Project-CoasterBot/coasterbot/README.md

# coasterbot

Diese Repository enthält Dateien des CoasterBot Projekts im Rahmen der Projektarbeit Master zum Start vom 15.07.2026.
