Project-CoasterBot/coasterbot/M5_Endbericht/se_algorithmik.tex

\subsubsection*{Ausgangslage und Leitlinien}

Zur Umsetzung der Algorithmik sind folgende Anforderungen aus dem Pflichtenheft als Leitlinien herangezogen:
\begin{itemize}[itemsep=2pt,topsep=3pt,parsep=0pt]
    \item \texttt{NAV-*} Anforderungen an eine zielgerichtete autonome Bewegung auf der Tischfläche.
    \item \texttt{SAF-*} Anforderungen an eine Sicherheitskomponente mit übergeordneter Priorität, u.\,a.\ Hindernis- und Tischkantenerkennung.
\end{itemize}

Als Hardware wurde bewusst ein einfacher Mikrocontroller (Raspberry Pi Pico~2) gewählt statt eines \gls{sbc} mit \gls{ros}: Der Mikrocontroller hat kein eigenes Betriebssystem und muss Navigation, Sensorverarbeitung und Kommunikation selbst in einer Firmware abbilden, ist günstiger und für das Projekt ausreichend. Die Navigation wurde zunächst in einer Physiksimulation (Webots) entworfen und gegen die Testfälle aus dem Testkonzept verifiziert, bevor sie auf die reale Hardware übertragen wurde. Entscheidend dafür ist die Hardwareabstraktionsschicht \texttt{RobotHAL} (siehe Abschnitt~\ref{lösungsweg-elektronik}): Navigations- und Sicherheitslogik kennen nur dieses Interface und laufen dadurch unverändert auf Simulation und Zielhardware.

\begin{figure}[H]
  \centering
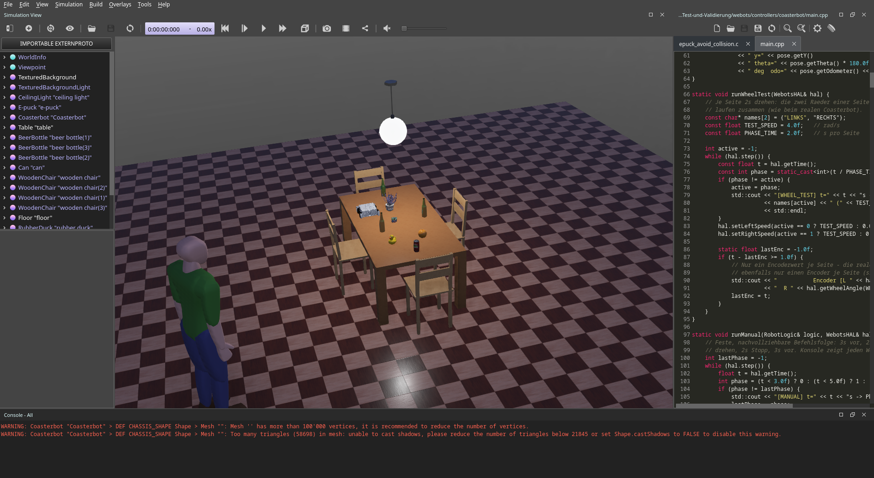
[picture p1: M5_Endbericht/webots.png]
  
  \caption{Webots-Simulationsumgebung des Coasterbot-Projekts.}
  \label{fig:endbericht-webots}
\end{figure}

\subsubsection*{Benchmarking und Auswahl der Verfahren}

Grundlage war eine systematische Literaturrecherche, deren Alternativen in einer Mindmap strukturiert und in der Alternativenbeschreibung anhand der Anforderungen bewertet wurden: begrenzte Tischfläche, Rechenleistung sowie die Anforderung, den Tisch nicht zu verlassen. Tabelle~\ref{tab:algorithmik-auswahl} fasst die Auswahl zusammen.

\begin{table}[H]
\centering
\footnotesize
\caption{Betrachtete Alternativen und gewählte Lösung der Navigationsalgorithmik.}
\label{tab:algorithmik-auswahl}
\begin{tabularx}{\textwidth}{@{}>{\raggedright\arraybackslash}p{2.6cm}>{\raggedright\arraybackslash}p{3.1cm}>{\raggedright\arraybackslash}p{2.3cm}X@{}}
\toprule
\textbf{Funktion} & \textbf{Alternativen} & \textbf{Gewählt} & \textbf{Begründung}\\
\midrule
Globale Pfadplanung & Dijkstra, Breitensuche & A* &
Heuristik lenkt die Suche zielgerichtet, bleibt auf dem Gitter dennoch optimal.\\
\midrule
Lokale Kollisionsvermeidung & Potentialfelder, adaptive/neuronale \acrshort{dwa} & Dynamic Window Approach &
Bezieht Bewegungsdynamik ein, vermeidet lokale Minima der Potentialfeldmethode.\\
\midrule
Dynamische Neuplanung & D*, LPA* & D* Lite &
Etabliertes, inkrementelles Verfahren für nachträglich entdeckte Hindernisse.\\
\midrule
Lokalisierung & \acrshort{imu}/\acrshort{ins} allein, voller \acrshort{ekf}/\acrshort{ukf}, \acrshort{slam} & Radodometrie + Gyro, Komplementärfilter &
Für die bekannte, flache Tischfläche ausreichend, \acrshort{slam} nicht erforderlich.\\
\midrule
Manipulations\-planung & Inverse Kinematik + \acrshort{rrt} & nicht umgesetzt &
Laut Abgrenzung nicht Teil der Simulationssoftware in M4.\\
\bottomrule
\end{tabularx}
\end{table}

\subsubsection*{Von der Recherche zur Simulation}

Die gewählten Verfahren wurden als eigenständige C++-Module umgesetzt, die ausschließlich über \texttt{RobotHAL} auf die Hardware zugreifen:
\begin{itemize}[itemsep=2pt,topsep=3pt,parsep=0pt]
    \item \texttt{OccupancyGrid} bildet die Tischfläche als Gitterkarte mit Distanzfeld ab. Bekannte Hindernisse werden direkt eingetragen, live erkannte erst nach mehreren konsistenten Messungen.
    \item \texttt{astarPlan} liefert darauf einen geglätteten Pfad, \texttt{DStarLite} plant ihn inkrementell um, sobald der Ultraschallsensor ein unkartiertes Hindernis entdeckt.
    \item \texttt{DwaPlanner} bestimmt daraus jeden Regelzyklus das Geschwindigkeitspaar beider Seiten.
    \item \texttt{PoseEstimator} liefert die Lokalisierung über einen Komplementärfilter aus Radodometrie und Gyroskop, der dem Schlupf des Skid-Steer-Antriebs entgegenwirken kann.
    \item \texttt{SafetyMonitor} und \texttt{FaultMonitor} bilden die Sicherheitsebene. Der \texttt{SafetyMonitor} reagiert mit übergeordneter Priorität auf Tischkanten, der \texttt{FaultMonitor} zusätzlich auf Sensor- und Aktorausfälle.
\end{itemize}
Dedizierte Betriebsarten erlaubten es, jede Stufe einzeln und reproduzierbar zu prüfen, bevor sie Teil des Gesamtsystems wurde.

\subsubsection*{Anpassungen während der Umsetzung}

Mehrere Entscheidungen wurden durch die Ergebnisse der Simulation angepasst:
\begin{itemize}[itemsep=2pt,topsep=3pt,parsep=0pt]
    \item \textbf{Lokalisierung:} Der Sensorfusions-Ansatz (\acrshort{ekf}/\acrshort{ukf}) wurde zugunsten eines einfacheren Komplementärfilters zurückgestellt. Dieser ist für die bekannte Tischfläche genau genug, liefert aber keine Unsicherheitsschätzung der Pose.
    \item \textbf{Pfadverfolgung:} Da die Bewegungssteuerung dem kürzesten A*-Pfad nahe der Ecken des Tisches nicht zuverlässig folgen konnte, wurden zwei unterschiedlich stark gewichtete Gitter sowie eine Pfadglättung eingesetzt, die Wegpunkte von Ecken weiter zur Mitte verschiebt.
    \item \textbf{FaultMonitor:} Kam nachträglich hinzu und wertete durch eine anfangs zu eng gewählte Schwelle normales Sensorrauschen fälschlich als Ausfall, was korrigiert wurde. Beim Übertragen auf die reale Hardware wurde er nicht mit übernommen: Wiederholte Kanten-, Stillstands- oder Ausrichtungsfehler stoppen die Navigation seither direkt über die Ablaufsteuerung.
    \item \textbf{Manipulationsplanung und Ablaufsteuerung:} Die Manipulationsplanung blieb offen, da die gebaute Mechanik mit ihrem Freiheitsgrad keine Pfadplanung benötigt. Die missionsweite Ablaufsteuerung wurde dagegen umgesetzt und deckt auch die Aufnahme und Ausgabe der Getränkeuntersetzer ab.
\end{itemize}

In der simulierten Verifikation bestanden alle bearbeiteten Testfälle: Zielfehler rund \SI{5,8}{\centi\meter}, Hindernisabstand mindestens \SI{0,22}{\meter}, zuverlässige Tischkantenerkennung, byte-identische Wiederholläufe sowie Sensor-/Aktorfehlererkennung innerhalb von \SI{0,02}{\second} bzw.\ \SI{0,34}{\second}. \texttt{PoseEstimator}, \texttt{SafetyMonitor}, \texttt{OccupancyGrid} und \texttt{DStarLite} wurden auf den realen Pico~2 übertragen und sind Teil der Firmware des Coasterbots. \texttt{DwaPlanner} und \texttt{astarPlan} kamen dort nicht zum Einsatz, stattdessen fährt die reale Firmware jeden Wegpunkt direkt an. Die Kernfunktionen arbeiten wie entworfen, die reale Navigationsgenauigkeit liegt aber unter der simulierten, da sich Sensortoleranzen über die Fahrzeit aufsummieren.
