Project-CoasterBot/coasterbot/M5_Endbericht/db_mechanik.tex

\subsubsection*{Ausgangslage und Leitlinien}
Zur Umsetzung der Mechanik sind folgende Anforderungen aus dem Pflichtenheft als Leitlinien herangezogen:
\begin{itemize}
    \item \texttt{HW-ACT-005..007}  Anforderungen an das Getränkeuntersetzerhandling.
    \item \texttt{HW-MEC-001..005}  Anforderungen an die mechanische Konstruktion.
\end{itemize}

\subsubsection*{Benchmarking und Auswahl der Verfahren}
Zur Auswahl der Lösungmethoden wurden unterschiedlichen Lösungsoptionen recherchiert und mit Hilfe einer \textit{Alternativenbewertung} Gegenüberstellungen. 
An dieser Stelle sind die gewählten Lösungswege mit ihren Begründungen verkürzt vorgestellt.

\begin{table}[H]
\centering
\footnotesize
\caption{Betrachtete Alternativen und gewählte Lösung der Mechanik.}
\label{tab:mechanik-auswahl}
\begin{tabularx}{\textwidth}{@{}>{\raggedright\arraybackslash}p{2.6cm}>{\raggedright\arraybackslash}p{3.1cm}>{\raggedright\arraybackslash}p{2.3cm}X@{}}
\toprule
\textbf{Funktion} & \textbf{Alternativen} & \textbf{Gewählt} & \textbf{Begründung}\\
\midrule
Chassis - Material & Holz, Metall & Kunststoff (Polylactid) &
Kunststoff ist günstig und Polyactid lässt sich besonders einfach auf einem 3D-Drucker verarbeiten.\\
\midrule
Chassis - Form & Abgerundet & Rechteckig &
Durch die rechteckige Form sind nachträgliche Anpassungen einfach anzubringen und die Konstruktion einfacher.\\
\midrule
Chassis - Modularität & Zwischenebenen & Austauschbare Seitenwände &
Druck kann in einzelnen Teilen erfolgen und die Wände sind austauschbar (Es muss kein gesamtes neues Gehäuse hergestellt werden).\\
\midrule
Untersetzer ablegen & Roboter mit Greifer/Sauger & Ausschieber &
Weniger komplex und benötigt weniger Antriebe.\\
\midrule
Untersetzer aufnehmen & Roboter mit Greifer/Sauger, Manuelle Einlage & Magnetische Aufnahme &
Weniger komplex und benötigt weniger Antriebe.\\
\bottomrule
\end{tabularx}
\end{table}

\subsubsection*{Anpassungen während der Umsetzung}
Während der Testphase haben sich einige Anpassungbedarfe an der Mechanik ergeben. So musste ein Encoder nachgerüstet werden.
Zur Befestigung der Lichtschranke des Encoders war ein neuer Motorhalter notwendig. Weiterhin hat sich herausgestellt,
dass die Mechanik zur Aufnahme und Ausgabe der Untersetzer nicht zuverlässig funktioniert. Durch die Entfernung der
Führungselemente und einer breiteren Auflagefläche des Ausschiebers konnte die Zuverlässigkeit verbessert werden.
