Project-CoasterBot/coasterbot/M5_Endbericht/db_projektziel.tex

Um in der Gastronomie Mitarbeiter zu entlasten und den Gästen ein besonderes Zahlerlebnis zu bieten, möchte die fiktive Firma
„Pay With Fun GmbH`` einen Coasterbot auf den Markt bringen. Neben einer Bezahlfunktion soll dieser Mobile Roboter, Tische reinigen,
Getränkeuntersetzer ausgeben und einsammeln können.
Zur Ausarbeitung eines Prototypens wird das fiktive Ingenieurbüro „B·E·Sondere Lösung UG`` engagiert, welches durch Gereon Such, Stefan Etringer und Dennis Borutta vertreten wird.
Die zu liefernden Grundfunktionen für den Prototypen umfassen folgendes:
\begin{itemize}
    \item Navigation auf einer Tischoberfläche
    \item Ausgabe, Lokalisierung und Aufnahme von Getränkeuntersetzer
\end{itemize}
Zur Umsetzung dieser Grundfunktionen können bestehende Konzepte zu mobilen Robotern verwendet werden.
Innerhalb des Projektes sind weitere Ausbaustufen auszuarbeiten und mit einem Testkonzept zu versehen.

Zu diesem Prototypen sind folgende Liefergegenstände bereitzustellen:
\begin{itemize}
    \item Eine Aufbauanleitung
    \item Eine Stückliste (\gls{bom})
    \item Die zur Fertigung notwendigen Modelle als stl-Dateien
    \item Ein Simulationsmodell zur Weiterentwicklung
    \item Der Sourcecode zum Prototypen
\end{itemize}
Mit dem Upload dieser Liefergegenstände über das \gls{dms} 
der \gls{wbh} gelten sie als ausgeliefert. 
Ein physischer Aufbau wird nicht separat geliefert werden. 

Nicht als Bestandteil des Projekts gelten:
\begin{itemize}
    \item Ein serienreifes Endprodukt
    \item Untersuchungen hinsichtlich \gls{emv}
    \item Intelligentes Schwarmverhalten
    \item Funktionen außerhalb der Grundfunktionen
    \item Konzeption einer Vermarktung des Produkts
\end{itemize}

Damit wird das Projekt als „PA2 - Machbarkeitsprojekt`` im Maßstab der \gls{wbh} geführt.
Der Projekstart erfolgte am 21.07.2026 und das Projektende ist am 07.11.2026 mit der Abgabe dieses Endbericht. 
Damit beträgt der angesetzte zeitliche Rahmen 3,5 Monate.
