Project-CoasterBot/coasterbot/M3_Produktentwicklung/Aufgabenliste/Aufgabenliste.md

# Einleitung

"Eine Aufgabenliste (auch: To-do-Liste, Liste offener Punkte, Action-Item-Liste) hält fest, welche Aufgaben im Projekt anstehen, bis wann sie erledigt sein müssen und wer sie verantwortet. Die Einträge ergeben sich in der Regel aus Besprechungsdokumenten, beispielsweise im Nachgang der Projekt-Jour-fixes; die Statusverfolgung geschieht meist ebenfalls im Rahmen der Besprechungen." (QUELLE) Damit verbindet die Aufgabenliste die Projektplanung mit der Ausführung. In diesem Dokument wird eine solche Aufgaben liste für die Teilaufgabe 'Konzeption ausarbeiten' ausgearbeitet.

# Aufgabenliste
Betrachtete Teilaufgabe: Konzeption ausarbeiten

Start: 15.08.2026

Ende: 04.09.2026

| Aufgabe | Verantwortliche Person | Termin | Status | Priorität | Abhängigkeiten | Arbeitspaket |
|---|---|---|---|---|---|---|
| Testfälle aus Lastenheft ableiten | Stefan Etringer | 20.08.2026 | Erledigt | Mittel | – | Testfälle definieren |
| Bewertungsmatrizen ausarbeiten | Stefan Etringer | 21.08.2026 | Erledigt | Hoch | Tesfälle abgeleitet | Testfälle definieren |
| Mögliche Sensorik aus Lastenheft ableiten und auswählen | Gereon Such | 18.08.2026 | Erledigt | Hoch | – | Sensorik/Aktorik auswählen |
| Mögliche Aktorik aus Lastenheft ableiten und auswählen | Gereon Such | 19.08.2026 | Erledigt | Hoch | – | Sensorik/Aktorik auswählen |
| Mögliche Energieversorgung und Steuerung ableiten und auswählen | Gereon Such | 20.08.2026 | Erledigt | Hoch | – | Sensorik/Aktorik auswählen |
| Elektronikbedarfe in Stückliste aufnehmen | Gereon Such | 21.08.2026 | Erledigt | Hoch | Elektronikbedarfe definiert | Sensorik/Aktorik auswählen |
| Mögliche Hardware aus Lastenheft ableiten und auswählen | Dennis Borutta | 18.08.2026 | Erledigt | Mittel | – | Sensorik/Aktorik auswählen |
| Modell des Prototypen ausarbeiten | Dennis Borutta | 20.08.2026 | Erledigt | Hoch | Hardwarelösung ausgewählt | Sensorik/Aktorik auswählen |
| Mechanikbedarfe in Stückliste aufnehmen | Dennis Borutta | 21.08.2026 | Erledigt | Hoch | Modell ausgearbeitet | Sensorik/Aktorik auswählen |
| Mögliche Softwarearchitektur aus Lastenheft ableiten | Stefan Etringer | 20.08.2026 | Erledigt | Mittel | Sensorik/Aktorik ist bekannt | Softwarearchitektur erarbeiten |
| Softwarearchitektur skizzieren | Stefan Etringer | 22.08.2026 | Erledigt | Hoch | Softwarearchitektur abgeleitet | Softwarearchitektur erarbeiten |
| Kosten zusammenstellen | Dennis Borutta | 22.08.2026 | Erledigt | Mittel | Stückliste abgeschlossen | Kostenkalkulation durchführen |
| Benefit schätzen | Gereon Such | 22.08.2026 | Erledigt | Mittel | Stückliste abgeschlossen | Kostenkalkulation durchführen |
| Wirtschaftlichkeit berechnen | Dennis Borutta | 23.08.2026 | Erledigt | Hoch | Stückliste abgeschlossen | Kostenkalkulation durchführen |
| Dokumente zusammenführen | Stefan Etringer | 26.08.2026 | Erledigt | Niedrig | – | Pflichtenheft erstellen |
| Pflichtenheft finalisieren | Stefan Etringer | 30.08.2026 | Erledigt | Hoch | Konzepte sind ausgearbeitet | Pflichtenheft erstellen |
| Dokumente ins DMS einpflegen | Stefan Etringer | 31.08.2026 | Erledigt | Hoch | Konzepte, BOM, Bewertungsmatrizen und Pflichtenheft sind ausgearbeitet | Pflichtenheft erstellen |
