Project-CoasterBot/coasterbot/M0/Unternehmensvorstellung/Unternehmensvorstellung.md

# Unternehmensvorstellung

Das Projektteam tritt als Ingenieurbüro unter dem Namen „B·E·Sondere Lösung UG“ auf. Unser Ingenieurbüro ist darauf spezialisiert, Prototypen und Kleinserien für Geräte und Maschinen im Konsumentenbereich zu entwickeln und umzusetzen.

Dabei begleiten wir unsere Kunden entlang des gesamten Entwicklungsprozesses – von der ersten Idee über Projektierung und Konzeption, Konstruktion und Prototypenbau bis hin zu Fertigung, Aufbau, Erprobung und Optimierung. So entsteht aus einer ersten Produktidee eine technisch ausgereifte und marktreife Lösung.

Sollte sich ein Produkt über die Kleinserie hinaus erfolgreich am Markt etablieren, unterstützen wir unsere Kunden auch bei der Überführung in größere Fertigungsstrukturen. Dabei beraten wir unter anderem beim Aufbau geeigneter Fertigungsstrecken und sorgen dafür, dass das bereits während der Entwicklung aufgebaute Know-how auch in der Serienproduktion genutzt werden kann.

B·E·Sondere Lösung steht somit für eine ganzheitliche Entwicklungsbegleitung – von der ersten Idee bis zur fertigungsgerechten Umsetzung. Wir sind an Ihrer Seite, um aus Ihrer Idee nicht nur eine gute, sondern eine B·E·Sondere Lösung zu machen.

# Auftrag Coasterbot

Der Auftrag zur Entwicklung eines Prototyps für einen Coasterbot kommt vom Kunden „Pay With Fun GmbH“. Bei dem Kunden handelt es sich um einen Zahlungsdienstleister, der mit kreativen Bezahlmethoden Marktanteile im Bereich der Zahlungsdienstleistungen gewinnen konnte. Um seinen Marktanteil weiter auszubauen, möchte er nun ein Gadget für Restaurants, Events und Bars auf den Markt bringen, welches neben einem besonderen Erlebnis bei der Bezahlung auch einen Mehrwert für Gastronomen bietet.

Hierdurch ist die Idee des Coasterbots entstanden. Der Coasterbot soll folgende Mehrwerte bieten:

- Getränkeuntersetzer ausgeben und aufnehmen
- Eine Tischoberfläche reinigen
- Einen Bezahlvorgang spielerisch gestalten
- Einen Bezahlvorgang beschleunigen

Die Aufgabe des Auftragnehmers „B·E·Sondere Lösung UG“ besteht bei diesem Auftrag darin, eine technische Lösung für diese Idee zu entwickeln. Definierte Ausbaustufen und Anforderungen sind in einem Lasten- und Pflichtenheft festgelegt. Vom Kunden wird im Rahmen dieses Projekts ein erster Prototyp mit minimalem Funktionsumfang gefordert.

## Finanzierung

Die „B·E·Sondere Lösung UG“ finanziert ihre Projekte über Kundenaufträge. Auf Grundlage der Kundenanforderungen wird zunächst eine Kosten- und Ressourcenplanung durchgeführt. Diese bildet die Grundlage für die Angebotserstellung und den anschließenden Vertragsabschluss.

Die Vergütung erfolgt projektbezogen und wird in mehreren Abschlagszahlungen entsprechend dem Projektfortschritt abgerechnet. Bei Projektstart wird eine erste Zahlung in Höhe von 25 % des vereinbarten Projektpreises fällig. Nach der erfolgreichen Erstellung und Abnahme des Umsetzungskonzepts wird eine weitere Zahlung in Höhe von 25 % fällig. Eine dritte Zahlung in Höhe von 25 % erfolgt nach Auslieferung des vereinbarten Projektergebnisses. Die verbleibenden 25 % werden nach der erfolgreichen Abnahme des Projektergebnisses durch den Kunden fällig.

Durch die Abrechnung nach definierten Projektmeilensteinen wird sichergestellt, dass die Finanzierung des Projekts mit dem erbrachten Leistungsstand fortschreitet und die „B·E·Sondere Lösung UG“ ihre bereits erbrachten Leistungen und entstandenen Aufwendungen laufend abrechnen kann.
