Project-CoasterBot/coasterbot/M6_Projekträsentation/Projektpräsentation_Coasterbot.odp

## Projektpräsentation

Coasterbot


KI generiertes Bild

## Slide 2

01 | Hinführung
02 | Projektziel
03 | Team & Rollen
04 | Zeit, Kosten und Ressourcen
05 | Arbeitsteilung
06 | Lösungsfindung: Mechanik
07 | Lösungsfindung: Algorithmik
08 | Lösungsfindung: Elektronik
09 | Projektergebnisse
10 | Ausblick

## Hinführung

## Kundenvision

Projektpräsentation - Hinführung

Fiktiver Zahlungsdienstleister

der Gastronomie

KI generiertes Bild

Quellen: [Deu26], [26b]

Autor: Dennis Borutta

## Kundenvision

Projektpräsentation - Hinführung

Belastung beim Personal

Fiktiver Zahlungsdienstleister

der Gastronomie

KI generiertes Bild

Sieht bei Kunden

Quellen: [Deu26], [26b]

Autor: Dennis Borutta

## Kundenvision

Projektpräsentation - Hinführung

Belastung beim Personal

Brauchen Attraktivitätsmerkmale

Fiktiver Zahlungsdienstleister

der Gastronomie

KI generiertes Bild

Sieht bei Kunden

Quellen: [Deu26], [26b]

Autor: Dennis Borutta

## Kundenvision

Projektpräsentation - Hinführung

Belastung beim Personal

Brauchen Attraktivitätsmerkmale

Online Präsenz beeinflusst Umsatz

Fiktiver Zahlungsdienstleister

der Gastronomie

KI generiertes Bild

Sieht bei Kunden

Quellen: [Deu26], [26b]

Autor: Dennis Borutta

## Kundenvision

Projektpräsentation - Hinführung

Belastung beim Personal

Brauchen Attraktivitätsmerkmale

Online Präsenz beeinflusst Umsatz

Fiktiver Zahlungsdienstleister

der Gastronomie

KI generiertes Bild

Sieht bei Kunden

Ein Produkt, dass

Einen Service bietet

Quellen: [Deu26], [26b]

Vision

Aufsehen erregt

Autor: Dennis Borutta

## Kundenvision

Projektpräsentation - Hinführung

Belastung beim Personal

Brauchen Attraktivitätsmerkmale

Online Präsenz beeinflusst Umsatz

Fiktiver Zahlungsdienstleister

der Gastronomie

KI generiertes Bild

Sieht bei Kunden

Ein Produkt, dass

Einen Service bietet

Quellen: [Deu26], [26b]

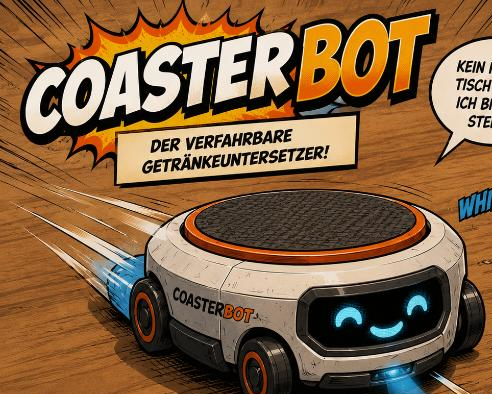
[picture p3: figure]

KI generiertes Bild

Autor: Dennis Borutta

Vision

- Navigiert auf einem Tisch
- Spendet Untersetzer
- Sammelt Untersetzer
- Reinigt den Tisch
- Bietet Zahloption/Enterntainment

Aufsehen erregt

## Projektziel

## Projektziel

Projektpräsentation - Projektziel

  Entwicklung eines Prototyps

als Maturity Level 1

- Automatisiertes Verteilen und Einsammeln von Getränkeuntersetzern
- Evaluierung: Systemarchitektur, Hardware- & Software-Komponenten, Tests
- Mechanik und Elektronik so ausgearbeitet, dass eine Fertigung möglich ist

Autor: Stefan Etringer

## Team & Rollen

## Teamvorstellung

Projektpräsentation - Team & Rollen

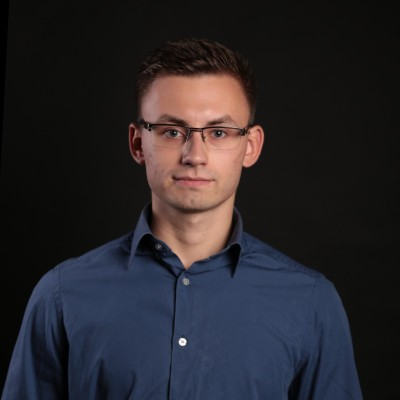
[picture p4: figure]

- Dennis Borutta
- -Projektleiter-
- Mechanik

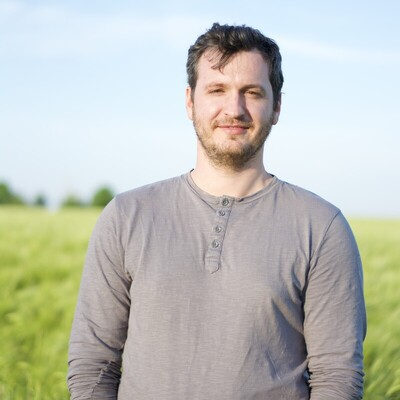
[picture p5: figure]

- Stefan Etringer
- -Projektadministrator-
- Algorithmik

Autor: Gereon Such

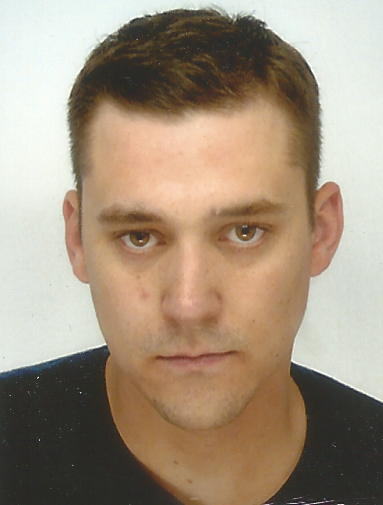
[picture p6: figure]

- Gereon Such
- Elektronik

## Zeit, Kosten und Ressourcen

## Zeitplan

Projektpräsentation - Zeit, Kosten und Ressourcen

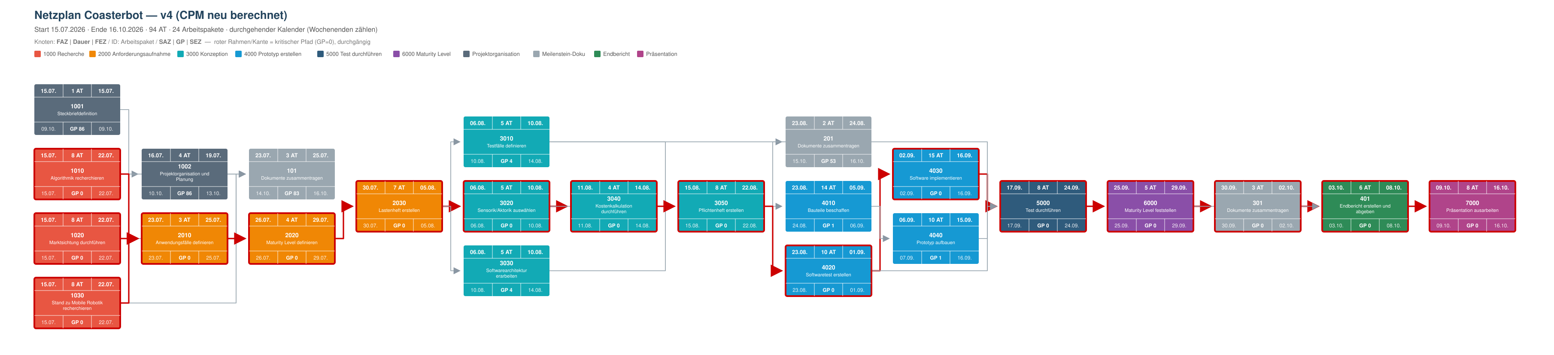
[picture p7: figure]

Quellen: M0 Dokument Coasterbot

Autor: Gereon Such

Notes: Gesamtprojektzeit 3 Monate Viele Schritte nicht parallelisierbar Projektzeit nach DIN 69900

## Zeitplan

- Anforderungsaufnahme
- Recherche
- Konzeption
- Prototyp
- Test
- Projektabschluss

Projektpräsentation - Zeit, Kosten und Ressourcen

- 8
- 14
- 17
- 25
- 8
- 22
- ∑ 94 Arbeitstage

Autor: Gereon Such

Quellen: M0 Dokument Coasterbot

Notes: Anforderungsaufnahme bis Pflichtenheft Konzeption bis Lastenheft In Summe 94 Arbeitstage auf dem kritischen Pfad

## Zeitplan

Projektpräsentation - Zeit, Kosten und Ressourcen

- ∑ 94 Arbeitstage

Autor: Gereon Such

Quellen: M5 Endbericht Coasterbot

Notes: Meisten Grenzen gehalten Prototyp Erstellung deutlich verzögert, aber kompensiert.

## Kostenplan

Projektpräsentation - Zeit, Kosten und Ressourcen

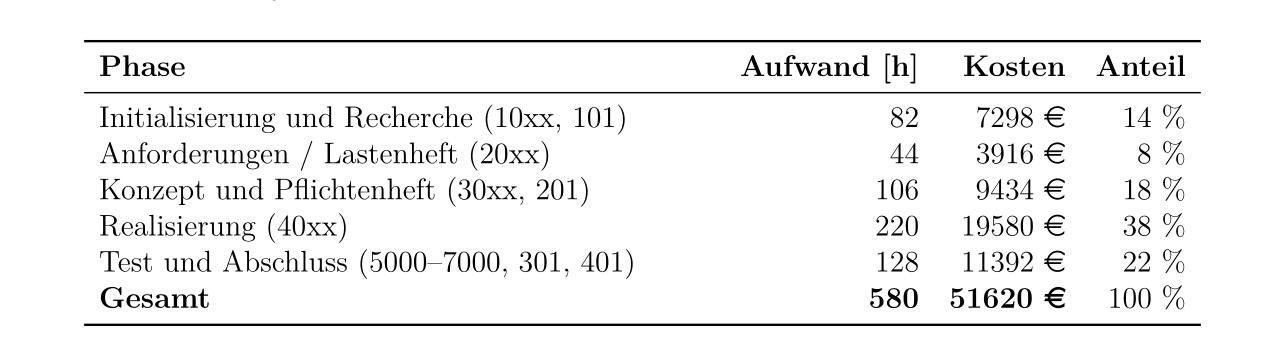
[picture p8: figure]
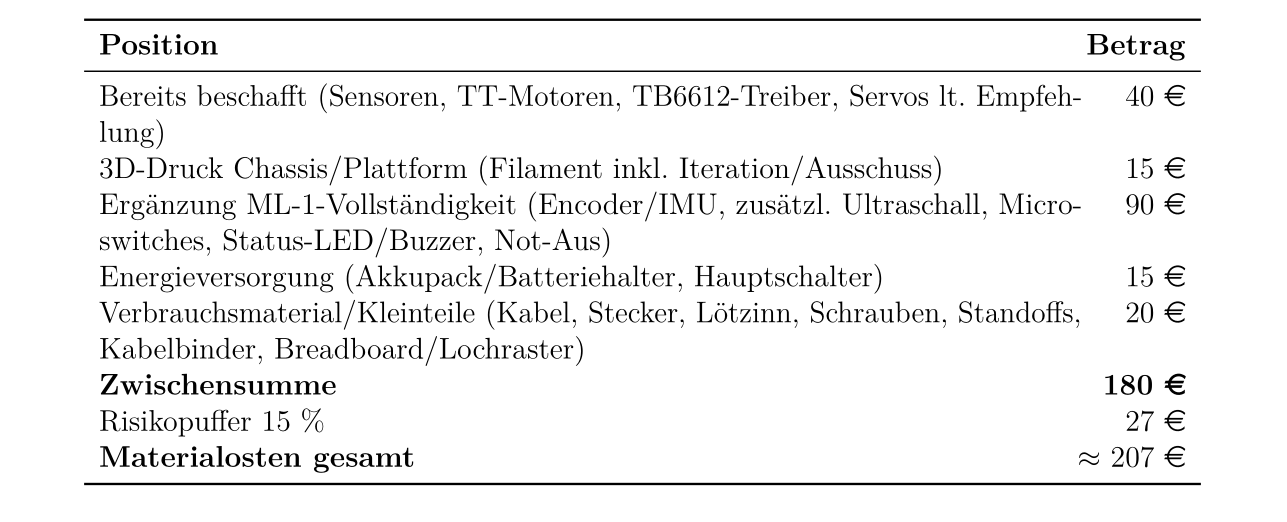
[picture p9: figure]

- ∑ 52827 €

Quellen: M0 Kostenplan Coasterbot

Autor: Gereon Such

Notes: In Phase M0 detailliert erstellt Mit Stundensatz von 89€ + 10.6% Wagnis = 100€ pro Stunde kalkuliert Es ergeben sich Gesamtkosten von 52827€ Software wird OpenSource verwendet, Werkzeuge werden als gegeben gesetzt und Verschleiss o.ä. nicht berechnet

## Kostenplan

Projektpräsentation - Zeit, Kosten und Ressourcen

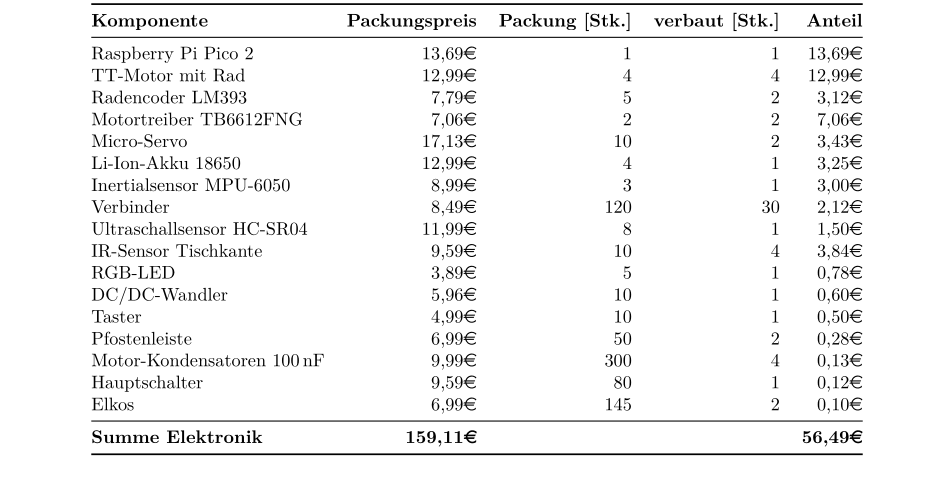
[picture p10: figure]

- Zuzüglich Filament ~15 € → 71.49 € pro Prototyp
- Statt angenommener 207 €

Quellen: M5 Endbericht Coasterbot

Autor: Gereon Such

Notes: Prototyp deutlich günstiger, vor allem durch größere Mengen und günstige Komponentenauswahl.

## Arbeitsteilung

## Gewerke

Projektpräsentation - Arbeitsteilung

Mechanik Chassis als 3D Druck Ausschiebe-mechanismus der Untersetzer Nachrüstung eines Encoder-Halters | Elektronik und Hardwareabstraktion Komponentenauswahl Aktorik und Sensorik Lochrasterplatine Hardwareabstraktions-schicht Implementierung Nachrüsten des Radencoders | Navigationsalgorith-mik und Simulation Prototyping des Nav-Stacks Lokalisierung über Komplementärfilter Verifikation in Simulation

Autor: Stefan Etringer

## Lösungsfindung: Mechanik

## Explorative Methode

Projektpräsentation - Lösungsfindung: Mechanik

Aufsetzen einer Mind-Map mit gestellten Anforderungen

Untersetzer

aufnehmen

Modularität

durch

Mechanik

Chassis

Form

Untersetzer

ablegen

Material

Autor: Dennis Borutta

## Explorative Methode

Projektpräsentation - Lösungsfindung: Mechanik

Listen von Lösungsoptionen

Roboter mit Sauger

Austauschbare

Seitenwände zur

Komponentenbefestigung

Roboter mit Greifer

Manuelle Einlage

Untersetzer

aufnehmen

Modularität

durch

Zwischenebenen zur

Komponentenbefestigung

Zusätzliche

Magnetischer

Heber mit

magnetischen

Untersetzer

Mechanik

Chassis

Form

Quaderförmig

Zylindrisch

Untersetzer

ausschieben

Harz

Roboter mit Sauger

Untersetzer

ablegen

Material

Metall

Roboter mit Greifer

Kunststoff

Holz

Quellen: [LP17]

Autor: Dennis Borutta

## Explorative Methode

Projektpräsentation - Lösungsfindung: Mechanik

Auswahl der am besten geeigneten

Roboter mit Sauger

Austauschbare

Seitenwände zur

Komponentenbefestigung

Roboter mit Greifer

Manuelle Einlage

Untersetzer

aufnehmen

Modularität

durch

Zwischenebenen zur

Komponentenbefestigung

Zusätzliche

Magnetischer

Heber mit

magnetischen

Untersetzer

Mechanik

Chassis

Form

Quaderförmig

Zylindrisch

Untersetzer

ausschieben

Harz

Roboter mit Sauger

Untersetzer

ablegen

Material

Metall

Roboter mit Greifer

Kunststoff

Holz

Quellen: [LP17]

Autor: Dennis Borutta

## Coaster Mechanismus

Projektpräsentation - Lösungsfindung: Mechanik

Autor: Dennis Borutta

Quellen: [LP17]

## Coaster Mechanismus

Projektpräsentation - Lösungsfindung: Mechanik

Autor: Dennis Borutta

Schubkurbeltrieb

Stempel mit eingelassenen

Magneten

Quellen: [LP17]

## Coaster Mechanismus

Projektpräsentation - Lösungsfindung: Mechanik

Autor: Dennis Borutta

Schubkurbeltrieb

Führungsstücke

Stempel mit eingelassenen

Magneten

Quellen: [LP17]

## Coaster Mechanismus

Projektpräsentation - Lösungsfindung: Mechanik

Autor: Dennis Borutta

Schubkurbeltrieb

Führungsstücke

Stempel mit eingelassenen

Magneten

Untersetzer mit eingelassenen Magneten

Quellen: [LP17]

## Coaster Mechanismus

Projektpräsentation - Lösungsfindung: Mechanik

Autor: Dennis Borutta

Schubkurbeltrieb

Führungsstücke

Stempel mit eingelassenen

Magneten

Untersetzer mit eingelassenen Magneten

Auflage mit Ausschieber

Quellen: [LP17]

## Prototyp

Projektpräsentation - Lösungsfindung: Mechanik

Autor: Dennis Borutta

Maße:

233mm x 213mm x 94mm

## Prototyp

Projektpräsentation - Lösungsfindung: Mechanik

Autor: Dennis Borutta

Deckel

Austauschbare Wände

Austauschbare Wände

Maße:

233mm x 213mm x 94mm

Grundplatte

## Prototyp

Projektpräsentation - Lösungsfindung: Mechanik

Autor: Dennis Borutta

Deckel

Austauschbare Wände

Coaster Mechanismus

Maße:

233mm x 213mm x 94mm

Grundplatte

## Prototyp

Projektpräsentation - Lösungsfindung: Mechanik

Autor: Dennis Borutta

Deckel

Austauschbare Wände

Motorhalter

Halter zur Kantenerkennung

Halter für Hinderniserkennung

Grundplatte

Coaster Mechanismus

Maße:

233mm x 213mm x 94mm

## Lösungsfindung: Algorithmik

## Gewerke -- Algorithmik

Projektpräsentation - Lösungsfindung: Algorithmik

Lokalisierung

Manipulationsplanung

Globale Pfadplanung

Lokale Kollisionsvermeidung

Dynamische Neuplanung

Autor: Stefan Etringer

## Gewerke -- Algorithmik

Projektpräsentation - Lösungsfindung: Algorithmik

Autor: Stefan Etringer

## Gewerke -- Algorithmik

Projektpräsentation - Lösungsfindung: Algorithmik

Globale Pfadplanung | A* (A-Star) | Heuristik lenkt die Suche zielgerichtet, optimales Gitter über Wegpunkte
Lokale Kollisionsvermeidung | Dynamic Window Approach | Bewegungsdynamik einbezogen, vermeidet lokale Minima der Potentialfeldmethode
Dynamische Neuplanung | D* Lite (D-Star Lite) | Inkrementelles Verfahren für nachträglich entdeckte Hindernisse
Lokalisierung | Radodometrie + Gyroskop als Komplementrärfilter | Ausreichend für die Tischfläche, Simultaneous Localization and Mapping (SLAM) nicht notwendig
Manipulationsplanung | Inverse Kinematik (IK), Rapidly-exploring Random Tree* (RRT-Star) | Bewegungsplanung: Gelenkstellung, Greifposition, präzise Ablage

Autor: Stefan Etringer

## Lösungsfindung: Elektronik

## Elektronik

Projektpräsentation - Lösungsfindung: Elektronik

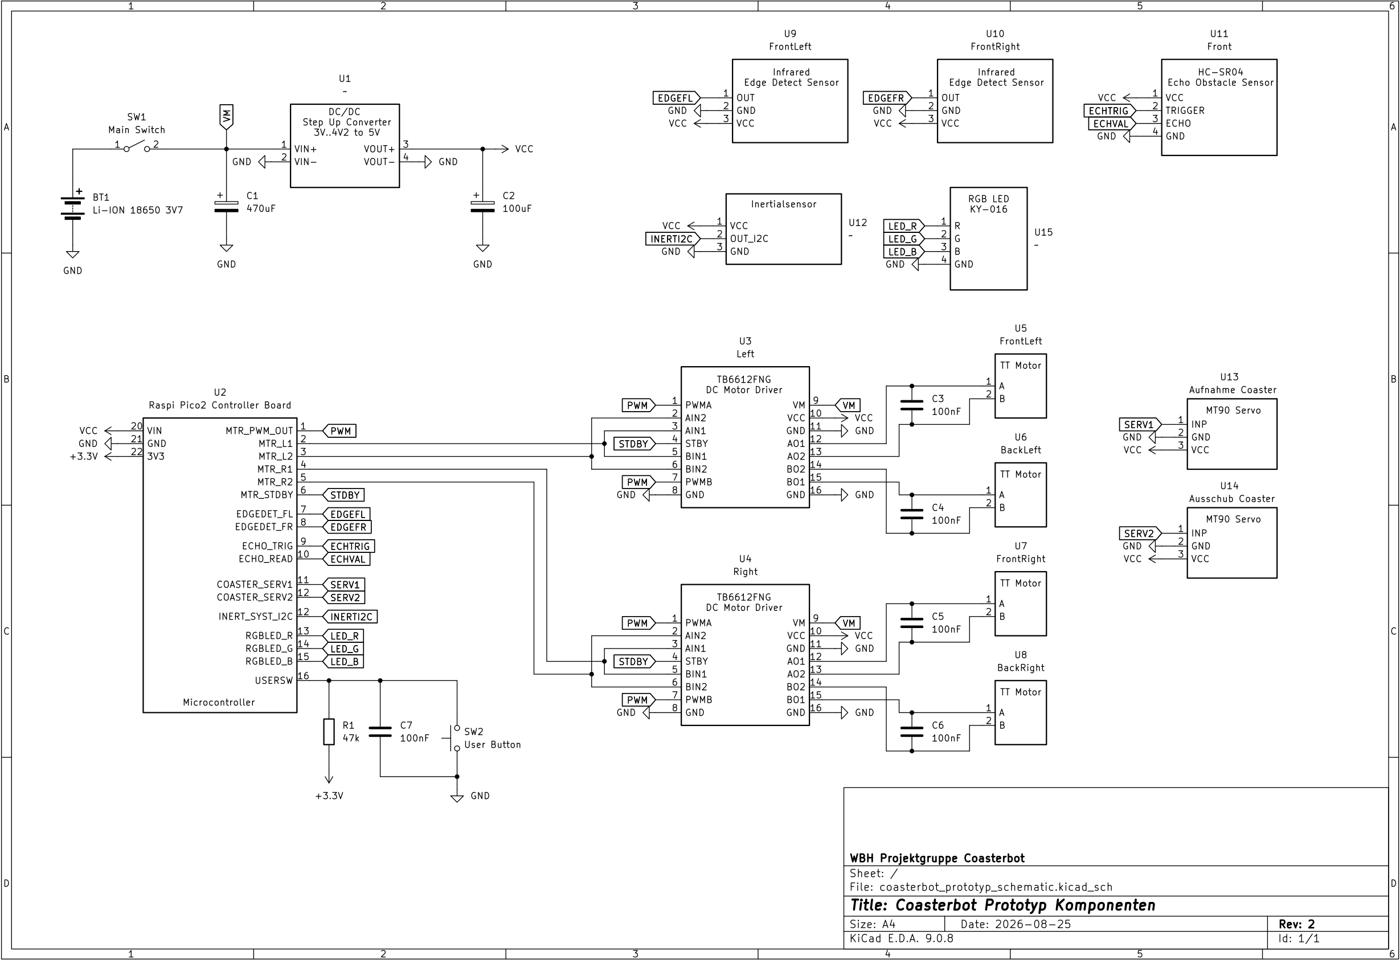
[picture p11: figure]

Autor: Gereon Such

Quellen: M4 Aufbauanleitung

Notes: Schematic für ausgewählte Komponenten mittels KiCAD erstellt.

## Elektronik

Projektpräsentation - Lösungsfindung: Elektronik

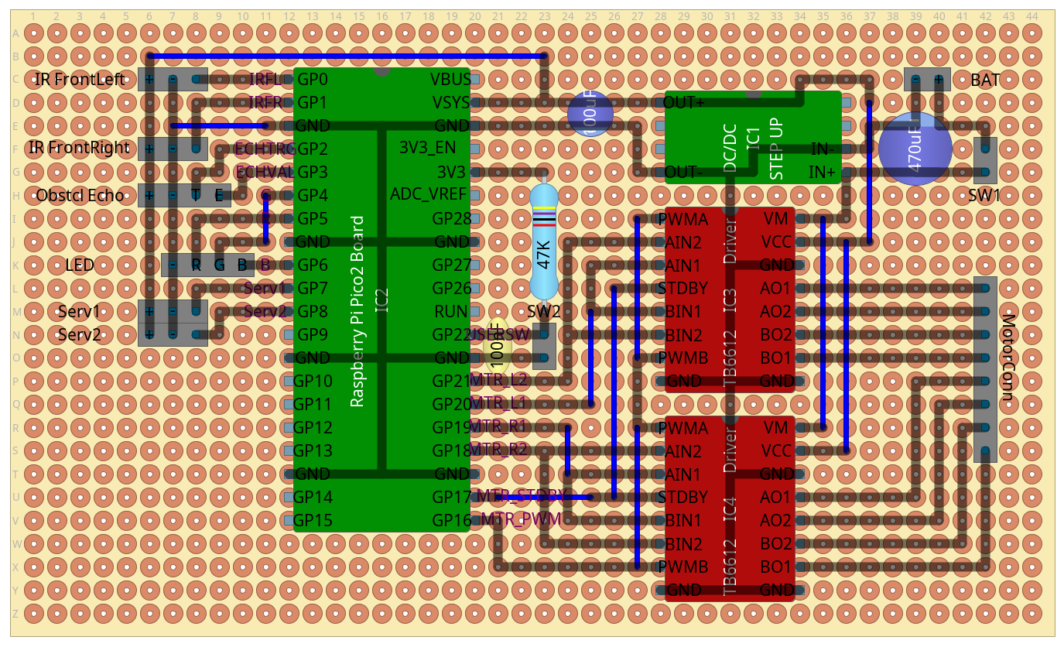
[picture p12: figure]

Quellen: M4 Aufbauanleitung

Autor: Gereon Such

Notes: Umgesetzt auf ein Breadboard

## Elektronik

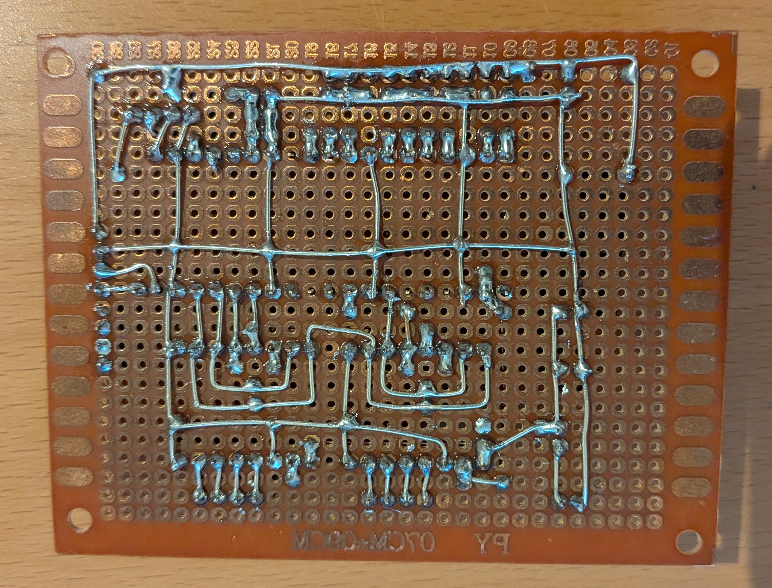
[picture p13: figure]

Projektpräsentation - Lösungsfindung: Elektronik

Quellen: M4 Aufbauanleitung

Autor: Gereon Such

Notes: Layout äquivalent auf Lochrasterplatine übernommen Unterseite hier Spiegelverkehrt dargestellt

## Elektronik

- Raspi Pico2 Microcontroller

Projektpräsentation - Lösungsfindung: Elektronik

Quellen: M4 Aufbauanleitung

Autor: Gereon Such

## Elektronik

- DC/DC Spannungswandler
- 3.7V → 5V

Projektpräsentation - Lösungsfindung: Elektronik

Quellen: M4 Aufbauanleitung

Autor: Gereon Such

## Elektronik

- RGB LED Modul

Projektpräsentation - Lösungsfindung: Elektronik

Quellen: M4 Aufbauanleitung

Autor: Gereon Such

## Elektronik

- MPU-6050
- Gyroskop

Projektpräsentation - Lösungsfindung: Elektronik

Quellen: M4 Aufbauanleitung

Autor: Gereon Such

## Elektronik

- Motorsteuerung
- 2x TB6612FNG

Projektpräsentation - Lösungsfindung: Elektronik

Quellen: M4 Aufbauanleitung

Autor: Gereon Such

## Elektronik

Projektpräsentation - Lösungsfindung: Elektronik

Autor: Gereon Such

Notes: umgesetzt auf der Platform

## Elektronik

Projektpräsentation - Lösungsfindung: Elektronik

Autor: Gereon Such

- 4x Antrieb
- TT-Motor(innen)

## Elektronik

Projektpräsentation - Lösungsfindung: Elektronik

Autor: Gereon Such

- 4x IR Sensor
- Tischkantenerkennung

## Elektronik

Projektpräsentation - Lösungsfindung: Elektronik

Autor: Gereon Such

- 1x Ultraschall
- Kollisionsvermeidung

## Elektronik

Projektpräsentation - Lösungsfindung: Elektronik

Autor: Gereon Such

- 1x Akku
- 3.7V Li-ION

Notes: Li-Ion kann die hohen Motorströme liefern

## Elektronik

Projektpräsentation - Lösungsfindung: Elektronik

Autor: Gereon Such

- 1x Ein/Aus
- Schalter

## Elektronik

Projektpräsentation - Lösungsfindung: Elektronik

Autor: Gereon Such

- 1x Funktionstaster

## Elektronik – Nachrüstung

Projektpräsentation - Lösungsfindung: Elektronik

Autor: Gereon Such

Notes: Tests zeigten, dass Aufintegrieren von Gyroskopwerten zu fehleranfällig ist. Also Odometrie nachrüsten → Modifikation des Motorhalters

## Elektronik – Nachrüstung

Projektpräsentation - Lösungsfindung: Elektronik

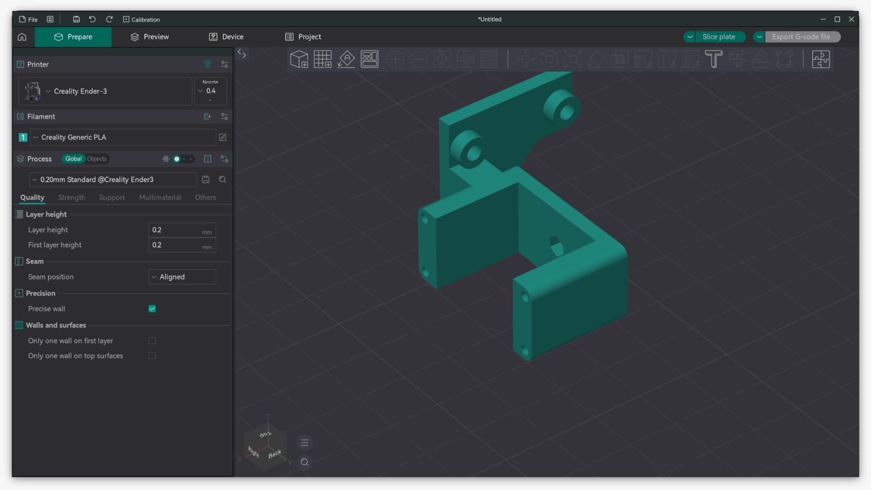
[picture p14: figure]

Autor: Gereon Such

Notes: CAD Design des Halters für Gabellichtschranke, hier Slicer

## Elektronik – Nachrüstung

Projektpräsentation - Lösungsfindung: Elektronik

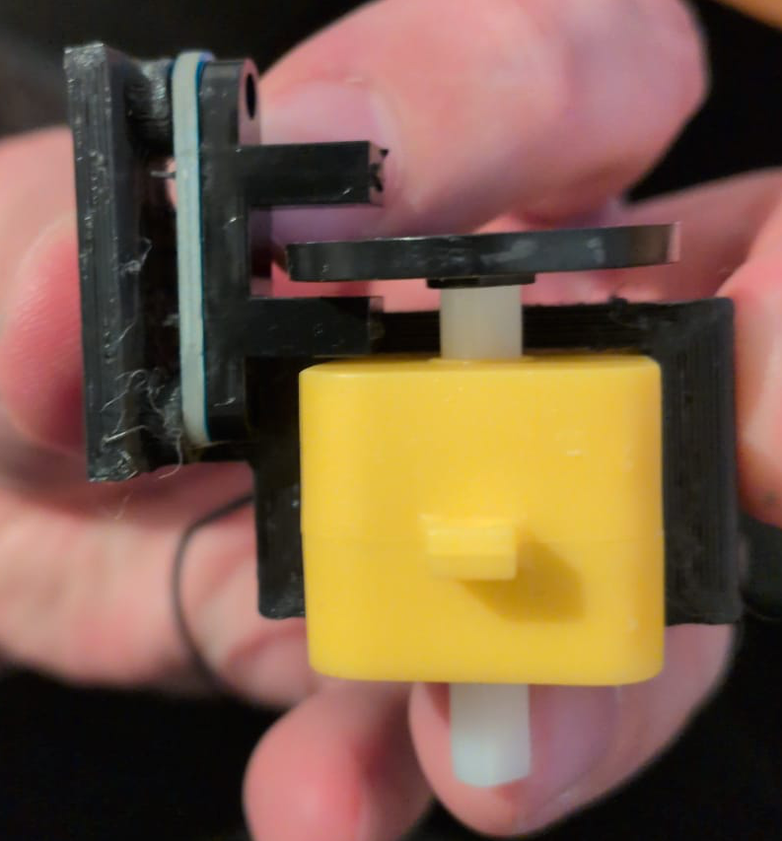
[picture p15: figure]

Autor: Gereon Such

Notes: 3D Druck

## Elektronik – Nachrüstung

Projektpräsentation - Lösungsfindung: Elektronik

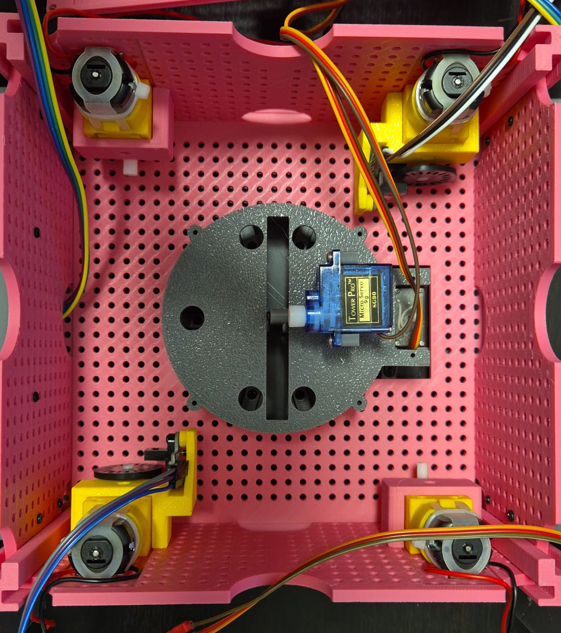
[picture p16: figure]

Autor: Gereon Such

Notes: Montage an zwei Motoren, je auf einer Seite

## Projektergebnisse

## Ergebnis – Simulation in Webots

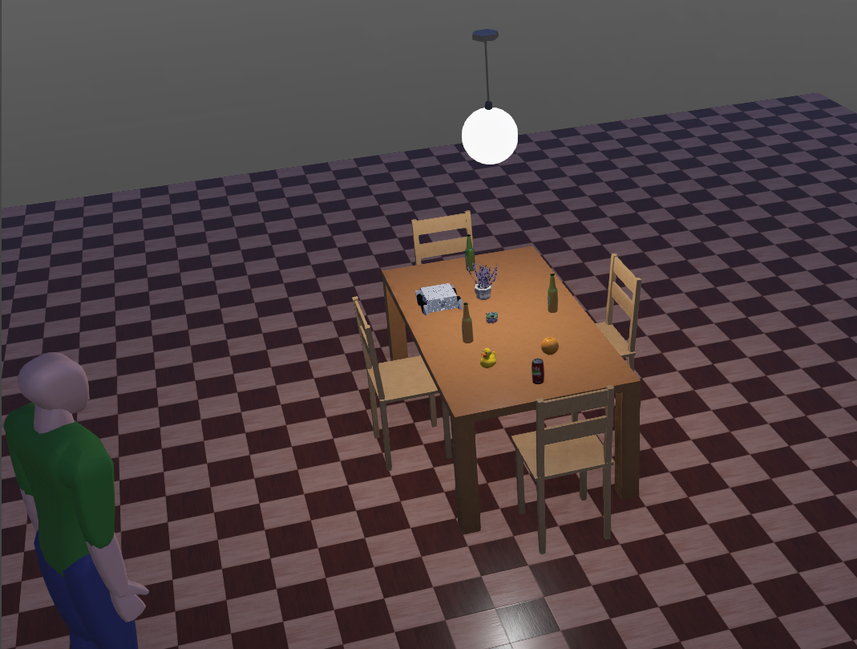
[picture p17: figure]

Autor: Stefan Etringer

## Ergebnis -- Simulation

Projektpräsentation - Projektergebnisse

  Webots: open-source robot simulator
  Entwicklungsumgebung zur Modellierung, Programmierung und Simulation von Robotern
- Vorgefertigte Modelle für Sensorik & Aktorik
- Physiksimulation
- Programmierbar (C/C++/Python)

Quellen: [Cyber01]

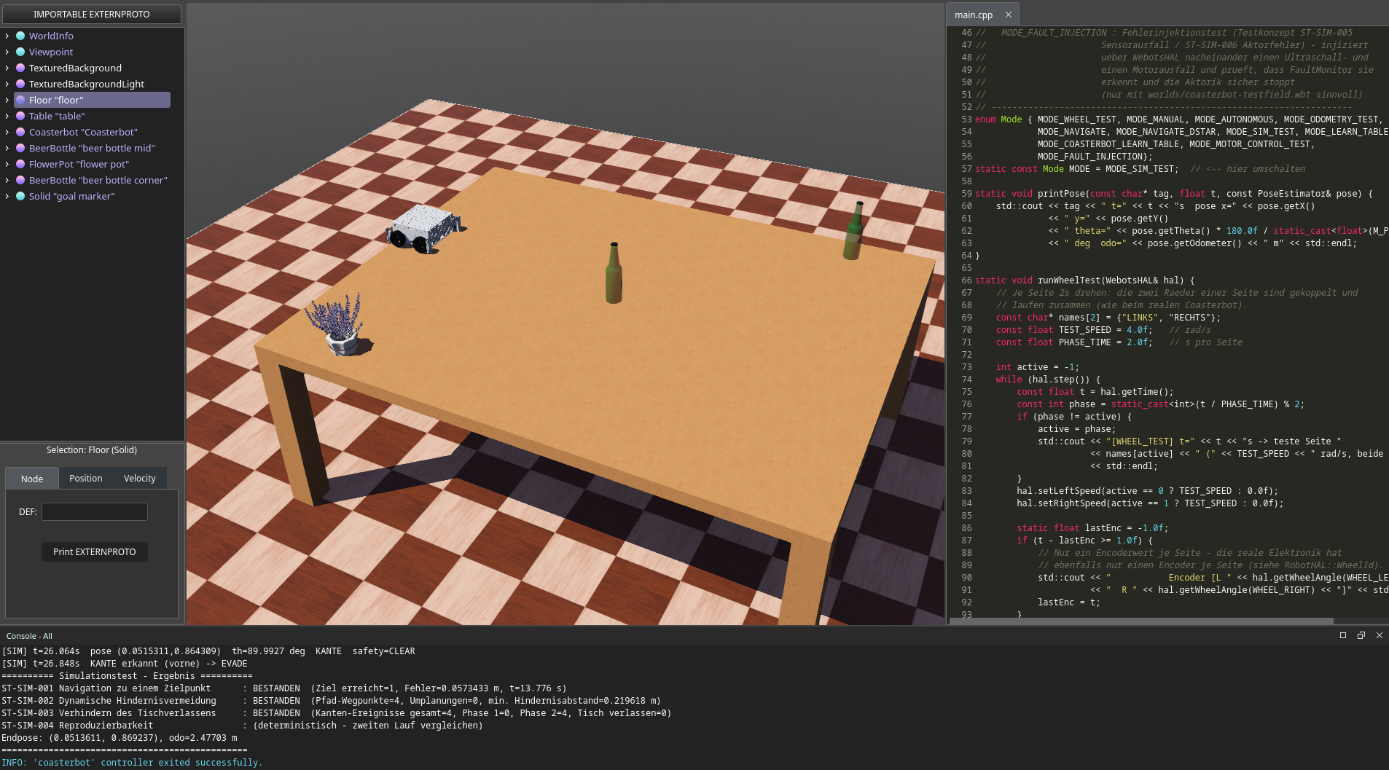
[picture p18: figure]
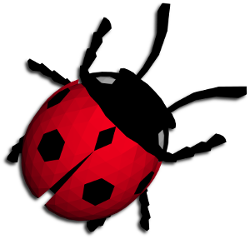
[picture p19: figure]

Autor: Stefan Etringer

## Ergebnis -- Simulation

Projektpräsentation - Projektergebnisse

  Testlauf der Algorithmen zur Navigation und des FAULTMONITORS erfolgreich abgeschlossen

✅ ST-SIM-001: Navigation zum Zielpunkt
✅ ST-SIM-002: Dynamische Hindernisvermeidung
✅ ST-SIM-003: Verhindern des Verlassens der Tischfläche
✅ ST-SIM-004: Wiederholbarkeit identischer Bewegungsabläufe
✅ ST-SIM-005: Reaktion auf fehlerhafte Sensordaten
✅ ST-SIM-006: Verhalten bei fehlerhafter Motorsteuerung

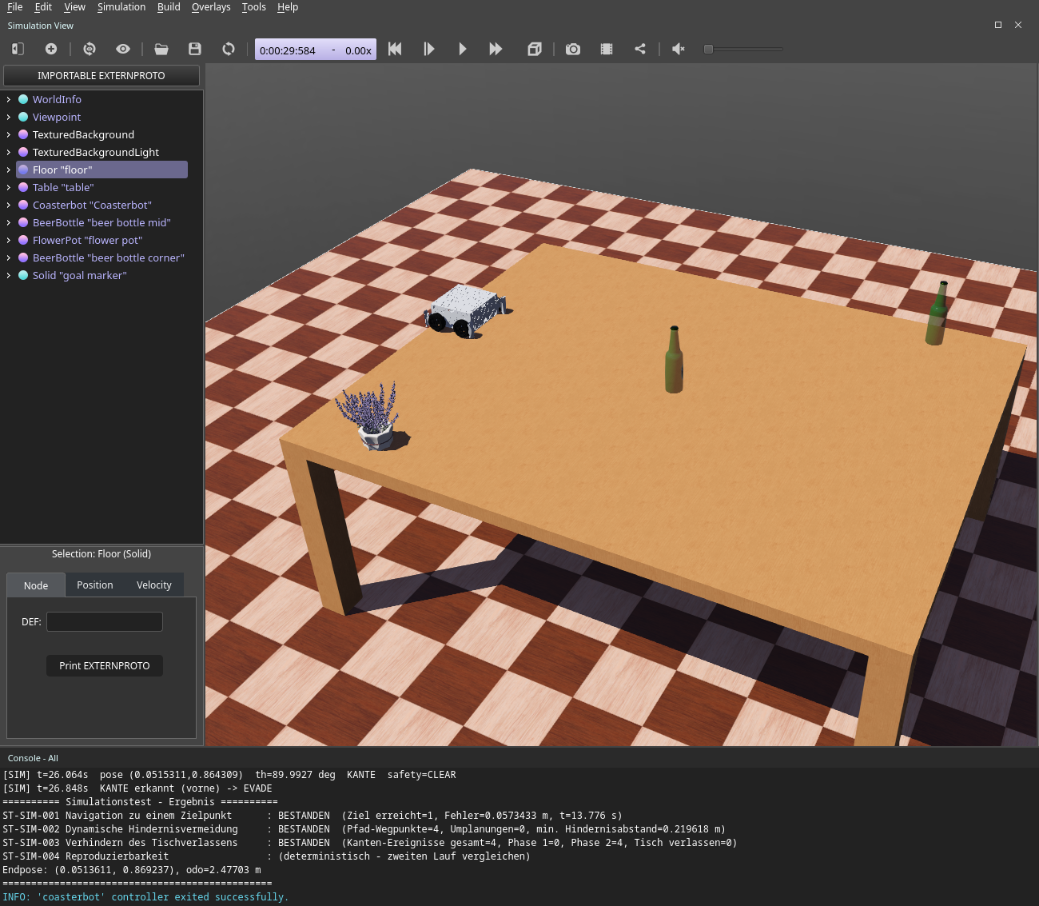
[picture p20: figure]

Autor: Stefan Etringer

## Ergebnis -- Simulation

Projektpräsentation - Projektergebnisse

  Untersetzerhandling nicht Teil der Simulationssoftware:
- ❌ ST-SIM-007 Aufnahme und Platzierung eines Untersetzers
- Nicht durchgeführt durch Zeitmangel: ❌ ST-SIM-008 Vergleich Simulation und Systemverhalten

Autor: Stefan Etringer

## Ergebnis -- Simulation

Projektpräsentation - Projektergebnisse

- Video ab, bitte!

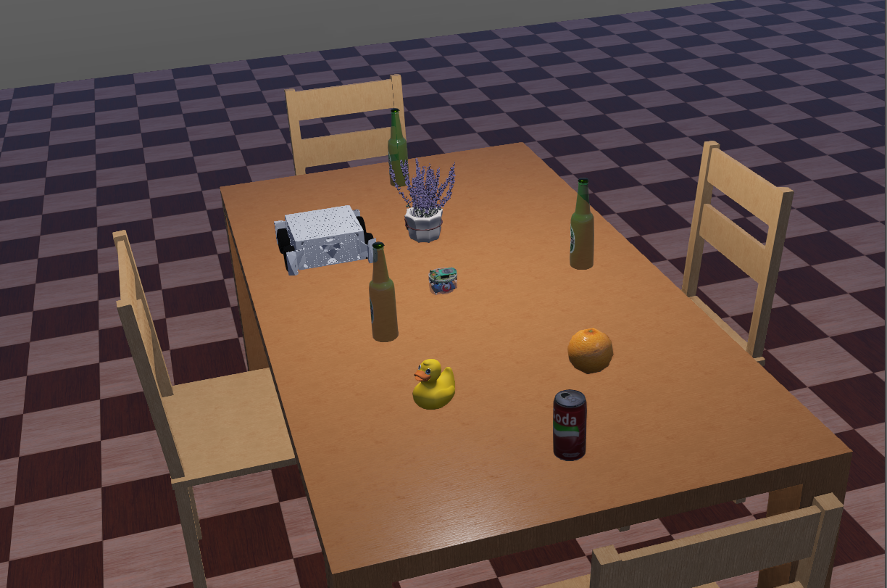
[picture p21: figure]

Autor: Stefan Etringer

## Bewertung des Ergebnisses

Projektpräsentation - Projektergebnisse

- Funktionsfähige Simulation mit Tests und vollständigem Missionsablauf
- Noch kein vollständiger Missionsablauf in der Realität, da:
  - Navigation zu ungenau, um Coaster wiederzufinden
  - Coaster nicht genau genug positioniert werden
- Nacharbeiten an Motorhalter und Coaster Mechanismus nach ersten Tests
- Funktionsfähiger Prototyp (Atomare Funktionen nachweisbar)

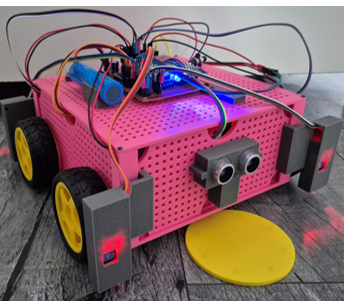
[picture p22: figure]

Autor: Dennis Borutta

## Retrospektive

Projektpräsentation - Projektergebnisse

- Fachlich breit aufgestelltes und motiviertes Projektteam
- Frühzeitigere Skizzierung der Architektur wäre hilfreich gewesen
- Trotz Remotearbeit hat jeder Projektteilnehmer nun einen Coasterbot

Autor: Dennis Borutta

## Ausblick

## V2

Projektpräsentation - Ausblick

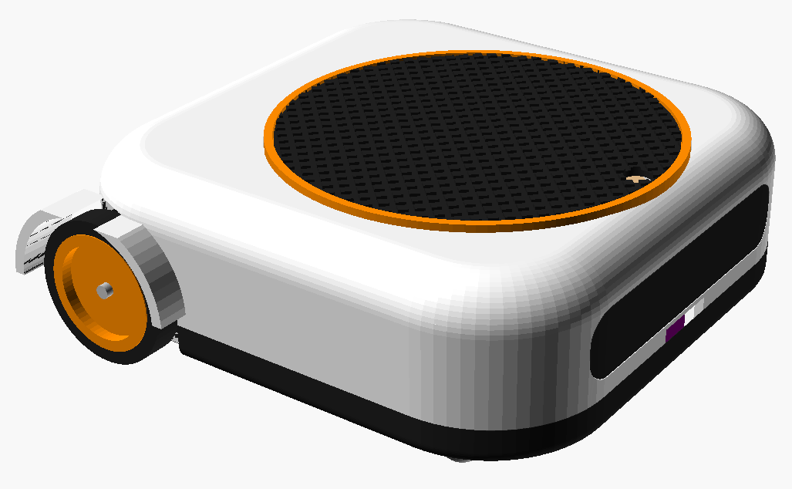
[picture p23: figure]
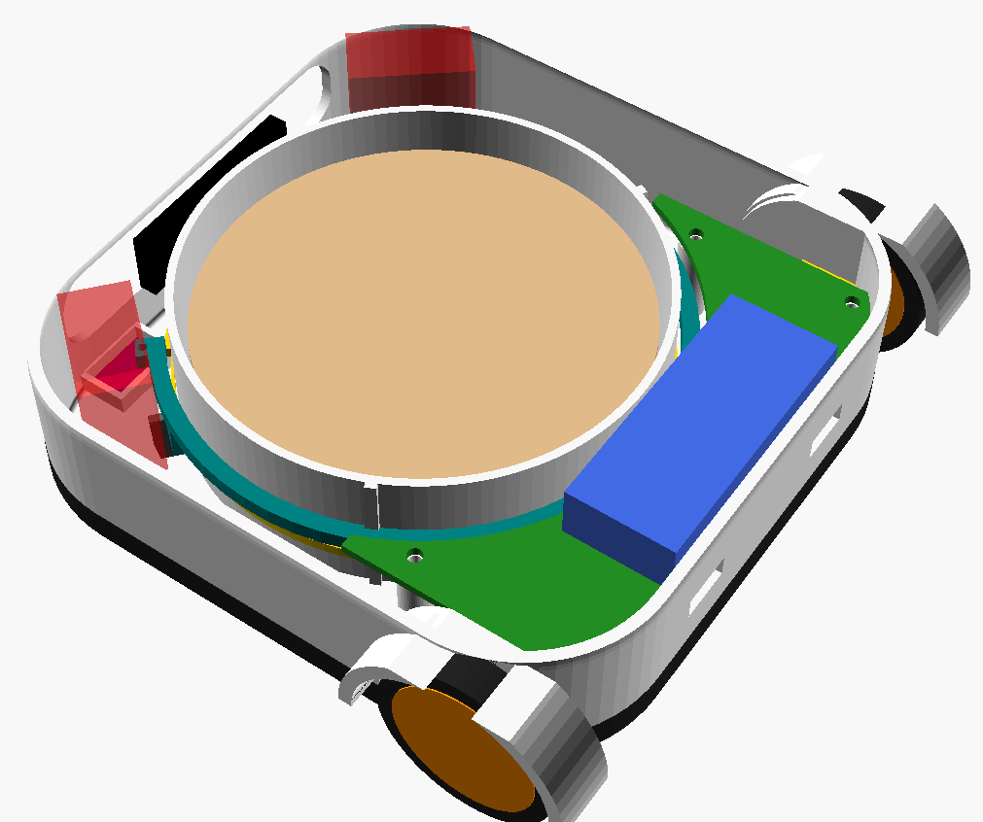
[picture p24: figure]

Autor: Gereon Such

Notes: Entwurf einer V2. Open SCAD ist ein Textformat → Kann Claude Code das? Ja, es kann!

## V2.3 Buildpipeline

Projektpräsentation - Ausblick

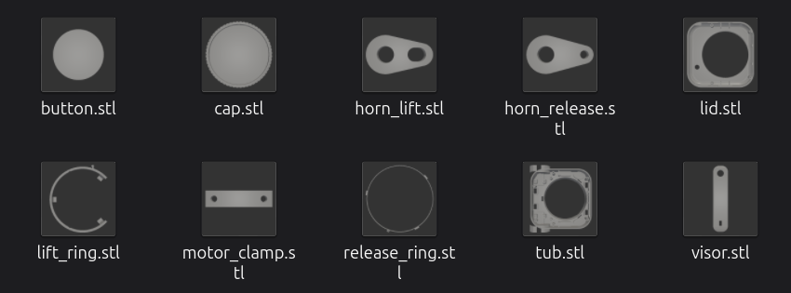
[picture p25: figure]

Autor: Gereon Such

Notes: Direkt eine Build Pipeline gebaut, die bei SCAD Änderungen diese rendert und STL aus den Komponenten baut → direkt 3D drucken?

## V2 - Frontblende

Projektpräsentation - Ausblick

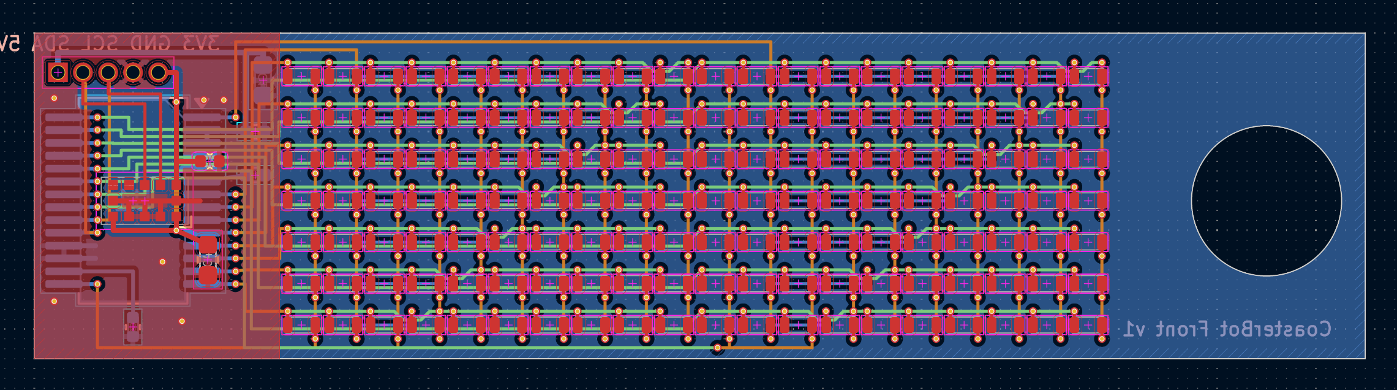
[picture p26: figure]

Autor: Gereon Such

Notes: KiCAD ist ein XML Format… Kann Claude das auch? Ja, es kann. Zwar keine Mounting Holes und Bauteile haben sicherlich zu wenig Clearance, aber eine 95% Lösung ist es allemal

## V2 - Hauptplatine

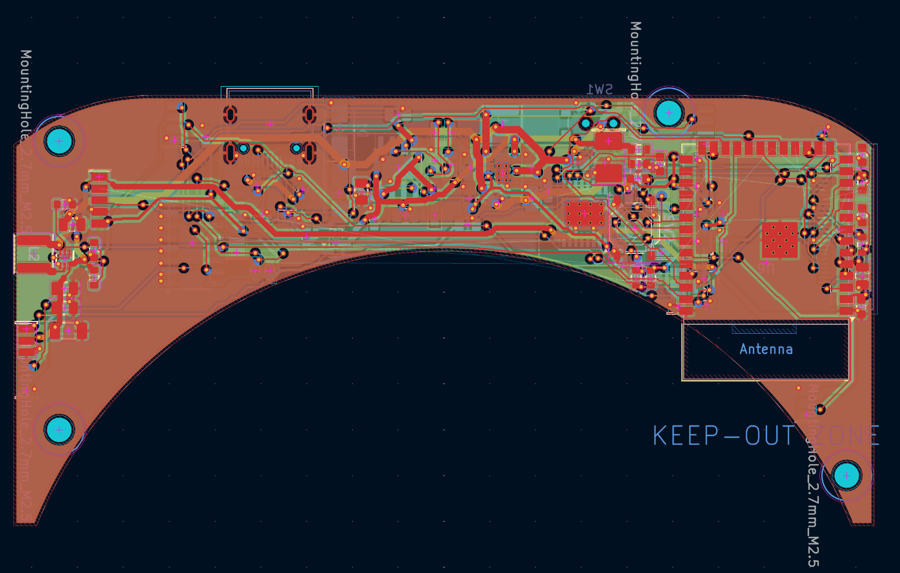
[picture p27: figure]

Projektpräsentation - Ausblick

Autor: Gereon Such

Notes: Der geplante STM32 mit WLAN sollte auf die Hauptplatine. Zu wenig Platz für die Antenne…

## Quellen

[26b] | Repräsentative Umfrage: Digitale Gastronomie. [Online; accessed 20. Jul. 2026]. Juli 2026. url: https://newsroom.metroag.de/de/news/repraesentative umfrage-digitale-gastronomie?dt=20250221.
[Deu26] | Deutscher Hotel- und Gaststättenverband e.V. (DEHOGA Bundesverband). DEHOGA-Zahlenspiegel IV/2025. Zahlenspiegel. Stand: 24. Februar 2026. Berlin: DEHOGA Bundesverband, 2026. url: https://www.dehoga bundesverband.de/fileadmin/Startseite/04_Zahlen___Fakten/ DEHOGA-Zahlenspiegel_4._Quartal_2025.pdf.
[LP17] | Kevin M. Lynch und Frank C. Park. Modern Robotics: Mechanics, Planning, and Control. Cambridge, England, UK: Cambridge University Press, Juli 2017. doi: 10.5555/3165183.
[Cyber01] | Cyberbotics: Robotics simulation with Webots, https://cyberbotics.com/
