Project-CoasterBot/coasterbot/M6_Projekträsentation/se_Projektpräsentation_Coasterbot.odp

## Projektpräsentation

Coasterbot


KI generiertes Bild

## Slide 2

Projektumsetzung

Projektorganisation

01 | Hinführung/Projektziel | 08 | Nutzen und Ausblick
02 | Mechanischer Aufbau | 09 | Teambildung und Rollen
03 | Algorithmik und Simulation | 10 | Zusammenarbeit im Projekt
04 | Elektronik und Abstraktion | 11 | Kommunikation im Projekt
05 | Projektergebnis | 12 | Bewertung des Projektergebnis
06 | Zeitplan
07 | Kosten- und Ressourcenplan

## Vorschlag Roter Faden

- Hinführung:
  - Fiktiver Kunde vorstellen und Problem (Literaturrech.) beschreiben DB (1)
  - Fiktiver Kunde beschreibt Vision DB (1)
  - Fiktiver Kunde beauftragt uns DB (1)
- Metaebene
  - Wir stellen Projektziel vor SE (1)
  - Wir stellen das Team und Rollen vor GS (1)
  - Wir stellen verfügbaren Rahmen (Zeit, Kosten, Ressourcen) vor GS (1)
- Technische Ebene
  - Wir stellen Teilung der Gewerke vor SE (1)
  - Wir stellen Vorgehen mit zentralen Ergebnissen vor
    - Mechanik DB (3), Algorithmik SE (3), Elektronik/Implementierung GS (4)
  - Wir stellen Projektergebnis vor (Mit Video, Idee: Sim und Real nebeneinander?)
    - Simulation SE (3)
    - Implementierung GS (3) + Video
  - Wir geben eine Retrospektive und Bewertung des Ergebnis DB (2)
- Weiterer Weg zur Vision
  - Ausblick zu V2 GS (1)

Backup-Folien

- WiRe

## Kundenvision

Projektpräsentation - Coasterbot

Brauchen Attraktivitätsmerkmale

Belastung beim Personal

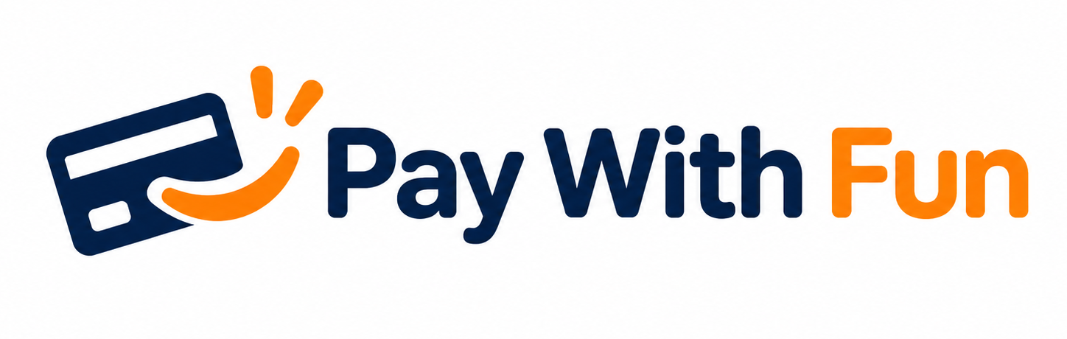
[picture p28: figure]

KI generiertes Bild

Fiktiver Zahlungsdienstleister in der Gastronomie

sieht im Markt

Online Präsenz beeinflusst Umsatz

Quellen: [Deu26, 26b]

Autor:Dennis Borutta

## Projektziel

## Projektziel

Projektpräsentation - Coasterbot

  Entwicklung eines Prototyps

als Maturity Level 1

- Automatisiertes Verteilen und Einsammeln von Getränkeuntersetzern
- Evaluierung: Systemarchitektur, Hardware- & Software-Komponenten, Tests
- Mechanik und Elektronik so ausgearbeitet, dass eine Fertigung möglich ist

Autor: Stefan Etringer

## Gewerke

Projektpräsentation - Coasterbot

Mechanik Chassis als 3D Druck Ausschiebemechanismus der Untersetzer Nachrüstung eines Encoder-Halters | Elektronik und Hardwareabstraktion Komponentenauswahl Aktorik und Sensorik Lochrasterplatine Hardwareabstraktionsschicht Implementierung Nachrüsten des Radencoders | Navigationsalgorithmik und Simulation Prototyping des Nav-Stacks Lokalisierung über Komplementärfilter Verifikation in Simulation

Autor: Stefan Etringer

## Gewerke -- Algorithmik

Autor:

## Gewerke -- Algorithmik

Projektpräsentation - Coasterbot

Lokalisierung

Manipulationsplanung

Globale Pfadplanung

Lokale Kollisionsvermeidung

Dynamische Neuplanung

Autor: Stefan Etringer

## Gewerke -- Algorithmik

Projektpräsentation - Coasterbot

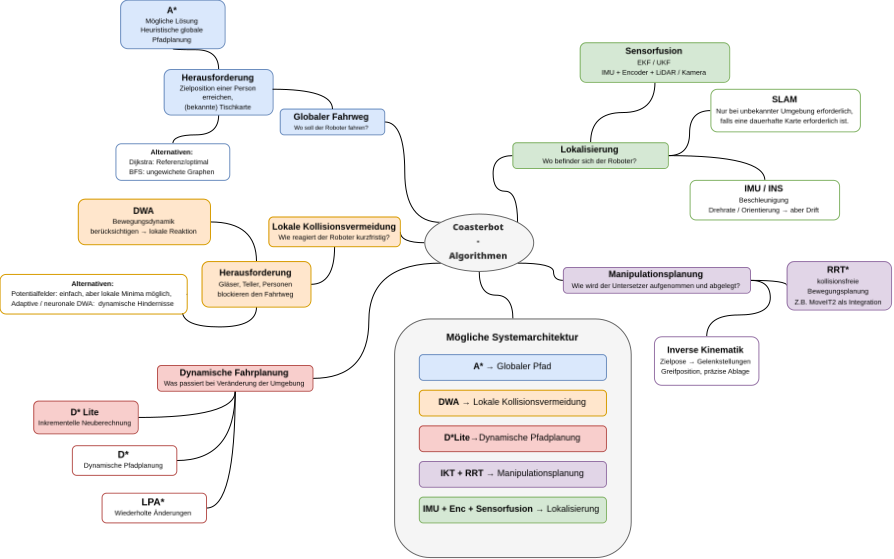
[picture p29: figure]

Autor: Stefan Etringer

## Gewerke -- Algorithmik

Projektpräsentation - Coasterbot

Globale Pfadplanung | A* (A-Star) | Heuristik lenkt die Suche zielgerichtet, optimales Gitter über Wegpunkte
Lokale Kollisionsvermeidung | Dynamic Window Approach | Bewegungsdynamik einbezogen, vermeidet lokale Minima der Potentialfeldmethode
Dynamische Neuplanung | D* Lite (D-Star Lite) | Inkrementelles Verfahren für nachträglich entdeckte Hindernisse
Lokalisierung | Radodometrie + Gyroskop als Komplementrärfilter | Ausreichend für die Tischfläche, Simultaneous Localization and Mapping (SLAM) nicht notwendig
Manipulationsplanung | Inverse Kinematik (IK), Rapidly-exploring Random Tree* (RRT-Star) | Bewegungsplanung: Gelenkstellung, Greifposition, präzise Ablage

Autor: Stefan Etringer

## Ergebnis – Simulation in Webots


Autor: Stefan Etringer

## Ergebnis -- Simulation

Projektpräsentation - Coasterbot

  Webots: open-source robot simulator
  Entwicklungsumgebung zur Modellierung, Programmierung und Simulation von Robotern
- Vorgefertigte Modelle für Sensorik & Aktorik
- Physiksimulation
- Programmierbar (C/C++/Python)

Quellen: [Cyber01]


Autor: Stefan Etringer

## Ergebnis -- Simulation

Projektpräsentation - Coasterbot

  Testlauf der Algorithmen zur Navigation und des FAULTMONITORS erfolgreich abgeschlossen

✅ ST-SIM-001: Navigation zum Zielpunkt
✅ ST-SIM-002: Dynamische Hindernisvermeidung
✅ ST-SIM-003: Verhindern des Verlassens der Tischfläche
✅ ST-SIM-004: Wiederholbarkeit identischer Bewegungsabläufe
✅ ST-SIM-005: Reaktion auf fehlerhafte Sensordaten
✅ ST-SIM-006: Verhalten bei fehlerhafter Motorsteuerung


Autor: Stefan Etringer

## Ergebnis -- Simulation

Projektpräsentation - Coasterbot

  Untersetzerhandling nicht Teil der Simulationssoftware:
- ❌ ST-SIM-007 Aufnahme und Platzierung eines Untersetzers
- Nicht durchgeführt durch Zeitmangel: ❌ ST-SIM-008 Vergleich Simulation und Systemverhalten

Autor: Stefan Etringer

## Ergebnis -- Simulation

Projektpräsentation - Coasterbot

  Statemachine als zusammenführende Implementation der Funktionen:
- Coasterbot setup
- Tisch einlernen
- Coasterbot wartend
- Untersetzer ausgeben
- Untersetzer einsammeln
- Not-Halt aktivieren

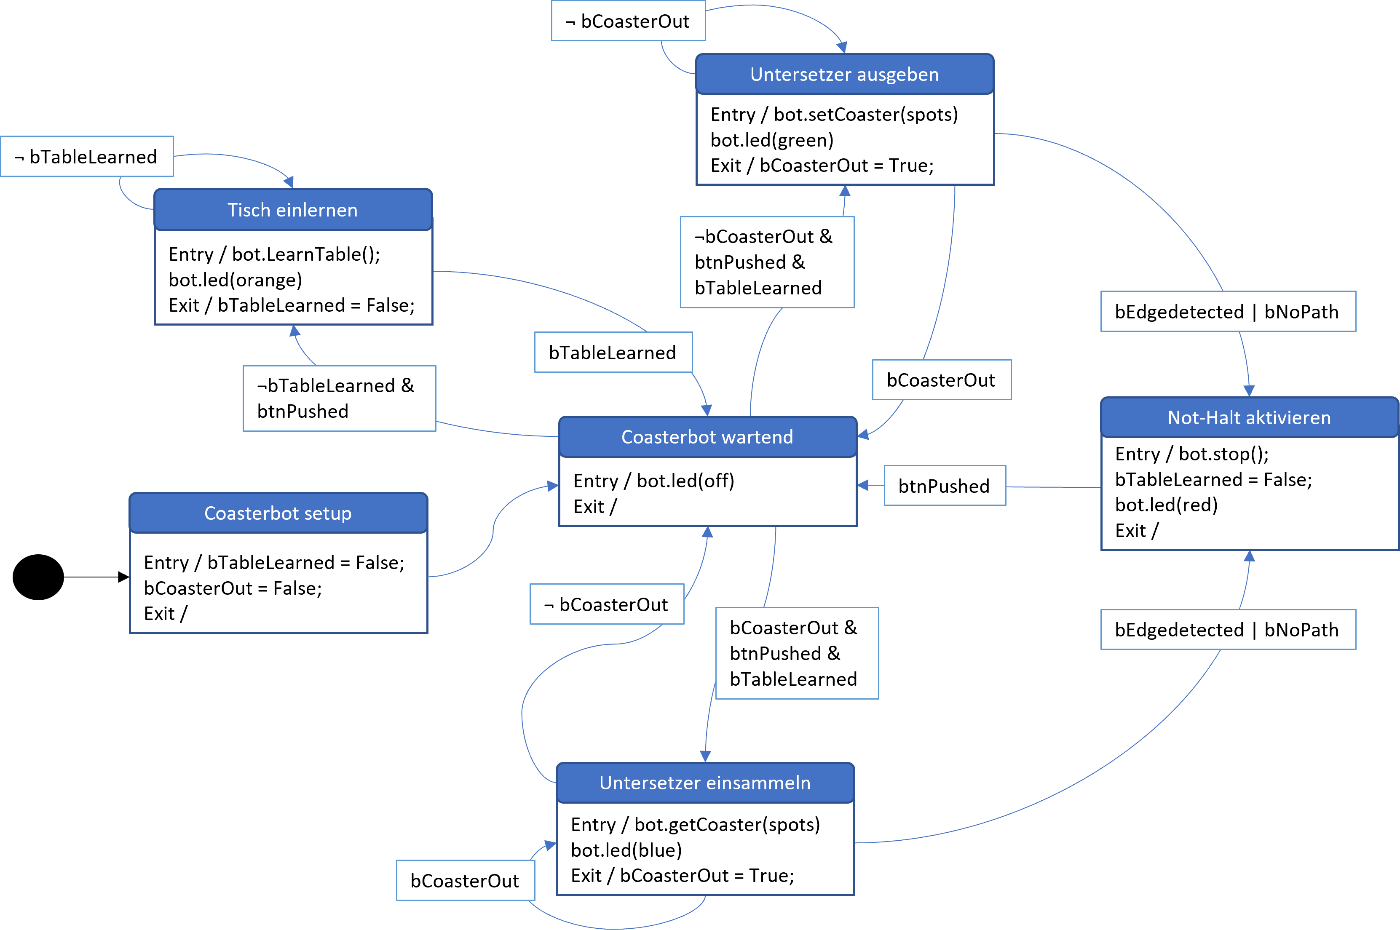
[picture p30: figure]

Autor: Stefan Etringer

## Ergebnis -- Simulation

Projektpräsentation - Coasterbot

- Video ab, bitte!


Autor: Stefan Etringer

## Quellen

[Cyber01] | Cyberbotics: Robotics simulation with Webots, https://cyberbotics.com/
