Project-CoasterBot/coasterbot/M6_Projekträsentation/gs_Projektpräsentation_Coasterbot.odp

## Projektpräsentation

Coasterbot


KI generiertes Bild

## Slide 2

Projektumsetzung

Projektorganisation

01 | Hinführung/Projektziel | 08 | Nutzen und Ausblick
02 | Mechanischer Aufbau | 09 | Teambildung und Rollen
03 | Algorithmik und Simulation | 10 | Zusammenarbeit im Projekt
04 | Elektronik und Abstraktion | 11 | Kommunikation im Projekt
05 | Projektergebnis | 12 | Bewertung des Projektergebnis
06 | Zeitplan
07 | Kosten- und Ressourcenplan

## Vorschlag Roter Faden

- Hinführung:
  - Fiktiver Kunde vorstellen und Problem (Literaturrech.) beschreiben DB (1)
  - Fiktiver Kunde beschreibt Vision DB (1)
  - Fiktiver Kunde beauftragt uns DB (1)
- Metaebene
  - Wir stellen Projektziel vor SE (1)
  - Wir stellen das Team und Rollen vor GS (1)
  - Wir stellen verfügbaren Rahmen (Zeit, Kosten, Ressourcen) vor GS (1)
- Technische Ebene
  - Wir stellen Teilung der Gewerke vor SE (1)
  - Wir stellen Vorgehen mit zentralen Ergebnissen vor
    - Mechanik DB (3), Algorithmik SE (3), Elektronik/Implementierung GS (4)
  - Wir stellen Projektergebnis vor (Mit Video, Idee: Sim und Real nebeneinander?)
    - Simulation SE (3)
    - Implementierung GS (3) + Video
  - Wir geben eine Retrospektive und Bewertung des Ergebnis DB (2)
- Weiterer Weg zur Vision
  - Ausblick zu V2 GS (1)

Backup-Folien

- WiRe

## Kundenvision

Projektpräsentation - Coasterbot

Brauchen Attraktivitätsmerkmale

Belastung beim Personal


KI generiertes Bild

Fiktiver Zahlungsdienstleister in der Gastronomie

sieht im Markt

Online Präsenz beeinflusst Umsatz

Quellen: [Deu26, 26b]

Autor:Dennis Borutta

Quellen:

Autor:

Projektpräsentation - Coasterbot

Quellen:

Autor:

## Slide 7

## Team & Rollen

Quellen:

Autor:

## Teamvorstellung

Projektpräsentation - Coasterbot


- Dennis Borutta
- -Teamlead-
- Mechanik

Quellen:


- Stefan Etringer
  Algorithmik

Autor: Gereon Such

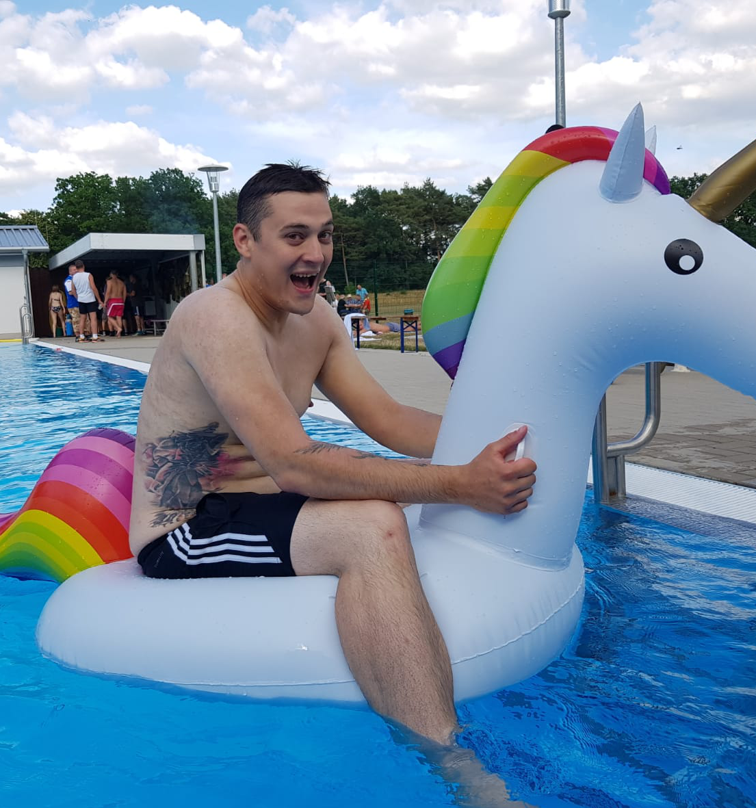
[picture p31: figure]

- Gereon Such
- Elektronik

## Teamvorstellung

Projektpräsentation - Coasterbot

- Dennis Borutta
- -Teamlead-
- Mechanik

Quellen:

- Stefan Etringer
  Algorithmik

Autor: Gereon Such


- Gereon Such
- Elektronik

## Zeit, Kosten, Ressourcen

Quellen:

Autor:

## Zeitplan

Projektpräsentation - Coasterbot

Quellen: M0 Dokument Coasterbot

Autor: Gereon Such

Notes: Gesamtprojektzeit 3 Monate Viele Schritte nicht parallelisierbar Projektzeit nach DIN 69900

## Zeitplan

Projektpräsentation - Coasterbot

- Recherche
- 8 Arbeitstage

Quellen: M0 Dokument Coasterbot

Autor: Gereon Such

Notes: Erste Stufe mit verschiedenen Recherchen

## Zeitplan

Projektpräsentation - Coasterbot

- Anforderungsaufnahme
- 14 Arbeitstage

Quellen: M0 Dokument Coasterbot

Autor: Gereon Such

Notes: Zweite Stufe mit der Anforderungsaufnahme, Maturity Level und Lastenheft

## Zeitplan

Projektpräsentation - Coasterbot

- Konzeption
- 17 Arbeitstage

Autor: Gereon Such

Quellen: M0 Dokument Coasterbot

Notes: Konzeption von Komponenten und Software bis zum Pflichtenheft

## Zeitplan

Projektpräsentation - Coasterbot

- Prototyp
- 25 Arbeitstage

Autor: Gereon Such

Quellen: M0 Dokument Coasterbot

Notes: Prototyp in Hardware und Software erstellen

## Zeitplan

Projektpräsentation - Coasterbot

- Test
- 8 Arbeitstage

Quellen: M0 Dokument Coasterbot

Autor: Gereon Such

Notes: Test des erstellten Prototyps

## Zeitplan

Projektpräsentation - Coasterbot

- Projektabschluss
- 22 Arbeitstage

Quellen: M0 Dokument Coasterbot

Autor: Gereon Such

Notes: Projektabschluss mit Maturity Level Feststellung und Dokumentation des Ergebnis

## Zeitplan

Projektpräsentation - Coasterbot

- ∑ 94 Arbeitstage

Autor: Gereon Such

Quellen: M0 Dokument Coasterbot

Notes: In Summe 94 Arbeitstage auf dem kritischen Pfad

## Zeitplan

Projektpräsentation - Coasterbot

- ∑ 94 Arbeitstage

Autor: Gereon Such

Quellen: M5 Endbericht Coasterbot

Notes: Meisten Grenzen gehalten Prototyp Erstellung deutlich verzögert, aber kompensiert.

## Kostenplan

Projektpräsentation - Coasterbot


- ∑ 52827 €

Quellen: M0 Kostenplan Coasterbot

Autor: Gereon Such

Notes: In Phase M0 detailliert erstellt Mit Stundensatz von 89€ + 10.6% Wagnis = 100€ pro Stunde kalkuliert Es ergeben sich Gesamtkosten von 52827€ Software wird OpenSource verwendet, Werkzeuge werden als gegeben gesetzt und Verschleiss o.ä. nicht berechnet

## Kostenplan

Projektpräsentation - Coasterbot


- Zuzüglich Filament ~15 € → 71.49 € pro Prototyp
- Statt angenommener 207 €

Quellen: M5 Endbericht Coasterbot

Autor: Gereon Such

Notes: Prototyp deutlich günstiger, vor allem durch größere Mengen und günstige Komponentenauswahl.

## Elektronik

Quellen:

Autor:

## Elektronik

Projektpräsentation - Coasterbot


Autor: Gereon Such

Quellen: M4 Aufbauanleitung

Notes: Schematic für ausgewählte Komponenten mittels KiCAD erstellt.

## Elektronik

Projektpräsentation - Coasterbot


Quellen: M4 Aufbauanleitung

Autor: Gereon Such

Notes: Umgesetzt auf ein Breadboard

## Elektronik


Projektpräsentation - Coasterbot

Quellen: M4 Aufbauanleitung

Autor: Gereon Such

Notes: Layout äquivalent auf Lochrasterplatine übernommen Unterseite hier Spiegelverkehrt dargestellt

## Elektronik

Projektpräsentation - Coasterbot

- GND

VCC 5V

GND

VM 3.7V

Quellen: M4 Aufbauanleitung

Autor: Gereon Such

## Elektronik

- Raspi Pico2 Microcontroller

Projektpräsentation - Coasterbot

Quellen: M4 Aufbauanleitung

Autor: Gereon Such

## Elektronik

- DC/DC Spannungswandler
- 3.7V → 5V

Projektpräsentation - Coasterbot

Quellen: M4 Aufbauanleitung

Autor: Gereon Such

## Elektronik

- RGB LED Modul

Projektpräsentation - Coasterbot

Quellen: M4 Aufbauanleitung

Autor: Gereon Such

## Elektronik

- MPU-6050
- Gyroskop

Projektpräsentation - Coasterbot

Quellen: M4 Aufbauanleitung

Autor: Gereon Such

## Elektronik

- Motorsteuerung
- 2x TB6612FNG

Projektpräsentation - Coasterbot

Quellen: M4 Aufbauanleitung

Autor: Gereon Such

## Elektronik

Projektpräsentation - Coasterbot

Autor: Gereon Such

Quellen:

Notes: umgesetzt auf der Platform

## Elektronik

Projektpräsentation - Coasterbot

Autor: Gereon Such

- 4x Antrieb
- TT-Motor(innen)

Quellen:

## Elektronik

Projektpräsentation - Coasterbot

Autor: Gereon Such

- 4x IR Sensor
- Tischkantenerkennung

Quellen:

## Elektronik

Projektpräsentation - Coasterbot

Autor: Gereon Such

- 1x Ultraschall
- Kollisionsvermeidung

Quellen:

## Elektronik

Projektpräsentation - Coasterbot

Autor: Gereon Such

- 1x Akku
- 3.7V Li-ION

Quellen:

Notes: Li-Ion kann die hohen Motorströme liefern

## Elektronik

Projektpräsentation - Coasterbot

Autor: Gereon Such

- 1x Ein/Aus
- Schalter

Quellen:

## Elektronik

Projektpräsentation - Coasterbot

Autor: Gereon Such

- 1x Funktionstaster

Quellen:

## Elektronik – Nachrüstung

Projektpräsentation - Coasterbot

Quellen:

Autor: Gereon Such

Notes: Tests zeigten, dass Aufintegrieren von Gyroskopwerten zu fehleranfällig ist. Also Odometrie nachrüsten → Modifikation des Motorhalters

## Elektronik – Nachrüstung

Projektpräsentation - Coasterbot


Quellen:

Autor: Gereon Such

Notes: CAD Design des Halters für Gabellichtschranke, hier Slicer

## Elektronik – Nachrüstung

Projektpräsentation - Coasterbot


Quellen:

Autor: Gereon Such

Notes: 3D Druck

## Elektronik – Nachrüstung

Projektpräsentation - Coasterbot


Quellen:

Autor: Gereon Such

Notes: Montage an zwei Motoren, je auf einer Seite

## Resultat

Quellen:

Autor:

## Ausblick v2

Quellen:

Autor:

## V2

Projektpräsentation - Coasterbot


Quellen:

Autor: Gereon Such

Notes: Entwurf einer V2. Open SCAD ist ein Textformat → Kann Claude Code das? Ja, es kann!

## V2.3 Buildpipeline

Projektpräsentation - Coasterbot


Autor: Gereon Such

Quellen:

Notes: Direkt eine Build Pipeline gebaut, die bei SCAD Änderungen diese rendert und STL aus den Komponenten baut → direkt 3D drucken?

## V2 - Frontblende

Projektpräsentation - Coasterbot


Quellen:

Autor: Gereon Such

Notes: KiCAD ist ein XML Format… Kann Claude das auch? Ja, es kann. Zwar keine Mounting Holes und Bauteile haben sicherlich zu wenig Clearance, aber eine 95% Lösung ist es allemal

## V2 - Hauptplatine


Quellen:

Projektpräsentation - Coasterbot

Autor: Gereon Such

Notes: Der geplante STM32 mit WLAN sollte auf die Hauptplatine. Zu wenig Platz für die Antenne…
