Project-CoasterBot/coasterbot/M0/Unternehmensvorstellung/Unternehmensvorstellung.pdf

### Wilhelm Büchner University of Applied Sciences

Projektseminar Master

## Coasterbot

### Unternehmensvorstellung


Dennis Borutta, B. Eng dennis.borutta@outlook.com Stefan Etringer, B. Eng mail@stefan.works
Gereon Such, M. Sc. gereonsuch@gmail.com

Versionshistorie

Version Datum | Bearbeiter | Änderungen
1 | 19.08.2026 Borutta | Erstfassung der Unternehmensvorstellung
2 | 26.08.2026 Borutta | Erweiterung um eine Wirtschaftlichkeitsbetrach-
tung
3 | 27.08.2026 Borutta | Kleinere Korrekturen und Ergänzungen

2

Inhaltsverzeichnis

1 Unternehmensvorstellung | 4
2 Auftrag Coasterbot | 4

3

### 1 Unternehmensvorstellung

Das Projektteam tritt als Ingenieurbüro unter dem Namen „B·E·Sondere Lösung UG“ auf. Unser Ingenieurbüro ist darauf spezialisiert, Prototypen und Kleinserien für Geräte und Maschinen im Konsumentenbereich zu entwickeln und umzusetzen.

Dabei begleiten wir unsere Kunden, die ein neues Produkt auf den Markt bringen wollen, entlang des gesamten Entwicklungsprozesses – von der ersten Idee über Projektierung und Konzeption, Konstruktion und Prototypenbau bis hin zu Fertigung, Aufbau, Erprobung und Optimierung. So entsteht aus einer ersten Produktidee eine technisch ausgereifte und marktreife Lösung.

Sollte sich ein Produkt über die Kleinserie hinaus erfolgreich am Markt etablieren, unterstützen wir unsere Kunden auch bei der Überführung in größere Fertigungsstrukturen. Dabei beraten wir unter anderem beim Aufbau geeigneter Fertigungsstrecken und sorgen dafür, dass das bereits während der Entwicklung aufgebaute Know-how auch in der Serienproduktion genutzt werden kann.

B·E·Sondere Lösung steht somit für eine ganzheitliche Entwicklungsbegleitung – von der ersten Idee bis zur fertigungsgerechten Umsetzung. Wir sind an Ihrer Seite, um aus Ihrer Idee nicht nur eine gute, sondern eine B·E·Sondere Lösung zu machen.

### 2 Auftrag Coasterbot

Der Auftrag zur Entwicklung eines Prototyps für einen Coasterbot kommt vom Kunden „Pay With Fun GmbH“. Bei dem Kunden handelt es sich um einen Zahlungsdienstleister, der mit kreativen Bezahlmethoden Marktanteile im Bereich der Zahlungsdienstleistungen gewinnen konnte. Um seinen Marktanteil weiter auszubauen, möchte er nun ein Gadget für Restaurants, Events und Bars auf den Markt bringen, welches neben einem besonderen Erlebnis bei der Bezahlung auch einen Mehrwert für Gastronomen bietet.

Hierdurch ist die Idee des Coasterbots entstanden. Der Coasterbot soll folgende Mehrwerte bieten:

- Getränkeuntersetzer ausgeben und aufnehmen
- Eine Tischoberfläche reinigen
- Einen Bezahlvorgang spielerisch gestalten
- Einen Bezahlvorgang beschleunigen

Die Aufgabe des Auftragnehmers „B·E·Sondere Lösung UG“ besteht bei diesem Auftrag darin, eine technische Lösung für diese Idee zu entwickeln. Definierte Ausbaustufen und Anforderungen sind in einem Lasten- und Pflichtenheft festgelegt. Vom Kunden wird im Rahmen dieses Projekts ein erster Prototyp mit minimalem Funktionsumfang gefordert.

4

### 2.1 Finanzierung

Die „B·E·Sondere Lösung UG“ finanziert ihre Projekte über Kundenaufträge. Auf Grundlage der Kundenanforderungen wird zunächst eine Kosten- und Ressourcenplanung durchgeführt. Diese bildet die Grundlage für die Angebotserstellung und den anschließenden Vertragsabschluss.

Die Vergütung erfolgt projektbezogen und wird in mehreren Abschlagszahlungen entsprechend dem Projektfortschritt abgerechnet. Bei Projektstart wird eine erste Zahlung in Höhe von 25 % des vereinbarten Projektpreises fällig. Nach der erfolgreichen Erstellung und Abnahme des Umsetzungskonzepts wird eine weitere Zahlung in Höhe von 25 % fällig. Eine dritte Zahlung in Höhe von 25 % erfolgt nach Auslieferung des vereinbarten Projektergebnisses. Die verbleibenden 25 % werden nach der erfolgreichen Abnahme des Projektergebnisses durch den Kunden fällig.

Durch die Abrechnung nach definierten Projektmeilensteinen wird sichergestellt, dass die Finanzierung des Projekts mit dem erbrachten Leistungsstand fortschreitet und die „B·E·Sondere Lösung UG“ ihre bereits erbrachten Leistungen und entstandenen Aufwendungen laufend abrechnen kann.

### 2.1.1 Wirtschaftlichkeitsbetrachtung

Zur Beurteilung, ob sich der Auftrag für die „B·E·Sondere Lösung UG“ lohnt, wird eine Wirtschaftlichkeitsbetrachtung durchgeführt. Hierbei werden die Methodiken der statischen Investitionsrechnung angewendet. Dazu werden zunächst die Kosten und Erlöse des Projekts betrachtet. Mit diesen wird anschließend eine Gewinnvergleichsrechnung durchgeführt, um die Rentabilität des Projekts zu beurteilen. Anschließend wird ein Liquiditätsplan erstellt, um zu Erkennen wie hoch die Vorleistungen innerhalb des Projekts sind.[Nie19][Stu26]

### 2.1.2 Kosten- und Erlösbetrachtung

Für die Kostenbetrachtung werden die bereits ermittelten Werte aus der Kostenplanung herangezogen. Hierbei wurde Materialkosten in Höhe von 207,00€ und ein Stundensatz von 89,00€/h für die Arbeitszeit der Projektmitglieder angenommen. Hieraus ergeben sich die Vollkosten des Projekts in Höhe von 51.827,00€ beim Projektumfang von 580h.

Dem Gegenüber stehen die Erlöse des Projekts. Dem Auftraggeber wird ein Stundensatz von 100,00€/h in Rechnung gestellt. Hieraus ergeben sich die Erlöse des Projekts in Höhe von 58.000,00€. Dazu werden die Materialkosten des Projekts in Höhe von 207,00€ mit einem Aufschlag von 10% in Rechnung gestellt. Damit dem Auftraggeber Materialkosten in Höhe von 227,70€ in Rechnung gestellt. Diese aufsummiert ergeben den Gesamterlös des Projekts in Höhe von 58.227,70€.

5

### 2.1.3 Gewinnvergleichsrechnung

Zur Gewinnvergleichsrechnung werden die Kosten und Erlöse des Projekts gegenübergestellt. Hierbei ergeben sich die Gewinne des Projekts in Höhe von 6.400,70€ wie sich aus Tabelle1 ergibt.

| Kosten | Erlöse | Gewinn
Materialkosten | 207,00€ | 227,70€ | 20,70€
Arbeitskosten | 51.620,00€ | 58.000,00€ | 6.380,00€
Summe | 51.827,00€ | 58.227,70€ | 6.400,70€

Tabelle 1: Gewinnvergleichsrechnung

### 2.1.4 Rentabilität

Zur Berechnung der Rentabilität wird die Formel aus [Nie19] verwendet. Hierbei wird der Gewinn des Projekts durch die Kosten des Projekts geteilt und mit 100 multipliziert. Hieraus ergibt sich eine Rentabilität von 12,35%. Damit ist das Projekt wirtschaftlich rentabel und lohnt sich für die „B·E·Sondere Lösung UG“.

### 2.1.5 Liquiditätsplanung

Damit die „B·E·Sondere Lösung UG“ ihre laufenden Kosten während des Projekts decken kann, wird eine Liquiditätsplanung durchgeführt. Hierbei werden die Kosten und Erlöse des Projekts auf die einzelnen Projektmeilensteine verteilt. Dabei wird die vierteilige Zahlungsvereinbarung wie in Kapitel 2.1 beschrieben berücksichtigt. Dabei soll erkennbar sein mit welchen Vorleistungen die „B·E·Sondere Lösung UG“ während des Projekts rechnen muss. Die Liquiditätsplanung ist in Tabelle 2 dargestellt. Die eingetragenen Werte stammen dabei aus der Kostenplanung zum Projektaufsatz. Hieraus ist zu erkennen, dass während der Umsetzungsphase an dessen Ende die Auslieferung des Prototyps steht, eine negative kumulierte Liquidität von -1.926,21€ entsteht. Diese muss durch die „B·E·Sondere Lösung UG“ vorfinanziert werden.
Meilenstein | Kosten | Erlöse | Liquidität | Kum. Liquidität
Projektstart | 7.298,00€ | 14.556,93€ | 7.258,93€ | 7.258,93€
Abnahme Konzept | 13.350,00€ | 14.556,93€ | 1.206,93€ | 8.465,86€
Auslieferung Prototyp | 24.949,00€ | 14.556,93€ | -10.392,07€ | -1.926,21€
Abnahme Prototyp | 6.230,00€ | 14.556,91€ | 8.326,91€ | 6.400,70€
Summe | 51.827,00€ | 58.227,70€ | 6.400,70€

Tabelle 2: Liquiditätsplanung

6

Literaturverzeichnis

[Nie19] Jörg Niemann. Investitionsrechnung. Vorlesungsskript, Version 4.0; [Online; accessed 26. Aug. 2026]. 2019. url: https://flix-science.de/wp-content/uploads/2019/11/Skript-IWR-V4.0.pdf. (https://flix-science.de/wp-content/uploads/2019/11/Skript-IWR-V4.0.pdf)
[Stu26] IHK Region Stuttgart. Liquiditätsplanung. [Online; accessed 26. Aug. 2026]. Aug. 2026. url: https : / / www . ihk . de / stuttgart / gruendung / finanzierung / finanzplanung/liquiditaetsplanung-678178. (https://www.ihk.de/stuttgart/gruendung/finanzierung/finanzplanung/liquiditaetsplanung-678178)

7
