Project-CoasterBot/coasterbot/M3_Produktentwicklung/Alternativenbeschreibung/Alternativenbeschreibung.pdf

### Wilhelm Büchner University of Applied Sciences

Projektseminar Master

## Coasterbot

### Alternativenbeschreibung


Dennis Borutta, B. Eng dennis.borutta@outlook.com Stefan Etringer, B. Eng mail@stefan.works
Gereon Such, M. Sc. gereonsuch@gmail.com

Versionshistorie

Version Datum | Bearbeiter | Änderungen
1 | 17.08.2026 Etringer | Erstfassung der Alternativenbeschreibung
2 | 17.08.2026 Borutta | Detaillierung Kapitel Mechanik
3 | 17.08.2026 Such | Sensorik Ergänzungen
4 | 19.08.2026 Such | Mindmap für Komponenten

2

Inhaltsverzeichnis

1 Alternativenbeschreibung | 5
2 Systemarchitektur | 5
3 Übersicht aller Möglichkeiten | 6
4 Algorithmen | 7
5 Mechanik | 11

3

6 Elektrik und Energieversorgung | 15
7 Zusammenfassende Bewertung | 18

4

### 1 Alternativenbeschreibung

### 1.1 Ziel und Vorgehensweise

Im Rahmen der Projektarbeit „Coasterbot – Entwicklung eines Prototyps“ wird ein handtellergroßer Roboter entwickelt, der sich selbstständig auf einem Tisch bewegen, Getränkeuntersetzer gezielt ausgeben und diese anschließend automatisiert wieder aufnehmen kann.

Für die Umsetzung des Prototyps bestehen für verschiedene Teilbereiche unterschiedliche technische Lösungsansätze. Im Rahmen der Alternativenbetrachtung werden diese Ansätze gegenübergestellt und hinsichtlich ihrer Eignung für das Projekt bewertet.

Die Betrachtung orientiert sich dabei an den funktionalen und technischen Anforderungen des Coasterbots. Berücksichtigt werden insbesondere die Bereiche Software bzw. Algorithmen, Recheneinheit, Sensorik, Aktorik, Energieversorgung und Mechanik.

Für jede betrachtete Funktion werden zunächst die zugrunde liegende Herausforderung und die mögliche Lösungsvariante beschrieben. Anschließend werden geeignete Alternativen aufgezeigt und hinsichtlich ihrer jeweiligen Vor- und Nachteile gegenübergestellt. Die letztendliche Auswahl einer Variante erfolgt unter Berücksichtigung der Anforderungen des Projekts, der Komplexität der Umsetzung sowie der Eignung für einen funktionsfähigen Prototyp.

### 2 Systemarchitektur

Die Systemarchitektur des Coasterbots lässt sich grundsätzlich in die Bereiche Elektrik und Energieversorgung, Algorithmen und Mechanik unterteilen.

Auf Softwareseite umfasst das System vor allem die Recheneinheit sowie Algorithmen zur Navigation und Manipulationsplanung. Die Hardware umfasst unter anderem Sensorik zur Hindernis- und Tischkantenerkennung, Komponenten zur Positionsbestimmung, Antriebsmotoren sowie die Mechanik zur Aufnahme und Ablage der Untersetzer.

Eine mögliche Systemarchitektur sieht die Kombination einer Recheneinheit mit geeigneter Sensorik und Motorsteuerung vor. Die Auswahl der konkreten Komponenten und Verfahren wird in den folgenden Abschnitten anhand der jeweiligen Teilfunktionen betrachtet.

5

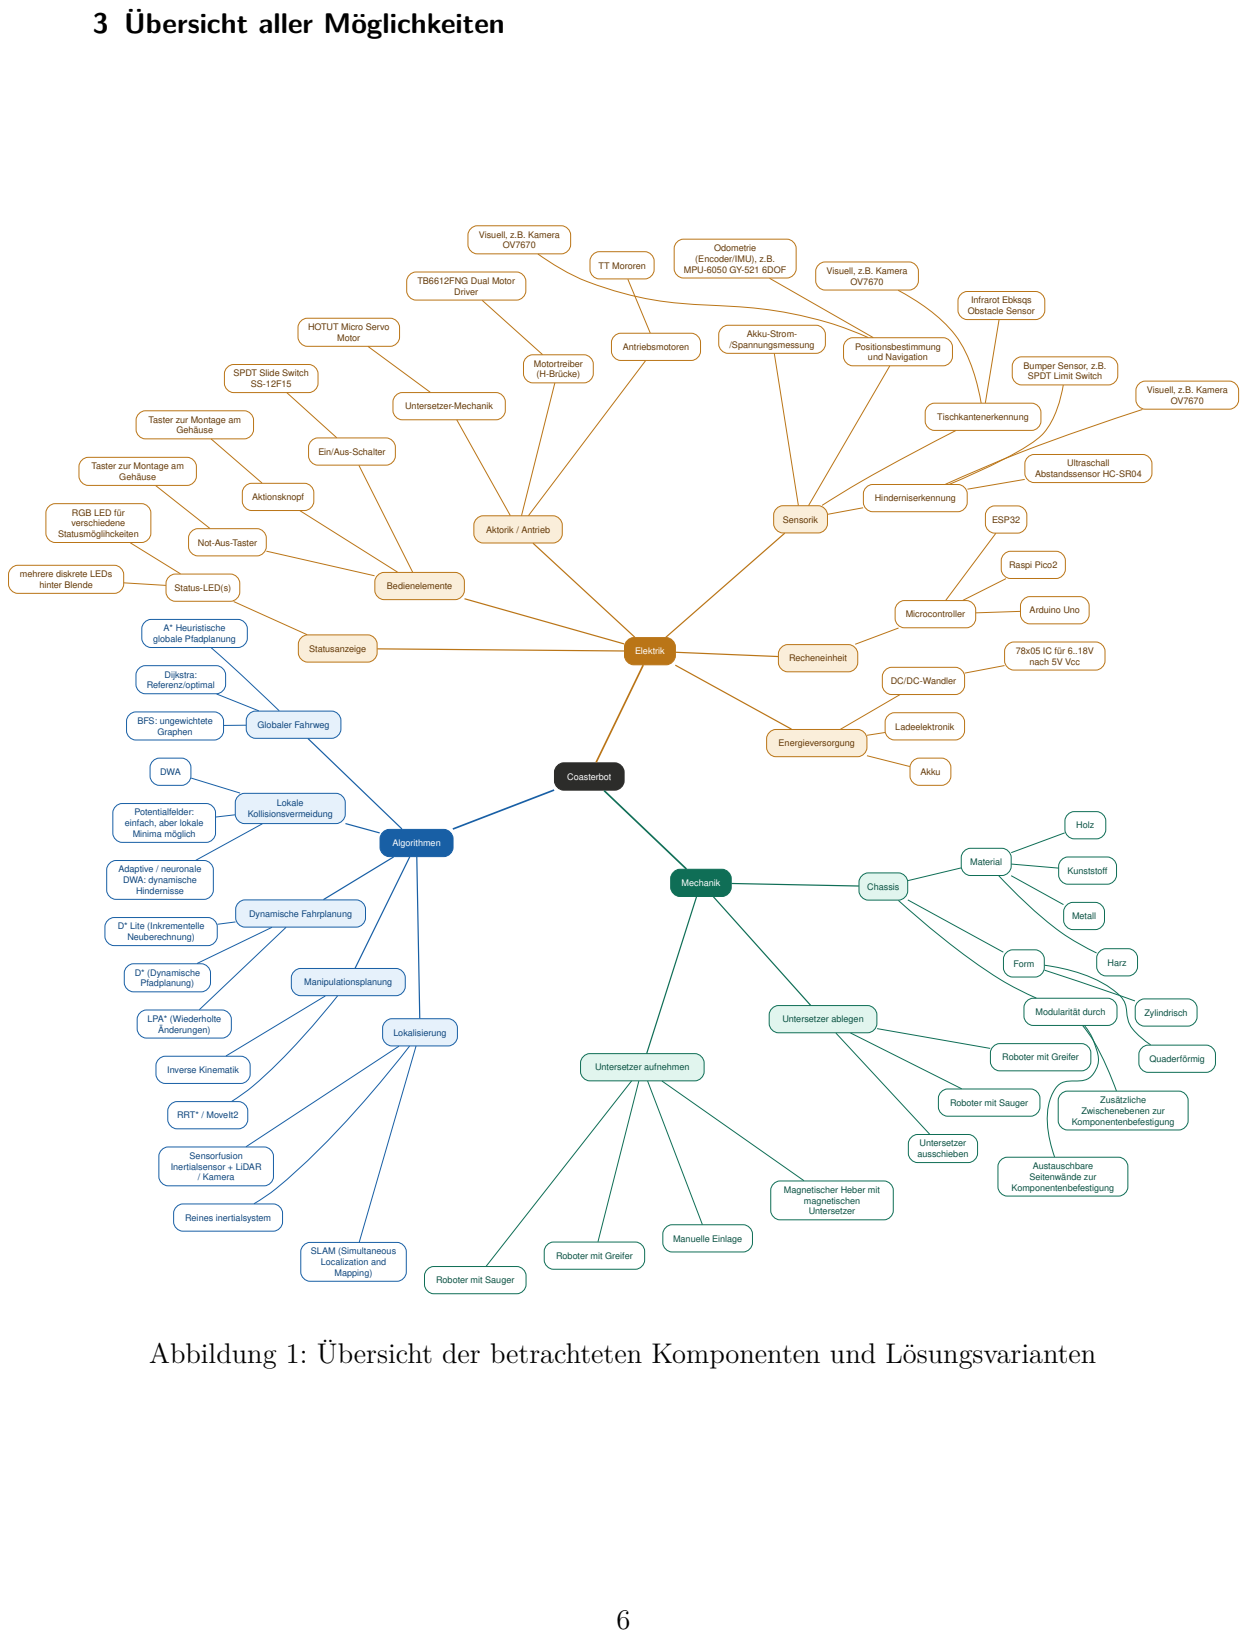
[picture p36: page 6]
Coasterbot; Elektrik; Algorithmen; Mechanik; Energieversorgung; Recheneinheit; Sensorik; Aktorik / Antrieb; Bedienelemente; Statusanzeige; Akku; Ladeelektronik; 78x05 IC für 6..18V nach 5V Vcc; Microcontroller; Arduino Uno; Raspi Pico2; ESP32; Hinderniserkennung; Tischkantenerkennung; Positionsbestimmung und Navigation; Akku-Strom- /Spannungsmessung; Ultraschall Abstandssensor HC-SR04; Visuell, z.B. Kamera OV7670; Infrarot Ebksqs Obstacle Sensor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

3 Übersicht aller Möglichkeiten

HOTUT Micro Servo

SPDT Slide Switch

Bumper Sensor, z.B.
SPDT Limit Switch

Taster zur Montage am
Gehäuse

Ein/Aus-Schalter

RGB LED für
verschiedene
Statusmöglihckeiten

Not-Aus-Taster

mehrere diskrete LEDs
hinter Blende

DC/DC-Wandler

Potentialfelder:
einfach, aber lokale
Minima möglich

Roboter mit Greifer

Roboter mit Sauger

Magnetischer Heber mit
magnetischen
Untersetzer

Abbildung 1: Übersicht der betrachteten Komponenten und Lösungsvarianten

### 4 Algorithmen

### 4.1 Globale Fahrwegplanung

### 4.1.1 Herausforderung

Der Coasterbot muss eine Zielposition auf dem Tisch erreichen. Dabei soll ausgehend von der aktuellen Position ein geeigneter globaler Fahrweg bestimmt werden. Als Grundlage kann dabei eine bekannte Tischkarte dienen.

### 4.1.2 Mögliche Lösung: A*

Für die heuristische globale Pfadplanung kann der A-Algorithmus eingesetzt werden. A verbindet die bisher angefallenen Kosten eines Pfades mit einer Heuristik zur Abschätzung der noch verbleibenden Kosten. Dadurch kann gegenüber einer rein ungerichteten Suche gezielt ein geeigneter Weg zum Ziel bestimmt werden.

### 4.1.3 Alternativen

Dijkstra-Algorithmus

Dijkstra stellt eine Alternative zur globalen Pfadplanung dar. Der Algorithmus bestimmt kürzeste Wege in einem gewichteten Graphen und kann als Referenz für eine optimale Pfadplanung dienen. Im Vergleich zu A* wird jedoch keine zielgerichtete Heuristik verwendet.

Breitensuche (BFS)

Die Breitensuche kann für ungewichtete Graphen eingesetzt werden. Sie ist konzeptionell einfach und eignet sich insbesondere dann, wenn alle Bewegungen dieselben Kosten besitzen.

### 4.1.4 Bewertung

Für den Coasterbot ist zu bewerten, wie effizient der Algorithmus einen Weg zur Zielposition bestimmen kann und welche Anforderungen an die zugrunde liegende Karte gestellt werden.

Die Auswahl zwischen A*, Dijkstra und BFS erfolgt daher anhand der Eigenschaften der Tischkarte, der Gewichtung der Bewegungen und der Anforderungen an die Effizienz der Pfadplanung.

7

### 4.2 Lokale Kollisionsvermeidung

### 4.2.1 Herausforderung

Während der Fahrt können Hindernisse wie Gläser, Teller oder Personen den ursprünglich geplanten Fahrweg blockieren. Der Roboter muss daher kurzfristig auf Veränderungen seiner direkten Umgebung reagieren können.

### 4.2.2 Mögliche Lösung: Dynamic Window Approach (DWA)

Der Dynamic Window Approach berücksichtigt die Bewegungsdynamik des Roboters und ermöglicht eine lokale Reaktion auf Hindernisse. Dadurch kann der Roboter auf kurzfristige Veränderungen der Umgebung reagieren, ohne den globalen Fahrweg vollständig neu berechnen zu müssen.

### 4.2.3 Alternativen

Potentialfelder

Bei der Methode der Potentialfelder wird das Ziel als anziehendes und Hindernisse als abstoßendes Potential modelliert. Die Methode ist vergleichsweise einfach, kann jedoch lokale Minima aufweisen.

Adaptive bzw. neuronale DWA

Eine Erweiterung des DWA-Ansatzes kann insbesondere bei dynamischen Hindernissen eingesetzt werden. Dabei kann die lokale Fahrplanung an veränderte Umgebungsbedingungen angepasst werden.

### 4.2.4 Bewertung

Bei der Auswahl sind die Reaktionsfähigkeit gegenüber Hindernissen, die Komplexität der Implementierung sowie das Verhalten bei dynamischen Hindernissen zu berücksichtigen.

### 4.3 Dynamische Fahrplanung

### 4.3.1 Herausforderung

Verändert sich die Umgebung während der Fahrt wiederholt, kann der ursprünglich berechnete globale Fahrweg ungültig werden. Der Roboter benötigt daher ein Verfahren, mit dem Änderungen der Umgebung bei der Pfadplanung berücksichtigt werden können.

8

### 4.3.2 Mögliche Lösung: D* Lite

D* Lite ermöglicht eine inkrementelle Neuberechnung eines Pfades. Anstatt bei jeder Veränderung die gesamte Planung von Grund auf neu durchzuführen, können Änderungen gezielt in die bestehende Planung einbezogen werden.

### 4.3.3 Alternativen

D*

D* stellt einen alternativen Ansatz für die dynamische Pfadplanung dar und wurde ebenfalls für Umgebungen entwickelt, in denen sich die verfügbaren Wege verändern können.

LPA*

LPA* (Lifelong Planning A*) stellt einen weiteren inkrementellen Ansatz zur Pfadplanung dar. Der Algorithmus ist insbesondere für Situationen geeignet, in denen wiederholt Änderungen am zugrunde liegenden Graphen auftreten.

### 4.3.4 Bewertung

Die Verfahren unterscheiden sich hinsichtlich ihrer Vorgehensweise bei der inkrementellen Neuberechnung und ihrer Eignung für wiederholte Änderungen der Umgebung.

Für den Coasterbot ist zu prüfen, welches Verfahren bei den erwarteten Veränderungen der Tischumgebung ein angemessenes Verhältnis zwischen Planungsaufwand und Reaktionsfähigkeit bietet.

### 4.4 Manipulationsplanung

### 4.4.1 Herausforderung

Der Coasterbot muss Getränkeuntersetzer aufnehmen und gezielt wieder ablegen können. Dabei muss sowohl die gewünschte Greif- bzw. Aufnahmeposition als auch die spätere Ablageposition berücksichtigt werden.

### 4.4.2 Mögliche Lösung: Inverse Kinematik und RRT*

Eine mögliche Lösung besteht in der Kombination aus inverser Kinematik und RRT. Die inverse Kinematik kann dazu verwendet werden, aus einer gewünschten Zielpose geeignete Gelenkstellungen abzuleiten. RRT kann anschließend für eine kollisionsfreie Bewegungsplanung eingesetzt werden.

9

### 4.4.3 Alternativen

Roboter mit Sauger

Die Aufnahme des Untersetzers kann alternativ über einen Sauger erfolgen. Dabei wird der Untersetzer durch eine entsprechende Saugvorrichtung aufgenommen und anschließend an der gewünschten Position abgelegt.

Roboter mit Greifer

Eine weitere Möglichkeit ist die Verwendung eines mechanischen Greifers. Dieser kann den Untersetzer greifen und kontrolliert bewegen.

Manuelle Einlage

Als einfachste Alternative kann der Untersetzer manuell in eine dafür vorgesehene Aufnahme des Roboters eingelegt werden.

Magnetischer Heber

Falls geeignete magnetische Untersetzer verwendet werden, kann alternativ ein magnetischer Heber eingesetzt werden.

### 4.4.4 Bewertung

Die Varianten unterscheiden sich hinsichtlich mechanischer Komplexität, Zuverlässigkeit bei der Aufnahme und Ablage sowie der Anforderungen an die Steuerung.

### 4.5 Lokalisierung

### 4.5.1 Herausforderung

Damit der Coasterbot seine Fahrbewegung planen und ausführen kann, muss seine aktuelle Position beziehungsweise Orientierung bestimmt werden.

### 4.5.2 Mögliche Lösung: IMU, Encoder und Sensorfusion

Eine mögliche Lösung besteht aus der Kombination von IMU und Encoder-Daten. Durch eine Fusion können die Informationen der verschiedenen Sensoren kombiniert werden. Als mögliche Verfahren kommen beispielsweise der Extended Kalman Filter (EKF) oder der Unscented Kalman Filter (UKF) infrage.

10

### 4.5.3 Alternativen

IMU / INS

Eine inertiale Messeinheit kann Beschleunigungen, Drehraten und Orientierung erfassen. Ein wesentlicher Nachteil besteht darin, dass sich Messfehler über die Zeit aufintegrieren und dadurch ein Drift entstehen kann.

SLAM

SLAM ermöglicht eine gleichzeitige Lokalisierung und Kartierung der Umgebung. Für den vorgesehenen Anwendungsfall ist dieser Ansatz dann relevant, wenn die Umgebung unbekannt ist und dauerhaft eine Karte erstellt bzw. aktualisiert werden soll.

IMU + Encoder + LiDAR/Kamera

Eine weitere Möglichkeit besteht in der Kombination von IMU und Encoder-Daten mit zusätzlicher visueller oder LiDAR-basierter Sensorik. Dadurch können zusätzliche Informationen zur Positionsbestimmung gewonnen werden.

### 4.5.4 Bewertung

Da der Coasterbot innerhalb einer begrenzten Tischumgebung eingesetzt wird, ist zu untersuchen, welcher Lokalisierungsansatz den Anforderungen des Prototyps mit angemessenem technischen Aufwand gerecht wird.

### 5 Mechanik

### 5.1 Chassis

### 5.1.1 Anforderungen

Das Chassis bildet die mechanische Grundlage des Coasterbots und muss die notwendigen Komponenten aufnehmen. Gleichzeitig soll der Roboter handtellergroß ausgeführt werden.

11

### 5.1.2 Mögliche Varianten

Quaderförmiges Chassis

Ein quaderförmiger Aufbau ermöglicht eine vergleichsweise einfache Anordnung und Befestigung der Komponenten. Vorallem dadurch, dass Komponenten wie Platinen, ebenfalls in einem Quaderförmigen Format vorhanden sind. Demgegnüber besitzt ein quaderförmiges Chassis Ecken und Kanten, die bei einer Kollision unter Umständen zu Schäden führen können.

Zylindrisches Chassis

Ein zylindrischer Aufbau kann eine alternative Geometrie darstellen. Jedoch wird die Befestigung und Konstruktion von Halterungen durch die Rundung als herausfordernder betrachtet. Auf der anderen Seite bieten die Rundungen des Chassis eine bessere Möglichkeit, Kollisionen abzufedern und Schäden zu vermeiden.

Verfolgte Lösung

Für den Prototypen wird ein quaderförmiges Chassis verfolgt, da diese Geometrie als simpler im Vergleich zu einem zylindrischen Chassis für den Prototypen bewertet wird. Das einhergehende Risiko durch die Ecken und Kanten wird durch die erwartete Geschwindigkeit und das Gewicht des Coasterbots als gering eingeschätzt.

### 5.1.3 Materialalternativen

Für das Chassis beziehungsweise einzelne Gehäusekomponenten kommen unter anderem folgende Materialien infrage:

- Kunststoff
- Holz
- Metall
- Harz

Die Materialauswahl beeinflusst unter anderem Gewicht, Stabilität, Fertigungsaufwand und Möglichkeiten zur Integration der Komponenten.

Kunststoff

Kunststoffe bieten eine gute Möglichkeit durch 3D-Druck eine schnelle Entwicklung eines Prototypen zu ermöglichen. Weiterhin ist dieses Material leicht und kann durch die Wahl des richtigen Kunststoffes eine gute Stabilität bieten.

Holz

Holz ist ein Naturmaterial, das eine gute Stabilität bietet. Jedoch ist die Bearbeitung von Holz für einen Prototypen aufwendiger als bei Kunststoff, da hier weitere Werkzeuge benötigt werden.

12

Metall

Metall bietet eine besonders hohe Stabilität und Langlebigkeit. Jedoch ist die Bearbeitung von Metall aufwendiger als bei Kunststoff und Holz. Weiterhin ist zu erwarten, dass Metall das Gewicht des Coasterbots erhöht. Dies könnte sich negativ auf die Fahrdynamik und die Energieversorgung auswirken.

Harz

Harz kann ähnlich wie Kunststoff durch 3D-Druck verarbeitet werden. Dadurch eignet sich das Material ebenfalls für die schnelle Entwicklung eines Prototypen. Allerdings werden bei Harz weitere Geräte benötigt, wie zum Beispiel ein UV-Licht zur Aushärtung des Materials.

Verfolgte Lösung

Für den Prototypen wird Kunststoff als Material für das Chassis verfolgt, da dieses Material besonders leicht ist und sich besonders einfach verarbeiten lässt.

### 5.1.4 Modularität

Zur flexiblen Befestigung der Komponenten kann das Chassis modular aufgebaut werden. Als Möglichkeiten sind beispielsweise austauschbare Seitenwände oder zusätzliche Zwischenebenen vorgesehen.

Austauschbare Seitenwände

Für austauschbare Seitenwände spricht, dass bei zusätzlichen Sensoren nicht das gesamte Chassis neu hergestellt werden muss, sondern nur eine Seitenwand angepasst werden muss. So könnten auch nachträglich weitere Sensoren oder Kameramodule in die Wände eingelassen werden, ohne den Coasterbot in die Höhe wachsen zu lassen. Dagegen spricht jedoch, dass unter Umständen bei einem Austausch der gesamte Coasterbot demontiert werden muss. Weiterhin könnten nicht feststehende Seitenwände ein Risiko für die Stabilität des Chassis darstellen.

Zusätzliche Zwischenebenen

Für zusätzliche Zwischenebenen zur Modularität spricht, dass sich das Modell so gestalten lassen könnte, dass neue Module aufgesteckt werden könnten und durch vorgesehene Steckverbindungen direkt in die digitale Schaltung integriert werden könnte. Jedoch würde damit der Coasterbot mit jedem Modul in die Höhe wachsen. Weiterhin müssten bei den Zwischenebenen die Geometrie des Mechanismus zur Aufnahme und Ablage der Getränkeuntersetzer berücksichtigt werden.

13

Verfolgte Lösung

Für den Prototypen wird ein modularer Aufbau durch austauschbare Seitenwände verfolgt. Da abgeschätzt wird, dass die Vorteile überwiegen gegenüber dem Risiko der Stabilität. Diesem lässt sich durch Fixierung mit Schrauben entgegenwirken.

### 5.2 Untersetzer aufnehmen und ablegen

Die Mechanik zur Aufnahme und Ablage der Untersetzer stellt eine zentrale Funktion des Coasterbots dar.

Als mögliche Varianten sind vorgesehen:

- Roboter mit Sauger
- Roboter mit Greifer
- manuelle Einlage
- magnetischer Heber bei geeigneten Untersetzern
- Ausschieben des Untersetzers

Die Varianten sind hinsichtlich ihrer mechanischen Komplexität, Zuverlässigkeit und Eignung für die automatisierte Ausgabe und Aufnahme zu bewerten.

Roboter mit Sauger/Greifer

Die Varianten Roboter mit Sauger/Greifer werden gemeinsam betrachtet, da sie sich nur durch den Manipulator unterscheiden. Für die Aufnahme und Ablage eines Untersetzers wird mindestens ein Roboter mit zwei Freiheitsgraden erfordert. Diese Freiheitsgrade müssen mindestens eine Bewegung nach vorne/zurück wie auch nach unten/oben ermöglichen. Hierzu würde mindestens je Freiheitsgrad ein Aktor benötigt. Zusätzlich dazu wird noch eine Aktorik für den Manipulator (Sauger/Greifer) erforderlich. Dadurch wird dieser Aufbau komplexer als die anderen Optionen bewertet. Bei besonders glatten Untersetzern, wird die Zuverlässigkeit von einem Sauger als hoch bewertet. Sobald der Untersetzer rauer in der Beschaffenheit wird, ist zu erwarten, dass das Ansaugen herausfordernder werden kann. Bei einem Greifer hingegen ist kein Risiko hinsichtlich der Zuverlässigkeit erkennbar. Ebenfalls eignen sich beide Lösungen gut hinsichtlich ihrer automatisierten Ausgabe und Aufnahme von Getränkeuntersetzern, da sich ein Roboter automatisiert bewegen lässt.

manuelle Einlage

Eine manuelle Einlage bildet die zuverlässigsten Option für die Aufnahme von Getränkeuntersetzern ab. Ebenso ist hier die mechanische Komplexität als am geringsten abzusehen. Jedoch widerspricht diese Lösungsoption der Eignung zur automatischen Ausgabe und Aufnahme von Untersetzern.

14 magnetischer Heber bei geeigneten Untersetzern

Ein automatisch angetriebener Heber mit eingelassenen Magneten in Verbindung mit speziellen Untersetzern, in denen ebenfalls Magnete eingelassen sind, verspricht eine geringe mechanische Komplexität, da sich ein Heber zum Beispiel durch einen Schubkurbeltrieb simpel umsetzen lässt. Hierzu wird lediglich ein Aktor als Antrieb gebraucht. Weiterhin wird eine hohe Zuverlässigkeit erwartet, da sich durch die Magnete der Heber und die Getränkeuntersetzer gut aufeinander abstimmen lassen. Für eine automatische Aufnahme von Getränkeuntersetzern eignet sich diese Lösungsoption. Durch eingelassene Magneten, haften die Untersetzer direkt am Heber und können so vom Untergrund aufgenommen werden.

Ausschieben des Untersetzers

Das Ausschieben eines Untersetzers verspricht eine Lösung mit geringer mechanischer Komplexität zu sein. Durch diese geringe Komplexität wird abgeschätzt, dass sich diese Lösung auch besonders Zuverlässig umsetzen lässt. Durch einen Stößel, der über einen Antrieb einen davorliegenden Getränkeuntersetzer aus einem Speicher befördert, kann dieser automatisch abgelegt werden. Damit eignet sich diese Lösung ebenfalls für eine automatische Ablage des Getränkeuntersetzers.

Verfolgte Lösung

Für den Prototypen wird zur Aufnahme der Getränkeuntersetzer ein magnetischer Heber mit abgestimmten Untersetzern , so wie ein Ausschieber der Untersetzer vorgesehen. Beide Lösungsoptionen ermöglichen kombiniert das automatische Ablegen wie Aufnehmen von Getränkeuntersetzern und werden in ihrer Komplexität als gering bewertet. Vor allem daher begründet, dass ein Aktor weniger im Vergleich zu einem Roboter mit Manipulator benötigt wird. Durch diese geringe Komplexität wird erwartet, dass sich damit ein zuverlässiger Prototyp erreichen lässt.

### 6 Elektrik und Energieversorgung

### 6.1 Recheneinheit

Für die Steuerung des Coasterbots kommen verschiedene Mikrocontroller bzw. Recheneinheiten infrage.

Als mögliche Varianten wurden identifiziert:

- Arduino Uno
- Raspberry Pi Pico 2
- ESP32

Die Auswahl ist anhand der benötigten Rechenleistung, Schnittstellen, verfügbaren Ressourcen und Eignung für die vorgesehenen Algorithmen zu treffen.

15

### 6.2 Energieversorgung

Für die Energieversorgung ist eine geeignete Spannungsversorgung der einzelnen Komponenten erforderlich.

Als mögliche Komponenten sind unter anderem vorgesehen:

- Akku
- Ladeelektronik
- DC/DC-Wandler
- Spannungsversorgung über einen 78x05-IC für eine Umsetzung von 6–18 V auf 5 V Vcc
- Messung von Akku-Strom und -Spannung

Der Betrieb mit einem aufladbaren Akkumulator ist gemäß Projektdefinition jedoch Out of Scope. Die konkrete Energieversorgungsvariante ist daher entsprechend der Projektabgrenzung festzulegen.

### 6.3 Sensorik

### 6.3.1 Hinderniserkennung

Für die Hinderniserkennung kommen verschiedene Sensorkonzepte infrage:

- Ultraschallsensor, beispielsweise HC-SR04
- visueller Sensor, beispielsweise Kamera OV7670
- Bumper-Sensor, beispielsweise SPDT Limit Switch
- Infrarot-Obstacle-Sensor

Die Varianten unterscheiden sich hinsichtlich Messprinzip, Reichweite, Komplexität und Eignung zur Erkennung von Hindernissen auf einem Tisch.

Bunper Sensoren werden zwar häufig in der Robotik eingesetzt, im geplanten Szenario auf einem Tisch sind die Hindernisse allerdings nicht bedeutend träger als der Coasterbot, weshalb diese Variante nicht praktikabel ist. Ein Infrarot Obstacle Sensor liefert nach eigenen Messungen nur bis ca. 3 cm Abstand ein zuverlässiges Ergebnis in einem sehr kleinen Sichtradius, die Front müsste also vollständig mit Sensoren bestückt werden, was wieerum nicht praktikabel ist.

Die Wahl fällt somit primär auf einen Ultraschallsensor, welcher auch die Distanz zu einem Objekt vermisst, nciht nur ein boolesches Signal. Optimal wäre hier eine Kombination mit einer visuellen Erkennung, um auch Dimensionen von Hindernissen erfassen zu können bzw. besser eine Wegplanung vornehmen zu können.

16

### 6.3.2 Tischkantenerkennung

Zur Erkennung von Tischkanten können ebenfalls unterschiedliche Sensorkonzepte eingesetzt werden. Der nach bisherigen Experimenten zuverlässigste Sensor sind Infrarot-Obstacle Sensoren, welche vor den jeweiligen Rädern mit Ausrichtung nach unten an der Chassisunterseite montiert werden sollen. Kurz bevor sich ein Rad von der Tischkante bewegen würde kann hier ein entsprechendes Signal abgegriffen werden.

Als mögliche Variante ist eine visuelle Erfassung möglich, allerdings ist dies um so schwieriger zu vermessen, je niedriger die Montagehöhe der Kamera am Chassis ist.

### 6.3.3 Positionsbestimmung

Für die Positionsbestimmung sind unter anderem folgende Ansätze vorgesehen:

- Odometrie über Encoder bzw. IMU
- IMU, beispielsweise MPU-6050 / GY-521
- visuelle Positionsbestimmung über eine Kamera

Die Auswahl ist im Zusammenhang mit dem vorgesehenen Lokalisierungsverfahren zu betrachten.

### 6.4 Aktorik und Antrieb

Für den Antrieb des Coasterbots können TT-Motoren eingesetzt werden. Zur Ansteuerung der Motoren ist beispielsweise ein TB6612FNG Dual Motor Driver mit H-Brücke vorgesehen.

Für die Untersetzermechanik kann zusätzlich ein Micro-Servo-Motor eingesetzt werden.

Die konkrete Auswahl der Motoren und Motortreiber ist anhand des benötigten Drehmoments, der Baugröße, der Ansteuerbarkeit und der Anforderungen der Mechanik zu bewerten.

### 6.5 Bedienelemente

Als Bedienelemente sind vorgesehen:

- Ein-/Aus-Schalter
- Aktionsknopf
- Not-Aus-Taster

Als mögliche Komponente für den Ein-/Aus-Schalter ist beispielsweise ein SPDT Slide Switch vorgesehen. Die übrigen Bedienelemente können über geeignete Taster realisiert und am Gehäuse montiert werden.

17

### 6.6 Statusanzeige

Der Betriebszustand des Coasterbots soll für den Benutzer erkennbar sein.

Als mögliche Varianten sind vorgesehen:

RGB-LED

Eine RGB-LED ermöglicht die Darstellung verschiedener Zustände über unterschiedliche Farben.

Mehrere diskrete LEDs

Alternativ können mehrere einzelne LEDs hinter einer Blende angeordnet werden, wobei jeweils eine LED einen bestimmten Betriebszustand repräsentiert.

Die Varianten sind insbesondere hinsichtlich Informationsgehalt, Komplexität und Bedienbarkeit zu vergleichen.

### 7 Zusammenfassende Bewertung

Die Alternativenbetrachtung zeigt, dass für die wesentlichen Funktionen des Coasterbots mehrere technische Lösungsansätze zur Verfügung stehen. Die Auswahl einer geeigneten Variante kann nicht isoliert für jede einzelne Komponente erfolgen, da zwischen den Bereichen Abhängigkeiten bestehen.

Die Auswahl der Recheneinheit, Sensorik und Aktorik beeinflusst die Umsetzung der Algorithmen zur Navigation und Lokalisierung. Ebenso muss die mechanische Umsetzung der Untersetzeraufnahme mit der vorgesehenen Steuerung und Aktorik abgestimmt werden.

Für die weitere Projektbearbeitung werden daher die identifizierten Alternativen anhand der für den Coasterbot relevanten Kriterien bewertet. Dazu zählen:

- Erfüllung der funktionalen Anforderungen
- technische Komplexität
- benötigte Rechenleistung
- mechanischer und elektrischer Aufwand
- Zuverlässigkeit
- Erweiterbarkeit
- Größe und Gewicht
- Fertigungsaufwand
- Eignung für die Umsetzung als Prototyp

Auf Grundlage dieser Bewertung wird für die einzelnen Teilbereiche jeweils eine geeignete Variante ausgewählt und anschließend in der weiteren Systementwicklung berücksichtigt.

18

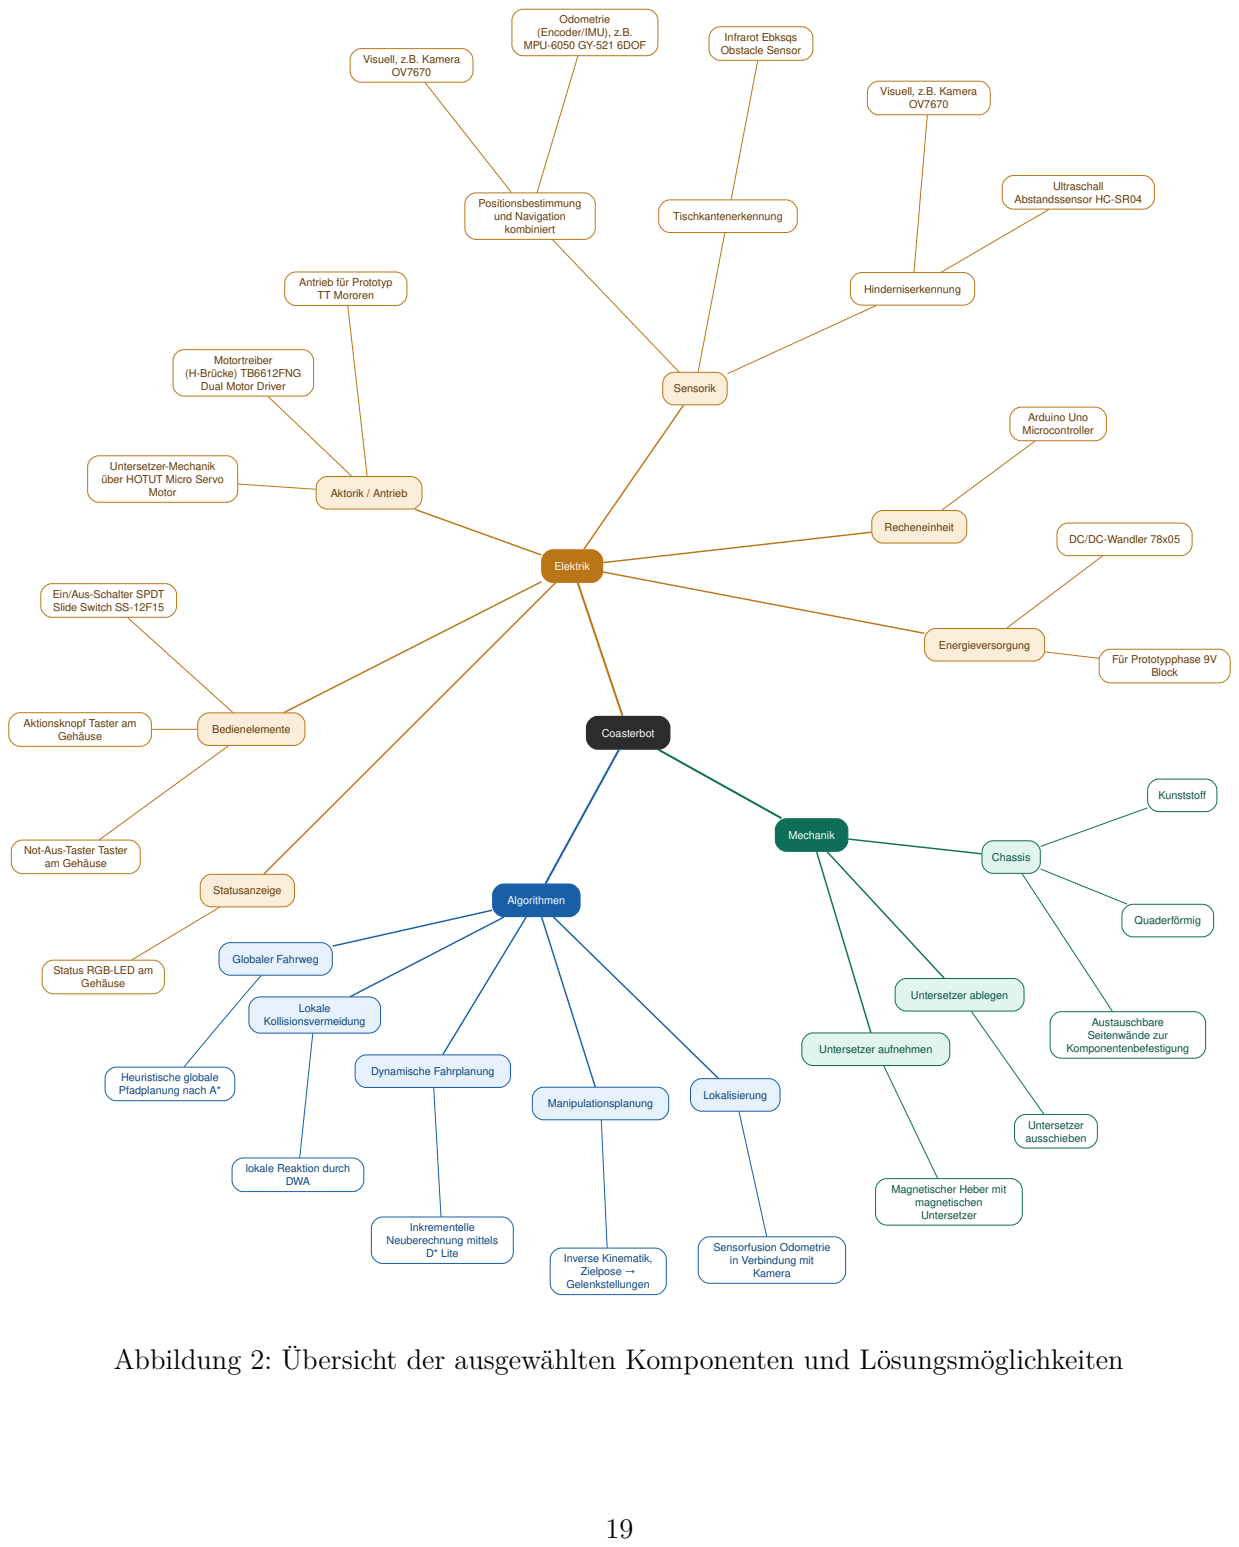
[picture p37: page 19]
Coasterbot; Elektrik; Algorithmen; Mechanik; Energieversorgung; Recheneinheit; Sensorik; Aktorik / Antrieb; Bedienelemente; Statusanzeige; Für Prototypphase 9V Block; Arduino Uno Microcontroller; Hinderniserkennung; Tischkantenerkennung; Positionsbestimmung und Navigation kombiniert; Ultraschall Abstandssensor HC-SR04; Visuell, z.B. Kamera OV7670; Infrarot Ebksqs Obstacle Sensor; Odometrie (Encoder/IMU), z.B. MPU-6050 GY-521 6DOF; Motor; Gehäuse; Globaler Fahrweg; Lokale Kollisionsvermeidung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

Antrieb für Prototyp
TT Mororen

Motortreiber
(H-Brücke) TB6612FNG
Dual Motor Driver

Untersetzer-Mechanik
über HOTUT Micro Servo

DC/DC-Wandler 78x05

Ein/Aus-Schalter SPDT
Slide Switch SS-12F15

Aktionsknopf Taster am

Not-Aus-Taster Taster
am Gehäuse

Status RGB-LED am
Gehäuse

lokale Reaktion durch

Magnetischer Heber mit
magnetischen
Untersetzer

Sensorfusion Odometrie
in Verbindung mit
Kamera

Abbildung 2: Übersicht der ausgewählten Komponenten und Lösungsmöglichkeiten
