Project-CoasterBot/coasterbot/M0/Kostenplan/2026_coasterbot_ressourcen_und_kostenplan.pdf

### Wilhelm Büchner University of Applied Sciences

Projektseminar Master

# Coasterbot

### Ressourcen- und Kostenplan


Dennis Borutta, B. Eng dennis.borutta@outlook.com Stefan Etringer, B. Eng mail@stefan.works
Gereon Such, M. Sc. gereonsuch@gmail.com

Versionshistorie

Version Datum | Bearbeiter | Änderungen
1 | 30.07.2026 Such | Erstfassung des Resourcen- und Kostenplan auf
Basis Netzplan
2 | 30.07.2026 Such | Aufwandschätzung tabelarisch direkt in Kosten
gerechnet, nicht nur Stunden.
3 | 31.07.2026 Such | Werkzeuge über Gemeinkosten berücksichtigt.

2

Inhaltsverzeichnis

1 Allgemeines | 4
2 Ressourcenplan | 4
3 Stundensatzermittlung per Zuschlagskalkulation | 5
4 Aufwandsschätzung je Arbeitspaket | 6
5 Materialkosten der Prototyp-Phase | 7
6 Kostenzusammenfassung (Vollkosten) | 7

3

### 1 Allgemeines

Der Coasterbot ist ein Studienprojekt und als solches sind Arbeitsstunden und Aufwand für gewöhnlich nicht mit Arbeitsstunden gegenzurechnen, da auch eine akademische Lernkurve zu berücksichtigen ist. Dennoch soll dieses Dokument im Sinne eines Startups auch die Arbeitszeit als primäre Kosten des Projekts erfassen.

Die aufgeführten Arbeitsstunden sind am Projektstrukturplan und der Vorgangsliste aus Meilenstein M0 ausgerichtet. Laut diesen war eine Kostenkalkulation eigentlich mit Arbeitspaket 3040 eingeplant, sollte aber für M0 vorgezogen werden.

Hinweis: Der Plan folgt der klassischen ingenieurmäßigen Projektkalkulation mit WBSbasierter Aufwandsschätzung und Stundensatzermittlung nach dem Zuschlagsverfahren.

### 1.1 Rahmen und Annahmen

Punkt | Annahme
Team | 3 Ingenieure
Charakter | Studien-/Nebenprojekt, kalkuliert wie ein Unternehmen
Projektlaufzeit 15.07.2026 – 16.10.2026 (≈ 13,5 Wochen)
Ziel | Prototyp Maturity Level 1
Werkzeuge | vorhanden (keine Anschaffung; im Gemeinkostensatz berücksichtigt)
Software | vollständig Open Source → 0 € Lizenzkosten
Material | muss beschafft werden; bisher ca. 40 e ausgegeben
3D-Druck | Plattform/Chassis steht noch aus

Zwei Sichten werden getrennt ausgewiesen:

- Unternehmenssicht (Vollkosten): Personal wird mit kalkulatorischem Stundensatz bewertet (was das Projekt „kosten würde").
- Reale Auslage: nur tatsächliche Ausgaben der Gruppe (Material) wird berücksichtigt. Als Ingenieursstudenten mit praktischen Fähigkeiten sind Werkzeuge für einen Prototypen hinreichend vorhanden, Softwareseitig wird Open Source verwendet.

### 2 Ressourcenplan

### 2.1 Personal

Rolle | Anzahl Einsatz
Ingenieur 3 | nebenberuflich über gesamte Projektlaufzeit

4

### 2.2 Sachmittel

Ressource | Status | Kosten
Werkzeuge (Werkstatt, Lötausrüstung, 3D-Drucker) | vorhanden | 0 e
Software (IDE, Simulation, FreeCAD, KiCAD) | Open Source | 0 e
Elektronik/Mechanik-Material Prototyp | zu beschaffen siehe Kap. 5
3D-Druck-Filament | zu beschaffen siehe Kap. 5
Rechner/Arbeitsplatz/IT | vorhanden | 0 e

### 3 Stundensatzermittlung per Zuschlagskalkulation

Kalkulatorischer Stundensatz eines Ingenieurs, hergeleitet über Personal(voll)kosten, produktive Stunden, Gemeinkosten sowie Wagnis und Gewinn.

### 3.1 Produktive Stunden pro Jahr

Position | Stunden
Bruttoarbeitszeit (52 Wo × 40 h) | 2.080
- Urlaub (30 AT) | -240
- Feiertage (≈ 11 Tage) | -88
- Krankheit (≈ 8 AT) | -64
= Anwesenheit | 1.688
x Produktivitätsgrad ≈ 83 % (verrechenbar) | ≈ 1.400

### 3.2 Stundensatz

Position | Stunden
Jahresbruttogehalt Ingenieur (Annahme) | 54.000 e
+ Arbeitgeber-Lohnnebenkosten (21 %) | 11.340 €
= Arbeitgeber-Personalkosten p. a. | 65.340 e
÷ produktive Stunden p. a. | 1.400 h
= Personalkostensatz | 46,70 e/h
+ Gemeinkostenzuschlag (90 % – Arbeitsplatz, IT, Werkzeu-
ge/Abschreibung, Verwaltung, Leitung) | 42,00 e/h
= Selbstkostensatz (Vollkosten) | ≈ 89 e/h
+ Wagnis und Gewinn (12 %) | 10,60 €/h
= Angebots-/Verrechnungssatz | ≈ 100 e/h
- Für die interne Projektbewertung wird der Selbstkostensatz 89 e/h verwendet.

5

- Der Verrechnungssatz 100 €/h zeigt den Marktwert (Opportunitätskosten).
- Alle Gehalts-/Zuschlagswerte sind Annahmen und in der Tabelle leicht anpassbar.
- Privat beschaffte Werkzeuge werden über die Gemeinkosten berücksichtigt. Da die Projektdauer begrenzt ist sind diese Kosten ohnehin nicht erheblich: Bei privatem Werkzeug im Wert von 2000 e, einer Nutzungsdauer von 6 Jahren und einem Nutzungsgrad von 25 % ergibt sich eine kalkulatorische Abschreibung über die Projektzeit von 3.5 Monaten von 2000 ·

3.5/6 · 12 · 4 = 24 e.

### 4 Aufwandsschätzung je Arbeitspaket

Personenstunden je Arbeitspaket entsprechend Netzplan. Die dortige Dauer ist Vorgangsdauer in Tagen, somit wird der Personalaufwand geschätzt.

AP | Beschreibung | Aufwand [h] Kosten
1001 Steckbriefdefinition | 4 | 356 e
1002 Projektorganisation und Planung | 12 | 1068 e
1010 Algorithmik recherchieren | 20 | 1780 e
1020 Marktsichtung durchführen | 20 | 1780 e
1030 Stand Mobile Robotik recherchieren | 20 | 1780 e
101 | Dokumente zusammentragen | 6 | 534 e
2010 Anwendungsfälle definieren | 10 | 890 e
2020 Maturity Level definieren | 10 | 890 e
2030 Lastenheft erstellen | 24 | 2136 e
3010 Testfälle definieren | 16 | 1424 e
3020 Sensorik/Aktorik auswählen | 20 | 1780 e
3030 Softwarearchitektur erarbeiten | 24 | 2136 e
3040 Kostenkalkulation durchführen | 12 | 1068 e
3050 Pflichtenheft erstellen | 30 | 2670 e
201 | Dokumente zusammentragen | 4 | 356 e
4010 Bauteile beschaffen | 10 | 890 e
4020 Softwaretest erstellen | 40 | 3560 e
4030 Software implementieren | 120 10680 e
4040 Prototyp aufbauen | 50 | 4450 e
5000 Test durchführen | 40 | 3560 e
6000 Maturity Level feststellen | 12 | 1068 e
301 | Dokumente zusammentragen | 6 | 534 e
401 | Endbericht erstellen und abgeben | 40 | 3560 e
7000 Präsentation ausarbeiten | 30 | 2670 e
Summe | 580 51620 e

6

### 4.1 Aufwand je Phase

Phase | Aufwand [h] | Kosten Anteil
Initialisierung und Recherche (10xx, 101) | 82 | 7298 e | 14 %
Anforderungen / Lastenheft (20xx) | 44 | 3916 e | 8 %
Konzept und Pflichtenheft (30xx, 201) | 106 | 9434 e | 18 %
Realisierung (40xx) | 220 | 19580 e | 38 %
Test und Abschluss (5000–7000, 301, 401) | 128 | 11392 e | 22 %
Gesamt | 580 51620 e | 100 %
- Kapazitätsabgleich: 580 h ÷ 3 Personen ≈ 193 h/Person über 13,5 Wochen ≈ 14–15 h/Woche/Person.

### 5 Materialkosten der Prototyp-Phase

- 3D-Druck als Eigenfertigung angesetzt
- 3d-Drucker sowie weitere Werkzeuge gelten als vorhanden im Team.
Position | Betrag

Bereits beschafft (Sensoren, TT-Motoren, TB6612-Treiber, Servos lt. Empfeh-

lung) | 40 e
3D-Druck Chassis/Plattform (Filament inkl. Iteration/Ausschuss) | 15 e
Ergänzung ML-1-Vollständigkeit (Encoder/IMU, zusätzl. Ultraschall, Micro-
switches, Status-LED/Buzzer, Not-Aus) | 90 e
Energieversorgung (Akkupack/Batteriehalter, Hauptschalter) | 15 e
Verbrauchsmaterial/Kleinteile (Kabel, Stecker, Lötzinn, Schrauben, Standoffs,
Kabelbinder, Breadboard/Lochraster) | 20 e
Zwischensumme | 180 e
Risikopuffer 15 % | 27 e
Materialosten gesamt | ≈ 207 e

### 6 Kostenzusammenfassung (Vollkosten)

Kostenart | Berechnung | Betrag
Personalkosten | 580 h × 89 €/h | 51.620 e
Materialkosten | siehe Kap. 5 | 207 e
Software (Open Source) | - | 0 €
Werkzeuge (vorhanden) | - | 0 €
Projektkosten gesamt (Vollkosten) | | ≈ 51.827 e

7
