Project-CoasterBot/coasterbot/M5_Endbericht/Endbericht.tex

%\documentclass[manuscript]{acmart}
%\documentclass[acmsmall]{acmart}
%\settopmatter{printacmref=false}

\documentclass[
  a4paper,
  12pt,
  DIV=12,        % höherer Wert = schmalere Ränder, weniger Whitespacmi
  parskip=half,  % Absätze mit halbem Abstand statt Einzug
  headings=small % kleinere Überschriften, weniger vertikaler Abstand
]{scrartcl}

%\documentclass[a4paper,11pt]{scrartcl}
%\documentclass[a4paper,11pt]{report}
%\documentclass[a4paper,12pt]{book}
\usepackage[utf8]{inputenc}
\usepackage[german]{babel}
\usepackage[T1]{fontenc}
\usepackage{lmodern}
\usepackage[inkscapelatex=false]{svg}
% Texte im SVG von Inkscape setzen lassen, nicht durch die Dokumentschrift ersetzen
\svgsetup{inkscapelatex=false}
\usepackage{amsmath}
\usepackage{caption}
\usepackage{gensymb}
\usepackage{microtype}
\usepackage{longtable}
\usepackage{tabularx}   % Spalten, die die restliche Zeilenbreite auffüllen (X-Spalte)
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
\newcommand{\CNR}{\textsc{CNR}}
\newcommand{\CINR}{\textsc{CINR}}
\newcommand{\HPAModel}{ Hughes 1177H TWTA }
\newcommand{\bigO}{\mathcal{O}}
\newcommand{\CopWinCompl}{2.375377}
\newcommand{\IBO}{\textsc{IBO}}
\newcommand{\OBO}{\textsc{OBO}}
\newcommand{\spacepage}{\newpage\null\thispagestyle{empty}\newpage}
\newcommand{\satcom}{ SatCom }
\newcommand{\db}{~\text{dB}}

\definecolor{mGreen}{rgb}{0,0.6,0}
\definecolor{mGray}{rgb}{0.5,0.5,0.5}
\definecolor{mPurple}{rgb}{0.58,0,0.82}
\definecolor{backgroundColour}{rgb}{0.95,0.95,0.92}

\lstdefinestyle{CStyle}{
    backgroundcolor=\color{backgroundColour},
    commentstyle=\color{mGreen},
    keywordstyle=\color{magenta},
    numberstyle=\tiny\color{mGray},
    stringstyle=\color{mPurple},
    basicstyle=\footnotesize,
    breakatwhitespace=false,
    breaklines=true,
    captionpos=b,
    keepspaces=true,
    numbers=left,
    numbersep=5pt,
    showspaces=false,
    showstringspaces=false,
    showtabs=false,
    tabsize=2,
    language=C
}

\lstdefinelanguage{VHDL}{
  morekeywords=[1]{library,use,all,entity,is,port,in,out,end,architecture,of,begin,process,if,then,else,elsif,when,others,signal,variable,wait,for,loop},
  morecomment=[l]--,
  morestring=[b]",
  sensitive=true
}

\lstset{
  language=VHDL,
  basicstyle=\ttfamily\small,
  keywordstyle=\color{blue},
  commentstyle=\color{gray},
  stringstyle=\color{red},
  numbers=left,
  numberstyle=\tiny,
  stepnumber=1,
  numbersep=8pt,
  frame=single,
  breaklines=true,
  captionpos=b
}

\lstset{numbers=none}

%\newcounter{example}
%\renewcommand{\theexample}{\thesection.\arabic{example}}

% Default fixed font does not support bold face
\DeclareFixedFont{\ttb}{T1}{txtt}{bx}{n}{12} % for bold
\DeclareFixedFont{\ttm}{T1}{txtt}{m}{n}{12}  % for normal

% Custom colors
\usepackage{color}
\definecolor{deepblue}{rgb}{0,0,0.5}
\definecolor{deepred}{rgb}{0.6,0,0}
\definecolor{deepgreen}{rgb}{0,0.5,0}

\usepackage{listings}

% Python style for highlighting
\newcommand\pythonstyle{\lstset{
language=Python,
basicstyle=\ttm,
morekeywords={self},              % Add keywords here
keywordstyle=\ttb\color{deepblue},
emph={MyClass,__init__},          % Custom highlighting
emphstyle=\ttb\color{deepred},    % Custom highlighting style
stringstyle=\color{deepgreen},
frame=tb,                         % Any extra options here
showstringspaces=false
}}

% Python environment
\lstnewenvironment{python}[1][]
{
\pythonstyle
\lstset{#1}
}
{}

% Python for external files
\newcommand\pythonexternal[2][]{{
\pythonstyle
\lstinputlisting[#1]{#2}}}

% Python for inline
\newcommand\pythoninline[1]{{\pythonstyle\lstinline!#1!}}

% ---------------------------------------------------------------------
% Stil fuer C++-Listings dieser Dokumentation
% ---------------------------------------------------------------------
\lstdefinestyle{cpp}{
  language=C++,
  basicstyle=\ttfamily\footnotesize,
  keywordstyle=\color{deepblue},
  commentstyle=\color{mGreen},
  stringstyle=\color{mPurple},
  numbers=none,
  breaklines=true,
  showstringspaces=false,
  frame=single,
  columns=fullflexible,
  captionpos=b
}

\newglossary[slg]{symbols}{sym}{sbl}{List of Symbols}
\makenoidxglossaries

\newacronym{wbh}{WBH}{Wilhelm-Büchner-Hochschule}
\newacronym{emv}{EMV}{Elektromagnetische Verträglichkeit}
\newacronym{bom}{BOM}{Bill of Material}
\newacronym{dms}{DMS}{Dokumenten-Management-System}
\newacronym{pcb}{PCB}{Printed Circuit Board}
\newacronym{pwm}{PWM}{Puls-Weiten-Modulation}
\newacronym{imu}{IMU}{Inertial Measurement Unit, Inertialsystem}
\newacronym{sbc}{SBC}{Single-Board Computer}
\newacronym{ros}{ROS}{Robot Operating System}
\newacronym{ekf}{EKF}{Extended Kalman Filter}
\newacronym{ukf}{UKF}{Unscented Kalman Filter}
\newacronym{slam}{SLAM}{Simultaneous Localization and Mapping}
\newacronym{ins}{INS}{Inertial Navigation System}
\newacronym{dwa}{DWA}{Dynamic Window Approach}
\newacronym{rrt}{RRT*}{Rapidly-exploring Random Tree, Sternvariante}

%\nocite{*}

\begin{document}
%\pagenumbering{roman}

\title{Konzeptionieren eines Coasterbots}
\subtitle{Endbericht}
\author{Dennis Borutta, Stefan Etringer, Gereon Such}
%\email{gereonsuch@suchdsp.com}
%\affiliation{
%  \institution{Wilhelm Büchner University of Applied Sciences}
%  \department{Computer Engineering}
%  \city{Hof}
%  \country{Germany}
%}

\begin{titlepage}
  \begin{center}
    {\large Wilhelm Büchner University of Applied Sciences} \\[0.3em]

    {\normalsize Projektarbeit Master}
\vspace{5em}

    {\LARGE\bfseries Thema: \\[0.5em] Konzeptionieren eines Coasterbots} \\[2em]

    {\large Endbericht} \\[2em]

    {} \\[1em]

\vspace{4em}

    {\normalsize
\begin{tabular}{c}
  \textbf{Team: Coasterbot}
\end{tabular}
    }

    {\normalsize
\begin{tabular}{ll}
\textbf{Studierender} & \textbf{Matrikelnummer}\\
Dennis Borutta, B. Eng & 857962\\
Stefan Etringer, B. Eng & 865769\\
Gereon Such, M. Sc. & 867070\\
\end{tabular}
    }

\vspace{4em}

\begin{tabular}{lllll}
  \textbf{Betreuer:} & Dr.-Ing. Winfried Tiedge & \hspace{1em}
  & \textbf{Abgabedatum:} & 05.11.2026
\end{tabular}

  \end{center}

\end{titlepage}

% einleitung preambel etc.

% Versionshistorie des Dokuments: eigene Seite direkt nach dem Titelblatt
\section*{Versionshistorie}
\begin{tabularx}{\textwidth}{@{}clp{2.6cm}X@{}}
\toprule
\textbf{Version} & \textbf{Datum} & \textbf{Bearbeiter} & \textbf{Änderungen}\\
\midrule
1 & 03.10.2026 & Borutta & Erster Entwurf.\\
2 & 08.10.2026 & Such & Erstfassung eigener Anteile.\\
3 & 10.10.2026 & Etringer & Beschreibung der Algorithmik und Simulation.\\
4 & 10.10.2026 & Etringer & Beschreibung des Ergebnis und des Nutzens.\\
5 & 15.10.2026 & Borutta & Beschreibung Projektziel und der Mechanik.\\
6 & 18.10.2026 & Borutta & Beschreibung Zeitplan Soll-Ist, Projektergebnis und Teambildung/Rollenverteilung.\\
7 & 20.10.2026 & Borutta & Entfernung der Planungsstichpunkte.\\
8 & 28.10.2026 & Borutta & Weichere Einleitung im Projektziel. Perspektive zur Zusammenarbeit und dem Projektergebnis eingebracht\\
9 & 29.10.2026 & Such & Abkürzungsverzeichnis \\
10 & 30.10.2026 & Such & Retrospektive eingefügt \\
11 & 30.10.2026 & Borutta & Soll-Ist Zeitplan angepasst \\
12 & 31.10.2026 & Etringer & Update und Anpassungen in Kapitel 1.3, Perspektive und Retrospektive eingetragen\\
13 & 03.11.2026 & Such & Eigene Abschnitte gekürzt\\
14 & 04.11.2026 & Such & Setzen der Abschnitte \\
\bottomrule
\end{tabularx}

\newpage

\tableofcontents

\newpage
\printnoidxglossary[type=\acronymtype,title={Abkürzungsverzeichnis},style={long}]

\newpage

\section{Projektumsetzung}\label{projektumsetzung}

\subsection{Projektziel (Dennis Borutta)}\label{projektziel}

\cbcolor{blue}
\cbstart
\input{db_projektziel.tex}
\cbend

\subsection{Lösungsweg: Mechanischer Aufbau (Dennis Borutta)}\label{lösungsweg-mechink}

\cbcolor{blue}
\cbstart
\input{db_mechanik.tex}
\cbend

\subsection{Lösungsweg: Algorithmik und Simulation (Stefan Etringer)}\label{lösungsweg-algorithmik}

\cbcolor{green}
\cbstart
\input{se_algorithmik}
\cbend

\subsection{Lösungsweg: Elektronik und Abstraktion (Gereon Such)}\label{lösungsweg-elektronik}

\cbcolor{red}
\cbstart
\input{gs_elektronik}
\cbend

\subsection{Projektergebnis (Dennis Borutta)}\label{projektergebnis}

\cbcolor{blue}
\cbstart
\input{db_Projektergebnis.tex}
\cbend

\subsection{Zeitplan Soll/Ist (Dennis Borutta)}\label{zeitplan-sollist}

\cbcolor{blue}
\cbstart
\input{db_zeitplan.tex}
\cbend

\subsection{Kosten- und Ressourcenplan Soll/Ist (Gereon Such)}\label{kosten-und-ressourcenplan-sollist}

\cbcolor{red}
\cbstart
\input{gs_kostenressourcenplan.tex}
\cbend

\subsection{Nutzen und Weiterentwicklung des Ergebnis (Stefan Etringer)}\label{nutzen-des-aktuellen-ergebnis}

\cbcolor{green}
\cbstart
\input{se_nutzen_und_ergebnis}
\cbend

\section{Projektablauf}\label{projektablauf}

\subsection{Teambildung und Rollenverteilung (Dennis Borutta)}\label{teambildung-und-rollenverteilung}

\cbcolor{blue}
\cbstart
\input{db_teambildung_rollenverteilung.tex}
\cbend

\subsection{Zusammenarbeit im Projekt (Stefan Etringer)}\label{zusammenarbeit-projekt}

\cbcolor{green}
\cbstart
\input{se_zusammenarbeit}
\cbend

\subsection{Kommunikation im Projekt (Gereon Such)}\label{kommunikation-projekt}

\textbf{Kommunikation Gereon Such:}

\cbcolor{red}
\cbstart
\input{gs_kommunikation}
\cbend

\subsection{Bewertung der Zusammenarbeit}\label{bewertung-der-zusammenarbeit}

\textbf{Restrospektive Gereon Such:}

\cbcolor{red}
\cbstart
\input{gs_zsmarbeit}
\cbend

\textbf{Restrospektive Stefan Etringer:}

\cbcolor{green}
\cbstart
\input{se_retrospektive}
\cbend

\textbf{Restrospektive Dennis Borutta:}

\cbcolor{blue}
\cbstart
\input{db_zusammenarbeit.tex}
\cbend

\subsection{Bewertung des Projektergebnis}\label{fazit}

\textbf{Perspektive Gereon Such:}

\cbcolor{red}
\cbstart
\input{gs_ergebnis}
\cbend

\textbf{Perspektive Stefan Etringer:}

\cbcolor{green}
\cbstart
\input{se_ergebnis}
\cbend

\textbf{Perspektive Dennis Borutta:}

\cbcolor{blue}
\cbstart
\input{db_ergebnis}
\cbend

\begin{landscape}
\section{Anhang}

\subsection{Schematic}
\label{apx:schematic}

\begin{figure}[H]
  \centering
  
  \caption{Gesamtschaltung der Elektronik (aus der Aufbauanleitung).}
  \label{fig:endbericht-schematic}
\end{figure}
\end{landscape}

\newpage
\subsection{Coasterbot Bildgenerierung}
Die Abbildung \ref{fig:chat} zeigt den gesamten Chatverlauf mit ChatGPT
zur Generierung eines Bildes von der Vision des Coasterbots.
\begin{figure}[H]
  \centering
  
  \caption{Chatverlauf mit ChatGPT vom 15.07.2026 zur Coasterbot Bildgenerierung.}
  \label{fig:chat}
\end{figure}

\end{document}
