Project-CoasterBot/coasterbot/M5_Endbericht/gs_kommunikation.tex

\begin{wrapfigure}{r}{0.175\textwidth}
  \centering
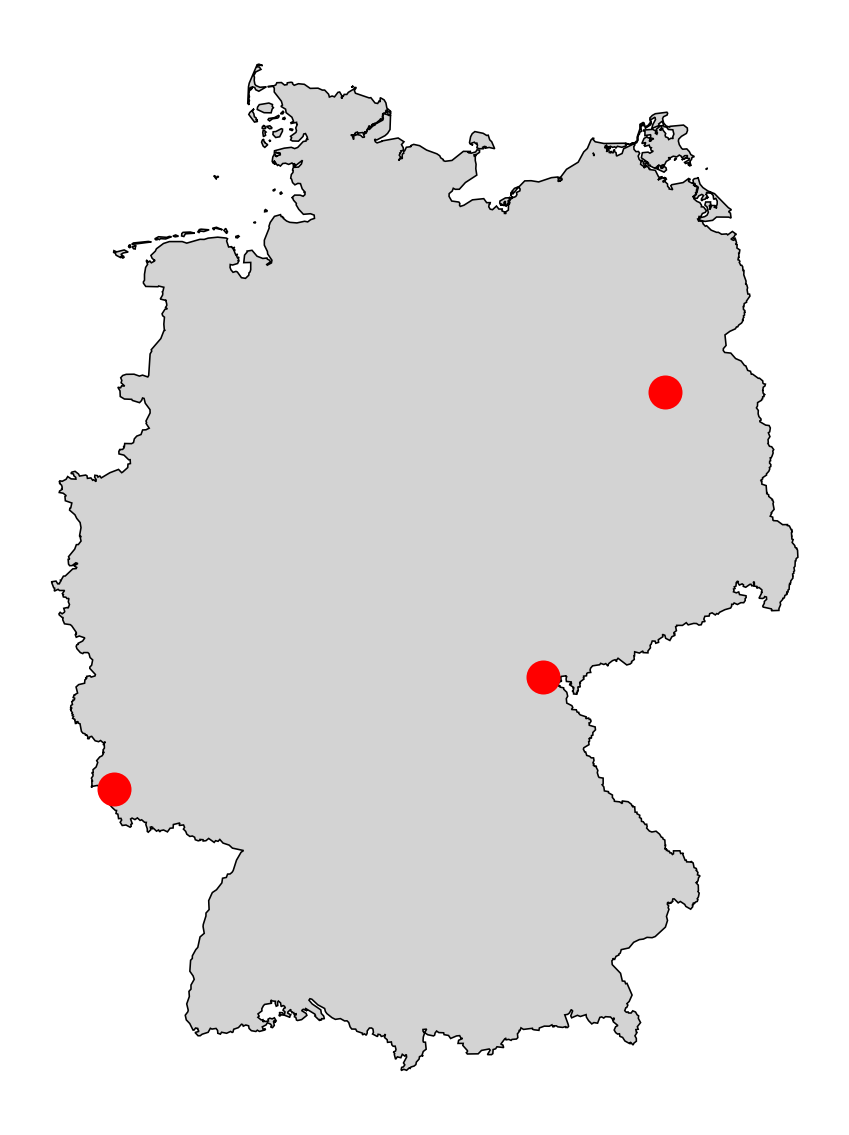
[picture p38: M5_Endbericht/deutschlandkarte.png]
  
\end{wrapfigure}

Das Coasterbot Team ist bei Stichprobengröße $N=3$ in guter Näherung über ganz Deutschland verteilt und die Kommunikation fand folglich digital statt. Die Teamleitung und Kommunikation in den Meilensteingesprächen wurde durch Dennis Borutta wahrgenommen. Die Aufgaben wurden in Arbeitspakete auf- und im Team verteilt. Ein wöchentliches Meeting wurde per Videokonferenz durchgeführt. Kurze Rückmeldungen dazwischen wurden in der Woche über eine WhatsApp-Gruppe geteilt. In der Kommunikation traten keine Probleme auf. 

\subsubsection*{Projektverwaltung: Notion}

\begin{wrapfigure}{r}{0.48\textwidth}
  \centering
  
\end{wrapfigure}

Das zentrale Projektsteuerungstool war \href{https://www.notion.com}{Notion}. Dieses wurde zur Bestimmung von Verantwortlichkeiten, Unteraufgaben, Deadlines und Terminen genutzt, hauptsächlich gepflegt durch Dennis Borutta. Es ermöglicht neben einer wie der rechts dargestellten Timelinedarstellung auch ein kollaboratives Dokumentenmanagement, welches durch das Team insbesondere in der Anfangsphase des Projekts für Recherche und Brainstorming genutzt wurde. 

\subsubsection*{Kollaborationsplattform: Github}

Das Projekt inklusive aller in \LaTeX\, erstellten Dokumente, Sourcecode und anderer Entwicklungsdateien sind in einem \href{https://github.com/Project-CoasterBot/coasterbot}{Github Projekt} verfügbar. \href{https://git-scm.com}{Git} ist ein Versionsverwaltungssystem für das dezentrale Verwalten verschiedener Versionsstände und ist für das Coasterbot Projekt gewählt worden, weil das Team bereits vertraut mit diesem Tool war, es kostenlos und cross-Platform verfügbar ist. Github ist die zentrale Plattform, auf der die Versionsstände gehostet werden. 

\subsubsection*{Videokonferenz: Alfaview}

Als Videokonferenzsystem für den wöchentlichen Austausch wurde auf eine Lösung der deutschen Firma \href{https://alfaview.com}{Alfaview} gesetzt. Es ermöglicht neben regulärer Videokonferenz sowohl das Teilen von Dateien als auch ein Screensharing, was für den Austausch der Arbeitsstände enorm vorteilhaft war. 

\subsubsection*{Kommunikation: WhatsApp}

Für schnelle informelle Abstimmung und Terminabsprachen wurde der Instant-Messenger \href{https://whatsapp.com}{WhatsApp} genutzt. Die Kommunikation erfolgte hier aufgrund der unterschiedlichen Berufsauslastung und familiärer Situation im Team asynchron.
