Project-CoasterBot/coasterbot/M4_Test-und-Validierung/Maturityreport/Maturityreport.tex

%\documentclass[manuscript]{acmart}
%\documentclass[acmsmall]{acmart}
%\settopmatter{printacmref=false}

\documentclass[
  a4paper,
  12pt,
  DIV=12,        % höherer Wert = schmalere Ränder, weniger Whitespacmi
  parskip=half,  % Absätze mit halbem Abstand statt Einzug
  headings=small % kleinere Überschriften, weniger vertikaler Abstand
]{scrartcl}

%\documentclass[a4paper,11pt]{scrartcl}
%\documentclass[a4paper,11pt]{report}
%\documentclass[a4paper,12pt]{book}
\usepackage[utf8]{inputenc}
\usepackage[german]{babel}
\usepackage[T1]{fontenc}
\usepackage{lmodern}
\usepackage[inkscapelatex=false]{svg}
% Texte im SVG von Inkscape setzen lassen, nicht durch die Dokumentschrift ersetzen
\svgsetup{inkscapelatex=false}
\usepackage{amsmath}
\usepackage{caption}
\usepackage{gensymb}
\usepackage{microtype}
\usepackage{longtable}
\usepackage{tabularx}   % Spalten, die die restliche Zeilenbreite auffüllen (X-Spalte)
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

%\usepackage{fancyhdr}
%\pagestyle{fancy}
%\lhead{\leftmark}
%\chead{}
%\rhead{}
%\lfoot{}
%\cfoot{\thepage}
%\rfoot{}
%\renewcommand{\headrulewidth}{0.2pt}
%\renewcommand{\footrulewidth}{0.2pt}

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

\definecolor{mGreen}{rgb}{0,0.6,0}
\definecolor{mGray}{rgb}{0.5,0.5,0.5}
\definecolor{mPurple}{rgb}{0.58,0,0.82}
\definecolor{backgroundColour}{rgb}{0.95,0.95,0.92}

\lstdefinestyle{CStyle}{
    backgroundcolor=\color{backgroundColour},
    commentstyle=\color{mGreen},
    keywordstyle=\color{magenta},
    numberstyle=\tiny\color{mGray},
    stringstyle=\color{mPurple},
    basicstyle=\footnotesize,
    breakatwhitespace=false,
    breaklines=true,
    captionpos=b,
    keepspaces=true,
    numbers=left,
    numbersep=5pt,
    showspaces=false,
    showstringspaces=false,
    showtabs=false,
    tabsize=2,
    language=C
}

\lstdefinelanguage{VHDL}{
  morekeywords=[1]{library,use,all,entity,is,port,in,out,end,architecture,of,begin,process,if,then,else,elsif,when,others,signal,variable,wait,for,loop},
  morecomment=[l]--,
  morestring=[b]",
  sensitive=true
}

\lstset{
  language=VHDL,
  basicstyle=\ttfamily\small,
  keywordstyle=\color{blue},
  commentstyle=\color{gray},
  stringstyle=\color{red},
  numbers=left,
  numberstyle=\tiny,
  stepnumber=1,
  numbersep=8pt,
  frame=single,
  breaklines=true,
  captionpos=b
}

\lstset{numbers=none}

%\newcounter{example}
%\renewcommand{\theexample}{\thesection.\arabic{example}}

% Default fixed font does not support bold face
\DeclareFixedFont{\ttb}{T1}{txtt}{bx}{n}{12} % for bold
\DeclareFixedFont{\ttm}{T1}{txtt}{m}{n}{12}  % for normal

% Custom colors
\usepackage{color}
\definecolor{deepblue}{rgb}{0,0,0.5}
\definecolor{deepred}{rgb}{0.6,0,0}
\definecolor{deepgreen}{rgb}{0,0.5,0}

\usepackage{listings}

% Python style for highlighting
\newcommand\pythonstyle{\lstset{
language=Python,
basicstyle=\ttm,
morekeywords={self},              % Add keywords here
keywordstyle=\ttb\color{deepblue},
emph={MyClass,__init__},          % Custom highlighting
emphstyle=\ttb\color{deepred},    % Custom highlighting style
stringstyle=\color{deepgreen},
frame=tb,                         % Any extra options here
showstringspaces=false
}}

% Python environment
\lstnewenvironment{python}[1][]
{
\pythonstyle
\lstset{#1}
}
{}

% Python for external files
\newcommand\pythonexternal[2][]{{
\pythonstyle
\lstinputlisting[#1]{#2}}}

% Python for inline
\newcommand\pythoninline[1]{{\pythonstyle\lstinline!#1!}}

% ---------------------------------------------------------------------
% Stil fuer C++-Listings dieser Dokumentation
% ---------------------------------------------------------------------
\lstdefinestyle{cpp}{
  language=C++,
  basicstyle=\ttfamily\footnotesize,
  keywordstyle=\color{deepblue},
  commentstyle=\color{mGreen},
  stringstyle=\color{mPurple},
  numbers=none,
  breaklines=true,
  showstringspaces=false,
  frame=single,
  columns=fullflexible,
  captionpos=b
}

%\nocite{*}

\begin{document}
%\pagenumbering{roman}

\title{Coasterbot}
\subtitle{Maturityreport}
\author{Dennis Borutta}
%\email{gereonsuch@suchdsp.com}
%\affiliation{
%  \institution{Wilhelm Büchner University of Applied Sciences}
%  \department{Computer Engineering}
%  \city{Hof}
%  \country{Germany}
%}

\begin{titlepage}
  \begin{center}
    {\large Wilhelm Büchner University of Applied Sciences} \\[0.3em]

    {\normalsize Projektseminar Master}
\vspace{5em}

    {\LARGE\bfseries Coasterbot} \\[0.5em]

    {\large Maturityreport} \\[1em]

    {} \\[1em]

\vspace{4em}

    {\normalsize
\begin{tabular}{ll}
Dennis Borutta, B. Eng & dennis.borutta@outlook.com\\
Stefan Etringer, B. Eng & mail@stefan.works\\
Gereon Such, M. Sc. & gereonsuch@gmail.com\\
\end{tabular}
    }
  \end{center}

\end{titlepage}

% einleitung preambel etc.

% Versionshistorie des Dokuments: eigene Seite direkt nach dem Titelblatt
\section*{Versionshistorie}
\begin{tabularx}{\textwidth}{@{}clp{2.6cm}X@{}}
\toprule
\textbf{Version} & \textbf{Datum} & \textbf{Bearbeiter} & \textbf{Änderungen}\\
\midrule
1 & 27.09.2026 & Borutta & Erstfassung: Maturityreport auf Basis des Lastenhefts (Kapitel 2.7).\\
2 & 17.10.2026 & Borutta & Anpassungen nach finalem Testlauf. \\
3 & 18.10.2026 & Etringer & Sicherheit und Systemmonitoring hinzugefügt. AFOs der Liste hinzugefügt \\
\bottomrule
\end{tabularx}

\newpage

\tableofcontents

\newpage

% Etwas mehr Toleranz beim Umbruch: viele \texttt{}-Bezeichner sind nicht
% trennbar und wuerden sonst knapp ueber den Satzspiegel ragen.
\setlength{\emergencystretch}{3em}

% =====================================================================
\section{Einleitung}\label{einleitung}
% =====================================================================

\subsection{Zweck des Dokuments}\label{zweck-des-dokuments}

Dieser Maturityreport dokumentiert das erreichte Maturity-Level der im
Lastenheft definierten Ausbaustufen. Während das Lastenheft festlegt,
welchen Funktionsumfang definierte Ausbaustufen haben, hält dieser Report fest, welchen Funktionsumfang der Prototyp abdeckt.
Dies wird erreicht durch den Aufbau einer Matrix, in der die erste Spalte die verschiedenen Funktionen definiert und
die darauffolgenden Spalten die verschieden Maturity-Level darstellen. In den Zellen werden die erreichten Funktionen abgehakt und bei Bedarf mit Anmerkungen versehen.
Alle Zellen die eine nicht notwendige Funktion für ein Maturity-Level darstellen, sind ausgegraut. Eine teilweise oder komplette Umsetzung der Funktion ist möglich, aber nicht
erforderlich zum Erreichen des Maturity-Levels.

Es ist dabei zu beachten, dass das Ziel dieses Projektes das Erreichen der ersten Ausbaustufe ist.
Daher ist zu erwarten, dass ein Großteil des Funktionsumfang noch nicht erreicht wurde. Deshalb hilft dieser Report dabei,
den Entwicklungsstand des Coasterbots zu verfolgen.

\subsection{Definition der Maturity-Level}\label{definition-der-maturity-level}
Im Lastenheft sind folgende Maturity-Level definiert:

\textbf{Maturity Level 1 -- Prototyp}

Nachweis der autonomen Navigation, Lokalisierung, sicheren Bewegung
sowie der Aufnahme und Ausgabe von Getränkeuntersetzern.

\textbf{Maturity Level 2 -- Erweiterter Funktionsumfang}

Erweiterung um Funktionen zur Energieverwaltung sowie zur
automatisierten Tischreinigung.

\textbf{Maturity Level 3 -- Servicefunktionen}

Integration von Funktionen zur digitalen Bestellaufnahme und
Unterstützung von Bezahlvorgängen.

\textbf{Maturity Level 4 -- Mensch-Roboter-Interaktion}

Erweiterung der Interaktion zwischen Gästen und Roboter, beispielsweise
durch personenbezogene Zuordnung von Anfragen oder individuelle
Statuskommunikation.

\textbf{Maturity Level 5 -- Getränketransport}

Erweiterung des Systems um den sicheren autonomen Transport kompletter
Getränke unter Berücksichtigung der fahrdynamischen Anforderungen.

\section{Maturityreport}\label{maturityreport}
% Farben definieren (optional)
\definecolor{greybg}{HTML}{EFEFEF}

% **************************************
\sloppy % Behebt Overfull HBox Warnungen durch Flexibilität bei Abständen
\begin{longtable}{@{}p{6cm}|p{1cm}p{1cm}p{1cm}p{1cm}p{1cm}@{}|ccccc@{}}
\caption{Maturity Level Übersicht} \\
\toprule
& \multicolumn{5}{c}{\centering Maturity Level} \\
\midrule[1pt] % Dicke Linie unter dem Header

Funktion & M1 & M2 & M3 & M4 & M5 \\
\toprule
\endfirsthead

% --- KEINE CONTINUED FROM PREVIOUS PAGE ZEILE mehr, um die Warnungen zu vermeiden ---
\endhead

% --- Der eigentliche Inhalt der Tabelle (Daten) ---

Autonome Navigation & \centering\textbf{(X)} & &  &  &  \\
\toprule

Lokalisierung der Untersetzer & \centering\textbf{(X)} &  &  &  &  \\
\toprule

Aufnahme von Untersetzer & \centering\textbf{X} &  &  &  &  \\
\toprule

Ausgabe von Untersetzer & \centering\textbf{X} &  &  &  &  \\
\toprule

Energieverwaltung & \cellcolor{greybg} \centering\textbf{(X)} &  &  &  &  \\
\toprule

Sicherheit & \centering\textbf{X} &  &  &  &  \\
\toprule

Systemüberwachung & \centering\textbf{X} &  &  &  &  \\
\toprule

Tischreinigung & \cellcolor{greybg} &  &  &  &  \\
\toprule

Digitale Bestellaufnahme & \cellcolor[HTML]{EFEFEF} & \cellcolor[HTML]{EFEFEF} &  &  &  \\
\toprule

Unterstützung bei Bezahlvorgängen & \cellcolor[HTML]{EFEFEF} & \cellcolor[HTML]{EFEFEF} &  &  &  \\
\toprule

Statusabfragen durch Benutzer & \cellcolor[HTML]{EFEFEF} & \cellcolor[HTML]{EFEFEF} & \cellcolor[HTML]{EFEFEF} &  &  \\
\toprule

% Benutzerzentrierte Entertainmentfunktionen & \cellcolor[HTML]{EFEFEF} & \cellcolor[HTML]{EFEFEF} & \cellcolor[HTML]{EFEFEF} &  &  \\
\toprule

Erweiterte Mensch-Roboter-Interaktion & \cellcolor[HTML]{EFEFEF} & \cellcolor[HTML]{EFEFEF} & \cellcolor[HTML]{EFEFEF} &  &  \\
\toprule

Transport von Getränken & \cellcolor[HTML]{EFEFEF} & \cellcolor[HTML]{EFEFEF} & \cellcolor[HTML]{EFEFEF} & \cellcolor[HTML]{EFEFEF} &  \\
\toprule

Verschüttungssicherung beim Transport von Getränken & \cellcolor[HTML]{EFEFEF} & \cellcolor[HTML]{EFEFEF} & \cellcolor[HTML]{EFEFEF} & \cellcolor[HTML]{EFEFEF} &  \\
\bottomrule % Abschlusslinie

\end{longtable}

\newpage

\subsection{Anmerkungen zu Maturity Level 1}\label{anmerkungen}
\begin{itemize}
\item \textbf{Autonome Navigation (NAV-001/002/006/007/008/009/010, CST-002):} Die autonome Navigation wurde erfolgreich implementiert und getestet. Der Coasterbot kann sich selbstständig in der Umgebung bewegen und Hindernissen ausweichen. Zur Positionsbestimmung und Orientierung des Roboters werden aus Radencoder und Gyroskop bestimmt. Dies ermöglicht die Wegpunktnavigation. Jedoch gibt es Verbesserungsbedarf hinsichtlich der Genauigkeit.
\item \textbf{Lokalisierung der Untersetzer (NAV-008):} Die Lokalisierung der Untersetzer erfolgt durch festgelegte Koordinaten. Hier besteht Verbesserungsbedarf.
\item \textbf{Aufnahme von Untersetzern (CST-001/006):} Die Mechanismen zur Aufnahme von Untersetzern funktionieren. Hier sollte jedoch in zukünftigen Versionen eine Erkennung auf Vorhandensein eines Coasters implementiert werden.
\item \textbf{Ausgabe von Untersetzern (CST-003/005):} Die Mechanismen zur Ausgabe von Untersetzern funktionieren. Untersetzer werden jedoch mehr ausgeworfen als positioniert.
\item \textbf{Energieverwaltung:} Die Energie wird über eine wiederaufladbare Batterie bereitgestellt. Eine automatische Energieverwaltung ist noch nicht implementiert. Jedoch kann über ein Entlademodell und der eingebauten LED, eine grobe Ladezustandsüberwachung implementiert werden.
\item \textbf{Sicherheit (SAF-001/003, NAV-003/004):} Der Coasterbot hält bei beim Erkennen einer Tischkante selbstständig an. Ein Not-Aus, bzw. Reset ist über den Bedientaster möglich.
\item \textbf{Systemüberwachung (MON-001/003):} Sensor- und Bewegungsmetriken werden gelogged, Fehler werden erkannt und über die Status-LED sowie eine Konsolenausgabe angezeigt. Die Ausgabe erfolgt über die serielle Schnittstelle.
\end{itemize}

\newpage
\section{Fazit}\label{fazit}
Der Coasterbot erfüllt die Mindestanforderungen für das verfolgte Maturity-Level 1 teilweise.
Die Kernfunktionen sind abgedeckt, jedoch sind Verbesserungsbedarf identifiziert. Hierunter fallen die Optimierung der Genauigkeit der Navigation, eine genauere Lokalisierung und eine Positionierung der Untersetzer.
Diese Verbesserungen sollten in zukünftigen Versionen berücksichtigt werden.

Zur Optimierung der Navigation sollten Alternative Sensoren getestet werden. Die Tolaranzen des verwendeten Sensors führen zu einem aufsummierten Fehler, der die Navigation ungenau macht.

Um die Lokalisierung der Untersetzer zu verbessern, sollte der Einsatz von Kameras oder anderen Sensoren in Betracht gezogen werden, um die Position der Untersetzer genauer zu bestimmen. Weiterhin sollten Sensoren vorgesehen werden, die die Anwesenheit von Untersetzern unterhalb der Aufnahme prüft.

Zur Verbesserung der Positionierung der Untersetzer sollte die Ausgabemechanik überdacht und Alternative Konzepte geprüft werden.
\end{document}
