Project-CoasterBot/coasterbot/M6_Projekträsentation/Vorlagen_WBH.md

# Vorlagen der WBH

[Hier sind Vorlagen zu finden](https://www.wb-online-campus.de/infoseiten/public/infobereich/wam.html?display=main&fromHistory=1)
