Project-CoasterBot/coasterbot/M0/2026_coasterbot_m0.tex

%\documentclass[manuscript]{acmart}
%\documentclass[acmsmall]{acmart}
%\settopmatter{printacmref=false}

\documentclass[
  a4paper,
  12pt,
  DIV=12,        % höherer Wert = schmalere Ränder, weniger Whitespacmi
  parskip=half,  % Absätze mit halbem Abstand statt Einzug
  headings=small % kleinere Überschriften, weniger vertikaler Abstand
]{scrartcl}

%\documentclass[a4paper,11pt]{scrartcl}
%\documentclass[a4paper,11pt]{report}
%\documentclass[a4paper,12pt]{book}
\usepackage[utf8]{inputenc}
\usepackage[german]{babel}
\usepackage[T1]{fontenc}
\usepackage{lmodern}
\usepackage[inkscapelatex=false]{svg}
% Texte im SVG von Inkscape setzen lassen, nicht durch die Dokumentschrift ersetzen
\svgsetup{inkscapelatex=false}
\usepackage{amsmath}
\usepackage{caption}
\usepackage{gensymb}
\usepackage{microtype}
\usepackage{longtable}
\usepackage{tabularx}   % Spalten, die die restliche Zeilenbreite auffüllen (X-Spalte)
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
%  output/.style   = {coordinate} % Output
%}
% Defining string as labels of certain blocks.
%\newcommand{\suma}{\Large$+$}
%\newcommand{\multa}{\Large$\times$}
%\newcommand{\inte}{$\displaystyle \int$}
%\newcommand{\derv}{\huge$\frac{d}{dt}$}

\usetikzlibrary{arrows,automata,positioning}
%\usepackage{automata}

%%% END TIKZ

\usepackage[section]{placeins}

\usepackage{textcomp}

\usepackage{listings}
\usepackage{verbatimbox}

\usepackage{bold-extra}

\usepackage{framed}

%\usepackage{fancyhdr}
%\pagestyle{fancy}
%\lhead{\leftmark}
%\chead{}
%\rhead{}
%\lfoot{}
%\cfoot{\thepage}
%\rfoot{}
%\renewcommand{\headrulewidth}{0.2pt}
%\renewcommand{\footrulewidth}{0.2pt}

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

\definecolor{mGreen}{rgb}{0,0.6,0}
\definecolor{mGray}{rgb}{0.5,0.5,0.5}
\definecolor{mPurple}{rgb}{0.58,0,0.82}
\definecolor{backgroundColour}{rgb}{0.95,0.95,0.92}

\lstdefinestyle{CStyle}{
    backgroundcolor=\color{backgroundColour},
    commentstyle=\color{mGreen},
    keywordstyle=\color{magenta},
    numberstyle=\tiny\color{mGray},
    stringstyle=\color{mPurple},
    basicstyle=\footnotesize,
    breakatwhitespace=false,
    breaklines=true,
    captionpos=b,
    keepspaces=true,
    numbers=left,
    numbersep=5pt,
    showspaces=false,
    showstringspaces=false,
    showtabs=false,
    tabsize=2,
    language=C
}

\lstdefinelanguage{VHDL}{
  morekeywords=[1]{library,use,all,entity,is,port,in,out,end,architecture,of,begin,process,if,then,else,elsif,when,others,signal,variable,wait,for,loop},
  morecomment=[l]--,
  morestring=[b]",
  sensitive=true
}

\lstset{
  language=VHDL,
  basicstyle=\ttfamily\small,
  keywordstyle=\color{blue},
  commentstyle=\color{gray},
  stringstyle=\color{red},
  numbers=left,
  numberstyle=\tiny,
  stepnumber=1,
  numbersep=8pt,
  frame=single,
  breaklines=true,
  captionpos=b
}

\lstset{numbers=none}

%\newcounter{example}
%\renewcommand{\theexample}{\thesection.\arabic{example}}

% Default fixed font does not support bold face
\DeclareFixedFont{\ttb}{T1}{txtt}{bx}{n}{12} % for bold
\DeclareFixedFont{\ttm}{T1}{txtt}{m}{n}{12}  % for normal

% Custom colors
\usepackage{color}
\definecolor{deepblue}{rgb}{0,0,0.5}
\definecolor{deepred}{rgb}{0.6,0,0}
\definecolor{deepgreen}{rgb}{0,0.5,0}

\usepackage{listings}

% Python style for highlighting
\newcommand\pythonstyle{\lstset{
language=Python,
basicstyle=\ttm,
morekeywords={self},              % Add keywords here
keywordstyle=\ttb\color{deepblue},
emph={MyClass,__init__},          % Custom highlighting
emphstyle=\ttb\color{deepred},    % Custom highlighting style
stringstyle=\color{deepgreen},
frame=tb,                         % Any extra options here
showstringspaces=false
}}

% Python environment
\lstnewenvironment{python}[1][]
{
\pythonstyle
\lstset{#1}
}
{}

% Python for external files
\newcommand\pythonexternal[2][]{{
\pythonstyle
\lstinputlisting[#1]{#2}}}

% Python for inline
\newcommand\pythoninline[1]{{\pythonstyle\lstinline!#1!}}

\nocite{*}

\begin{document}
%\pagenumbering{roman}

\title{Coasterbot}
\subtitle{Phasenpaper M0}
\author{Gereon Such}
%\email{gereonsuch@suchdsp.com}
%\affiliation{
%  \institution{Wilhelm Büchner University of Applied Sciences}
%  \department{Computer Engineering}
%  \city{Hof}
%  \country{Germany}
%}

\begin{titlepage}
  \begin{center}
    {\large Wilhelm Büchner University of Applied Sciences} \\[0.3em]

    {\normalsize Projektseminar Master}
\vspace{5em}

    {\LARGE\bfseries Coasterbot} \\[0.5em]

    {\large Phasenpaper M0} \\[1em]

    {} \\[1em]

\vspace{4em}

    {\normalsize
\begin{tabular}{ll}
Dennis Borutta, B. Eng & dennis.borutta@outlook.com\\
Stefan Etringer, B. Eng & mail@stefan.works\\
Gereon Such, M. Sc. & gereonsuch@gmail.com\\
\end{tabular}
    }
  \end{center}

\end{titlepage}

% einleitung preambel etc.

% Versionshistorie des Dokuments -- eigene Seite direkt nach dem Titelblatt
\section*{Versionshistorie}

\begin{tabularx}{\textwidth}{@{}clp{2.6cm}X@{}}
\toprule
\textbf{Version} & \textbf{Datum} & \textbf{Bearbeiter} & \textbf{Änderungen}\\
\midrule
1 & 20.07.2026 & Such & Erstfassung des Phasenpapiers M0\\
2 & 21.07.2026 & Etringer & Literaturrecherche zu Algorithmen ergänzt\\
3 & 21.07.2026 & Borutta, Such & Literaturrecherche und Einleitungstext ergänzt; Coasterbot-Abbildung eingefügt; Timeline und Projektzeitraum angepasst\\
4 & 22.07.2026 & Such & Versionshistorie ergänzt\\
5 & 23.07.2026 & Borutta & Projektsteckbrief in Tabelle umgewandelt. Dokumentenstruktur angepasst.\\
6 & 24.07.2026 & Etringer & Links und Referenzen klickbar,
  Rechtschreibfehler, Change: - to emdash bei einem Satz, hyperlink zu unserem
  Notion and git repo hinzugefügt, fehlende Kurzreferenz für Handbook of
  Robotics hinzugefügt, Leerzeichen aus in gctronic.com URL entfernt,
  Encodingfehler mit den tiefen Anführungszeichen vor Introduction to
  Algorithms Namen gelöst, Linting \\
7 & 25.07.2026 & Such & Graphen aktualisiert \\
8 & 25.07.2026 & Such, Borutta, Etringer & Überschrift Anhang, anpassen der Tabelle im Anhang\\
9 & 25.07.2026 & Such & Vorgangstabelle eingefügt\\
10 & 30.07.2026 & Etringer & Erweiterung der Out-of-Scope Tabelle nach Absprache in M0, Literaturrecherche als Kapitel und im Anhang hinzugefügt\\
\bottomrule
\end{tabularx}

\newpage

\tableofcontents

\newpage

\section{Projektübersicht}

\begin{longtable}{@{}p{0.3\textwidth}p{0.7\textwidth}@{}}
\toprule
\textbf{Kategorie} & \textbf{Inhalt} \\
\midrule
\endfirsthead
\toprule
\textbf{Kategorie} & \textbf{Inhalt} \\
\midrule
\endhead

Projektname & Coasterbot -- Entwicklung eines Prototyps \\
\midrule

Projektzeitraum & Beginn: \textbf{15.07.2026} \quad | \quad Abschluss: \textbf{07.11.2026}\\
\midrule

Projektziel & Entwicklung eines Prototyps eines Coasterbots: ein handtellergro{\ss}er Roboter, der selbstst\"andig auf einem Tisch navigiert, dort Getr\"ankeuntersetzer in Richtung von Personen ausgibt und diese automatisiert wieder aufnimmt. \\
\midrule

Weitere Ausbaustufen (Nicht im Fokus) & Automatisierte Tischreinigung, Aufnahme von Bestellungen, Initialisierung von Bezahlvorg\"angen \\
\midrule

Motivation / Nutzen &
\vspace{-\baselineskip}
\begin{itemize}[partopsep=0pt, topsep=6pt, itemsep=2pt]
  \item Entlastung des Bedienpersonals durch reduzierten Aufgabenbereich unterstützt damit den de seit Jahren bestehenden Fachkräftemangels in der Gastronomie~\cite{DEHOGA2025Q4}
  \item Alleinstellungsmerkmal und zusätzliches Attraktivitätsmerkmal f\"ur Bars/Restaurants
  \item Potenziell mehr positive Bewertungen und verbesserte Online-Pr\"asenz und damit Positiver Einfluss auf den Umsatz (Online-Pr\"asenz als zunehmend relevanter Faktor bei der Restaurantwahl)~\cite{BibEntry2026Jul}
\end{itemize} \\
\midrule

Definition of Done &
\vspace{-\baselineskip}
\begin{itemize}[partopsep=0pt, topsep=6pt, itemsep=2pt]
  \item STL-Dateien und Schaltpl\"ane zur Fertigung eines Prototypen sind fertiggestellt
  \item Softwarearchitektur und -komponenten sind ausgearbeitet
  \item Eine Simulation des Programmablaufes ist erstellt und validiert
  \item Tests, die sich aus den Anforderungen ergeben, sind identifiziert und definiert
\end{itemize} \\
\midrule

Out of Scope &
\vspace{-\baselineskip}
\begin{itemize}[partopsep=0pt, topsep=6pt, itemsep=2pt]
  \item EMV-Betrachtungen
  \item Kartierung oder dauerhafte Modellierung der Umgebung
  \item Einbindung in ein Netzwerk oder Cloud-Dienste
  \item Marketing- und Wirtschaftlichkeitskonzepte
  \item Schwarmverhalten mehrerer Coasterbots
  \item Automatisierte Tischreinigung
  \item Automatisierter Austausch der Coaster
  \item Getränketransport als Primärfunktion des Systems
  \item Betrieb mit aufladbarem Akkumulator
\end{itemize} \\
\bottomrule

\end{longtable}

\section{Projektorganisation}

Das Projektteam besteht aus den drei Mitgliedern

\begin{center}
\begin{tabular}{lll}
Dennis Burutta & Leiter/Mitglied & dennis.borutta@outlook.com\\
Stefan Etringer & Admin/Mitglied & mail@stefan.works \\
Gereon Such & Mitglied & gereonsuch@gmail.com\\
\end{tabular}
\end{center}

Für die Projektorganisation und dokumentenbasierte Kommunikation im Team wird
das Tool Notion \url{https://app.notion.com} genutzt. In diesem werden
\href{https://app.notion.com/p/Projektarbeit-39a745ea234f80d4b39ace9b616a41de}{Projektphasen,Arbeitspakete, Fortschritt, Ergebnisse sowie Meilensteine}
protokolliert.
Notion bietet hier vielfältige Planungsmöglichkeiten sowie Visualisierungen
dazu. Eine Besonderheit dabei ist, dass Notion die Möglichkeit bietet
kollaborativ an Dokumenten zu arbeiten und diese direkt an Arbeitspaketen zu
knüpfen. So können die Arbeitsergbnisse und Referenzen strukturiert abgelegt
werden.

Entwicklungsrelevante Dateien wie Source Code, CAD-Dateien für das Chassis oder Schaltungen werden in einem \href{https://github.com/Project-CoasterBot/coasterbot}{gemeinsamen Git Repository} abgelegt. % ich lasse hier einfach offen wo und wie, ob github oder gitlab oder whatever...

Zur Remote Kommunikation wird eine Kombination aus Instant Messaging für kurzfristige Information und Absprachen sowie regelmäßigen Videocalls mit dem Tool Alfaview \url{https://alfaview.com} genutzt.

\section{Projektplanung}

Mit Hilfe der Tools Draw.io und Notion wird im Team die Projektplanung durchgeführt. Hierzu wird zur Ermittlung notwendiger Teilaufgaben und Arbeitspakete die Kreativmethode der Mind-Map angewandt. Daraus ergibt sich der Projektstrukturplan mit Arbeitspaketen. Aus diesem wird anschließend eine Vorgangsliste in ProjectLibre erstellt, die in einem Netzplan überführt wird. Mit Hilfe des Netzplanes wird anschließend ein detaillierter Zeitplan in Notion erstellt.

\subsection{Projektstruktur}
Zur weiteren Bestimmung von erforderlichen Teilaufgaben und Arbeitspaketen wurde die Kreativmethode der Mind-Map angewandt. Die Ergebnisse hierzu sind in Abbildung~\ref{arbeitspaketemindmap} zu sehen. Daraus ergibt sich der Projektstrukturplan mit Arbeitspaketen wie in Abbildung~\ref{projektstrukturplan} gezeigt. Hierbei wird ersichtlich, dass der Strang ``Organisation''   aus der Mind-Map nicht in dem Projektstrukturplan zu sehen ist. Dies wird begründet, da es sich dabei um fortlaufende Aufgaben handelt, die über die gesamte Projektlaufzeit hinweggeführt werden.

\begin{figure}[htbp]
  \centering
  \includesvg[scale=0.4]{MindMap.svg}
  \caption{Mindmap zur Projektstruktur}\label{arbeitspaketemindmap}
\end{figure}

\begin{figure}[htbp]
  \centering
  \includesvg[scale=0.45]{Projektstrukturplan.svg}
  \caption{Projektstrukturplan}\label{projektstrukturplan}
\end{figure}

\newpage
\subsection{Netzplan}
Mit dem Zeithorizont von 4 Monaten ergibt sich mit Gewichtung der jeweiligen Arbeitspakete nach Aufwand und Priorität der in Abbildung~\ref{fig:netzplan} dargestellte Netzplan nach DIN 69900. Aufgrund seiner Breite ist dieser auf einer eigenen Seite im Querformat abgebildet. Folgende Tabelle aus ProjectLibre wurde als Grundlage für den Graphen genutzt, die Graphik selbst per LLM aus der Tabelle erstellt.

\begin{tabularx}{\textwidth}{cX@{}ccccccc}
\toprule
\footnotesize
\textbf{ID} & \footnotesize\textbf{Arbeitspaket} & \footnotesize\textbf{Dauer} & \footnotesize\textbf{FAZ} & \footnotesize\textbf{FEZ} & \footnotesize\textbf{SAZ} & \footnotesize\textbf{SEZ} & \footnotesize\textbf{Kritisch}\\
\midrule
\footnotesize 1001 & \footnotesize Steckbrief\-definition &	\footnotesize 1 &	\footnotesize 15.07.26 & \footnotesize 15.07.26	 & \footnotesize 09.10.26	 & \footnotesize 09.10.26 & 	 \footnotesize 	nein \\
\footnotesize 1002	 & \footnotesize Projekt\-organisation und Planung & 	\footnotesize 4	 & \footnotesize 16.07.26	 & \footnotesize 19.07.26	 & \footnotesize 10.10.26	 & \footnotesize 13.10.26	& \footnotesize nein \\
\footnotesize 1010	 & \footnotesize Algorithmik recherchieren & 	\footnotesize 8	 & \footnotesize 15.07.26	 & \footnotesize 22.07.26	 & \footnotesize 15.07.26	 & \footnotesize 22.07.26	 & 	\footnotesize ja \\
\footnotesize 1020 & \footnotesize Marktsichtung durchführen & \footnotesize 	8	 & \footnotesize 15.07.26	 & \footnotesize 22.07.26 & \footnotesize 	15.07.26 & \footnotesize 	22.07.26 &  \footnotesize ja \\
\footnotesize 1030	 & \footnotesize Stand zu Mobile Robotik recherchieren	 & \footnotesize 8	 & \footnotesize 15.07.26	 & \footnotesize 22.07.26	 & \footnotesize 15.07.26	 & \footnotesize 22.07.26	 & \footnotesize ja\\
\footnotesize 101	 & \footnotesize Dokumente zusammentragen	 & \footnotesize 3	 & \footnotesize 23.07.26 & \footnotesize 	25.07.26	 & \footnotesize 14.10.26 & \footnotesize 	16.10.26	 & \footnotesize nein \\
\footnotesize 2010	 & \footnotesize Anwendungsfälle definieren	 & \footnotesize 3	 & \footnotesize 23.07.26	 & \footnotesize 25.07.26 & \footnotesize 	23.07.26	 & \footnotesize 25.07.26	 & \footnotesize 	ja \\
\footnotesize 2020 & \footnotesize 	Maturity Level definieren	 & \footnotesize 4 & \footnotesize 	26.07.26 & \footnotesize 	29.07.26	 & \footnotesize 26.07.26	 & \footnotesize 29.07.26	  & \footnotesize ja \\
\footnotesize 2030 & \footnotesize 	Lastenheft erstellen	 & \footnotesize 7 & \footnotesize 	30.07.26 & \footnotesize 	05.08.26	 & \footnotesize 30.07.26	 & \footnotesize 05.08.26	  & \footnotesize ja\\
\footnotesize 3010 & \footnotesize 	Testfälle definieren	 & \footnotesize 5	 & \footnotesize 06.08.26	 & \footnotesize 10.08.26 & \footnotesize 10.08.26 & \footnotesize 14.08.26 & \footnotesize nein \\
\footnotesize 3020 & \footnotesize Sensorik/Aktorik auswählen & \footnotesize 5 & \footnotesize 06.08.26 & \footnotesize 10.08.26 & \footnotesize 06.08.26 & \footnotesize 10.08.26 & \footnotesize ja \\
\footnotesize 3030 & \footnotesize Softwarearchitektur erarbeiten & \footnotesize 5 & \footnotesize 06.08.26 & \footnotesize 10.08.26 & \footnotesize 10.08.26 & \footnotesize 14.08.26 & \footnotesize nein \\
\footnotesize 3040 & \footnotesize Kostenkalkulation durchführen & \footnotesize 4 & \footnotesize 11.08.26 & \footnotesize 14.08.26 & \footnotesize 11.08.26 & \footnotesize 14.08.26 & \footnotesize ja \\
\footnotesize 3050 & \footnotesize Pflichtenheft erstellen & \footnotesize 8 & \footnotesize 15.08.26 & \footnotesize 22.08.26 & \footnotesize 15.08.26 & \footnotesize 22.08.26 & \footnotesize ja \\
\footnotesize 201 & \footnotesize Dokumente zusammentragen & \footnotesize 2 & \footnotesize 23.08.26 & \footnotesize 24.08.26 & \footnotesize 15.10.26 & \footnotesize 16.10.26 &  \footnotesize nein \\
\footnotesize 4010 & \footnotesize Bauteile beschaffen & \footnotesize 14 & \footnotesize 23.08.26 & \footnotesize 05.09.26 & \footnotesize 24.08.26 & \footnotesize 06.09.26 & \footnotesize nein \\
\footnotesize 4020 & \footnotesize Softwaretest erstellen & \footnotesize 10 & \footnotesize 23.08.26 & \footnotesize 01.09.26 & \footnotesize 23.08.26 & \footnotesize 01.09.26 & \footnotesize ja \\
\footnotesize 4030 & \footnotesize Software implementieren & \footnotesize 15 & \footnotesize 02.09.26 & \footnotesize 16.09.26 & \footnotesize 02.09.26 & \footnotesize 16.09.26 & \footnotesize ja \\
\footnotesize 4040 & \footnotesize Prototyp aufbauen & \footnotesize 10 & \footnotesize 06.09.26 & \footnotesize 15.09.26 & \footnotesize 07.09.26 & \footnotesize 16.09.26 & \footnotesize nein \\
\footnotesize 5000 & \footnotesize Test durchführen & \footnotesize 8 & \footnotesize 17.09.26 & \footnotesize 24.09.26 & \footnotesize 17.09.26 & \footnotesize 24.09.26 & \footnotesize ja \\
\footnotesize 6000 & \footnotesize Maturity Level feststellen & \footnotesize 5 & \footnotesize 25.09.26 & \footnotesize 29.09.26 & \footnotesize 25.09.26 & \footnotesize 29.09.26 & \footnotesize ja \\
\footnotesize 301 & \footnotesize Dokumente zusammentragen & \footnotesize 3 & \footnotesize 30.09.26 & \footnotesize 02.10.26 & \footnotesize 30.09.26 & \footnotesize 02.10.26 & \footnotesize ja \\
\footnotesize 401 & \footnotesize Endbericht erstellen und abgeben & \footnotesize 6 & \footnotesize 03.10.26 & \footnotesize 08.10.26 & \footnotesize 03.10.26 & \footnotesize 08.10.26 & \footnotesize ja \\
\footnotesize 7000 & \footnotesize Präsentation ausarbeiten & \footnotesize 8 & \footnotesize 09.10.26 & \footnotesize 16.10.26 & \footnotesize 09.10.26 & \footnotesize 16.10.26 & \footnotesize ja \\

\bottomrule
\end{tabularx}

\begin{landscape}
\thispagestyle{empty}   % keine Seitenzahl, Plan darf bis an den Papierrand
\null\vfill
% Auf dem Papier zentrieren, nicht im Satzspiegel: in der gedrehten Achse liegt
% der Satzspiegel nicht mittig (vorn 1in+topmargin+headheight+headsep, hinten Rest).
% Ausgleich = halbe Differenz der beiden Raender; die 3.8pt gleichen den
% asymmetrischen Weissraum im SVG selbst aus (viewBox: links 70, rechts 40).
% (in der landscape-Umgebung ist \linewidth die Ausdehnung entlang dieser Achse)
\noindent\hspace*{\dimexpr1in + \topmargin + \headheight + \headsep
                  - (\paperheight-\linewidth)/2 - 3.8pt\relax}%
\makebox[\linewidth]{%
  \begin{minipage}{\dimexpr\paperheight-2.4cm\relax}
    \centering
    \includesvg[width=\linewidth]{Coasterbot_Netzplan_v4.svg}
    \captionof{figure}{Netzplan}
\label{fig:netzplan}
  \end{minipage}}
\vfill
\end{landscape}

\begin{landscape}
\subsection{Zeitplan}
Mit Hilfe des Netzplanes wird der Zeitplan detailliert. Dieser ist in Abbildung \ref{fig:notiontimeline_full} reduziert abgebildet.

%\thispagestyle{empty}   % keine Seitenzahl, Plan darf bis an den Papierrand
%\null\vfill

% Auf dem Papier zentrieren, nicht im Satzspiegel: in der gedrehten Achse liegt
% der Satzspiegel nicht mittig (vorn 1in+topmargin+headheight+headsep, hinten Rest).
% Ausgleich = halbe Differenz der beiden Raender; die 3.8pt gleichen den
% asymmetrischen Weissraum im SVG selbst aus (viewBox: links 70, rechts 40).
% (in der landscape-Umgebung ist \linewidth die Ausdehnung entlang dieser Achse)
\noindent\hspace*{\dimexpr1in + \topmargin + \headheight + \headsep
                  - (\paperheight-\linewidth)/2 - 3.8pt\relax}%
\makebox[\linewidth]{%
  \begin{minipage}{\dimexpr\paperheight-2.4cm\relax}
    \centering
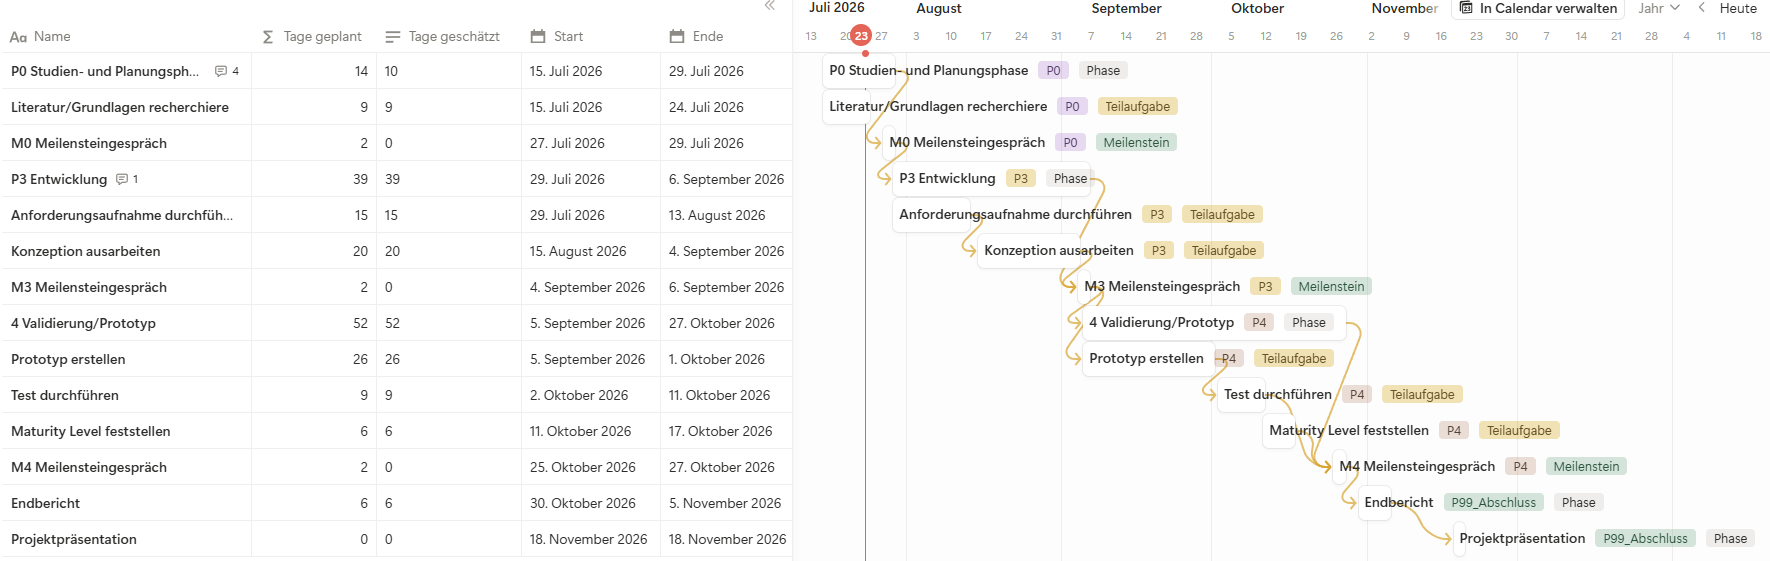
[picture p40: M0/notion_proj_final.png]
    
    \captionof{figure}{Zeitplan}
    \label{fig:notiontimeline_full}
  \end{minipage}}
\vfill
\end{landscape}

\section{Stand der Forschung}

\subsection{Systematische Literatur Recherche}

Eine Systematische Literatur Recherche (SLR) wurde als methodologische Grundlage für die wissenschaftliche Betrachtung der für den Coasterbot nötigen Bestandteile durchgeführt.

Diese Fragen wurden für die SLR formuliert:

\begin{itemize}
  \item Welche Algorithmen zur Pfadfindung werden in mobilen IoT‑Geräten mit
    Abstandssensoren eingesetzt, um Kollisionen zu vermeiden?
  \item „Welche Algorithmen und Architekturen werden eingesetzt, um
    Inertialnavigation auf IoT‑Geräten mit begrenzten Ressourcen zu
    realisieren?“
  \item „Wie werden Inertialsensoren (IMU: Beschleunigungssensor, Gyroskop,
    ggf. Magnetometer) mit anderen Sensoren (z.B. GPS, Kamera, UWB) für robuste
    Navigation in IoT‑Systemen kombiniert?“
\end{itemize}

Diese Bestandteile der SLR wurden in die Kategorien „Mobile Roboter“ und
„Algorithmen“ eingeteilt.

Die Suche erfolgte neben IEEE Explore in frei zugänglichen Quellen (Google
Scholar, arXiv) aufgrund fehlender Zugänge zu lizenzierten Datenbanken wie
Scopus oder ACM Digital Library. Preprints aus arXiv wurden nur berücksichtigt,
wenn sie eine klar beschriebene Methodik und Evaluierung aufwiesen oder bereits
als Journal‑/Konferenzversion erschienen waren. Suchanfragen inklusive Link
befinden sich im Anhang.

\subsection{Recherche: Mobile Roboter}
Das Feld der mobilen Roboter ist bereits weit erforscht und es lassen sich eine Vielzahl an Arbeiten finden, die unterschiedliche Ansätze und Lösungen für die Navigation, Manipulation und Interaktion von Robotern in verschiedenen Umgebungen präsentieren. Eine übersichtliche Zusammenfassung relevanter Arbeiten ist in der Tabelle~\ref{tab:literaturrecherche-coasterbot} im Anhang dargestellt. Diese Tabelle enthält Informationen zu den jeweiligen Roboter-Projekten. Diese werden als Grundlage zur Bauteilauswahl und Softwarearchitektur des Coasterbots dienen. Insbesondere die Arbeit von~\cite{Balbuena2026Mar} kann als Grundlage dienen, da hier mehrere mobile Roboter Varianten vorgestellt und mit fertigen Stücklisten und CAD-Dateien veröffentlicht wurden. Damit bieten diese Arbeiten eine gute Grundlage für die Entwicklung des Coasterbots, so dass sich das Team auf die Softwarearchitektur, die Navigation des Roboters und die Hauptfunktion \textemdash~das Ablegen und Aufnehmen von Getränkeuntersetzer \textemdash~konzentrieren kann.

\subsection{Recherche: Algorithmen}

\subsubsection{Klassische Graphalgorithmen}

Die Grundlage vieler Verfahren zur autonomen Navigation bilden klassische
Graphalgorithmen. Dabei wird die Umgebung als Graph modelliert, dessen Knoten
diskrete Positionen oder Zustände repräsentieren, während Kanten mögliche
Bewegungen zwischen diesen beschreiben. Ziel ist die Bestimmung eines optimalen
Pfades hinsichtlich einer Kostenfunktion, beispielsweise der zurückgelegten
Distanz, Fahrzeit oder des Energieverbrauchs.

Ein Vertreter ist der Dijkstra-Algorithmus, der den kürzesten Pfad in Graphen
mit Kantengewichten berechnet. Der Algorithmus garantiert optimale Lösungen
insofern die Kantengewichte nicht-negativ sind und
stellt ein Referenzverfahren für die globale Pfadplanung in statischen
Umgebungen dar~\cite{Dijkstra}. Seine mathematische Grundlage sowie Laufzeitanalyse werden
ausführlich in „Introduction to Algorithms“ von Cornet et al.\ beschrieben~\cite{IntroToAlgs}.

Neben Dijkstra existieren weitere grundlegende Suchverfahren, wie die
Breitensuche (Breadth-First Search) und Tiefensuche (Depth-First Search,
DFS)~\cite{IntroToAlgs}.
Während BFS optimale Lösungen in ungewichteten Graphen liefert, dient DFS vor
allem der Strukturanalyse von Graphen und spielt in der Roboternavigation eine
untergeordnete Rolle.

Für Anwendungen mit einer vollständig bekannten und statischen Umgebung stellen
diese Algorithmen eine zuverlässige Grundlage der globalen Pfadplanung dar.

\subsubsection{Heuristische Verfahren}

Da klassische Graphalgorithmen bei großen Suchräumen einen hohen Rechenaufwand
verursachen, werden in der mobilen Robotik häufig heuristische Suchverfahren
eingesetzt. Ein bedeutendes Verfahren ist der heusristische A* Algorithmus, um
die Suche gezielt in Richtung des Zielknotens zu lenken~\cite{IntroToAlgs,AStar}.

Die Bewertung eines Knotens erfolgt über

\begin{equation}
f\left(n\right) = g\left(n\right) + h\left(n\right)
\end{equation}
%$$
%f(n) = g(n)+h(n)
%$$

Hierbei stellen $g(n)$ die wirklichen Kosten eines optimalen Pfades $s$ nach
$n$ und $h(n)$ die wirklichen Kosten eines optimalen Pfades von $n$ zu einem
präferierten Zielknoten von $n$ darstellt. Allgemein ist $h(n)$ eine Schätzung
der verbleibenden Distanz zum Ziel~\cite{AStar}. Ist die Heuristik zulässig (admissible),
garantiert A* ebenfalls optimale Lösungen, untersucht jedoch weniger Knoten als
Dijkstra.

Für mobile Roboter kommen häufig euklidische oder Manhattan-Distanzen~\cite{IntroToAlgs} als
Heuristik zum Einsatz. Dadurch eignet sich A* insbesondere für Gitternetze
(Occupancy Grids), wie sie in der Robotik genutzt werden\cite{RoboticMapping}.

Aktuellere Varianten wie Weighted A* oder Anytime A* priorisieren kürzere
Rechenzeiten gegenüber der optimalen Lösung, weshalb deren Anwendung geeignet in
Echtzeitsystemen ist\cite{WeightedA,AnytimeA}.

\subsubsection{Dynamische Pfadplanung}

In realen Einsatzgebieten verändert sich die Umgebung häufig während der Fahrt.
Statische Algorithmen müssten den gesamten Pfad erneut berechnen. Dies führt zu
hohen Rechenzeiten.

Hier setzen Verfahren der dynamischen Pfadplanung an. Zu nennen sind unter
anderem D* (Dynamic A*)~\cite{DAlg} sowie dessen Weiterentwicklung D* Lite~\cite{DLite}. Beide
Verfahren aktualisieren ausschließlich die von einer Umweltveränderung
betroffenen Bereiche des Suchgraphen und vermeiden dadurch vollständige
Neuberechnungen.

Ein weiteres relevantes Verfahren ist Lifelong Planning A* (LPA*), welches
inkrementelle Änderungen effizient verarbeitet~\cite{LifelongPlanningA}. Solche
Algorithmen werden insbesondere in autonomen Fahrzeugen und mobilen
Servicerobotern eingesetzt, deren Umgebungen durch Menschen oder bewegliche
Objekte beeinflusst werden.

Für einen Coaster Bot wären dynamische Planungsverfahren dann relevant, wenn
sich während der Navigation Gläser, Teller oder Personen im Arbeitsbereich
befinden.

\subsubsection{Kollisionsvermeidung}

Während globale Pfadplanung den optimalen Weg bestimmen, übernimmt die
Kollisionsvermeidung die kurzfristige Reaktion auf Hindernisse.

Ein Ansatz sind Potentialfeldmethoden, bei denen das Ziel eine anziehende Kraft
und Hindernisse abstoßende Kräfte erzeugen. Diese Methoden sind einfach
implementierbar, können jedoch in lokalen Minima stecken bleiben
~\cite{Potentialfeldmethoden}.

In mobilen Robotersystemen wird u.a.\ der Dynamic Window Approach (DWA)
verwendet, der die Bewegungsdynamik des Roboters selbst einbezieht
~\cite{DynamicWindowApproach}. Diese Strategie ist grundsätzlich ein statischer
Ansatz, der die Eigenschaften von Veränderungen in der Umgebung nicht
berücksichtigt. Durch den Einsatz von Neuronalen Netzen kann DWA, durch kurze
Observationen der sich verändernden Umgebung, die Bewegungen der Hindernisse
modellieren und somit auf Veränderungen der Umwelt reagieren
~\cite{DynamicAdaptiveDynamicWindowApproach}.

Für komplexe Konfigurationsräume kommen außerdem samplingbasierte Verfahren wie
Rapidly-exploring Random Trees (RRT)~\cite{RRT} sowie RRT*~\cite{RRTStar} zum Einsatz.
Während RRT schnell zulässige Pfade findet, verbessert RRT* diese schrittweise
bis zum asympotischen Optimum~\cite{RRTStar}.

Somit bildet die Kombination aus globalem Pfadplaner und lokaler
Kollisionsvermeidung einen möglichen Ansatz zur Bewegung des Coaster Bots dar.

\subsubsection{SLAM und Lokalisierung}

Zur verbesserten Navigation kann ein Roboter seine eigene Position bestimmen und
gleichzeitig eine Karte seiner Umgebung aufbauen. Dieses Problem wird als
Simultaneous Localization and Mapping (SLAM) bezeichnet~\cite{SLAM}.

Zu den klassischen Verfahren gehören Extended Kalman Filter (EKF-SLAM),
FastSLAM auf Basis von Paketfiltern sowie graphbasierte SLAM Verfahren~\cite{EKF,EKF-SLAM,FastSLAM}.

Besonders graphbasierte Optimierungsverfahren habe sich aufgrund ihrer hohen
Genauigkeit etabliert und bilden die Grundlage von Robotik-Frameworks wie ROS2
~\cite{ROS2}.

Für den Coaster Bot hängt die Bedeutung von SLAM vom Einsatzszenario und den
verwendeten Sensoren ab. Wird ausschließlich auf einem bekannten Tisch
gearbeitet, genügt meist eine vorher definierte Karte. Soll das System autonom
unbekannte Arbeitsbereiche erfassen oder sich frei im Raum bewegen können, ist
ein SLAM Verfahren vorteilhaft.

\subsubsection{Manipulationsplanung}

Neben der Navigation stellt die Manipulationsplanung einen wesentlichen
Bestandteil autonomer Serviceroboter dar. Sie umfasst die Planung und Steuerung
von Greifbewegungen sowie das sichere Aufnehmen und Ablegen von Objekten.
Hierbei müssen sowohl die Kinematik des Roboters als auch mögliche Kollisionen
zwischen Greifer, Objekt und Umgebung berücksichtigt werden
~\cite{ManipulationCBiRRT,MotionPlanning}.

Zur Bewegungsplanung von Roboterarmen werden häufig samplingbasierte Verfahren
wie RRT~\cite{RRT}, RRT*~\cite{RRTStar} oder Probabilistic Roadmaps (PRM)~\cite{PRM}
eingesetzt. Moderne Robotik-Frameworks wie MoveIt 2~\cite{MoveIt2} kombinieren diese
Planungsverfahren mit Kollisionsprüfungen und inverser Kinematik.

Für den Coaster Bot besteht die Manipulationsaufgabe darin, Getränkedeckel
präzise aufzunehmen und an einer definierten Zielposition abzulegen. Neben
einer genauen Positionierung des Roboters müssen dabei Greifstrategie,
Objektorientierung sowie eine zuverlässige Ablage berücksichtigt werden.

\subsubsection{Inertialnavigation}

Die Inertialnavigation (Inertial Navigation System, INS) beschreibt Verfahren
zur Bestimmung der Position, Orientierung und Bewegung eines mobilen Systems
ausschließlich auf Grundlage von Trägheitssensoren. Im Gegensatz zu
kamerabasierten oder laserbasierten Lokalisierungsmethoden ist die
Inertialnavigation nicht auf externe Referenzpunkte oder eine Sichtverbindung
zur Umgebung angewiesen. Dadurch eignet sie sich insbesondere für Anwendungen,
in denen optische Sensoren nur eingeschränkt eingesetzt werden können oder
zeitweise keine zuverlässigen Umgebungsinformationen zur Verfügung stehen
~\cite{IntegratedNavigationSystems,ModernRobotics}.

Ein Inertialnavigationssystem besteht zumeist aus einer Inertial
Measurement Unit (IMU), die Beschleunigungssensoren (Accelerometer) und
Drehratensensoren (Gyroskope) kombiniert. Moderne Systeme integrieren
zusätzlich Magnetometer zur Bestimmung der absoluten Orientierung. Aus den
gemessenen Beschleunigungen und Winkelgeschwindigkeiten werden durch numerische
Integration Geschwindigkeit, Orientierung und Position des Roboters berechnet.
Die mathematischen Grundlagen dieser Verfahren basieren auf den
Bewegungsgleichungen der klassischen Mechanik sowie auf Verfahren zur Schätzung
von Zustandsgrößen~\cite{IntegratedNavigationSystems,ModernRobotics}.

Ein Problem der Inertialnavigation stellt der Drift dar. Geringe Messfehler der
Sensoren werden durch die fortlaufende Integration akkumuliert und führen mit
zunehmender Betriebsdauer zu wachsenden Positions- und Orientierungsfehlern.
Aus diesem Grund wird eine reine Inertialnavigation in der mobilen Robotik nur
selten dauerhaft eingesetzt. Stattdessen erfolgt eine Kombination mit externen
Sensorsystemen wie LiDAR, Kameras oder Radencodern, um die Positionsschätzung
regelmäßig zu korrigieren~\cite{IntegratedNavigationSystems,ProbabilisticRobotics}.

Zur Fusion verschiedener Sensordaten kommen häufig probabilistische
Schätzverfahren wie der Kalman-Filter, der Extended Kalman Filter (EKF)~\cite{EKF}
oder der Unscented Kalman Filter (UKF)~\cite{UKF} zum Einsatz. Diese Verfahren
kombinieren die Messdaten der IMU mit absoluten Positionsinformationen anderer
Sensoren und ermöglichen dadurch eine robustere Lokalisierung. In aktuellen
Robotersystemen wird zudem vermehrt auf graphbasierte Optimierungsverfahren und
faktorgraphbasierte Ansätze zurückgegriffen, welche mehrere Sensordatenquellen
gleichzeitig berücksichtigen und die Genauigkeit der Positionsbestimmung
verbessern~\cite{ProbabilisticRobotics,HoB}.

Die Inertialnavigation findet in zahlreichen Bereichen der Robotik Anwendung.
Autonome Serviceroboter, fahrerlose Transportsysteme (AGV), Drohnen sowie
mobile Manipulatoren nutzen IMUs zur Stabilisierung der Bewegung, zur Schätzung
der Fahrzeuglage und zur kurzfristigen Positionsbestimmung. Besonders in
Innenräumen, in denen satellitengestützte Navigationssysteme wie GPS nicht
verfügbar sind, stellt die IMU eine wichtige Informationsquelle für die
Bewegungsregelung dar~\cite{GPS}. Auch in IoT- und Embedded-Systemen werden aufgrund der
geringen Baugröße, des niedrigen Energieverbrauchs und der geringen Kosten
häufig kompakte Micro-Electro-Mechanical Systems Inertial Measurement Units
(MEMS-IMUs) eingesetzt~\cite{ModernRobotics,HoB}.

Für den geplanten Coaster Bot kann die Inertialnavigation die globale
Pfadplanung und sensorbasierte Navigation ergänzen. Während Verfahren wie A*
oder Dijkstra den optimalen Fahrweg berechnen und LiDAR- oder
Kamerasysteme Hindernisse erkennen, liefert die IMU kontinuierlich
Informationen über Beschleunigung und Drehrichtung des
Roboters~\cite{AStar,IntroToAlgs}. Dadurch können
Fahrbewegungen zwischen Sensormessungen präziser geschätzt sowie kurzfristige
Positionsänderungen erfasst werden. Beim Anfahren definierter Ablage- oder
Aufnahmepositionen verbessert die Orientierungsschätzung die
Wiederholgenauigkeit des Systems. Die Kombination einer IMU mit Verfahren der
globalen Pfadplanung entspricht dem in der mobilen Robotik etablierten Ansatz
einer mehrstufigen Navigation~\cite{ModernRobotics,HoB}.

Da sich der Coaster Bot auf einer vergleichsweise kleinen Arbeitsfläche bewegt
und Bewegungen präzise erfolgen sollten,
ist eine alleinige Inertialnavigation aufgrund der Drift möglicherweise nicht
ausreichend. Eine mögliche Kombination aus mehreren Sensoren wie IMU,
Radencodern, einem LiDAR- oder kamerabasierten Lokalisierungssystem würden eine
effizientere Positionsbestimmung erreichen.

\newpage
\section{Anhänge}

\appendix

%acm bullshit
%\bibliographystyle{ACM-Reference-Format}
%\bibliography{quellen}

% normal scr article
\printbibliography[title={Literaturverzeichnis}]

\listoffigures

%\newpage
%\chapter*{References}
%\addcontentsline{toc}{chapter}{References}
%\printbibliography[heading=none]
\input{Literaturrecherche-Dennis/mobrob_table.tex}
\section*{Literaturrecherche der benötigte Algorithmen}
\subsection*{Pfadfindung und Kollisionsvermeidung}

IEEE Explore (Filter: 2014 bis 2026):
\begin{itemize}

\item \href{https://ieeexplore.ieee.org/search/searchresult.jsp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\%20AND\%20(\%22All\%20Metadata\%22:collision\%20avoidance)\%20AND\%20(\%22All\%20Metadata\%22:mobile\%20robot)\&ranges=2014_2027_Year}
{("All Metadata":path planning) AND ("All Metadata":collision avoidance) AND ("All Metadata":mobile robot)}

\item \href{https://ieeexplore.ieee.org/search/searchresult.jsp?action=search&newsearch=true&matchBoolean=true&queryText=(\%22All\%20Metadata\%22:\%22path\%20planning\%22\%20AND\%20\%22All\%20Metadata\%22:\%22collision\%20avoidance\%22\%20AND\%20\%22All\%20Metadata\%22:\%22IoT\%22)\&ranges=2014_2027_Year}
{("All Metadata":"path planning" AND "All Metadata":"collision avoidance" AND "All Metadata":"IoT")}

\item \href{https://ieeexplore.ieee.org/search/searchresult.jsp?action=search&matchBoolean=true&newsearch=true&queryText=(TI:\%22path\%20planning\%22\%20AND\%20TI:\%22collision\%20avoidance\%22\%20AND\%20(TI:\%22mobile\%20robot\%22\%20OR\%20TI:\%22autonomous\%20robot\%22))}
{(TI:"path planning" AND TI:"collision avoidance" AND (TI:"mobile robot" OR TI:"autonomous robot"))}

\item \href{https://ieeexplore.ieee.org/search/searchresult.jsp?action=search&matchBoolean=true&queryText=((\%22ultrasonic\%20sensor\%22\%20OR\%20\%22ultrasonic\%20distance\%22)\%20AND\%20\%22mobile\%20robot\%22\%20AND\%20\%22navigation\%22)\&highlight=true\&returnFacets=ALL\&returnType=SEARCH\&matchPubs=true\&rowsPerPage=25\&ranges=2014_2026_Year}
{("ultrasonic sensor" OR "ultrasonic distance") AND "mobile robot" AND "navigation"}

\item \href{https://ieeexplore.ieee.org/search/searchresult.jsp?action=search&matchBoolean=true&queryText=((\%22optical\%20sensor\%22\%20OR\%20\%22light-dependent\%20resistor\%22)\%20AND\%20(\%22obstacle\%20detection\%22\%20OR\%20\%22edge\%20detection\%22)\%20AND\%20\%22navigation\%22)\&highlight=true\&returnFacets=ALL\&returnType=SEARCH\&matchPubs=true\&rowsPerPage=25\&ranges=2014_2025_Year}
{(("optical sensor" OR "light-dependent resistor") AND ("obstacle detection" OR "edge detection") AND "navigation")}

\item \href{https://ieeexplore.ieee.org/search/searchresult.jsp?action=search&matchBoolean=true&queryText=((\%22visual\%20SLAM\%22\%20OR\%20\%22monocular\%20SLAM\%22\%20OR\%20\%22stereo\%20vision\%22)\%20AND\%20(\%22collision\%20avoidance\%22\%20OR\%20\%22obstacle\%20detection\%22))\&highlight=true\&returnFacets=ALL\&returnType=SEARCH\&matchPubs=true\&rowsPerPage=25\&ranges=2014_2026_Year}
{("visual SLAM" OR "monocular SLAM" OR "stereo vision") AND ("collision avoidance" OR "obstacle detection")}

\item \href{https://ieeexplore.ieee.org/search/searchresult.jsp?action=search&matchBoolean=true&queryText=((\%22computer\%20vision\%22\%20AND\%20\%22path\%20planning\%22\%20AND\%20\%22mobile\%20robot\%22))\&highlight=true\&returnFacets=ALL\&returnType=SEARCH\&matchPubs=true\&rowsPerPage=25\&ranges=2014_2026_Year}
{("computer vision" AND "path planning" AND "mobile robot")}

\end{itemize}

\href{http://arXiv.org}{arXiv.org} (Filter: 2014--2026):
\begin{itemize}

    \item „Für arXiv wurden Boolesche Suchanfragen wie „inertial measurement unit” „sensor fusion” navigation „path planning” AND „obstacle avoidance” AND (“mobile robot” OR “autonomous robot”) sowie variationsreiche Kombinationen von Schlüsselwörtern zu Pfadfindung, Kollisionsvermeidung, Sensorik (Ultraschall, IR, Kamera, Lichtsensor) und IoT verwendet.“

    \item \href{https://arxiv.org/search/advanced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}
    {order: announced\_date\_first; size: 50; date\_range: 2014-01-01 to 2026-12-31; classification: Computer Science (cs), Electrical Engineering and Systems Science (eess); include\_cross\_list: True; terms: AND all="path planning"; AND title="obstacle avoidance"; AND title="mobile robot"; OR title="autonomous robot"; AND title="obstacle avoidance".}

    \item \href{https://arxiv.org/search/advanced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}
    {order: announced\_date\_first; size: 50; date\_range: 2014-01-01 to 2026-12-31; include\_cross\_list: True; terms: AND all="obstacle avoidance"; AND all="ultrasonic sensor"; OR title="infrared sensor"; AND title="distance sensor".}

    \item \href{https://arxiv.org/search/advanced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}
    {order: announced\_date\_first; size: 50; date\_range: 2014-01-01 to 2026-12-31; include\_cross\_list: True; terms: AND all="photoresistor" AND robot; OR title="light sensor"; OR title="light-dependent resistor"; OR title="line following"; AND title="line follower"; OR title="path tracking".}

\end{itemize}

Google Scholar (Filter: 2014--2026):
\begin{itemize}

    \item In Google Scholar wurden entsprechende Phrasensuchen wie
    path planning, collision avoidance, mobile robot bzw.
    vision-based, navigation, obstacle avoidance robot
    eingesetzt, der Veröffentlichungszeitraum wurde in der Regel auf 2014--2026 beschränkt.

    \item \href{https://scholar.google.com/scholar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}
    {\texttt{"path planning" "collision avoidance" "mobile robot"}}

    \item \href{https://scholar.google.com/scholar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}
    {\texttt{"obstacle avoidance" "distance sensor" (IoT OR "embedded system")}}

    \item \href{https://scholar.google.com/scholar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}
    {\texttt{"sensor-based navigation" "mobile robot" obstacle}}

    \item \href{https://scholar.google.com/scholar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}
    {\texttt{"vision-based navigation" "obstacle avoidance" robot}}

    \item \href{https://scholar.google.com/scholar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}
    {\texttt{("photoresistor" OR "light sensor") "line following" robot}}

    \item \href{https://scholar.google.com/scholar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}
    {\texttt{"IoT robot" "path planning" "obstacle avoidance"}}

    \item \href{https://scholar.google.com/scholar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}
    {\texttt{"path planning" "obstacle avoidance" "mobile robot" (IoT OR "wireless sensor network")}}

\end{itemize}

\subsection*{Inertialnavigation}

IEEE Explore (Filter: 2014--2026)
\begin{itemize}

   \item \href{https://ieeexplore.ieee.org/search/searchresult.jsp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(%22All\%20Metadata\%22:IoT%20OR%20%22All\%20Metadata%22:%20%22Internet\%20of\%20Things%22%20%20OR%20%22embedded\%20system\%22%20OR%20%22microcontroller\%22)&ranges=2014_2026_Year}{("All Metadata":"inertial navigation") AND ("All Metadata":IoT OR "All Metadata":"Internet of Things" OR "embedded system" OR "microcontroller")}

    \item \href{https://ieeexplore.ieee.org/search/searchresult.jsp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(\%22resource-constrained\%22\%20OR\%20\%22low-power\%22\%20OR\%20\%22low\%20power\%22\%20OR\%20\%22edge\%20device\%22)&ranges=2014_2026_Year}
    {("inertial navigation" OR "INS") AND ("resource-constrained" OR "low-power" OR "low power" OR "edge device")}

    \item \href{https://ieeexplore.ieee.org/search/searchresult.jsp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}
    {("inertial measurement unit" OR IMU) AND navigation AND IoT}

    \item \href{https://ieeexplore.ieee.org/search/searchresult.jsp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(\%22sensor\%20fusion\%22\%20OR\%20\%22Kalman\%20filter\%22\%20OR\%20\%22extended\%20Kalman\%22\%20OR\%20\%22particle\%20filter\%22)%20AND%20(IoT%20OR%20\%22embedded\%20system\%22)&ranges=2014_2026_Year}
    {("inertial navigation" OR "inertial odometry") AND ("sensor fusion" OR "Kalman filter" OR "extended Kalman" OR "particle filter") AND (IoT OR "embedded system")}

    \item \href{https://ieeexplore.ieee.org/search/searchresult.jsp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}
    {("visual inertial" OR "visual-inertial") AND navigation AND ("mobile robot" OR drone OR UAV)}

\end{itemize}

Google Scholar (Filter: 2014--2026)
\begin{itemize}

    \item \href{https://scholar.google.com/scholar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}
    {\texttt{"inertial navigation" "IoT" "resource-constrained" "robot"}}

    \item \href{https://scholar.google.com/scholar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}
    {\texttt{"inertial navigation" "embedded system" "microcontroller"}}

    \item \href{https://scholar.google.com/scholar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}
    {\texttt{"AI-enhanced inertial navigation" IoT}}

    \item \href{https://scholar.google.com/scholar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}
    {\texttt{"visual inertial navigation" "mobile robot"}}

    \item \href{https://scholar.google.com/scholar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}
    {\texttt{"inertial measurement unit" "sensor fusion" navigation}}

\end{itemize}

\end{document}
