Project-CoasterBot/coasterbot/M3_Produktentwicklung/Pflichtenheft/raw.tex

\section{Einleitung}\label{einleitung}

\subsection{Zweck des Pflichtenhefts}\label{zweck-des-pflichtenhefts}

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

\subsection{Projektbeschreibung}\label{projektbeschreibung}

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

\subsection{Zielsetzung}\label{zielsetzung}

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

Hierzu werden folgende Ergebnisse angestrebt:

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

\subsection{Technische
Zielarchitektur}\label{technische-zielarchitektur}

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

\subsubsection{Hardwareebene}\label{hardwareebene}

Die Hardwareebene umfasst alle physischen Komponenten des Roboters:

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

\subsubsection{Abstraktionsebene}\label{abstraktionsebene}

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

\subsubsection{Steuerungs- und
Anwendungsebene}\label{steuerungs--und-anwendungsebene}

Die Anwendungsebene beinhaltet die eigentliche Systemlogik:

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

\subsubsection{Simulationsebene}\label{simulationsebene}

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

\subsection{Abgrenzung}\label{abgrenzung}

Die folgenden Funktionen werden im Rahmen dieser Projektarbeit nicht
umgesetzt:

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

\subsection{Dokumentstruktur}\label{dokumentstruktur}

Das Pflichtenheft ist wie folgt aufgebaut:

\textbf{Kapitel 1 -- Einleitung} Beschreibung der Zielsetzung,
Aufgabenstellung und Abgrenzung des Projekts.

\textbf{Kapitel 2 -- Systemarchitektur} Beschreibung der Gesamtstruktur
des Coasterbots sowie der Aufteilung in Hardware- und
Softwarekomponenten.

\textbf{Kapitel 3 -- Hardwarekonzept} Beschreibung der mechanischen
Komponenten, Sensorik, Aktorik und Energieversorgung.

\textbf{Kapitel 4 -- Softwarekonzept} Beschreibung der
Softwarearchitektur, Komponenten und Schnittstellen.

\textbf{Kapitel 5 -- Implementierungskonzept} Beschreibung der geplanten
Umsetzung der Kernfunktionen.

\textbf{Kapitel 6 -- Simulationskonzept} Beschreibung der
Simulationsumgebung und der modellierten Systembestandteile.

\textbf{Kapitel 7 -- Test- und Verifikationskonzept} Beschreibung der
Teststrategie und Zuordnung von Tests zu Anforderungen.

\textbf{Kapitel 8 -- Zusammenfassung und Ausblick} Bewertung der
Umsetzung sowie mögliche zukünftige Erweiterungen.

\section{Systemarchitektur}\label{systemarchitektur}

\subsection{Ziel der
Systemarchitektur}\label{ziel-der-systemarchitektur}

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

\subsection{Systemaufbau}\label{systemaufbau}

Der Coasterbot wird als eingebettetes autonomes Robotersystem
entwickelt. Das Gesamtsystem wird in mehrere Ebenen unterteilt:

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

Die Ebenen sind hierarchisch aufgebaut und kommunizieren ausschließlich
über definierte Schnittstellen.

\subsection{Architekturmodell}\label{architekturmodell}

\subsubsection{Hardwareebene}\label{hardwareebene-1}

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

Die Hardwareebene besteht aus folgenden Hauptkomponenten:

\begin{itemize}
\tightlist
\item
  Recheneinheit
\item
  Sensorik
\item
  Aktorik
\item
  Energieversorgung
\item
  Mechanische Konstruktion
\end{itemize}

Die Recheneinheit übernimmt die Verarbeitung der Sensordaten sowie die
Berechnung der Steuerbefehle für die Aktoren.

Die Sensorik stellt Informationen über den Zustand des Roboters und
seiner Umgebung bereit. Dazu gehören insbesondere:

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

Die Aktorik setzt die berechneten Steuerbefehle in physische Aktionen
um. Dazu gehören:

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

\subsection{Hardwareabstraktionsebene}\label{hardwareabstraktionsebene}

Die Hardwareabstraktionsebene stellt eine Trennung zwischen der
physischen Hardware und der darüberliegenden Softwarelogik her.

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

Die Hardwareabstraktion umfasst:

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

Durch diese Struktur können reale Hardwarekomponenten durch
Simulationsmodelle ersetzt werden.

\subsection{Systemlogikebene}\label{systemlogikebene}

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

Die wesentlichen Komponenten dieser Ebene sind:

\subsubsection{Navigationskomponente}\label{navigationskomponente}

Die Navigationskomponente ist verantwortlich für die autonome Bewegung
des Roboters innerhalb des Arbeitsbereichs.

Aufgaben:

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

\subsubsection{Lokalisierungskomponente}\label{lokalisierungskomponente}

Die Lokalisierungskomponente bestimmt die aktuelle Position und
Orientierung des Roboters.

Aufgaben:

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

\subsubsection{Bewegungssteuerung}\label{bewegungssteuerung}

Die Bewegungssteuerung übersetzt Navigationsentscheidungen in konkrete
Bewegungsbefehle.

Aufgaben:

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

\subsubsection{Untersetzerhandling}\label{untersetzerhandling}

Diese Komponente steuert die Aufnahme und Ausgabe von
Getränkeuntersetzern.

Aufgaben:

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

\subsubsection{Sicherheitskomponente}\label{sicherheitskomponente}

Die Sicherheitskomponente überwacht sicherheitskritische Zustände.

Aufgaben:

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

\subsubsection{Systemüberwachung}\label{systemuxfcberwachung}

Die Systemüberwachung stellt Informationen über den Betriebszustand
bereit.

Aufgaben:

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

\subsection{Anwendungsebene}\label{anwendungsebene}

Die Anwendungsebene beschreibt die übergeordnete Ablaufsteuerung des
Coasterbots.

Sie definiert die Reihenfolge der Systemaktionen und koordiniert die
einzelnen Funktionskomponenten.

Beispielhafter Ablauf:

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

Die Anwendungsebene enthält keine hardwareabhängigen Funktionen und
kommuniziert ausschließlich über definierte Schnittstellen mit den
darunterliegenden Komponenten.

\subsection{Simulationsarchitektur}\label{simulationsarchitektur}

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

Die Simulationsarchitektur umfasst:

\subsubsection{Umgebungsmodell}\label{umgebungsmodell}

Das Umgebungsmodell beschreibt die virtuelle Tischoberfläche sowie
darauf befindliche Objekte.

Modelliert werden:

\begin{itemize}
\tightlist
\item
  Tischgrenzen
\item
  Hindernisse
\item
  Getränke
\item
  Getränkeuntersetzer
\end{itemize}

\subsubsection{Sensormodelle}\label{sensormodelle}

Sensormodelle erzeugen virtuelle Sensordaten entsprechend der
simulierten Umgebung.

Beispiele:

\begin{itemize}
\tightlist
\item
  Abstandswerte
\item
  Positionserkennung
\item
  Hinderniserkennung
\item
  Tischkantenerkennung
\end{itemize}

\subsubsection{Aktormodelle}\label{aktormodelle}

Aktormodelle bilden das Verhalten realer Aktoren nach.

Beispiele:

\begin{itemize}
\tightlist
\item
  Motorbewegungen
\item
  Geschwindigkeit
\item
  Aufnahme- und Ablegebewegungen
\end{itemize}

\subsubsection{Teststeuerung}\label{teststeuerung}

Die Teststeuerung ermöglicht die Durchführung reproduzierbarer
Testszenarien.

Sie ermöglicht:

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

\subsection{Kommunikationsprinzipien}\label{kommunikationsprinzipien}

Die Kommunikation zwischen Komponenten erfolgt über klar definierte
Schnittstellen.

Folgende Prinzipien werden berücksichtigt:

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

\subsection{Erweiterbarkeit der
Architektur}\label{erweiterbarkeit-der-architektur}

Die Architektur wird so ausgelegt, dass zukünftige Entwicklungsstufen
integriert werden können.

Mögliche Erweiterungen:

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

\subsection{Zusammenfassung}\label{zusammenfassung}

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

\section{Hardwarekonzept}\label{hardwarekonzept}

\subsection{Ziel des Hardwarekonzepts}\label{ziel-des-hardwarekonzepts}

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

\subsection{Hardwarearchitektur}\label{hardwarearchitektur}

Die Hardware des Coasterbots wird in folgende Hauptbereiche unterteilt:

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

Die einzelnen Komponenten werden modular aufgebaut und über definierte
Schnittstellen miteinander verbunden.

\subsection{Recheneinheit}\label{recheneinheit}

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

Die Anforderungen an die Recheneinheit sind:

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

\subsection{Sensorik}\label{sensorik}

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

\subsubsection{Hinderniserkennung}\label{hinderniserkennung}

Zur sicheren Navigation muss der Coasterbot Hindernisse innerhalb seines
Arbeitsbereichs erkennen können.

Die Sensorik muss folgende Anforderungen erfüllen:

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

Mögliche technische Lösungen sind Abstandssensoren, Kameras oder
Kombinationen verschiedener Sensorprinzipien.

\subsubsection{Tischkantenerkennung}\label{tischkantenerkennung}

Da der Roboter ausschließlich auf einer Tischoberfläche betrieben wird,
ist eine zuverlässige Erkennung der Tischbegrenzung erforderlich.

Anforderungen:

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

\subsubsection{Positions- und
Orientierungserfassung}\label{positions--und-orientierungserfassung}

Für die autonome Navigation benötigt der Roboter Informationen über
seine Position und Orientierung.

Anforderungen:

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

Die Positionsbestimmung kann durch eine Kombination verschiedener
Sensorquellen erfolgen.

\subsection{Aktorik}\label{aktorik}

Die Aktorik setzt die berechneten Steuerbefehle in physische Aktionen
um.

Die Aktorik wird in zwei Bereiche unterteilt:

\begin{itemize}
\tightlist
\item
  Bewegungsaktorik
\item
  Manipulationsaktorik
\end{itemize}

\subsection{Bewegungsaktorik}\label{bewegungsaktorik}

Die Bewegungsaktorik ermöglicht die autonome Fortbewegung des
Coasterbots auf der Tischoberfläche.

Anforderungen:

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

Für den Prototyp wird ein Antriebssystem vorgesehen, das eine präzise
Steuerung der Fahrbewegung ermöglicht.

\subsection{Manipulationsaktorik}\label{manipulationsaktorik}

Die Manipulationsaktorik ermöglicht die Aufnahme und Ausgabe von
Getränkeuntersetzern.

Anforderungen:

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

\subsection{Energieversorgung}\label{energieversorgung}

Die Energieversorgung stellt die elektrische Versorgung aller
Systemkomponenten sicher.

Sie umfasst:

\begin{itemize}
\tightlist
\item
  Energiespeicher
\item
  Spannungsregelung
\item
  Ladeelektronik
\item
  Überwachung des Energiezustands
\end{itemize}

Anforderungen:

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

Die Energieversorgung wird so ausgelegt, dass ein ausreichender
Betriebszeitraum für Tests und Demonstrationen ermöglicht wird.

\subsection{Mechanische Konstruktion}\label{mechanische-konstruktion}

Die mechanische Konstruktion bildet die physische Struktur des
Coasterbots.

Anforderungen:

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

Bei der Konstruktion werden insbesondere folgende Eigenschaften
berücksichtigt:

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

\subsection{Bedienelemente}\label{bedienelemente}

Für die direkte Bedienung durch das Servicepersonal oder Gäste besitzt
der Coasterbot einige wenige physische Bedienelemente.

Vorgesehen sind drei Bedienelemente:

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

Die Anforderungen an die Bedienelemente sind:

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

\subsection{Hardwareabstraktion}\label{hardwareabstraktion}

Alle Hardwarekomponenten werden so integriert, dass sie über definierte
Schnittstellen angesprochen werden können.

Die Hardwareabstraktion ermöglicht:

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

Dadurch wird sichergestellt, dass Änderungen an der Hardware keine
grundlegenden Anpassungen der Systemlogik erfordern.

\subsection{Zusammenfassung}\label{zusammenfassung-1}

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

Die Hardwarearchitektur unterstützt damit die zentralen
Entwicklungsziele des Projekts:

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

\section{Softwarekonzept}\label{softwarekonzept}

\subsection{Ziel des Softwarekonzepts}\label{ziel-des-softwarekonzepts}

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

\subsection{Softwarearchitektur}\label{softwarearchitektur}

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

Die Software wird in folgende Ebenen unterteilt:

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

\subsection{Hardwaretreiberebene}\label{hardwaretreiberebene}

Die Hardwaretreiberebene stellt die direkte Verbindung zwischen Software
und physischer Hardware her.

Sie beinhaltet hardwarespezifische Implementierungen für:

\begin{itemize}
\tightlist
\item
  Sensoransteuerung,
\item
  Motorsteuerung,
\item
  Manipulationsmechanismen,
\item
  Energieüberwachung,
\item
  Kommunikationsschnittstellen.
\end{itemize}

Die Aufgaben dieser Ebene sind:

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

\subsection{Hardwareabstraktionsebene}\label{hardwareabstraktionsebene-1}

Die Hardwareabstraktionsebene bildet die Schnittstelle zwischen Hardware
und Systemlogik.

Ziel dieser Ebene ist die Bereitstellung einheitlicher Schnittstellen
unabhängig von der konkreten Hardwareimplementierung.

Beispiele:

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

Die Hardwareabstraktion ermöglicht:

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

\subsection{Systemdienste}\label{systemdienste}

Die Systemdienste stellen grundlegende Funktionen bereit, die von
mehreren Komponenten verwendet werden.

\subsubsection{Kommunikationsdienst}\label{kommunikationsdienst}

Der Kommunikationsdienst übernimmt den Austausch von Daten zwischen
Softwarekomponenten.

Aufgaben:

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

\subsubsection{Konfigurationsdienst}\label{konfigurationsdienst}

Der Konfigurationsdienst verwaltet systemrelevante Parameter.

Beispiele:

\begin{itemize}
\tightlist
\item
  Sensorkonfiguration.
\item
  Fahrparameter.
\item
  Sicherheitsgrenzen.
\item
  Simulationsparameter.
\end{itemize}

Durch die zentrale Verwaltung können Parameter angepasst werden, ohne
die Softwarestruktur verändern zu müssen.

\subsubsection{Diagnosedienst}\label{diagnosedienst}

Der Diagnosedienst überwacht den Systemzustand und stellt Informationen
für Fehleranalyse und Wartung bereit.

Aufgaben:

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

\subsection{Funktionskomponenten}\label{funktionskomponenten}

Die Funktionskomponenten enthalten die eigentliche Systemlogik des
Coasterbots.

\subsection{Navigationskomponente}\label{navigationskomponente-1}

Die Navigationskomponente ist für die autonome Bewegung des Roboters
verantwortlich.

Aufgaben:

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

Die Navigationskomponente erhält Informationen über:

\begin{itemize}
\tightlist
\item
  aktuelle Position,
\item
  Orientierung,
\item
  Hindernisse,
\item
  Zielposition.
\end{itemize}

Als Ergebnis erzeugt sie Bewegungsbefehle für die Bewegungssteuerung.

\subsection{Lokalisierungskomponente}\label{lokalisierungskomponente-1}

Die Lokalisierungskomponente bestimmt die aktuelle Position und
Orientierung des Roboters.

Aufgaben:

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

Die Lokalisierung ist notwendig, damit der Roboter definierte Zielpunkte
zuverlässig erreichen kann.

\subsection{Bewegungssteuerung}\label{bewegungssteuerung-1}

Die Bewegungssteuerung übersetzt Navigationsbefehle in konkrete
Aktorbefehle.

Aufgaben:

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

Die Bewegungssteuerung stellt sicher, dass Bewegungen kontrolliert und
reproduzierbar erfolgen.

\subsection{Untersetzerhandling}\label{untersetzerhandling-1}

Die Komponente für das Untersetzerhandling steuert alle Funktionen zur
Aufnahme und Ausgabe von Getränkeuntersetzern.

Aufgaben:

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

Die Komponente arbeitet mit der Navigation und Sensorik zusammen, um
eine präzise Positionierung zu ermöglichen.

\subsection{Sicherheitskomponente}\label{sicherheitskomponente-1}

Die Sicherheitskomponente überwacht alle sicherheitsrelevanten Zustände.

Aufgaben:

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

Die Sicherheitslogik besitzt eine hohe Priorität gegenüber anderen
Systemfunktionen.

Beispiele:

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

\subsection{Systemüberwachung}\label{systemuxfcberwachung-1}

Die Systemüberwachung stellt Informationen über den Betriebszustand
bereit.

Aufgaben:

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
