Project-CoasterBot/coasterbot/M0/Coasterbot_Netzplan_v3.png

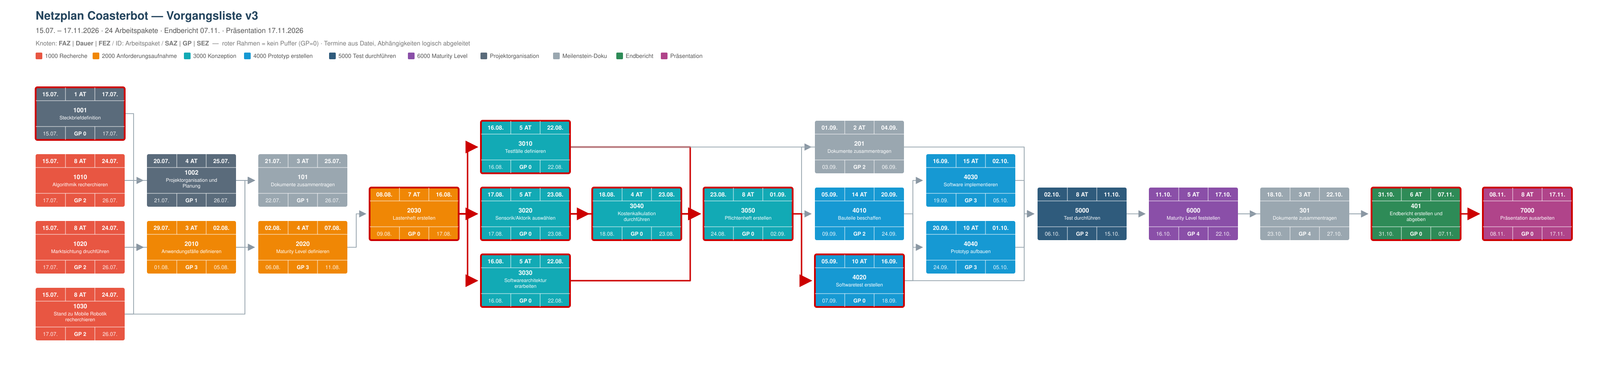
M0/Coasterbot_Netzplan_v3.png
