Project-CoasterBot/coasterbot/M3_Produktentwicklung/MindMap/Coasterbot_Komponenten.png

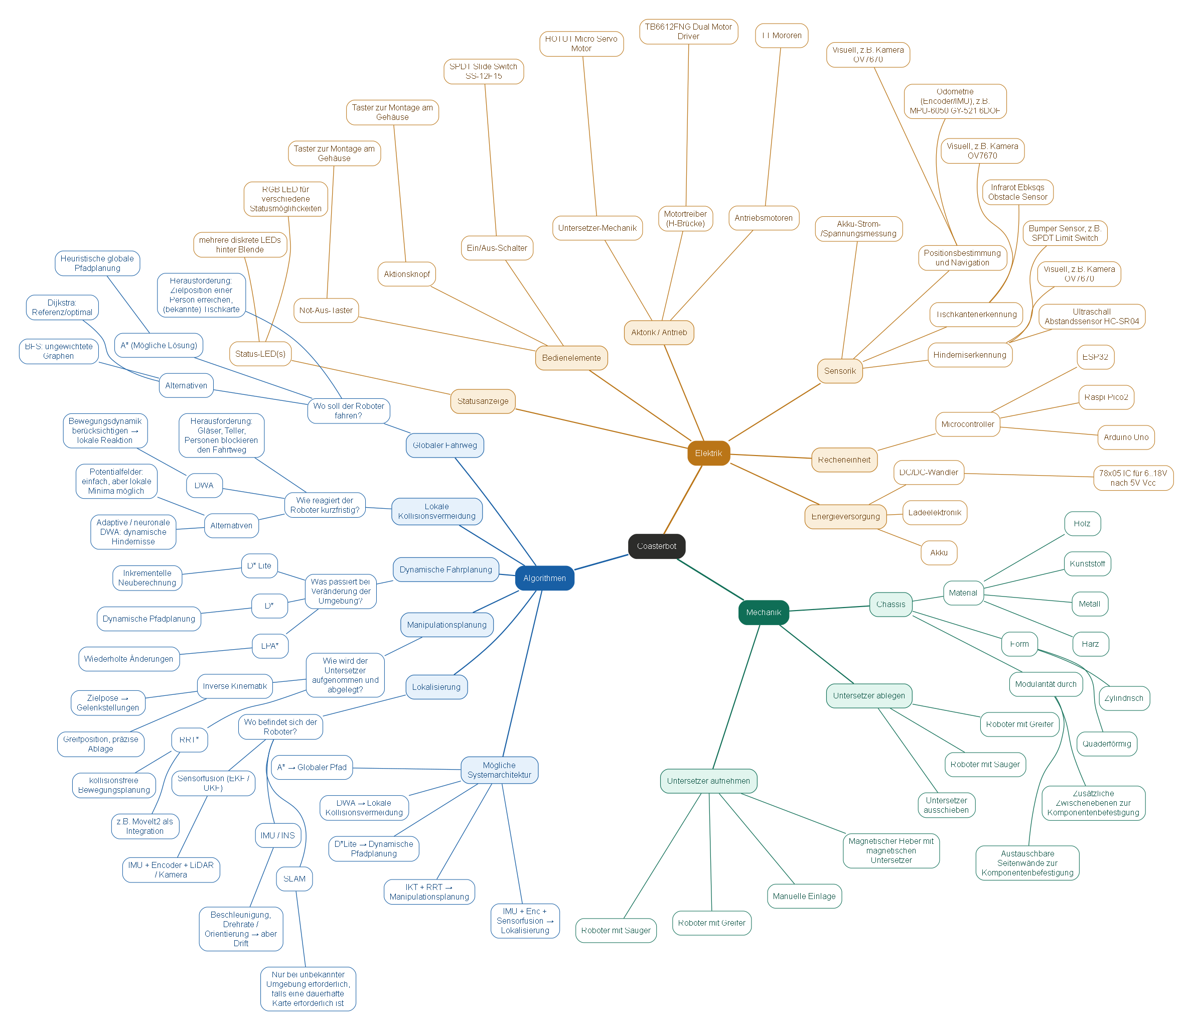
M3_Produktentwicklung/MindMap/Coasterbot_Komponenten.png
