Project-CoasterBot/coasterbot/M4_Test-und-Validierung/hardware_abstraction/messung_vorwaerts_rueckwaerts.png

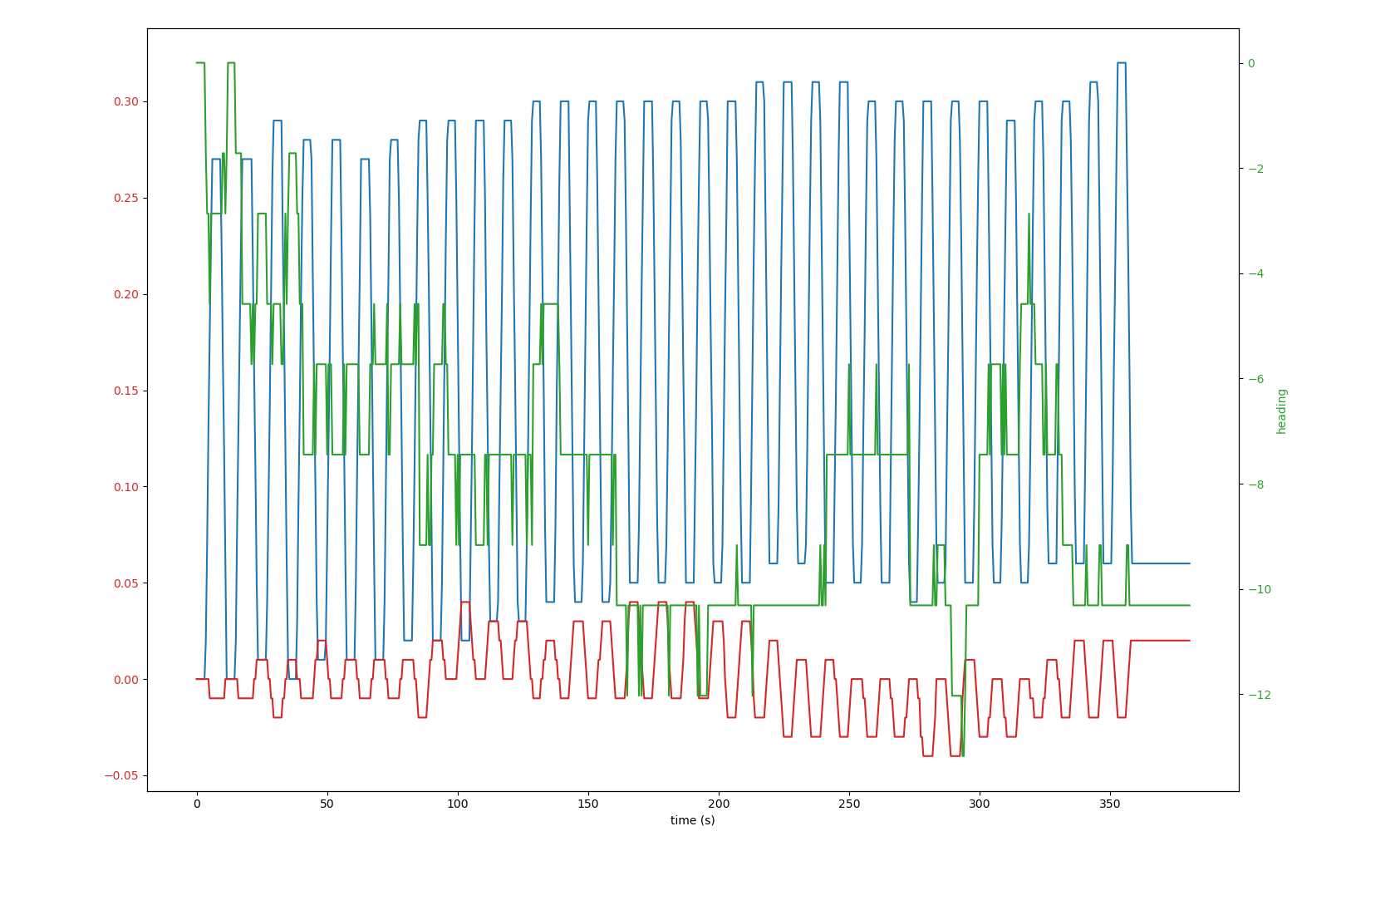
M4_Test-und-Validierung/hardware_abstraction/messung_vorwaerts_rueckwaerts.png
