Project-CoasterBot/coasterbot/M6_Projekträsentation/gs_resource/gs_einhorn.jpg

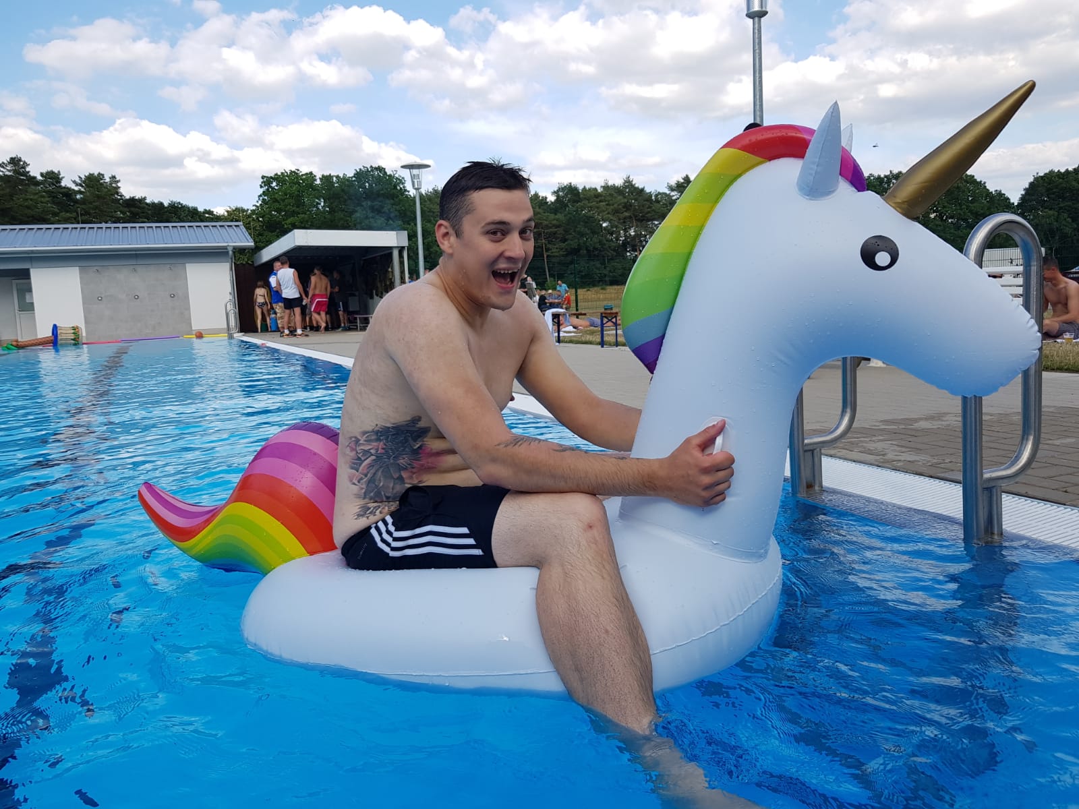
M6_Projekträsentation/gs_resource/gs_einhorn.jpg
