Project-CoasterBot/coasterbot/M6_Projekträsentation/gs_resource/IMG-20261004-WA0005.jpg

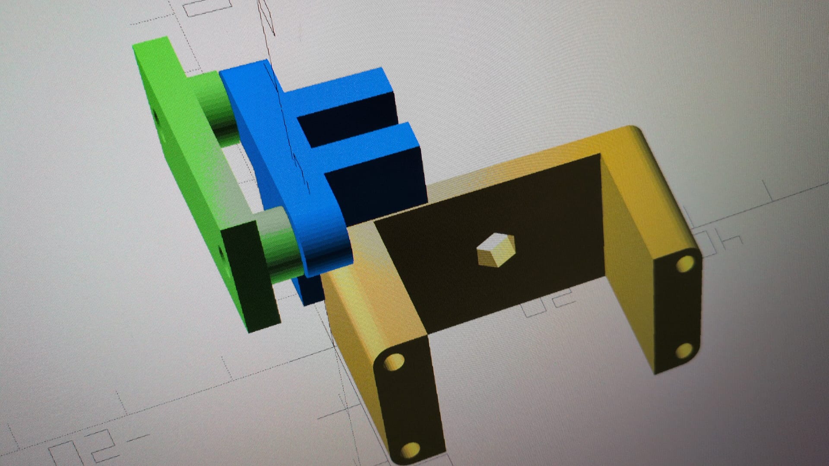
M6_Projekträsentation/gs_resource/IMG-20261004-WA0005.jpg
