Project-CoasterBot/coasterbot/M6_Projekträsentation/gs_resource/IMG-20261004-WA0008.jpg

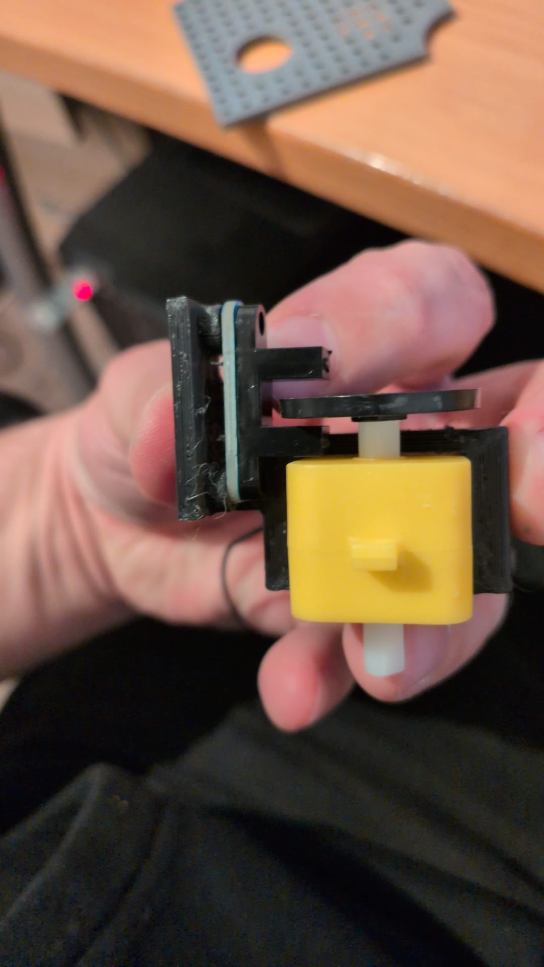
M6_Projekträsentation/gs_resource/IMG-20261004-WA0008.jpg
