Project-CoasterBot/coasterbot/M6_Projekträsentation/gs_resource/IMG-20261007-WA0001.jpg

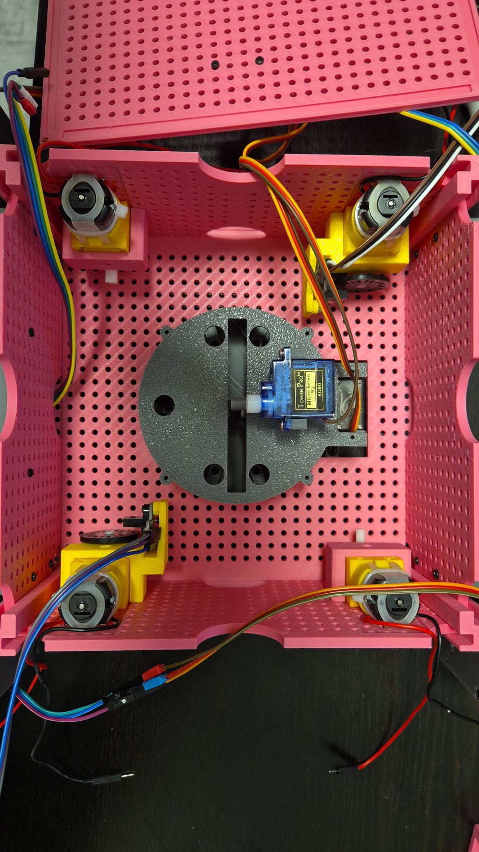
M6_Projekträsentation/gs_resource/IMG-20261007-WA0001.jpg
