Project-CoasterBot/coasterbot/M6_Projekträsentation/gs_resource/protoboard.png

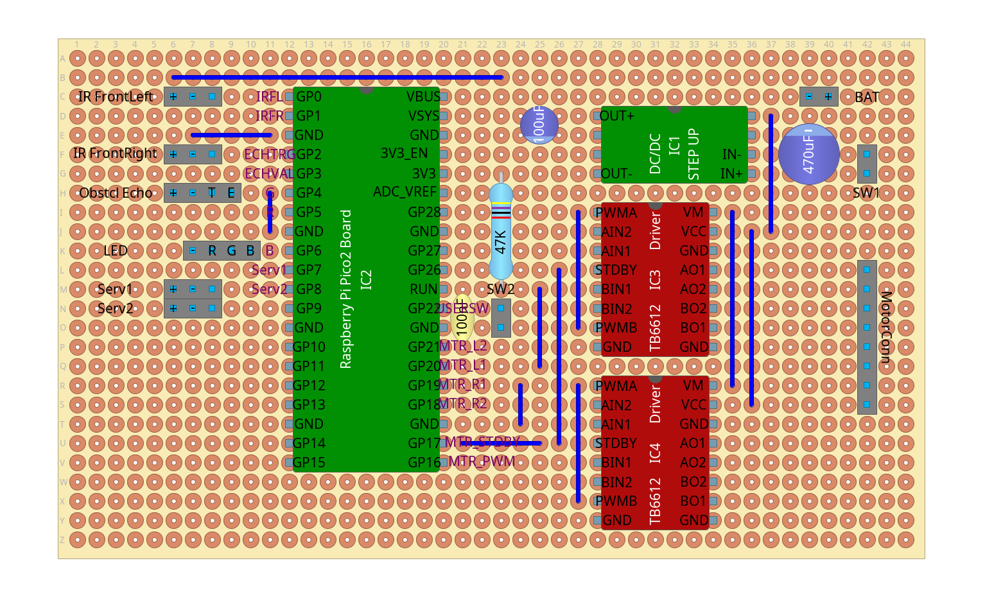
M6_Projekträsentation/gs_resource/protoboard.png
