Project-CoasterBot/coasterbot/M6_Projekträsentation/gs_resource/protoboard_mask.png

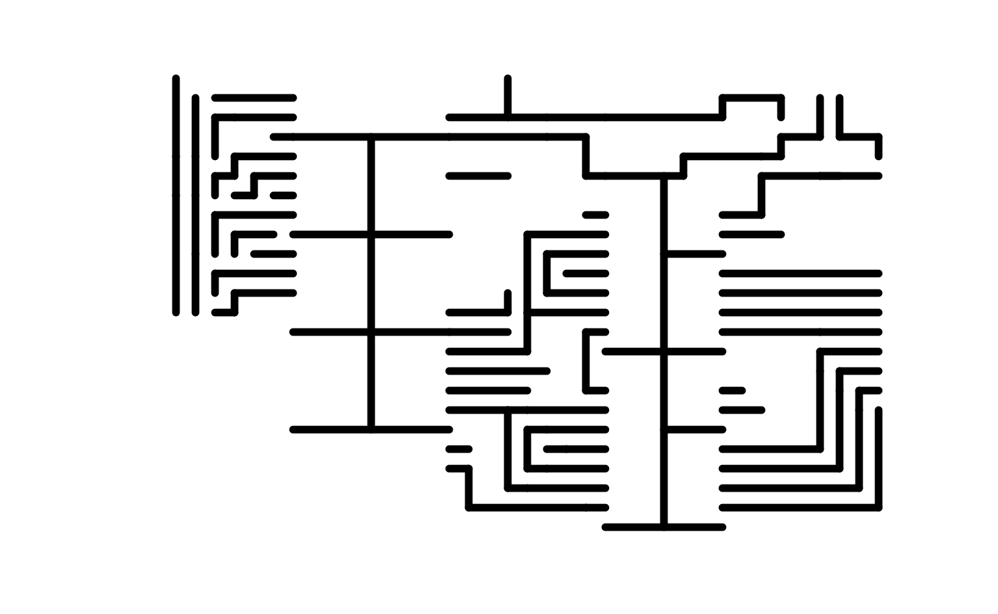
M6_Projekträsentation/gs_resource/protoboard_mask.png
