Project-CoasterBot/coasterbot/M6_Projekträsentation/gs_resource/PXL_20261104_212753418.jpg

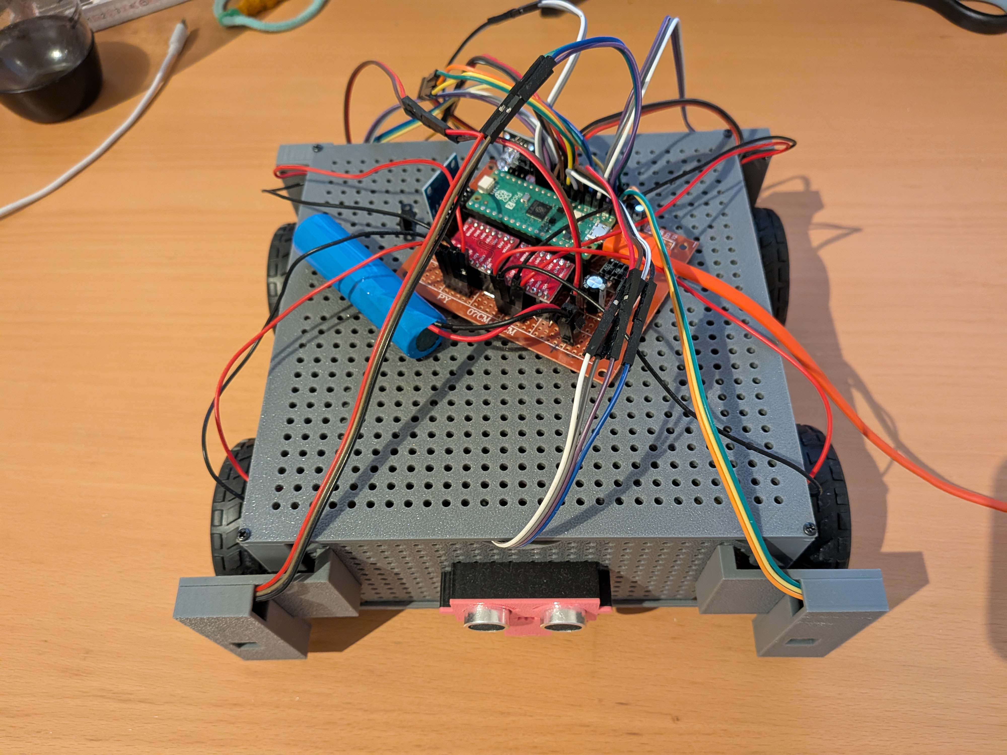
M6_Projekträsentation/gs_resource/PXL_20261104_212753418.jpg
