Project-CoasterBot/coasterbot/M6_Projekträsentation/gs_resource/PXL_20261104_212823331.jpg

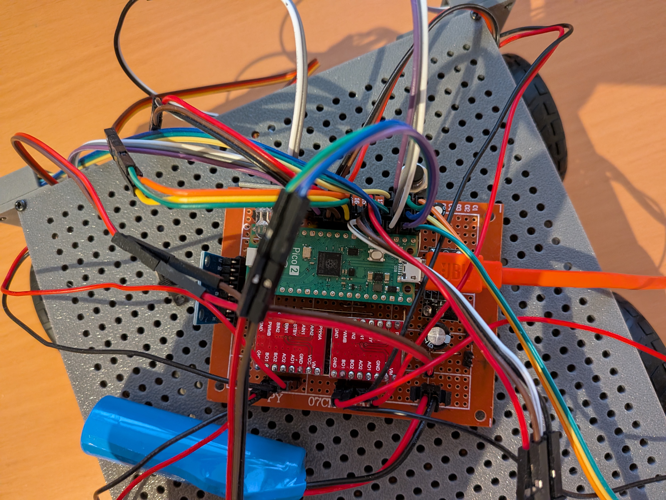
M6_Projekträsentation/gs_resource/PXL_20261104_212823331.jpg
