Project-CoasterBot/coasterbot/M6_Projekträsentation/gs_resource/PXL_20261104_212840806.jpg

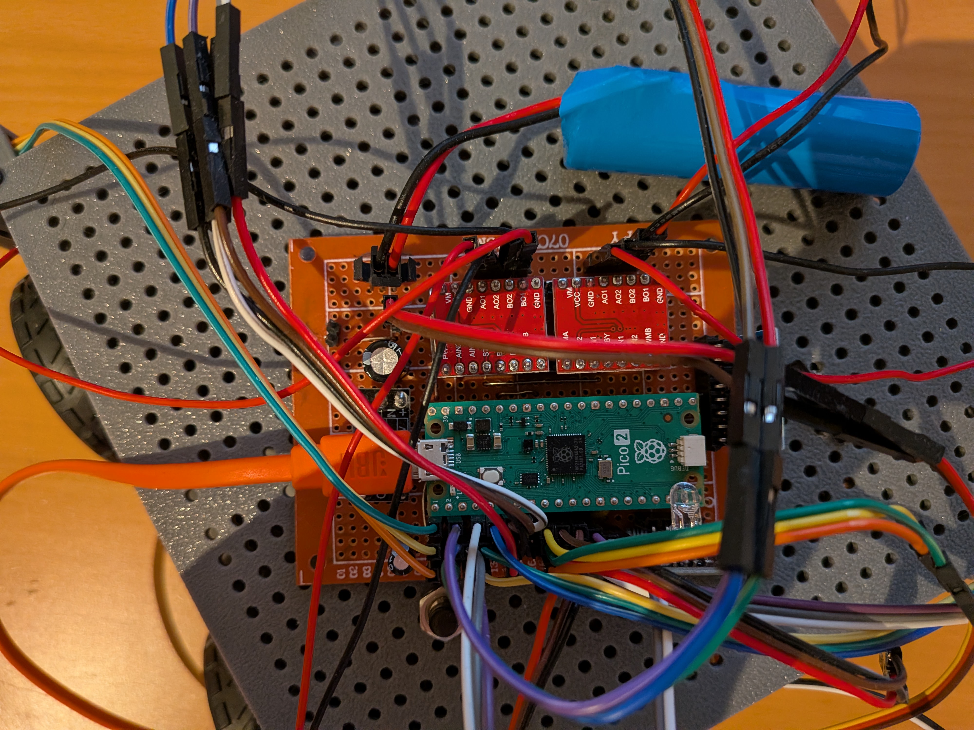
M6_Projekträsentation/gs_resource/PXL_20261104_212840806.jpg
