Project-CoasterBot/coasterbot/M6_Projekträsentation/gs_resource/v2_preview/front_cad.png

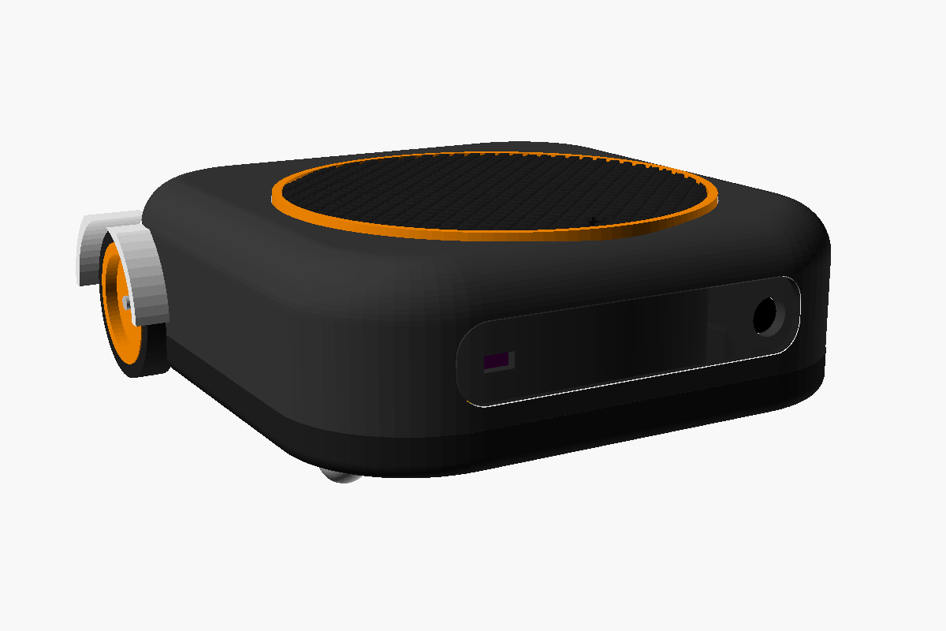
M6_Projekträsentation/gs_resource/v2_preview/front_cad.png
