Project-CoasterBot/coasterbot/M6_Projekträsentation/gs_resource/v2_preview/Screenshot From 2026-11-04 23-34-51.png

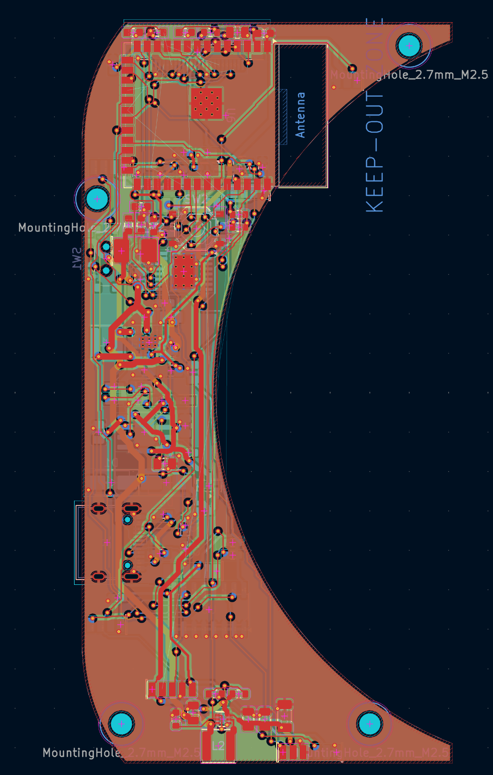
M6_Projekträsentation/gs_resource/v2_preview/Screenshot From 2026-11-04 23-34-51.png
