Project-CoasterBot/coasterbot/M6_Projekträsentation/gs_resource/v2_preview/section.png

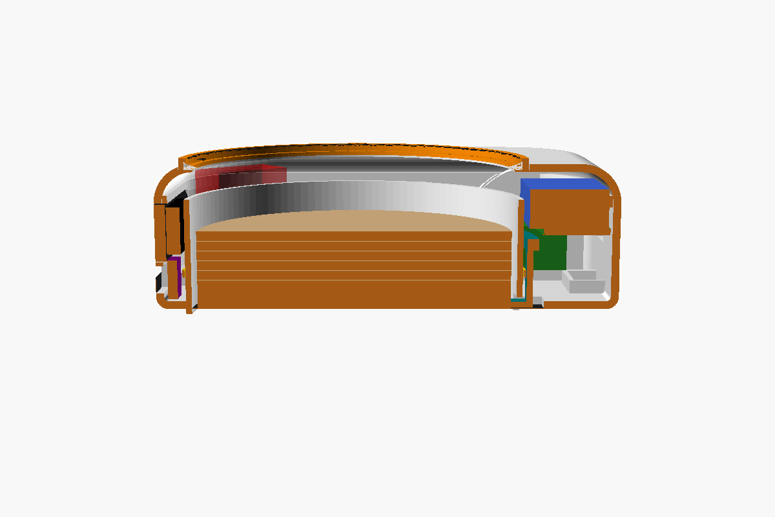
M6_Projekträsentation/gs_resource/v2_preview/section.png
