Project-CoasterBot/coasterbot/M3_Produktentwicklung/PoC_CoasterMechanism/Konstruktion/stl/CoasterMechanism_assembled.stl

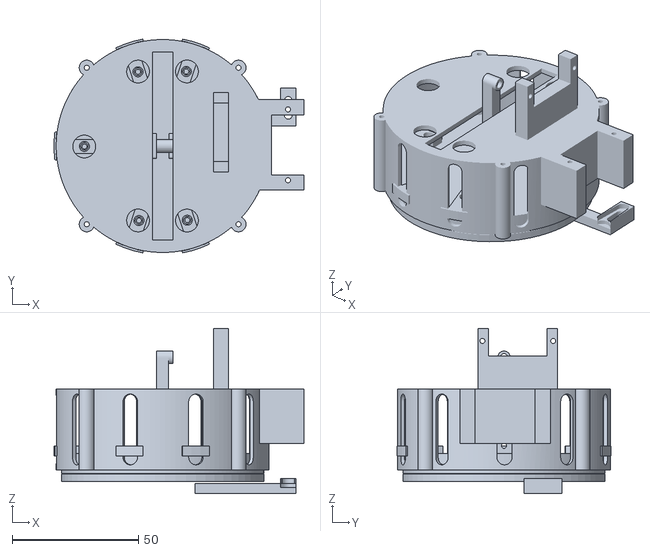
[picture p61: CAD file, 2026-08-16]
M3_Produktentwicklung/PoC_CoasterMechanism/Konstruktion/stl/CoasterMechanism_assembled.stl
98.9 x 84.6 x 65.4
