Project-CoasterBot/coasterbot/M3_Produktentwicklung/PoC_CoasterMechanism/Konstruktion/stl/CoasterMechanism_assembled_with_servos.stl

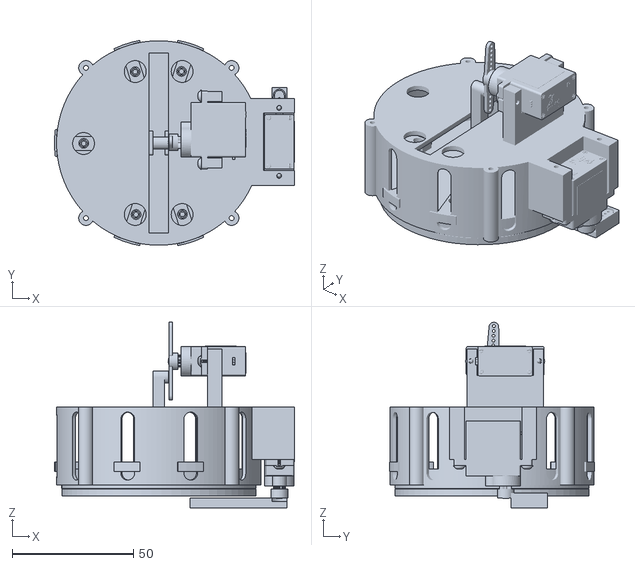
[picture p62: CAD file, 2026-08-16]
M3_Produktentwicklung/PoC_CoasterMechanism/Konstruktion/stl/CoasterMechanism_assembled_with_servos.stl
98.9 x 84.6 x 76.4
