Project-CoasterBot/coasterbot/M3_Produktentwicklung/PoC_CoasterMechanism/Konstruktion/CoasterMechanism_V5.step

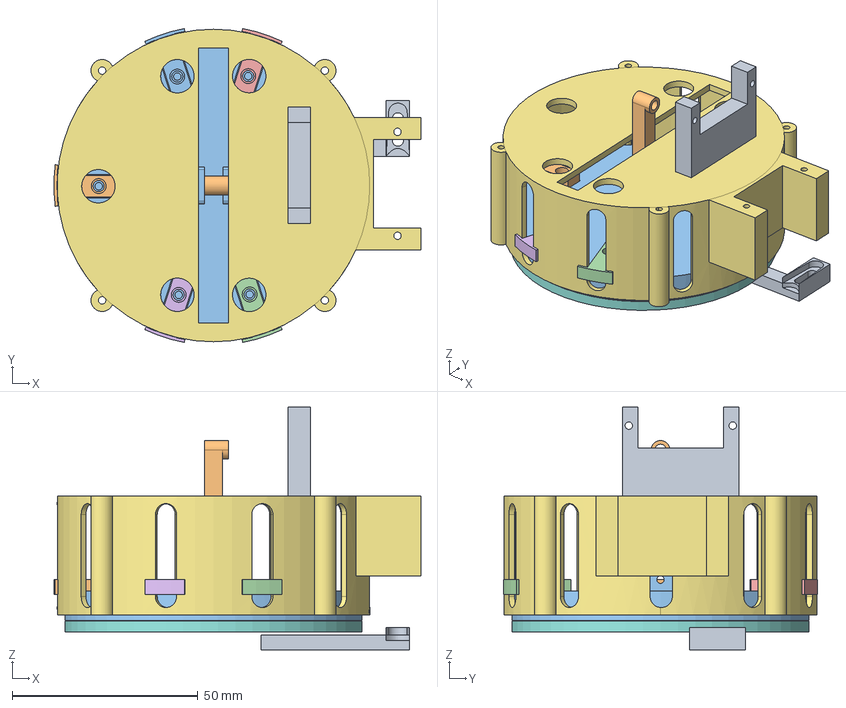
[picture p63: CAD file, 2026-08-16]
M3_Produktentwicklung/PoC_CoasterMechanism/Konstruktion/CoasterMechanism_V5.step
98.9 x 84.6 x 65.4 mm
Schieber
Führung
GehaeuseV3
Coaster
Servoholder
Verbinder
Stempel
