Project-CoasterBot/coasterbot/M4_Test-und-Validierung/lm393_motor_encoder/Motorhalterung_mit_sensorfixierung.stl

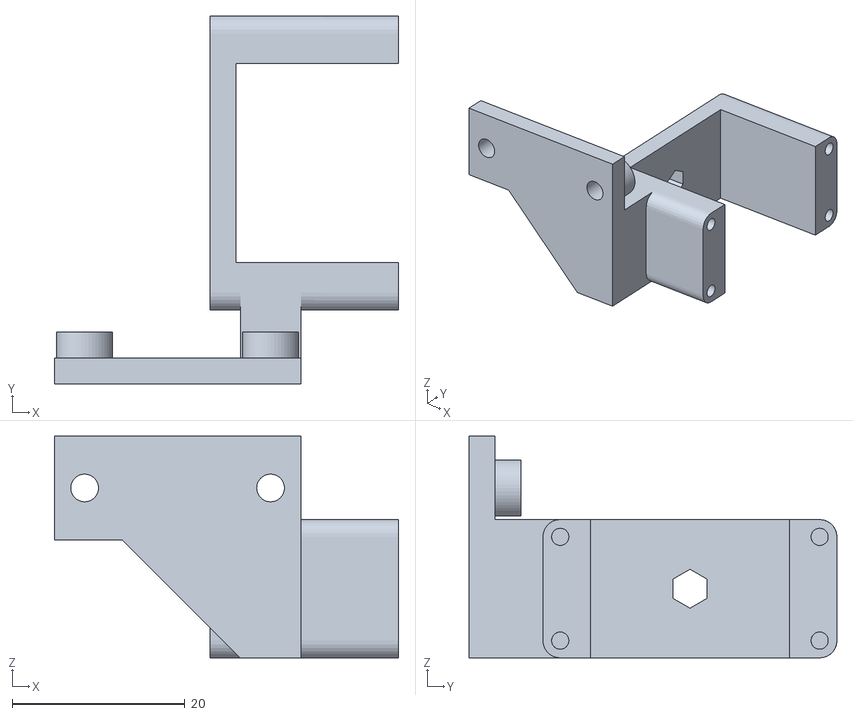
[picture p64: CAD file, 2026-10-04]
M4_Test-und-Validierung/lm393_motor_encoder/Motorhalterung_mit_sensorfixierung.stl
39.8 x 42.6 x 25.6
