Project-CoasterBot/coasterbot/M4_Test-und-Validierung/Mechanikkonzept/model/Coasterbot_V2_print.3mf

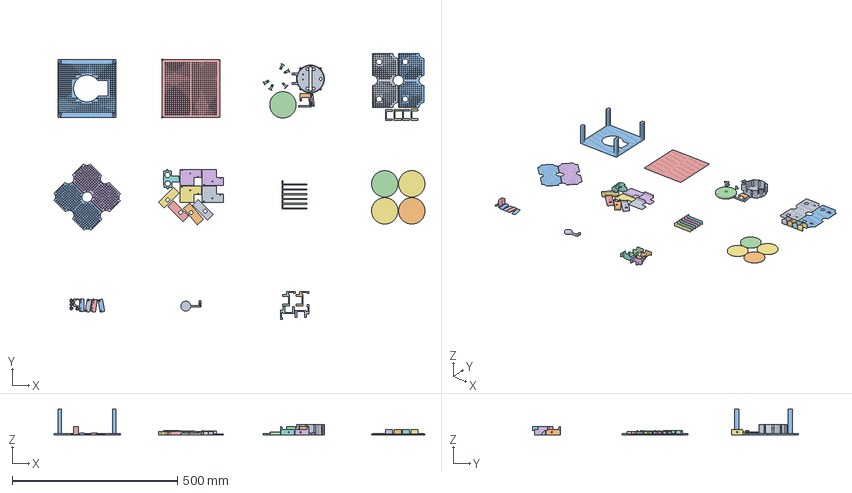
[picture p65: CAD file, 2026-10-18]
M4_Test-und-Validierung/Mechanikkonzept/model/Coasterbot_V2_print.3mf
1123.3 x 806.0 x 78.0 mm
Coaster_Frame.stl
Motorhalterung_mit_sensorfixierung.stl x 4
Platinenhalter_Klemmstueck x 2
Platinenhalter_Auflage x 2
Coaster x 4
Akkuhalter
LM393_Halter_li x 2
Abstandshalter x 4
Alternative Sensorhalterung x 6
LM393_Halter_re x 2
Halter_Ultraschallsensor
LM393_Abdeckung_li x 2
Außenwand_fuer_Motor.stl x 2
Heber_Stempel.stl
LM393_Abdeckung_re x 2
Wand_vorne_hinten.stl x 2
Führung.stl
Servohalter_Heber.stl
Ausschieber_Aufleger.stl
Cap.stl
Heberverbinder.stl
Motorfixierung.stl x 4
Coasterbot-Base.stl
Ausschieber_V2
