Project-CoasterBot/coasterbot/M4_Test-und-Validierung/webots/protos/coasterbot/meshes/wheel_rr.stl

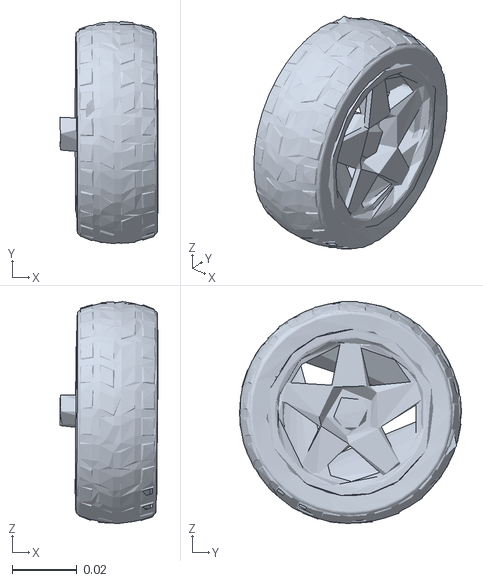
[picture p66: CAD file, 2026-09-07]
M4_Test-und-Validierung/webots/protos/coasterbot/meshes/wheel_rr.stl
0.0304 x 0.0689 x 0.0688
