Project-CoasterBot/coasterbot/M3_Produktentwicklung/PoC_CoasterMechanism/Konstruktion/CoasterMechanism_V5_with_Servos.step

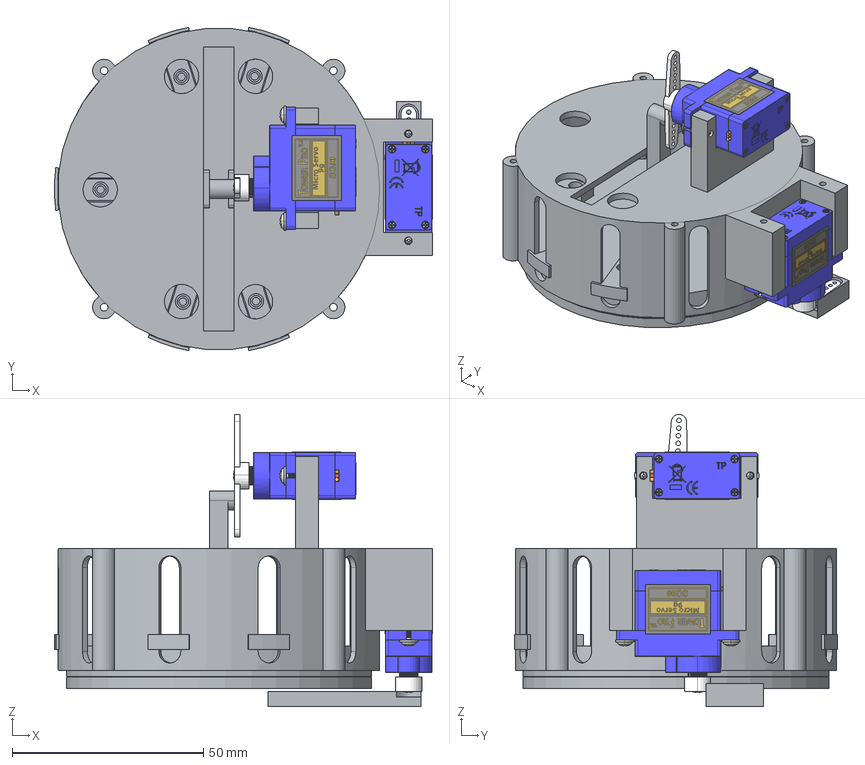
[picture p67: CAD file, 2026-08-16]
M3_Produktentwicklung/PoC_CoasterMechanism/Konstruktion/CoasterMechanism_V5_with_Servos.step
98.9 x 84.6 x 76.4 mm
Schieber
SG90 - Micro Servo 9g - Tower Pro.1
SG90 - Micro Servo 9g - Tower Pro.2
SG90 - Micro Servo 9g - Tower Pro.5_BS EN ISO 7045 - M2 x 8 - Z - 8S003 x 2
SG90 - Micro Servo 9g - Tower Pro.6_BS EN ISO 7045 - M2 x 4 - Z - 4S001
SG90 - Micro Servo 9g - Tower Pro.1_Pe
SG90 - Micro Servo 9g - Tower Pro.3_Pe
SG90 - Micro Servo 9g - Tower Pro.5_BS EN ISO 7045 - M2 x 8 - Z - 8S x 2
SG90 - Micro Servo 9g - Tower Pro.6_BS EN ISO 7045 - M2 x 4 - Z - 4S
Führung
GehaeuseV3
Coaster
Servoholder
Verbinder
Stempel
