Project-CoasterBot/coasterbot/M4_Test-und-Validierung/webots/protos/coasterbot/meshes/wheel_rl.stl

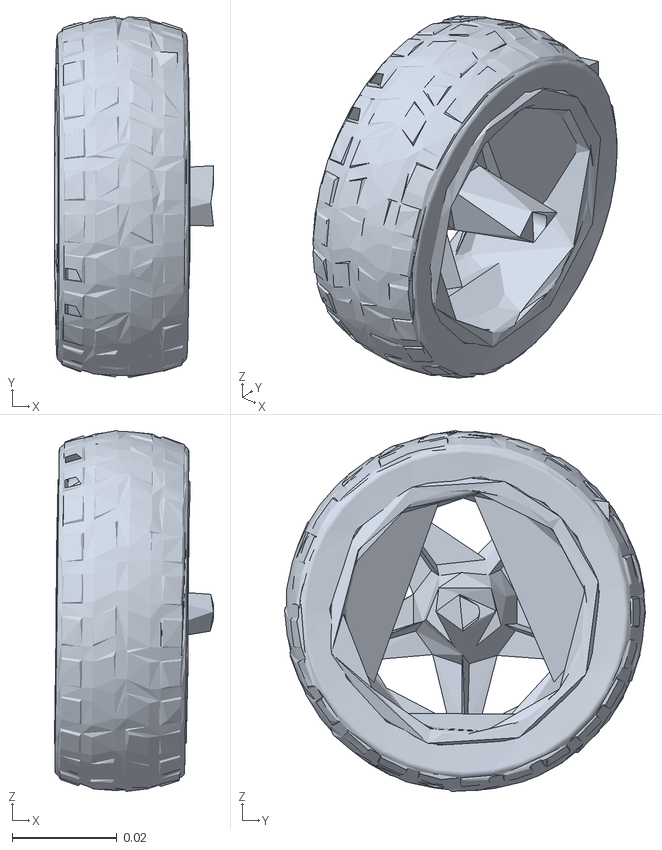
[picture p68: CAD file, 2026-09-07]
M4_Test-und-Validierung/webots/protos/coasterbot/meshes/wheel_rl.stl
0.0304 x 0.069 x 0.069
