Project-CoasterBot/coasterbot/M3_Produktentwicklung/PoC_CoasterMechanism/Konstruktion/stl/CoasterMechanism-Stempel.stl

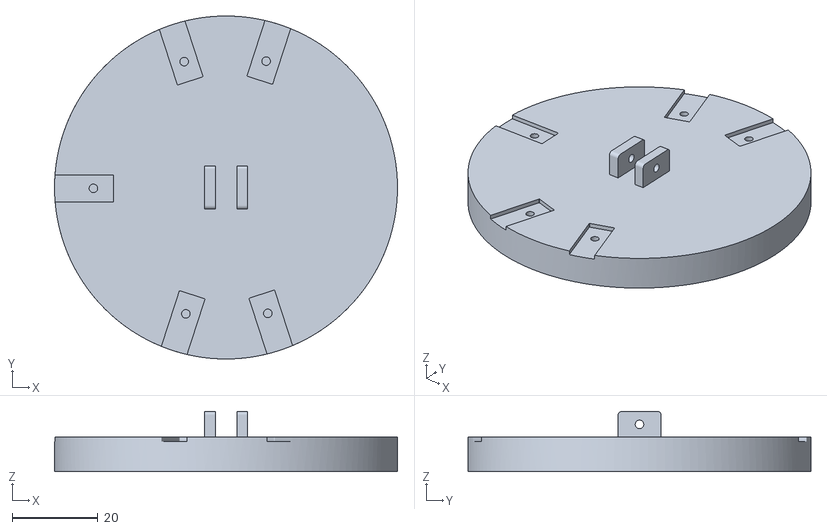
[picture p69: CAD file, 2026-08-16]
M3_Produktentwicklung/PoC_CoasterMechanism/Konstruktion/stl/CoasterMechanism-Stempel.stl
80.0 x 80.0 x 14.0
