Project-CoasterBot/coasterbot/M4_Test-und-Validierung/Mechanikkonzept/model/coasterbot_stl/Ausschieber_V2.stl

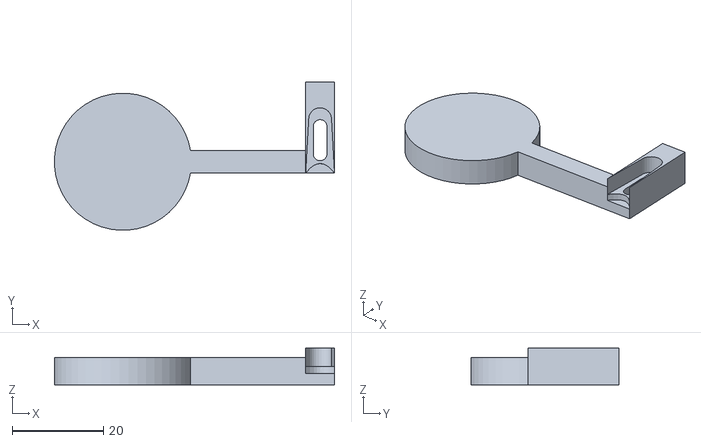
[picture p70: CAD file, 2026-10-18]
M4_Test-und-Validierung/Mechanikkonzept/model/coasterbot_stl/Ausschieber_V2.stl
61.3 x 32.5 x 8.00
