Project-CoasterBot/coasterbot/M4_Test-und-Validierung/webots/protos/coasterbot/meshes/chassis.stl

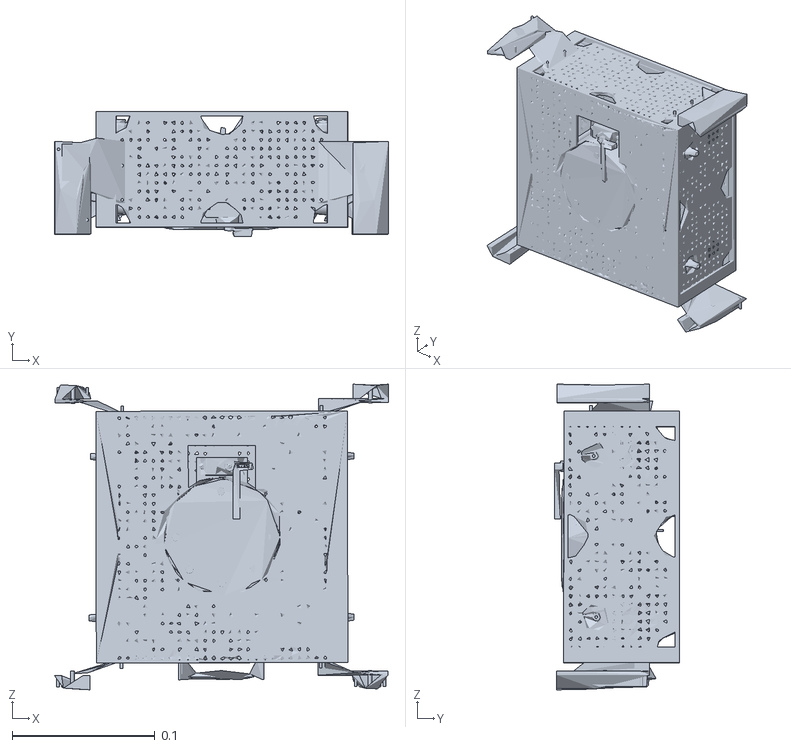
[picture p71: CAD file, 2026-09-07]
M4_Test-und-Validierung/webots/protos/coasterbot/meshes/chassis.stl
0.234 x 0.0876 x 0.214
