Project-CoasterBot/coasterbot/M3_Produktentwicklung/PoC_CoasterMechanism/Konstruktion/stl/CoasterMechanism-Coaster.stl

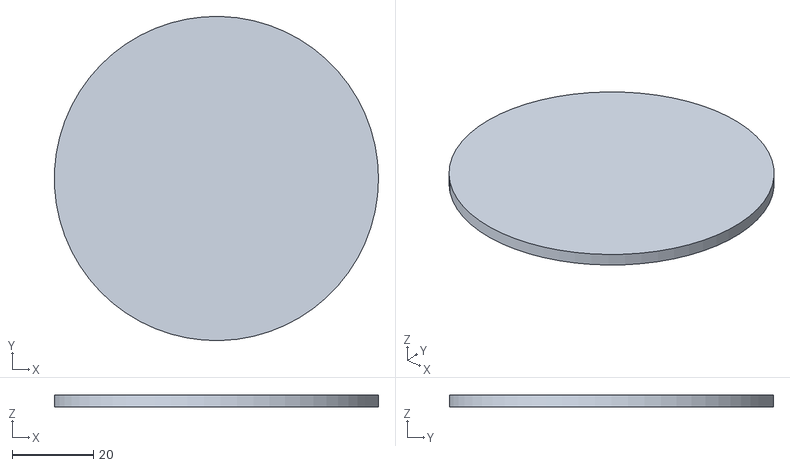
[picture p72: CAD file, 2026-08-16]
M3_Produktentwicklung/PoC_CoasterMechanism/Konstruktion/stl/CoasterMechanism-Coaster.stl
79.9 x 80.0 x 3.00
