Project-CoasterBot/coasterbot/M4_Test-und-Validierung/Mechanikkonzept/model/coasterbot_stl/Heberverbinder.stl.stl

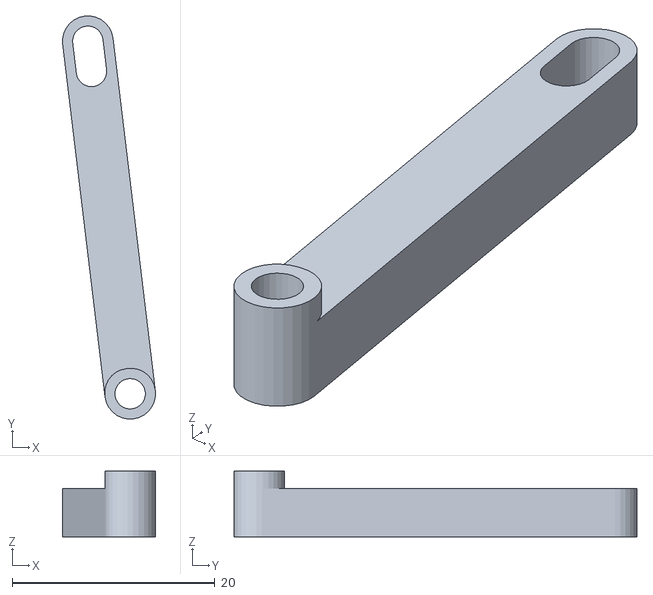
[picture p73: CAD file, 2026-08-28]
M4_Test-und-Validierung/Mechanikkonzept/model/coasterbot_stl/Heberverbinder.stl.stl
9.14 x 39.7 x 6.50
