Project-CoasterBot/coasterbot/M4_Test-und-Validierung/webots/protos/coasterbot/meshes/wheel_fr.stl

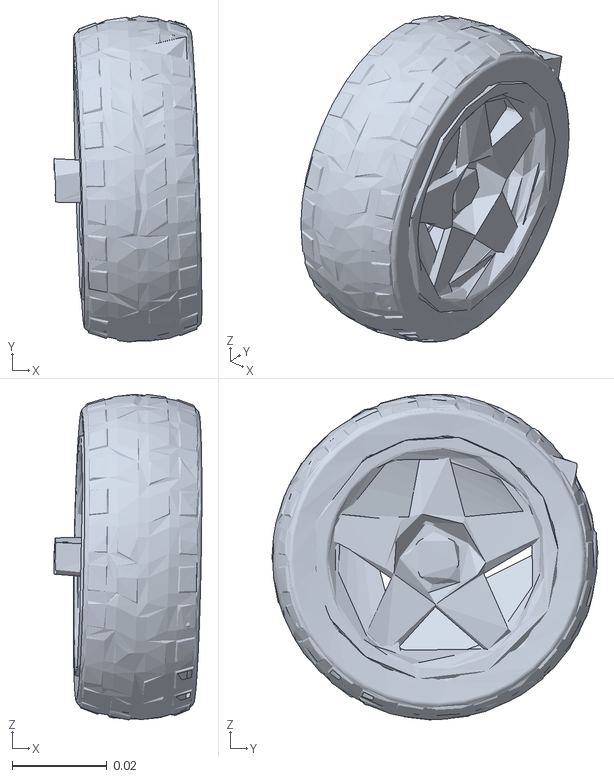
[picture p74: CAD file, 2026-09-07]
M4_Test-und-Validierung/webots/protos/coasterbot/meshes/wheel_fr.stl
0.0312 x 0.069 x 0.0689
