Project-CoasterBot/coasterbot/M3_Produktentwicklung/PoC_CoasterMechanism/Konstruktion/stl/CoasterMechanism-Servoholder.stl

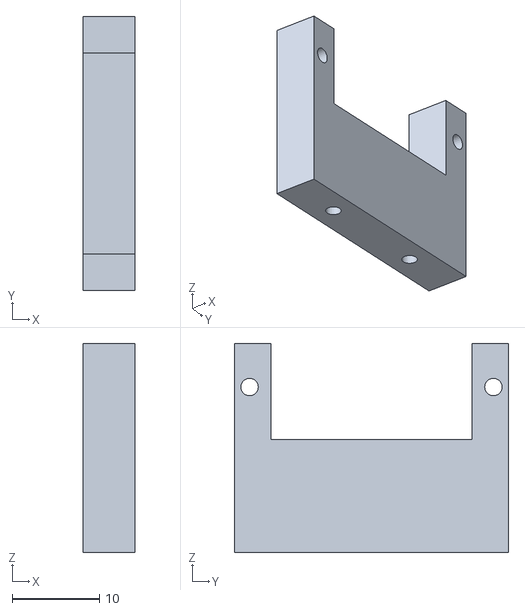
[picture p75: CAD file, 2026-08-16]
M3_Produktentwicklung/PoC_CoasterMechanism/Konstruktion/stl/CoasterMechanism-Servoholder.stl
6.00 x 31.5 x 24.0
