Project-CoasterBot/coasterbot/M4_Test-und-Validierung/Mechanikkonzept/model/coasterbot_stl/Motorfixierung.stl.stl

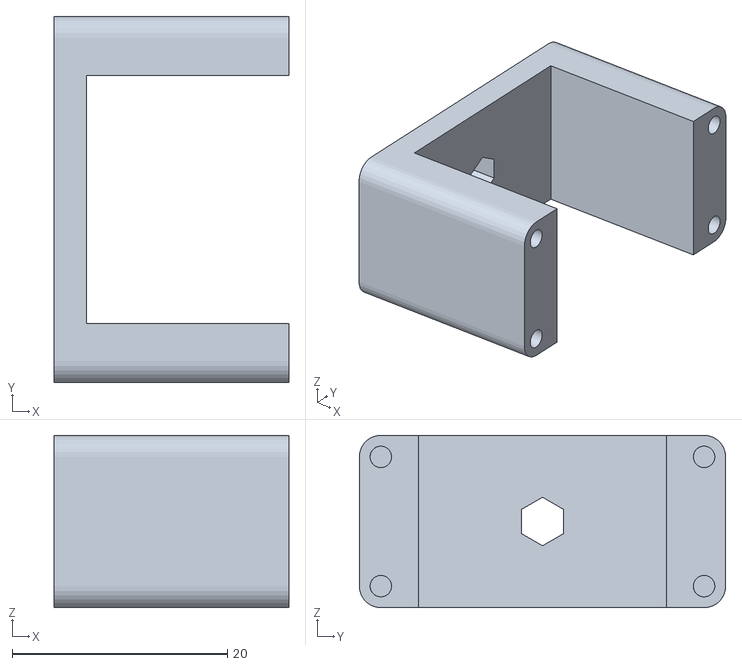
[picture p76: CAD file, 2026-08-28]
M4_Test-und-Validierung/Mechanikkonzept/model/coasterbot_stl/Motorfixierung.stl.stl
21.8 x 34.0 x 16.0
