Project-CoasterBot/coasterbot/M4_Test-und-Validierung/webots/protos/coasterbot/meshes/wheel_fl.stl

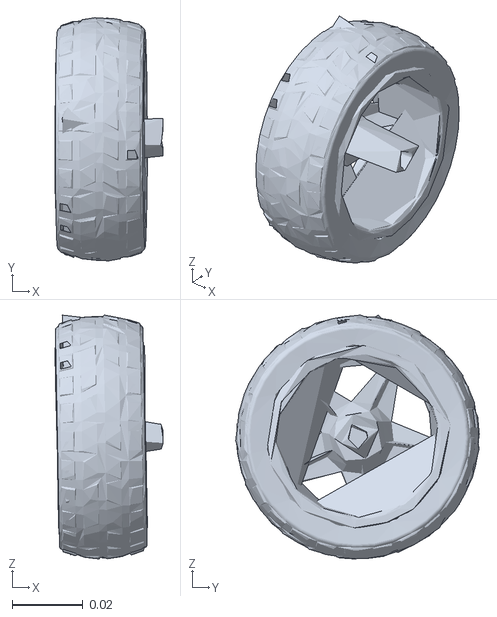
[picture p77: CAD file, 2026-09-07]
M4_Test-und-Validierung/webots/protos/coasterbot/meshes/wheel_fl.stl
0.0307 x 0.069 x 0.0691
