Project-CoasterBot/coasterbot/M4_Test-und-Validierung/Mechanikkonzept/model/coasterbot_stl/Führung.stl.stl

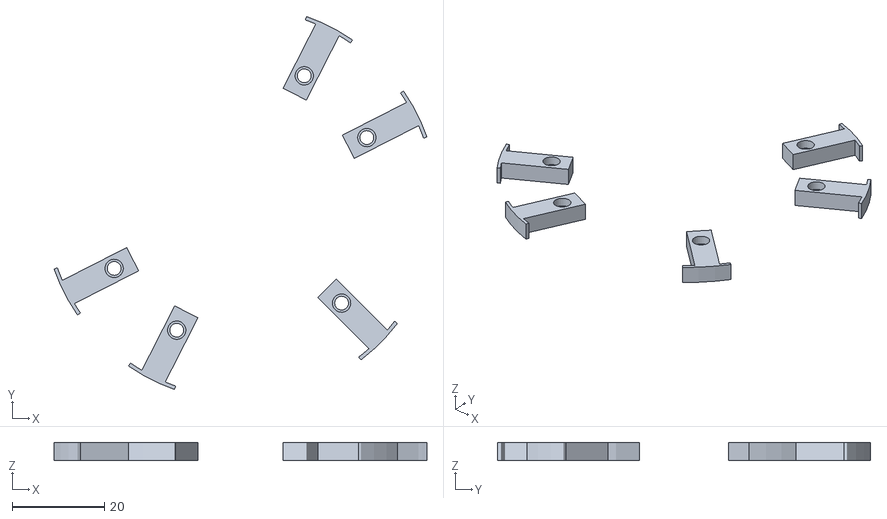
[picture p79: CAD file, 2026-08-28]
M4_Test-und-Validierung/Mechanikkonzept/model/coasterbot_stl/Führung.stl.stl
81.1 x 81.1 x 4.00
