Project-CoasterBot/coasterbot/M4_Test-und-Validierung/Mechanikkonzept/model/coasterbot_stl/Wand_vorne_hinten.stl.stl

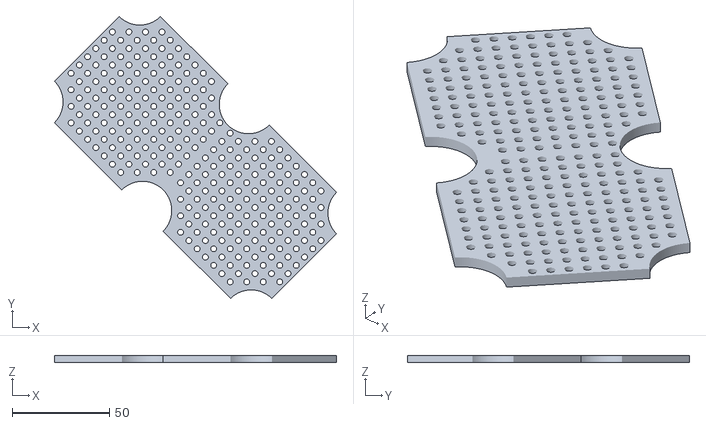
[picture p81: CAD file, 2026-08-28]
M4_Test-und-Validierung/Mechanikkonzept/model/coasterbot_stl/Wand_vorne_hinten.stl.stl
144.8 x 144.8 x 3.65
