Project-CoasterBot/coasterbot/M4_Test-und-Validierung/Mechanikkonzept/model/coasterbot_stl/Servohalter_Heber.stl.stl

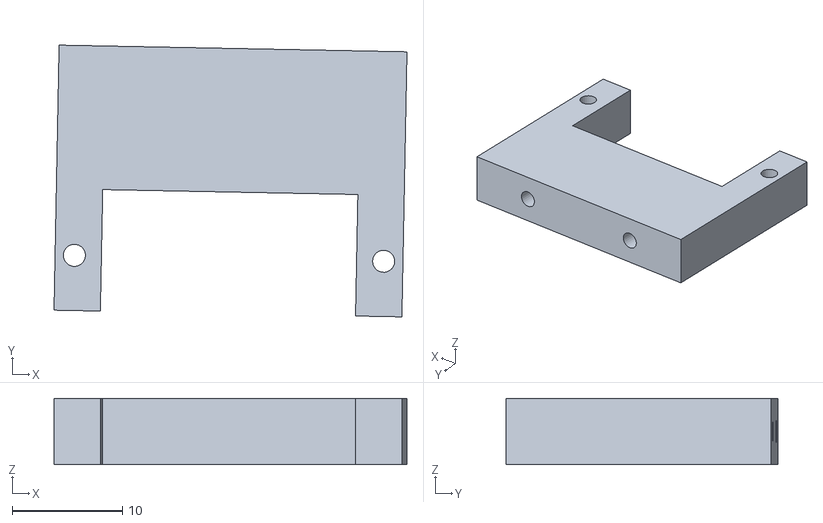
[picture p83: CAD file, 2026-08-28]
M4_Test-und-Validierung/Mechanikkonzept/model/coasterbot_stl/Servohalter_Heber.stl.stl
32.0 x 24.6 x 6.00
