Project-CoasterBot/coasterbot/M4_Test-und-Validierung/Mechanikkonzept/model/coasterbot_stl/LM393_Halter_re.stl

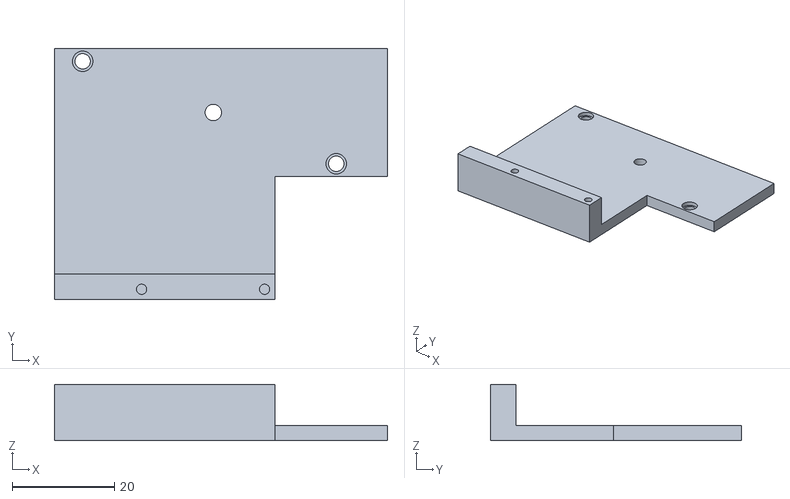
[picture p85: CAD file, 2026-08-28]
M4_Test-und-Validierung/Mechanikkonzept/model/coasterbot_stl/LM393_Halter_re.stl
65.0 x 49.0 x 11.0
