Project-CoasterBot/coasterbot/M4_Test-und-Validierung/Mechanikkonzept/model/coasterbot_stl/LM393_Abdeckung_re.stl

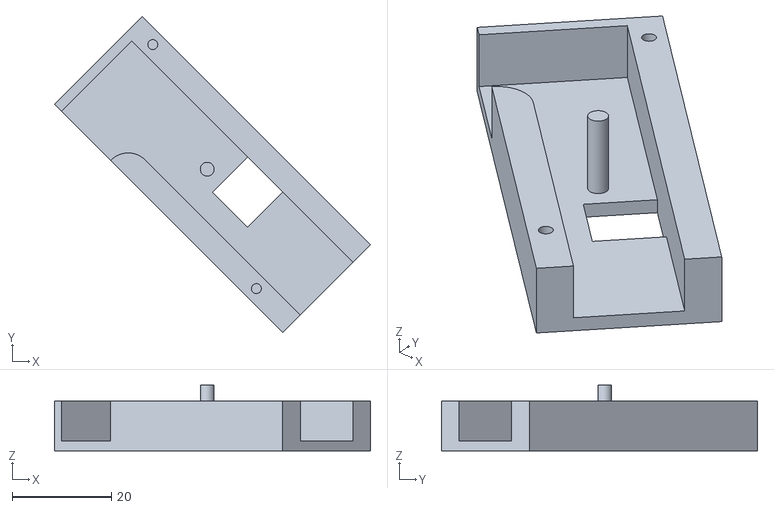
[picture p86: CAD file, 2026-08-28]
M4_Test-und-Validierung/Mechanikkonzept/model/coasterbot_stl/LM393_Abdeckung_re.stl
63.6 x 63.6 x 13.2
