Project-CoasterBot/coasterbot/M4_Test-und-Validierung/Mechanikkonzept/model/coasterbot_stl/Alternative Sensorhalterung.stl

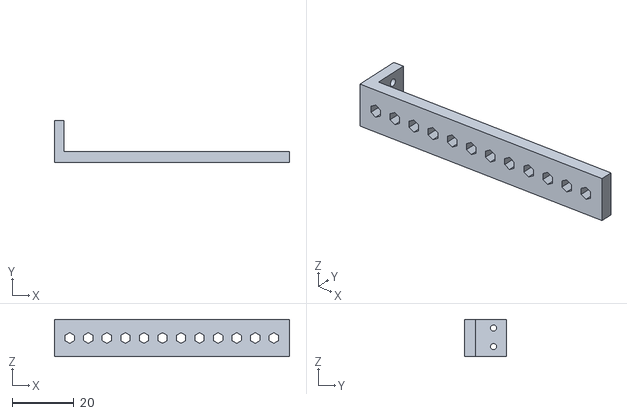
[picture p88: CAD file, 2026-08-28]
M4_Test-und-Validierung/Mechanikkonzept/model/coasterbot_stl/Alternative Sensorhalterung.stl
76.0 x 13.6 x 12.0
