Project-CoasterBot/coasterbot/M4_Test-und-Validierung/Mechanikkonzept/model/coasterbot_stl/Halter_Ultraschallsensor.stl

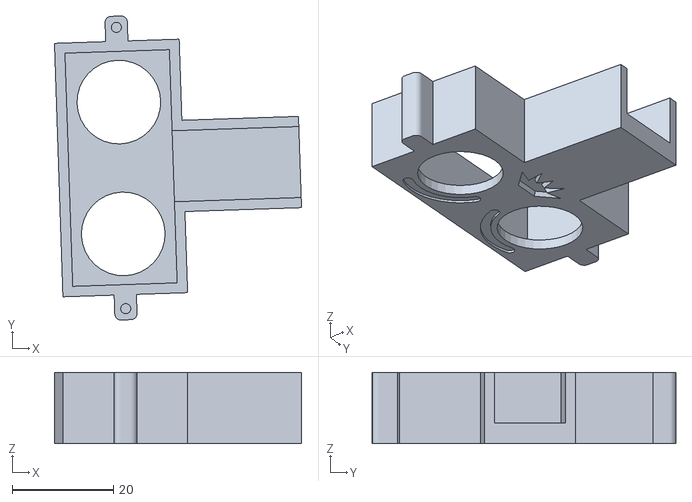
[picture p89: CAD file, 2026-08-28]
M4_Test-und-Validierung/Mechanikkonzept/model/coasterbot_stl/Halter_Ultraschallsensor.stl
48.7 x 59.9 x 14.0
