Project-CoasterBot/coasterbot/M4_Test-und-Validierung/Mechanikkonzept/model/coasterbot_stl/Coasterbot-Base.stl.stl

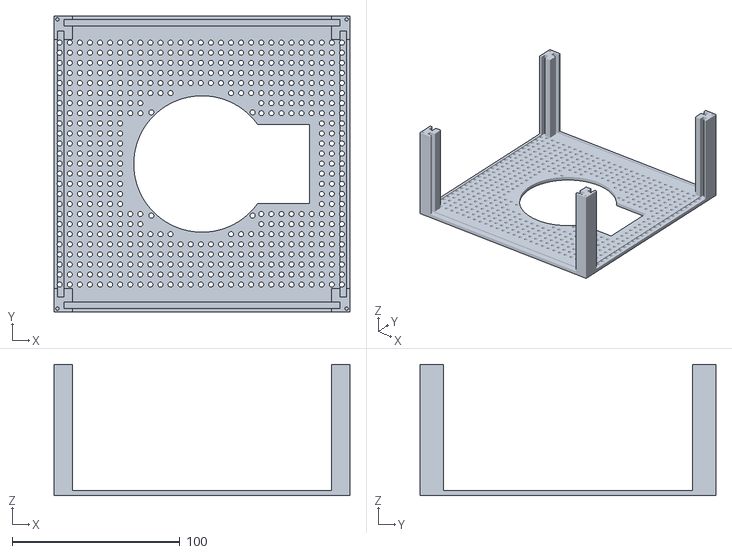
[picture p90: CAD file, 2026-08-26]
M4_Test-und-Validierung/Mechanikkonzept/model/coasterbot_stl/Coasterbot-Base.stl.stl
176.2 x 176.2 x 78.0
