Project-CoasterBot/coasterbot/M4_Test-und-Validierung/Mechanikkonzept/model/coasterbot_stl/Außenwand_fuer_Motor.stl.stl

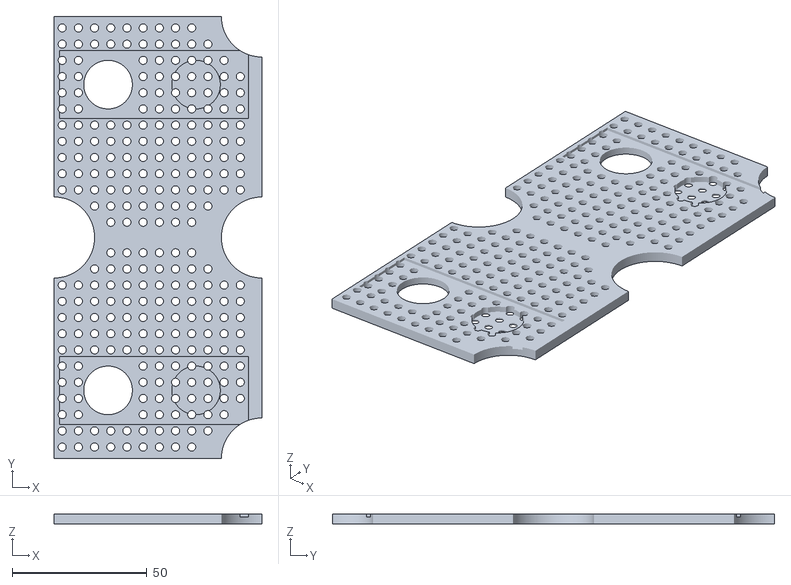
[picture p91: CAD file, 2026-08-24]
M4_Test-und-Validierung/Mechanikkonzept/model/coasterbot_stl/Außenwand_fuer_Motor.stl.stl
77.0 x 163.8 x 3.60
