Project-CoasterBot/coasterbot/M4_Test-und-Validierung/Mechanikkonzept/model/coasterbot_stl/Cap.stl.stl

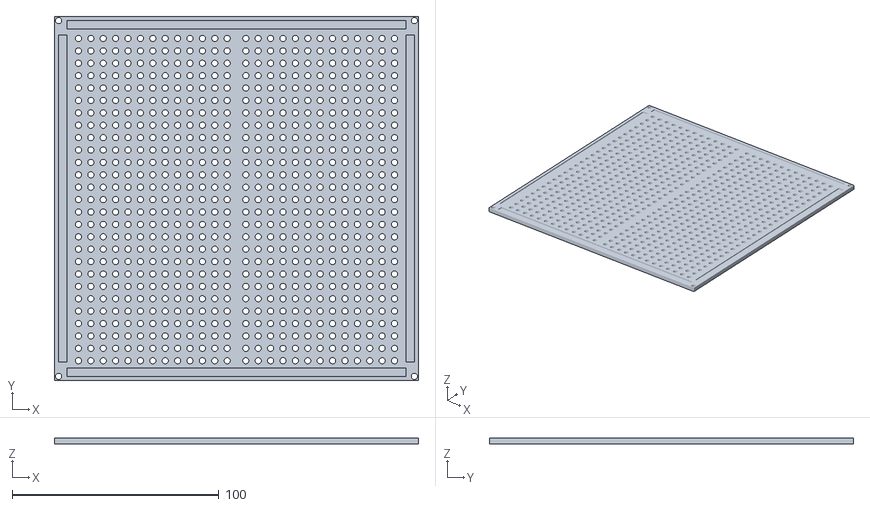
[picture p92: CAD file, 2026-08-24]
M4_Test-und-Validierung/Mechanikkonzept/model/coasterbot_stl/Cap.stl.stl
176.2 x 176.2 x 3.00
