Project-CoasterBot/coasterbot/(list of files, cad)

Other CAD files:
M4_Test-und-Validierung/Mechanikkonzept/model/coasterbot_stl/Motorhalterung_mit_sensorfixierung.stl
M4_Test-und-Validierung/Mechanikkonzept/model/coasterbot_stl/Motorhalterung_mit_sensorfixierung_mirrored.stl
M4_Test-und-Validierung/Mechanikkonzept/model/coasterbot_stl/LM393_Halter_li.stl
M4_Test-und-Validierung/Mechanikkonzept/model/coasterbot_stl/LM393_Abdeckung_li.stl
M4_Test-und-Validierung/Mechanikkonzept/model/coasterbot_stl/Ausschieber_Aufleger.stl.stl
M4_Test-und-Validierung/Mechanikkonzept/model/coasterbot_stl/Coaster_Frame.stl.stl
M4_Test-und-Validierung/Mechanikkonzept/model/coasterbot_stl/Heber_Stempel.stl.stl
M3_Produktentwicklung/PoC_CoasterMechanism/Konstruktion/CoasterMechanism_V5.3mf
M3_Produktentwicklung/PoC_CoasterMechanism/Konstruktion/CoasterMechanism_V5_with_Servos.3mf
