Project-CoasterBot/coasterbot/M4_Test-und-Validierung/aufbauanleitung/db_anmerkungen.md

# 18.10.2026

## Anmerkungen

- Kapitel 2.1 Erster Paragraph: FreeCad Projekt wird nicht bereitgestellt, sondern eine 3mf Datein zum Druck.
- Seite 12: Einen Seitenumbruch vor "Vorsicht" erzwingen?
- Kapitel 2.7: Inertialsensor in Klammern. Muss der noch durch den MPU ersetzt werden?
- Kapitel 2.8: Warnung eigentlich überflüssig, oder?
