Project-CoasterBot/coasterbot/M4_Test-und-Validierung/aufbauanleitung/Aufbauanleitung_compressed.pdf

Wilhelm Büchner University of Applied Sciences Projektseminar Master

Coasterbot

Aufbauanleitung

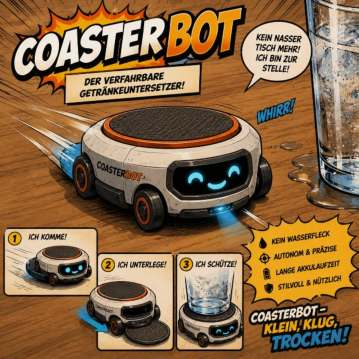
[picture p139: figure]

Dennis Borutta, B. Eng dennis.borutta@outlook.com Stefan Etringer, B. Eng mail@stefan.works
Gereon Such, M. Sc. gereonsuch@gmail.com

Versionshistorie

Version | Datum | Bearbeiter | Änderung
1 | 28.08.2026 | Such | Erstfassung, zunächst nur Elektronik
2 | 18.09.2026 | Such | Gehäusemontage ergänzt
3 | 20.10.2026 | Etringer | Layout und Ergänzungen

### 1 Allgemeines

Dieses Dokument beschreibt die Schritte zum Aufbau eines funktionsfähigen Prototypen aus den Komponenten laut Stückliste. Die Einzelkomponenten sowie die Firmware werden in separaten Dokumenten beschrieben.
Folgende Fähigkeiten und Werkzeuge werden für die Montage vorausgesetzt:
1. 3D Drucker für den Druck des Chassis
2. Grundlegende Erfahrung im Umgang mit dem genutzten 3D Drucker
3. Montagewerkzeug für die Chassis Schrauben
4. Grundlegende Fähigkeiten in der Feinmechanik
5. Lötwerkzeug
6. Fortgeschrittene Fähigkeiten im Umgang mit Elektronik und Lochrasterplatinenmontage

Abbildung 1 zeigt die Gesamtschaltung der Elektronik. Die Komponenten sind weitestgehend als Dev-Boards integriert und auch als solche im Schaltplan aufgeführt. Das Dokument BOM beschreibt die jeweiligen Komponenten sowie die Bezugsquelle.

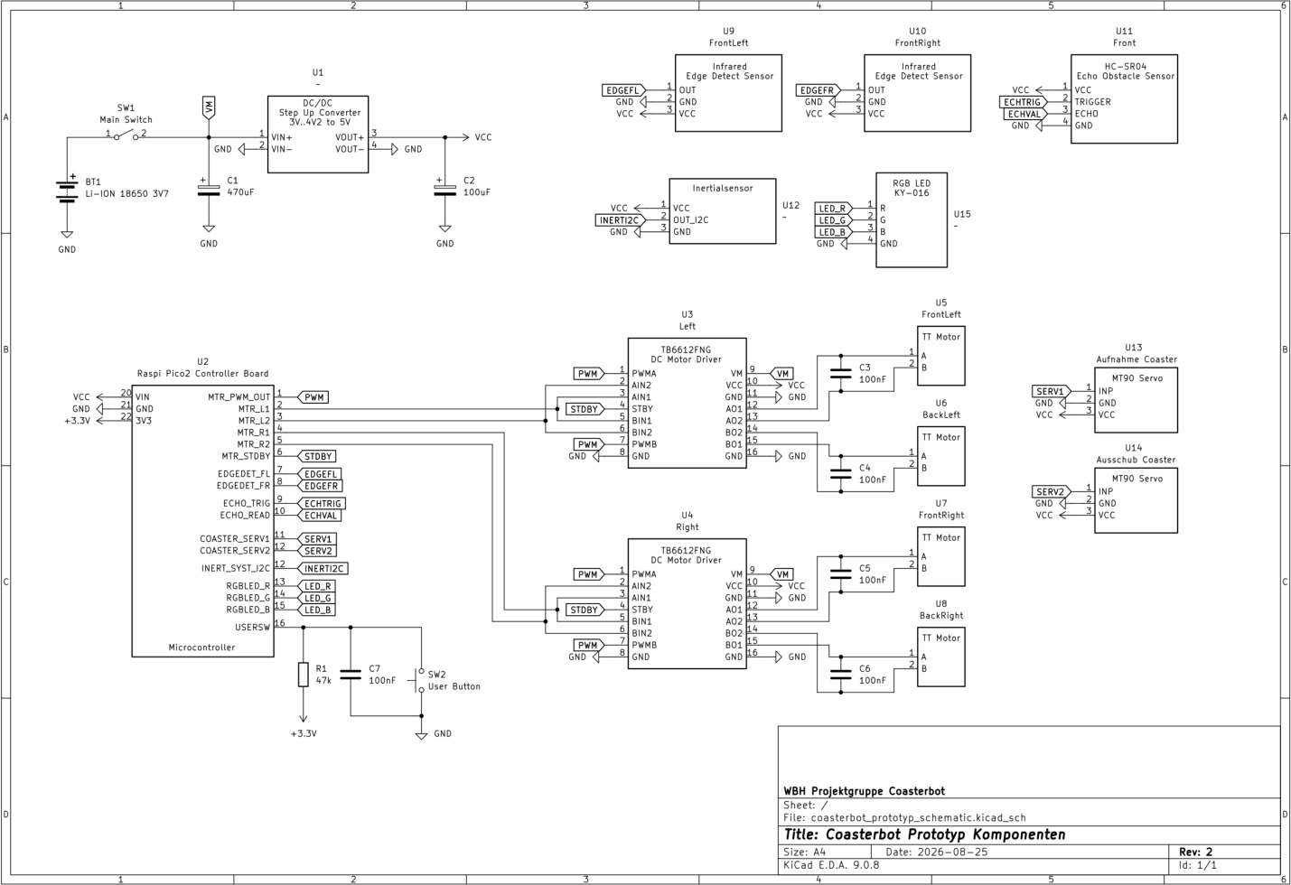
[picture p140: page 4]

Abbildung 1: Gesamtschaltung

4

### 2 Montage

2.1 3D Druck des Chassis
Das Chassis des Coasterbots wurde mit FreeCAD entwickelt und wird sowohl im 3D Manufacturing Format (3MF) Format als auch in fertigen .stl Dateien im Github Repository 1 bereitgestellt. Für den einfachen 3D Druck genügen hier die .stl Dateien.
Diese müssen heruntergeladen und dann entsprechend des genutzten 3D Druckers geslicet werden, dazu kann z.B. der Orca-Slicer 2 genutzt werden, welcher eine Vielzahl von 3D Druckern und Interfaces zu diesen Druckern unterstützt. Nach dem Slicen können die Komponenten entweder über eine Netzwerkschnittstelle oder Peripherie Medium wie SD Karte an den 3D Drucker übertragen werden. Insgesamt wird für das Projekt ca. 500g PLA Medium benötigt, es können aber auch andere Materialien wie PETG verwendet werden.

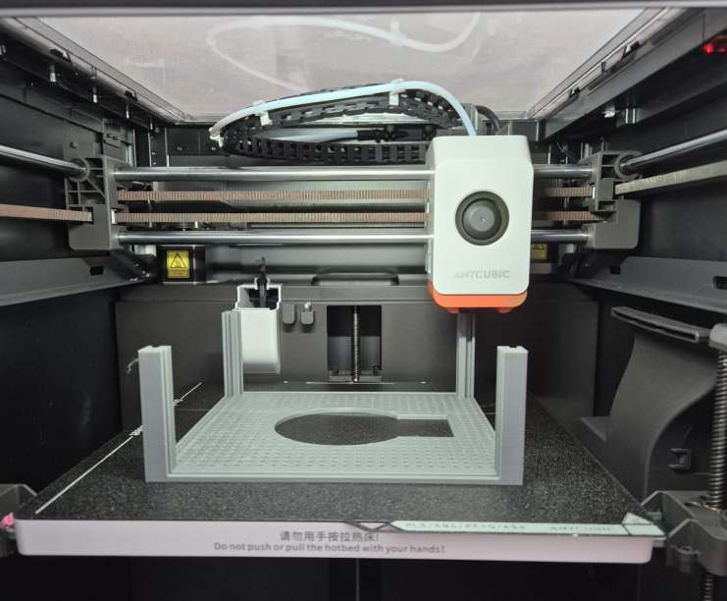
[picture p141: figure]

1
https://github.com/Project-CoasterBot/coasterbot/tree/main

2
https://www.orcaslicer.com/

### 2.2 Chassis Grundgerüst montieren

Zunächst wird hier das Coaster Reservoir auf die Grundplatte montiert:

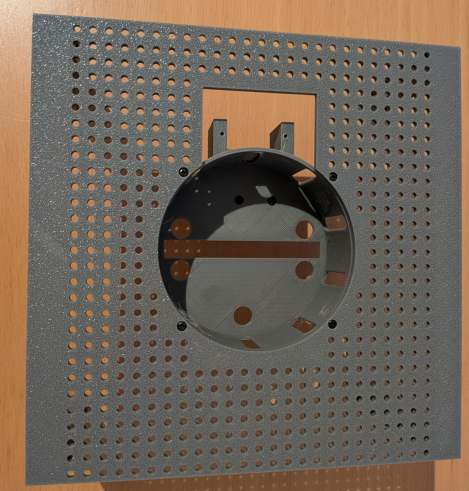
[picture p142: figure]
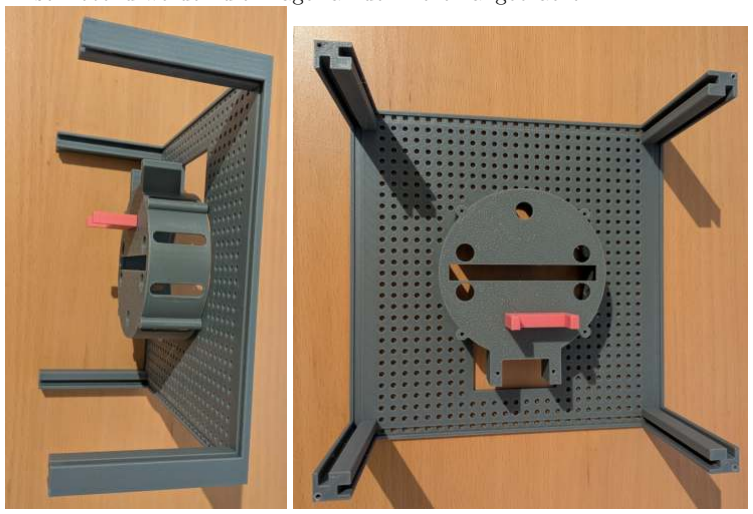
[picture p143: figure]

Anschließend werden die Träger an den Ecken angebracht:

### 2.3 Coastermechanismus Montieren

Nun wird der Mechanismus zur Coasteraufnahme montiert:

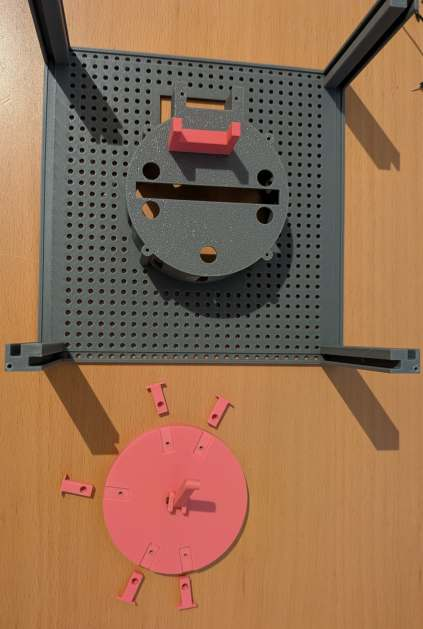
[picture p144: figure]

Dazu muss der Träger zunächst ohne die Führungsachsen in die Coasteraufnahme eingelegt werden, anschließend werden die Führungsachsen von außen auf der Coasteraufnahme verschraubt. Die Coasteraufnahme hat dazu auf der Oberseite Löcher zum durchführen eines Schraubenziehers.

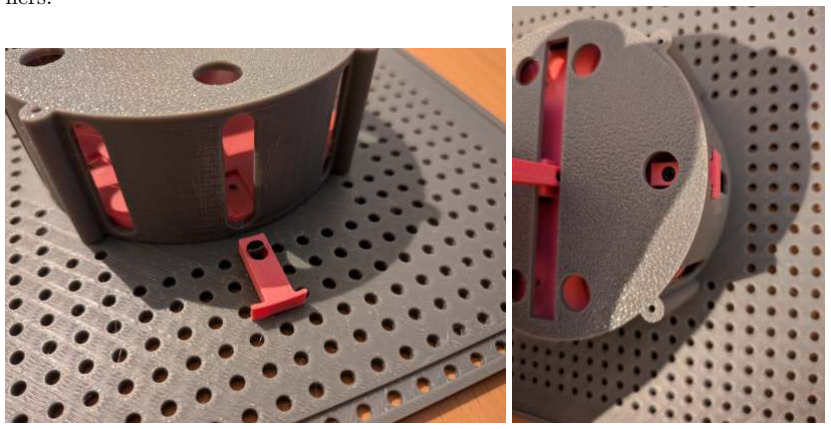
[picture p145: figure]

Dieser Vorgang wird für alle 5 Führungsachsen wiederholt:

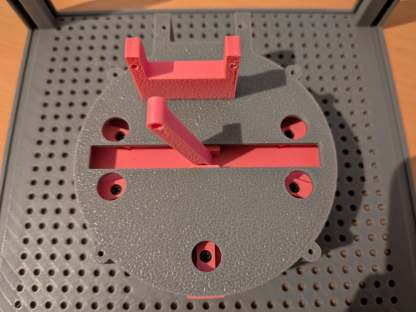
[picture p146: figure]

VORSICHT!
Wenn in den Öffnungen für die Führungsachsen wie in der nachfolgenden Darstellung gezeigt noch Reste des 3D-Drucks sind müssen diese nun entfernt werden, andernfalls ist die Bewegung des Coasterträgers nicht flüßig.

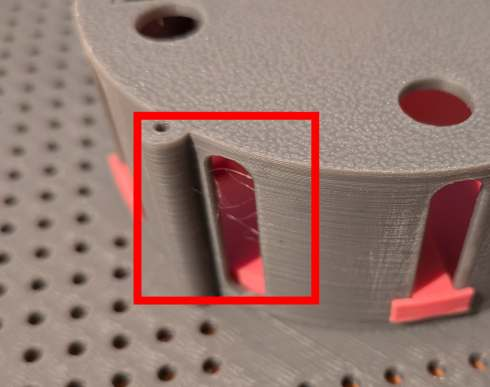
[picture p147: figure]

### 2.4 Coasteraufnahme Servos montieren

Nun werden die Servos auf der Coasteraufnahme montiert. Zunächst wird der obere Servo eingesetzt und beidseitig verschraubt.

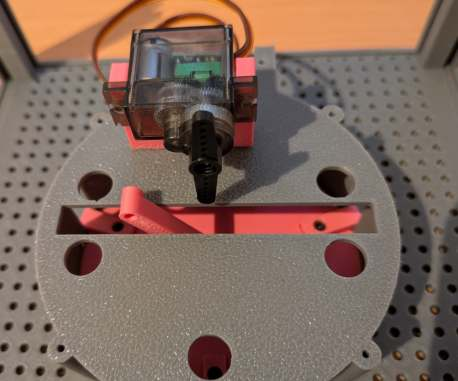
[picture p148: figure]

An diesem wird nun der Zugträger des Coasteraufnahmemechanimus befestigt:

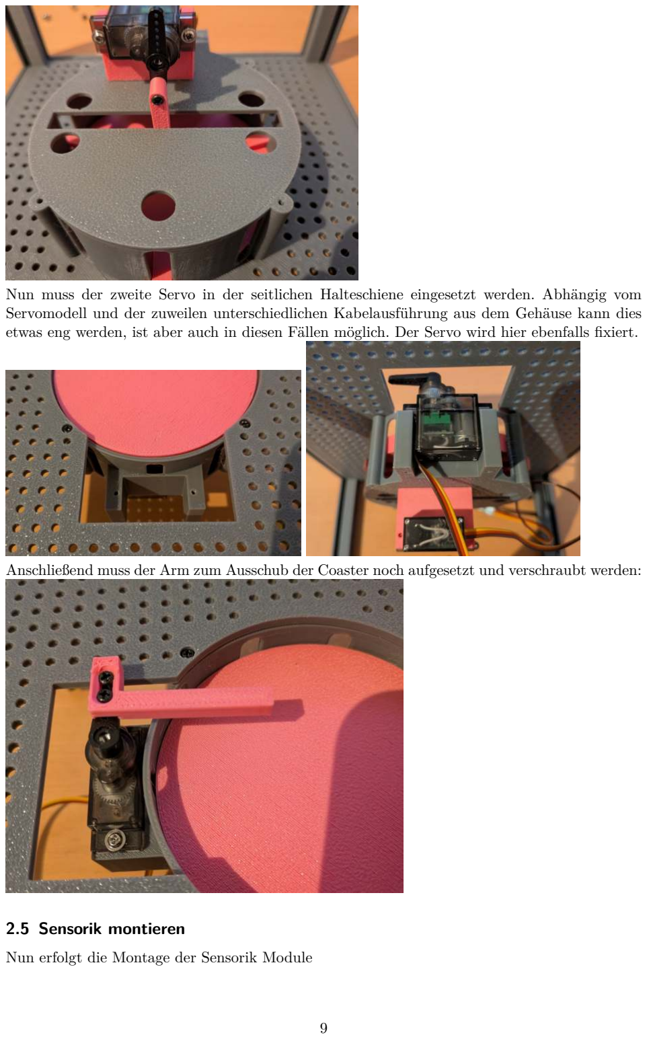
[picture p149: page 9]

Nun muss der zweite Servo in der seitlichen Halteschiene eingesetzt werden. Abhängig vom Servomodell und der zuweilen unterschiedlichen Kabelausführung aus dem Gehäuse kann dies etwas eng werden, ist aber auch in diesen Fällen möglich. Der Servo wird hier ebenfalls fixiert.

Anschließend muss der Arm zum Ausschub der Coaster noch aufgesetzt und verschraubt werden:

### 2.5 Sensorik montieren

Nun erfolgt die Montage der Sensorik Module

### 2.5.1 Tischkantenerkennung

Zur Montage der 4 Tischkantensensoren bedarf es jeweils einer Infrarot Abstandsmessungsplatine und für die Gehäuse einer Grundplatte und der Abdeckung:

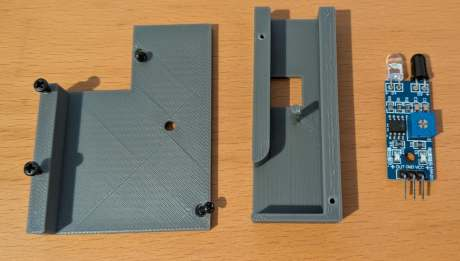
[picture p150: figure]

Hier wird zunächst das dreiadrige Flachbandkabel mit den Steckverbindern montiert.

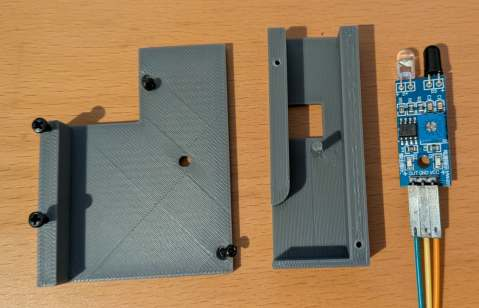
[picture p151: figure]

Anschließend wird die Sensorplatine im Gehäuse platziert:

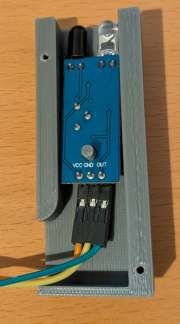
[picture p152: figure]

Nun wird die Abdeckplatte auf dem Träger platziert und rückseitig verschraubt. Das Poti zur Empfindlichkeitsregelung muss dabei in der Aussparung sichtbar sein.

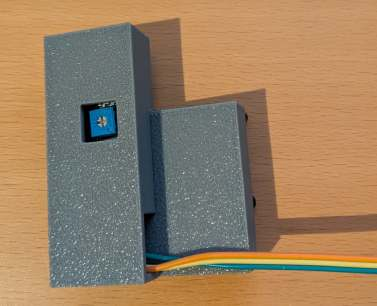
[picture p153: figure]

### 2.5.2 Kollisionserkennung

Zur montage des Ultraschall Sensors wird dieser zunächst im Gehäuse platziert und fixiert

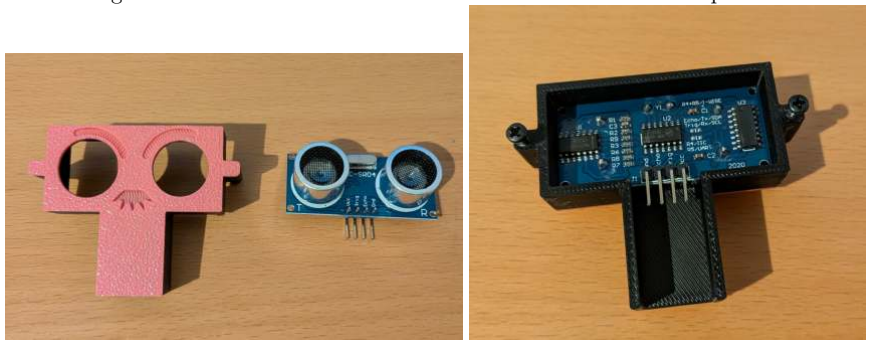
[picture p154: figure]

Anschließend wird das vieradrige Flachbandlabel mit der Sensorplatine verbunden:

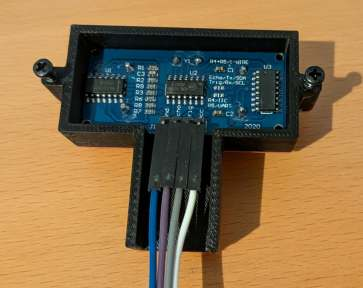
[picture p155: figure]

Nun wird das Ultraschallmodul auf der Frontplatte montiert.

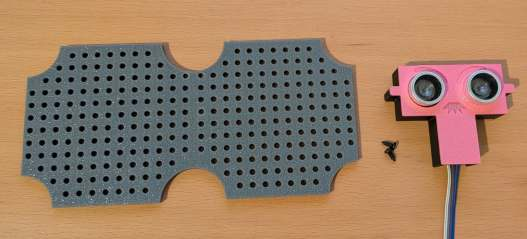
[picture p156: figure]

Dazu wird das Gehäuse rückseitig mit der mittleren Lochreihe verschraubt. Das Gehäuse des Ultraschall Sensors sollte nun bündig mit der Unterseite der vorderen Außenwand sein, unmittelbar

vor der Kabeldurchfürung.

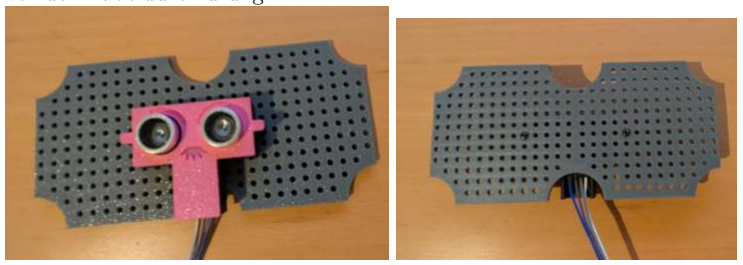
[picture p157: figure]

### 2.6 Antriebs-Aktorik montieren

Nun erfolgt die Montage der DC Antriebsmotoren

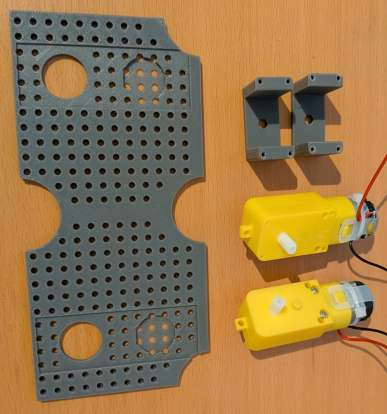
[picture p158: figure]

Falls noch nicht erfolgt bzw. im genutzten Motormodell nicht ohnehin vorhanden werden zunächst an den TT Motoren über die Lötfahnen die 100nF Kondensatoren zum Entstören gelötet.

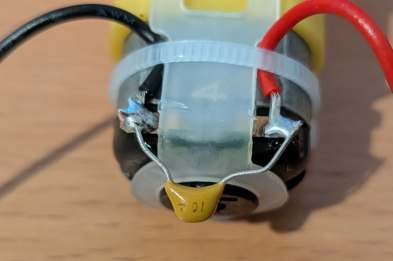
[picture p159: figure]

VORSICHT!
Die Kondensatoren müssen nach oben gerichtet werden, ansonsten lässt sich der Motor nicht bündig am gehäuse fixieren.

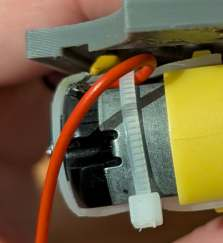
[picture p160: figure]

Nun wird jeder Motor mit den Streben auf den Seitenplatten montiert und außenseitig verschraubt.

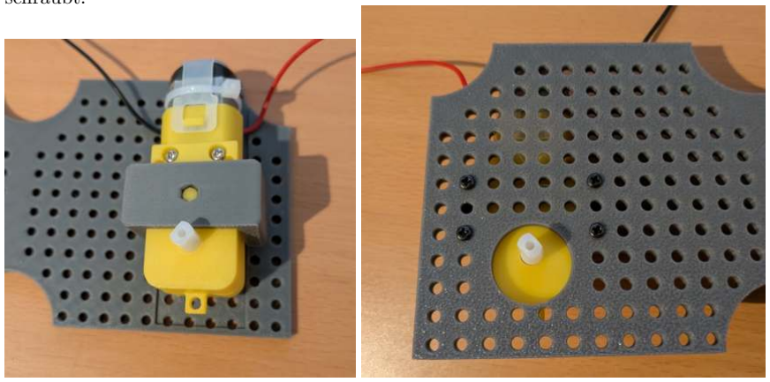
[picture p161: figure]

So wird für beide Seitenwände verfahren.

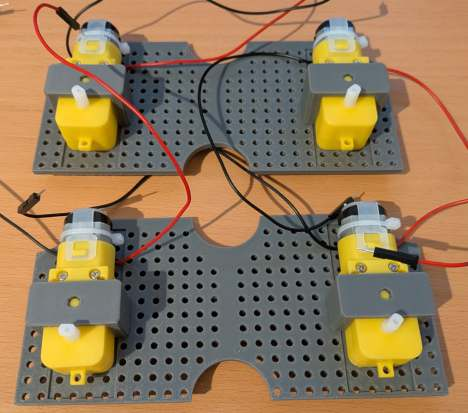
[picture p162: figure]

### 2.7 Hauptplatine vorbereiten

Die Hauptplatine fasst die zentralen Elektronikkomponenten zusammen und wird auf Lochraster verbunden. Die folgenden Hauptkomponenten werden somit zusammengefasst:

- DC/DC Step Up Converter Board
- Microprocessorboard Raspberry Pi Pico 2
- 2 mal TB6612FNG Motor Treiber Board
- MPU-6050 Intertialsensor

Die Aktorik sowie die Sensorik wird über Pinheader verbunden. Es ergibt sich für eine Lochrastermontage damit der Aufbau gemäß der Abbildung 2. Im Einzelnen stellen diese folgende Ansichten dar:
Das Lochraster Layout wurde mittels der Software DIYLC 3
erstellt und die Source Dateien finden sich im Github Repository 4

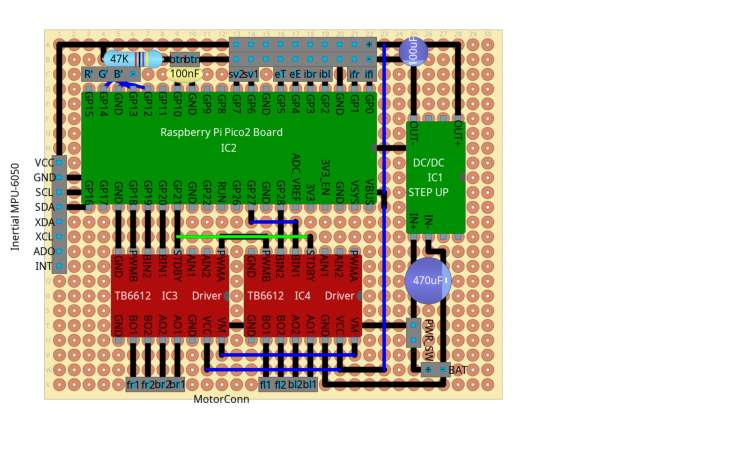
[picture p163: figure]

Abbildung 2: Kombinierte Ansicht Komponenten und Lötbrücken

3
https://github.com/bancika/diy-layout-creator

4
https://github.com/Project-CoasterBot/coasterbot/blob/main/M4_Test-und-Validierung/aufbauanleitung/protoboard.diy

Die Platine wird nun bestückt und verdrahtet:

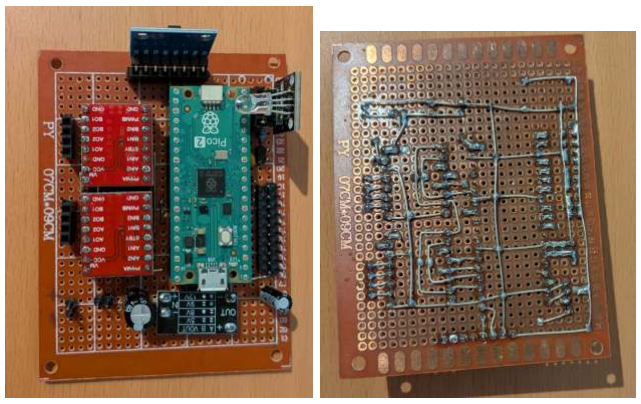
[picture p164: figure]

Anschließend wird diese auf der hinteren Platte zusammen mit dem Akkuhalter montiert. Dabei ist zu beachten, dass der Batterieanschluss (+- BAT) der Platine an der Seite des Batterieträgers montiert wird.

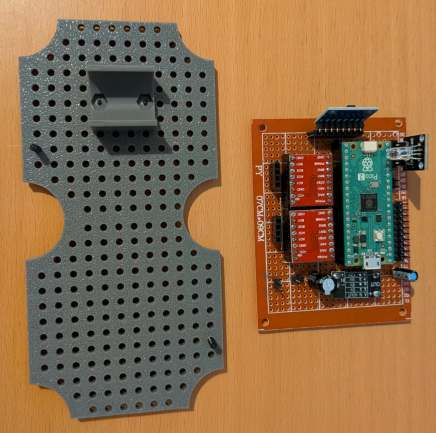
[picture p165: figure]

### 2.8 Programmierung des Microcontrollers

Das Microcontroller Board über die boardeigene Micro USB Buchse mit dem Host-PC verbunden.
Die Firmware befindet sich im Github Repository des Projekts⁵ und kann von dort bezogen werden.
Die Software wird in der Build-Umgebung mit den folgenden Befehlen der PlatformIO Softwareumgebung kompiliert und an den Microcontroller übertragen.

$ cd PROJDIR
$ pio run
$ pio run --target upload

Anschließend kann das USB Kabel wieder entfernt werden.

5
https://github.com/Project-CoasterBot/coasterbot/tree/main/src

### 2.9 Sensorik und Steuerung Montage

Nun werden die Infrarot Module an Front und Rückplatte montiert. Dabei ist auf einen korrekten Abstand sowohl zur Unterseite als auch nach außen zu achten.

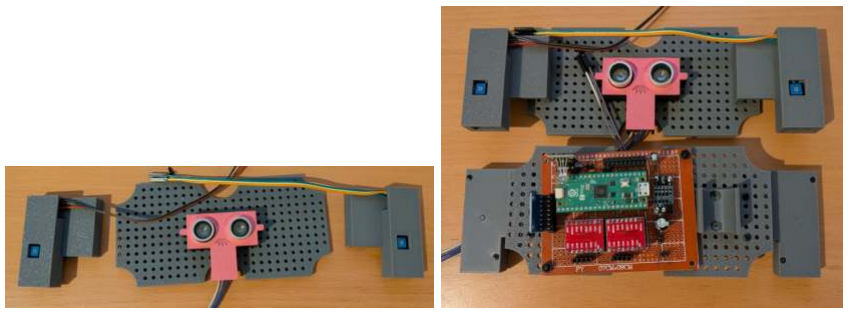
[picture p166: figure]

Die Vorderplatte kann nun in das Chassis eingesetzt werden. Dabei ist darauf zu achten, dass die Verbinder nach innen positioniert werden.

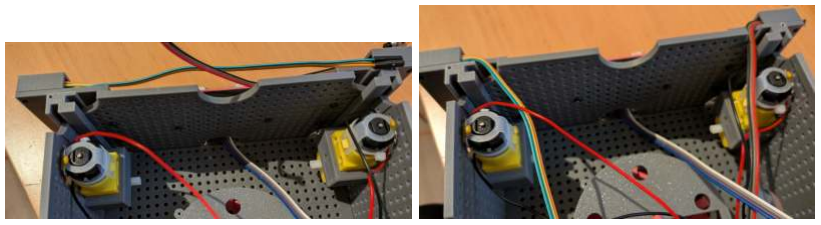
[picture p167: figure]

### 2.10 Verbinden der Aktorik und Sensorik mit Hauptplatine

Die Aktorik und Sensorik Module werden zunächst entsprechend dem Schaltplan bzw. Lochrasterplan mit den korrekten Pin Headern verbunden. Dabei ist auf eine korrekte Kabelführung zu achten, sodass die Aktorik nicht durch die Verbinder gestört wird. Wir beginnen zunächst mit den Motoren und der Batterie, da diese an der Unterseite liegen und nach einfügen der Rückplatte schlecht erreichbar sind. Bei den vorderen Verbindern ist zu beachten, dass aufgrund der Größe des Gehäuses die Verbinder möglicherweise zu kurz sind, dies wurde hier für die Antriebsmotoren links und rechts durchgeführt, sowie im zweiten Bild Akku und Hauptschalter montiert:

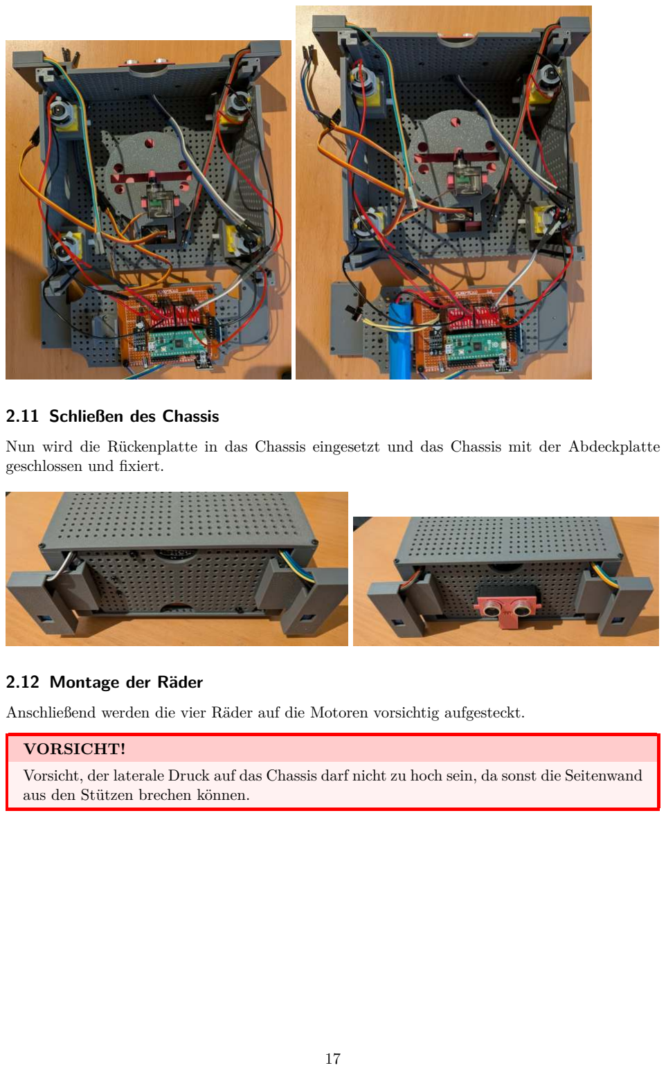
[picture p168: page 17]

### 2.11 Schließen des Chassis

Nun wird die Rückenplatte in das Chassis eingesetzt und das Chassis mit der Abdeckplatte geschlossen und fixiert.

### 2.12 Montage der Räder

Anschließend werden die vier Räder auf die Motoren vorsichtig aufgesteckt.

VORSICHT!
Vorsicht, der laterale Druck auf das Chassis darf nicht zu hoch sein, da sonst die Seitenwand aus den Stützen brechen können.

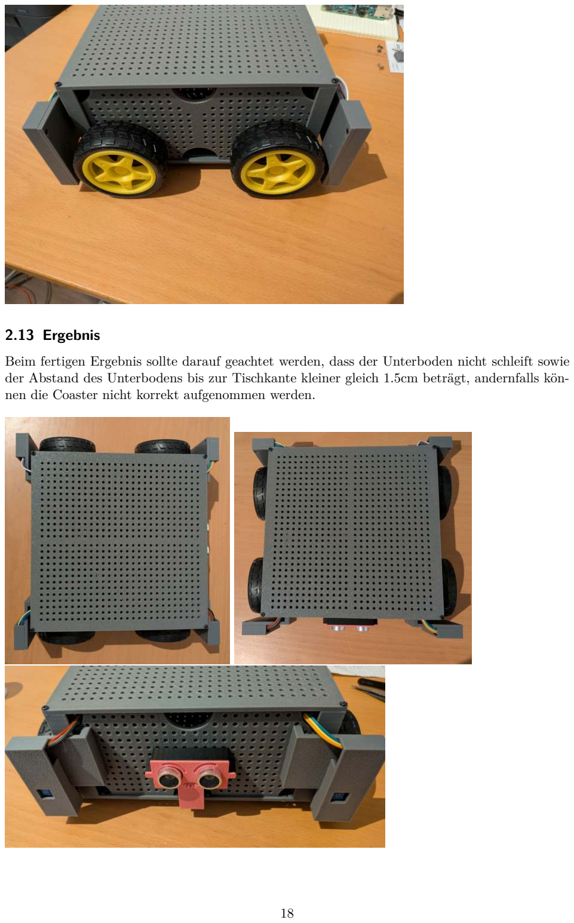
[picture p169: page 18]

### 2.13 Ergebnis

Beim fertigen Ergebnis sollte darauf geachtet werden, dass der Unterboden nicht schleift sowie der Abstand des Unterbodens bis zur Tischkante kleiner gleich 1.5cm beträgt, andernfalls können die Coaster nicht korrekt aufgenommen werden.
