Project-CoasterBot/coasterbot/M4_Test-und-Validierung/aufbauanleitung/montage_gereon/abschluss/PXL_20260918_085339280.jpg

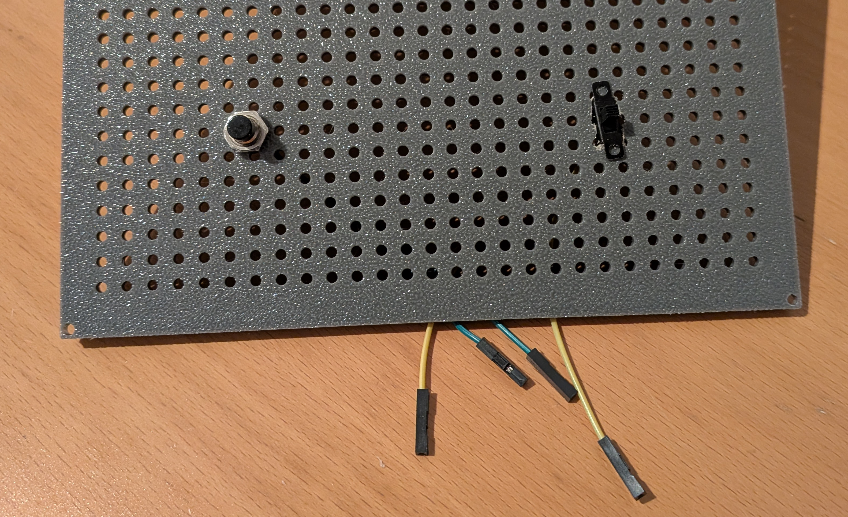
M4_Test-und-Validierung/aufbauanleitung/montage_gereon/abschluss/PXL_20260918_085339280.jpg
