Project-CoasterBot/coasterbot/M4_Test-und-Validierung/aufbauanleitung/montage_gereon/antrieb_montage/PXL_20260907_165806887.jpg

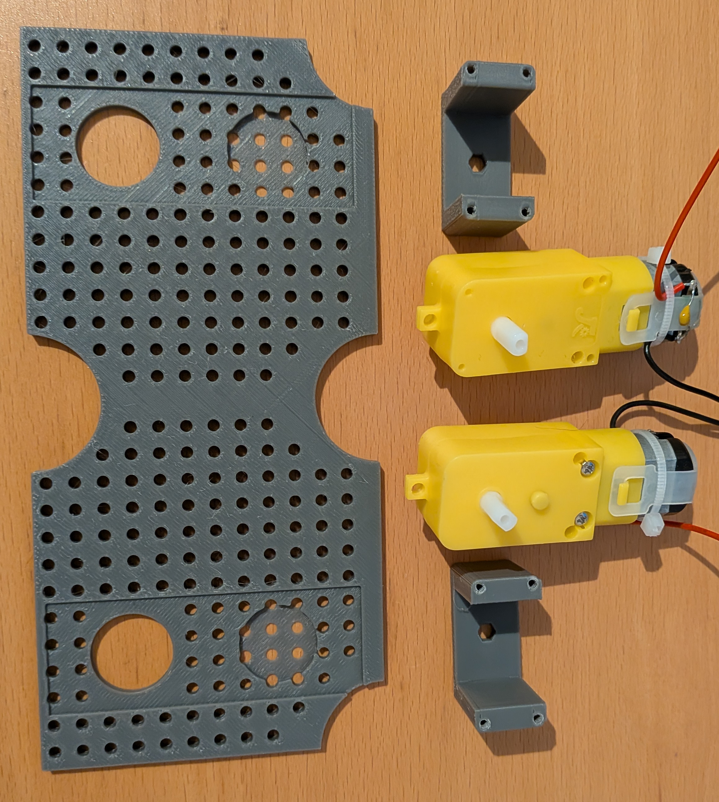
M4_Test-und-Validierung/aufbauanleitung/montage_gereon/antrieb_montage/PXL_20260907_165806887.jpg
