Project-CoasterBot/coasterbot/M4_Test-und-Validierung/aufbauanleitung/montage_gereon/antrieb_montage/PXL_20260909_081238641.jpg

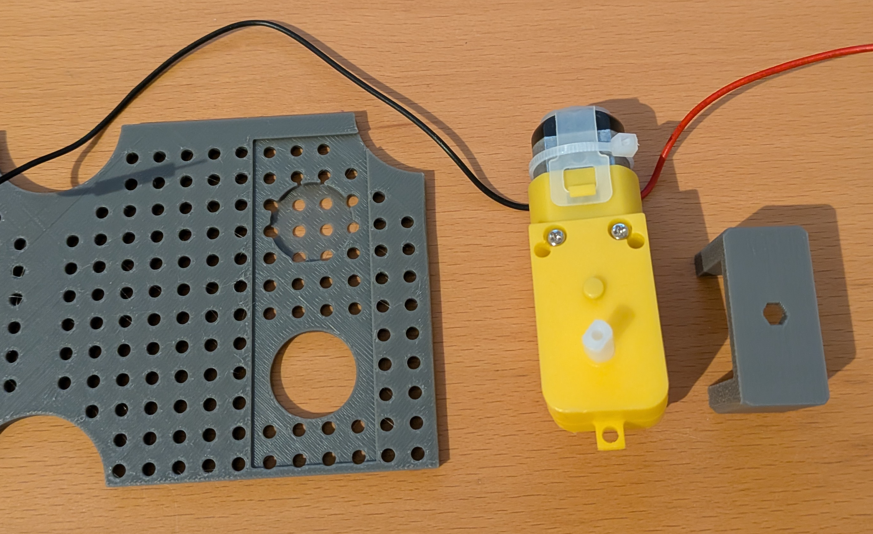
M4_Test-und-Validierung/aufbauanleitung/montage_gereon/antrieb_montage/PXL_20260909_081238641.jpg
