Project-CoasterBot/coasterbot/M4_Test-und-Validierung/aufbauanleitung/montage_gereon/basis_konstrukt/PXL_20260909_073530305.jpg

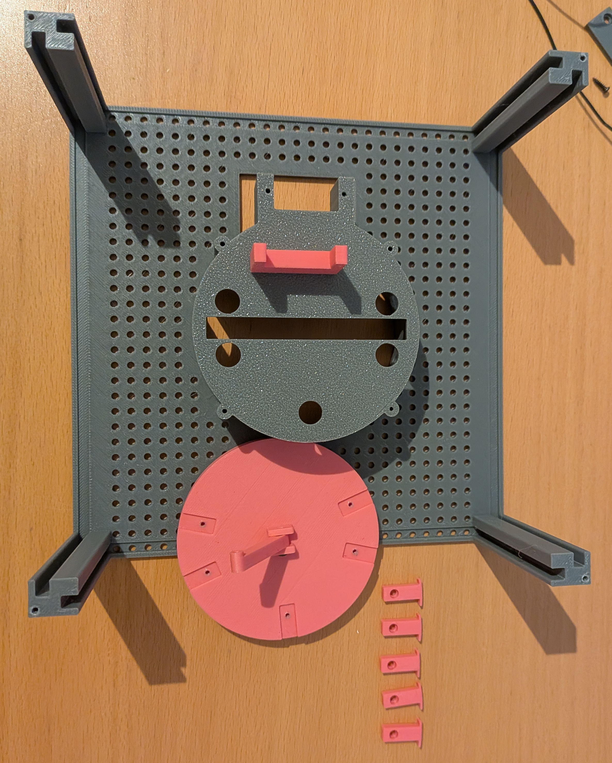
M4_Test-und-Validierung/aufbauanleitung/montage_gereon/basis_konstrukt/PXL_20260909_073530305.jpg
