Project-CoasterBot/coasterbot/M4_Test-und-Validierung/aufbauanleitung/montage_gereon/gesamt_montage/PXL_20260912_201511019.jpg

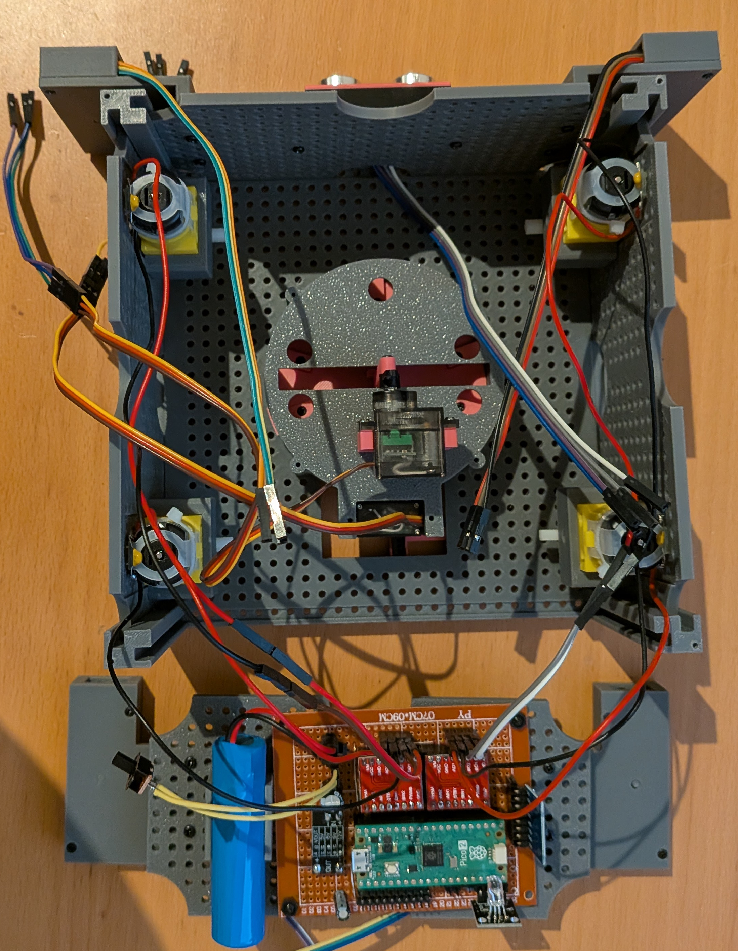
M4_Test-und-Validierung/aufbauanleitung/montage_gereon/gesamt_montage/PXL_20260912_201511019.jpg
