Project-CoasterBot/coasterbot/M4_Test-und-Validierung/aufbauanleitung/montage_gereon/platine/PXL_20260911_160224707.jpg

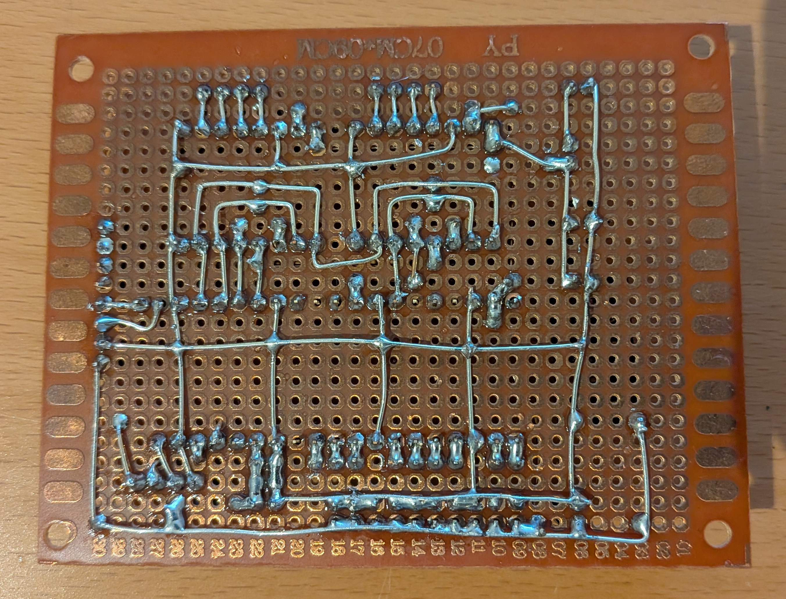
M4_Test-und-Validierung/aufbauanleitung/montage_gereon/platine/PXL_20260911_160224707.jpg
