Project-CoasterBot/coasterbot/M4_Test-und-Validierung/aufbauanleitung/montage_gereon/platine/PXL_20260911_161028164.jpg

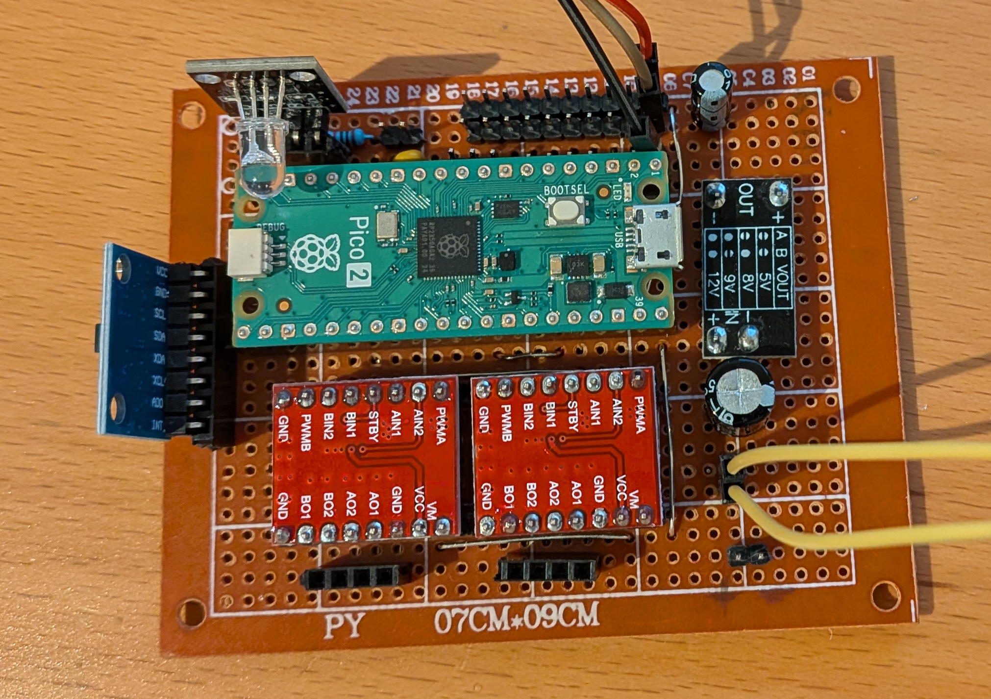
M4_Test-und-Validierung/aufbauanleitung/montage_gereon/platine/PXL_20260911_161028164.jpg
