Project-CoasterBot/coasterbot/M4_Test-und-Validierung/aufbauanleitung/montage_gereon/platine/PXL_20260911_163437444.jpg

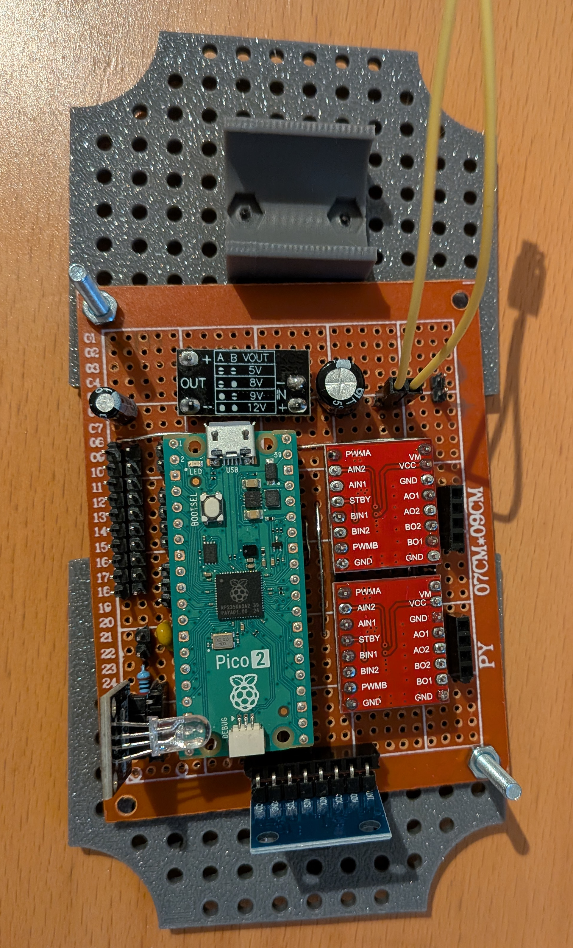
M4_Test-und-Validierung/aufbauanleitung/montage_gereon/platine/PXL_20260911_163437444.jpg
