Project-CoasterBot/coasterbot/M4_Test-und-Validierung/aufbauanleitung/montage_gereon/platine/PXL_20260912_173307498.jpg

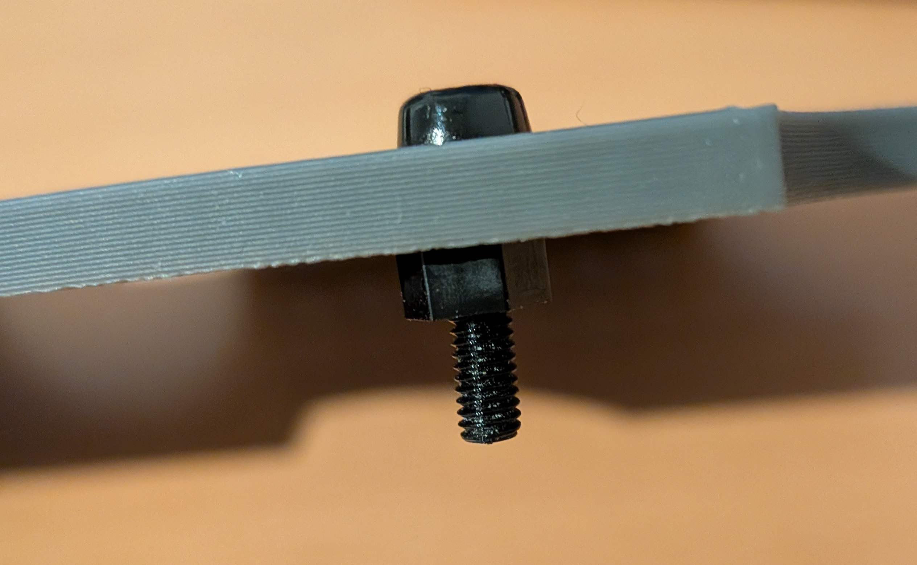
M4_Test-und-Validierung/aufbauanleitung/montage_gereon/platine/PXL_20260912_173307498.jpg
