Project-CoasterBot/coasterbot/M4_Test-und-Validierung/aufbauanleitung/montage_gereon/platine/PXL_20260912_173357520.jpg

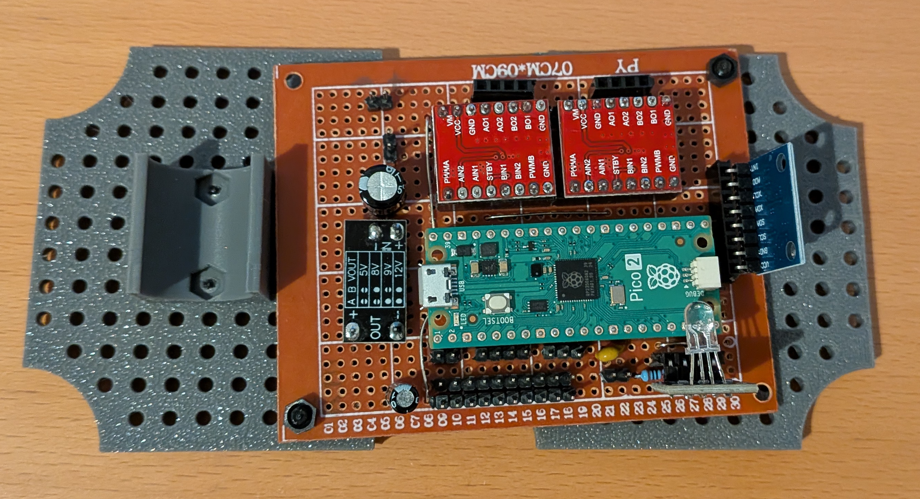
M4_Test-und-Validierung/aufbauanleitung/montage_gereon/platine/PXL_20260912_173357520.jpg
