Project-CoasterBot/coasterbot/M4_Test-und-Validierung/aufbauanleitung/montage_gereon/rad_seitenwand_montage/PXL_20260909_083811959.jpg

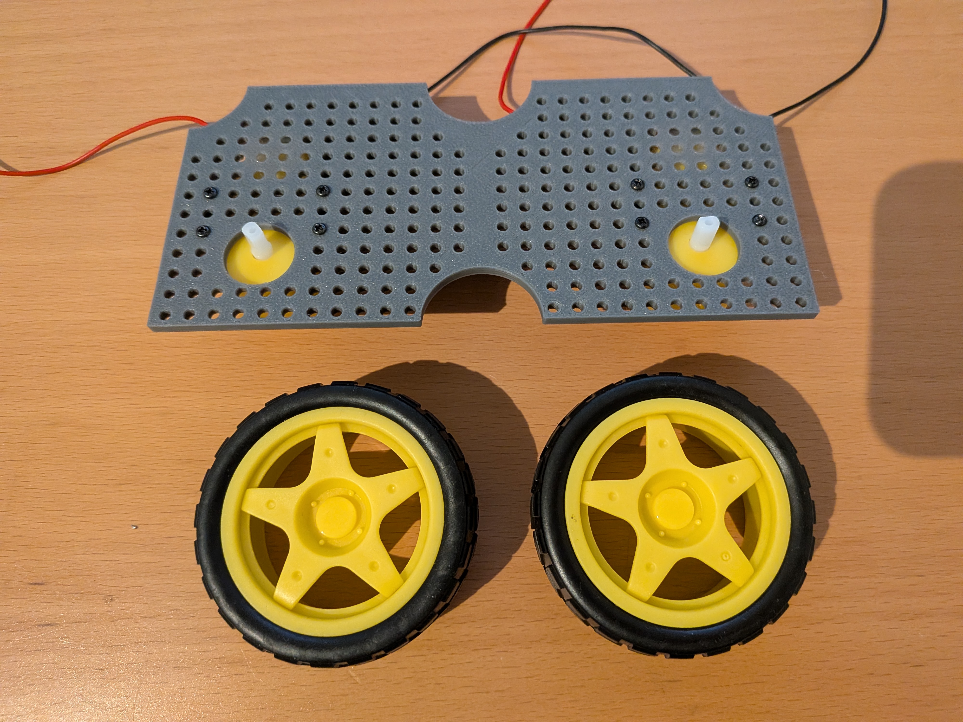
M4_Test-und-Validierung/aufbauanleitung/montage_gereon/rad_seitenwand_montage/PXL_20260909_083811959.jpg
