Project-CoasterBot/coasterbot/M4_Test-und-Validierung/aufbauanleitung/montage_gereon/servo_montage/PXL_20260909_075243603.jpg

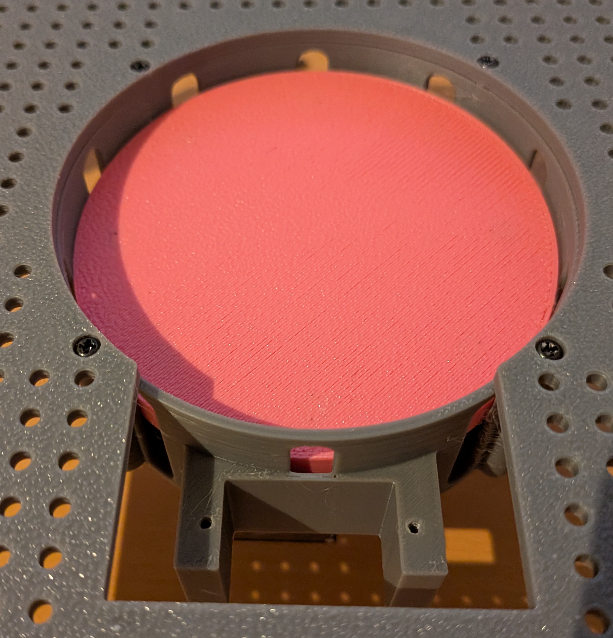
M4_Test-und-Validierung/aufbauanleitung/montage_gereon/servo_montage/PXL_20260909_075243603.jpg
