Project-CoasterBot/coasterbot/M4_Test-und-Validierung/aufbauanleitung/montage_gereon/servo_montage/PXL_20260909_080016157.jpg

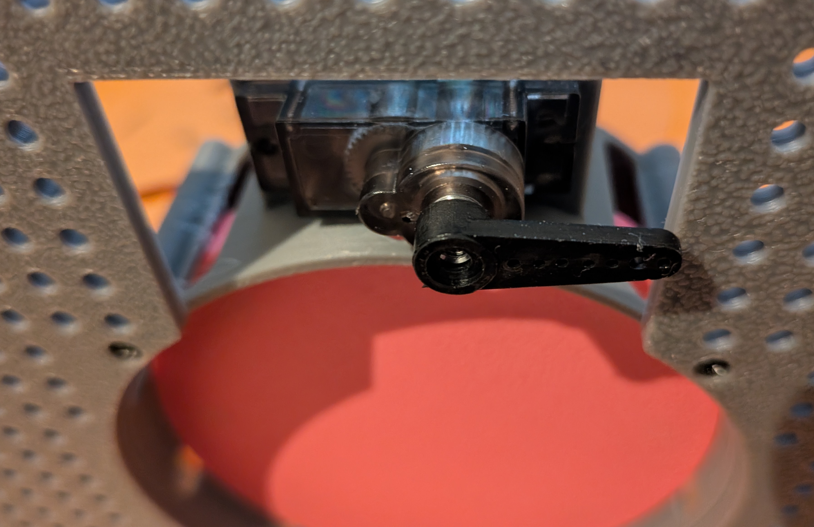
M4_Test-und-Validierung/aufbauanleitung/montage_gereon/servo_montage/PXL_20260909_080016157.jpg
