Project-CoasterBot/coasterbot/M4_Test-und-Validierung/aufbauanleitung/montage_gereon/tischkantensensor/PXL_20260907_153809910.jpg

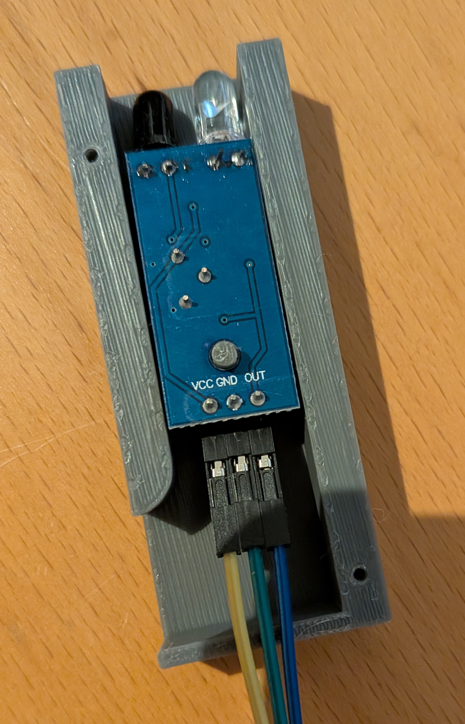
M4_Test-und-Validierung/aufbauanleitung/montage_gereon/tischkantensensor/PXL_20260907_153809910.jpg
