Project-CoasterBot/coasterbot/M6_Projekträsentation/gs_resource/v2_preview/assembly.png

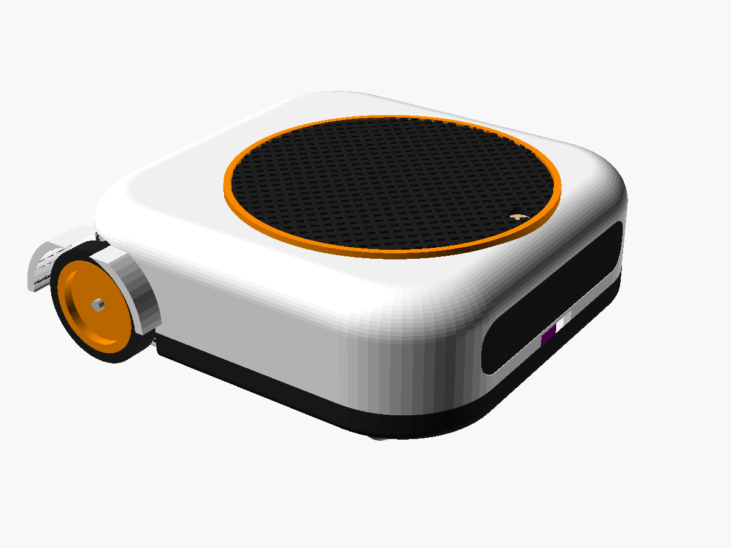
M6_Projekträsentation/gs_resource/v2_preview/assembly.png
