Project-CoasterBot/coasterbot/M4_Test-und-Validierung/Softwaredokumentation/db_anmerkungen.md

# 18.10.2026

## Anmerkungen

- Kapitel 16: entfällt mittlerweile, oder?
- Kapitel 17.1: Was heißt auf Seite 33: Änhaltenffür
- Kapitel 17.2: MPH-6050? Der Sensor heißt MPU, oder?
- Sollte ich noch ein Kapitel zu Coasterbotfunctions einfügen?
