Project-CoasterBot/coasterbot/M4_Test-und-Validierung/Testreport/db_anmerkungen.md

# 18.10.2026

## Anmerkungen

- Kapitel 2: Wie meinen wir die Tabelle? Sollte da nicht alles ausgefüllt sein?
- IT-LOC-NAV-001 wäre eingeschränkt nicht möglich?
- IT-HW-SIM-001 warum nur eingeschränkt?
- ST-SIM-008 können wir das noch nachziehen?
- SYS-010 typo in Bemerkung 
- Anmerkungen. Ersten Bulletpoint können wir entfernen, oder?
