Project-CoasterBot/coasterbot/M4_Test-und-Validierung/Mechanikkonzept/Materialbeschreibung.md

# Erforderliches Material:

| Material  | Menge | Eihheit | Preis | Bemerkung | link |
|---|---|---|---|---|---|
| PLA | 420 | g | ~10€/kg | Insgesamt. (Optional davon: 57g für Außenwand vorne/hinten) | [Amazon](https://www.amazon.de/dp/B0F59F5HPT?ref=ppx_yo2ov_dt_b_fed_asin_title&th=1)
| Selbstschneidende Schrauben (M2.3 x 8) | 24 | stk. | 7,59€/set | Zur Verbindung der Teile (Wenn ohne Außenwand vorn/hinten +12 stk.) | [Amazon](https://www.amazon.de/dp/B09NDPGJG1?ref=ppx_yo2ov_dt_b_fed_asin_title&th=1) |
| Selbstschneidende Schrauben (M2.3 x 10)| 2 | stk. | 7,59€/set | Als Drehpunkt des Schiebers | [Amazon](https://www.amazon.de/dp/B09NDPGJG1?ref=ppx_yo2ov_dt_b_fed_asin_title&th=1)
| Magnete (5mmx2mm) | 40 | stk. | 7,99€/120stk. | Für Coaster und Heber | [Amazon](https://www.amazon.de/dp/B0CPT2S1XR?ref=ppx_yo2ov_dt_b_fed_asin_title&th=1)

Für ein Coasterbot sind damit mechanisch mindestens folgende Kosten vorzusehen:

Werkstoff: 0,42g * 10€/kg = 4,2€

Befestigungsmaterial: 7,59€

Einsatzmagnete: 7,99€

Summe: 19,78€
