Project-CoasterBot/coasterbot/M4_Test-und-Validierung/Mechanikkonzept/Coasterbot_Konzeptbeschreibung.pdf

### Wilhelm Büchner University of Applied Sciences

Projektseminar Master

## Coasterbot

### Konzeptbeschreibung der Mechanik


Dennis Borutta, B. Eng dennis.borutta@outlook.com Stefan Etringer, B. Eng mail@stefan.works
Gereon Such, M. Sc. gereonsuch@gmail.com

Versionshistorie

Version Datum | Bearbeiter | Änderungen
1 | 24.08.2026 Borutta | Erstfassung der Konzeptbeschreibung
2 | 18.10.2026 Borutta | Finalisierung

2

Inhaltsverzeichnis

1 Konzeptbeschreibung | 4
2 Anhang | 9

3

### 1 Konzeptbeschreibung

### 1.1 Übersicht

Der Coasterbot ist ein mobiler Roboter auf einem vierrädrigen Chassis, dessen zentrale Funktion die Aufnahme und Ausgabe von Untersetzern ist. Der Roboter ist mit einem Lochraster-Chassis aufgebaut, das eine flexible Montage von Elektronik, Sensorik und Mechanik erlaubt. Aus diesem Grund sind in den folgenden Bildern noch nicht alle Komponenten sichtbar. Deren ideale Platzierung kann am Prototyp variieren und so der optimale Platz gefunden werden. Vier einzeln angetriebene Räder sorgen für die Fortbewegung, während im Zentrum des Fahrzeugs ein Mechanismus zur Untersetzerhandhabung untergebracht ist.

### 1.2 Gesamtkonzept

Die folgenden Ansichten zeigen das grundlegende Layout des Roboters aus der Vogelper-spektive sowie von vorne.

### 1.2.1 Draufsicht (Konzept)

Die Draufsicht in Abbildung 1 zeigt die symmetrische Anordnung der vier Räder in den Ecken des Chassis. Die blau durchscheinende Bereiche kennzeichnen die Position der Servomotoren für die Ausgabe und Aufnahme von Untersetzer, die gelb durchscheinenden Bereiche sind die verwendeten Antriebsmotoren zur Fortbewegung. Befestigt wird die obere Platte über vier Schrauben an das Grundgestell. Damit Klemmt diese obere Platte vier Seitenwände in das Grundgestell ein.

### 1.2.2 Frontansicht (Konzept)

Die Frontansicht in Abbildung 2 verdeutlicht das Fahrzeug sowie die Anbringung der Sen-soren zur Kanten- und Hinderniserkennung. Mittig ist eine stilisierte „Gesichts”-Blende zu erkennen, welche einen Ultraschallsensor aufnimmt. Dieser wird zur Hinderniserkennung verwendet. Die vor den Rädern stehenden Gehäuse sind zur Aufnahme der Sensorik zur Kantenerkennung gedacht. Diese sind auch für die hinteren Räder vorgesehen. Die Antriebsräder werden über einen Halter mit den Außenwänden verschraubt. Alle Außen-wände werden von oben in das Grundgestell eingeschoben. Ein Fixierung der Wände erfolgt über die Führungen in den Eckpfeilern, dem Deckel und der Grundplatte.

4


Abbildung 1: Konzept Draufsicht


Abbildung 2: Konzept schräge Frontansicht

5


Abbildung 3: Coasterbot Isometrische Ansicht ohne Deckel

### 1.3 Mechanischer Aufbau

### 1.3.1 Isometrische Ansicht ohne Deckel

Die Darstellung in Abbildung 3 zeigt den Innenaufbau des Roboters ohne die obere Abdeckung. Im Zentrum ist die Untersetzermechanik zur Aufnahme und Ausgabe der Untersetzer zu erkennen. Sie besteht aus einem Gehäuse, einem beweglichen Stempel mit mehreren eingelassenen Magneten, Verbindungsstücken, einem Auswurf-/Führungssteg und zwei Servo-Motoren. Es wird ein Schubkurbeltrieb verwendet um den Stempel auf und ab zu bewegen. Der Antrieb erfolgt über den oberen Servomotor. Durch die im Stempel befindlichen Magneten werden speziell gefertigte Untersetzer angezogen und aufgenommen. Es wird ausreichend Platz vorgesehen, dass wenigsten vier Untersetzer in dieser Mechanik vorgehalten werden.

An den vier Ecken des Chassis sind die Antriebsmotoren der Räder zu sehen. Bei dem rechts im Bild befindlichen Antriebsmotor ist dier Halter zur Befestigung eingeblendet. Mit diesem Halter werden alle weiteren Antriebsmotoren ebenfalls befestigt.

6


Abbildung 4: Coasterbot untere Ansicht

7

### 1.3.2 Untere Ansicht

In Abbildung 4 ist zentral die Unterseite der Untersetzermechanik mit dem heraus-ragenden Auswurf-/Führungssteg sowie dem zweiten Servomotor erkennber. Wird ein Untersetzer ausgegeben, wird dieser soweit heruntergelassen, dass er auf dem Führungssteg abliegt. Anschließen rotiert der Servomotor um 90° wodurch die kurze Seite des Auswurf-/Führungssteg den Untersetzer nach vorne schiebt. Durch ein anschließendes Anheben des Hebemechanismus, wird der Untersetze abgelegt. Wird ein Untersetzer wieder aufgenommen, dreht sich der Ausschieber weitere 90° zur Seite, damit der Stempel an der Mechanik vorbeikommt. Dadurch kann der Stempel soweit heruntergefahren werden, bis die Magneten den sich darunter befindlichen Untersetzer anziehen und damit aufnehmen. Befestigt wird die Mechanik mit dem Gehäuse über vier Schrauben.

### 1.3.3 Spätere Nacharbeit

Im Laufe des Projekts stellte sich heraus, dass es Nachbesserungbedarf im mechanischen Konzept. Diese sind hier gelistet:

1. Erneuerung der Halter zur Motoraufnahme, damit ein Encoder montiert werden kann
2. Entfernen der Führungsstücke am Stempel der Untersetzermechanik
3. Anpassen des Auswurf-/Führungssteg für einen stärkeren Servomotor und vergößern der Auflagefläche am Führungssteg für Untersetzer

8

### 2 Anhang

### 2.1 Zeichnungen Coasterbot

9

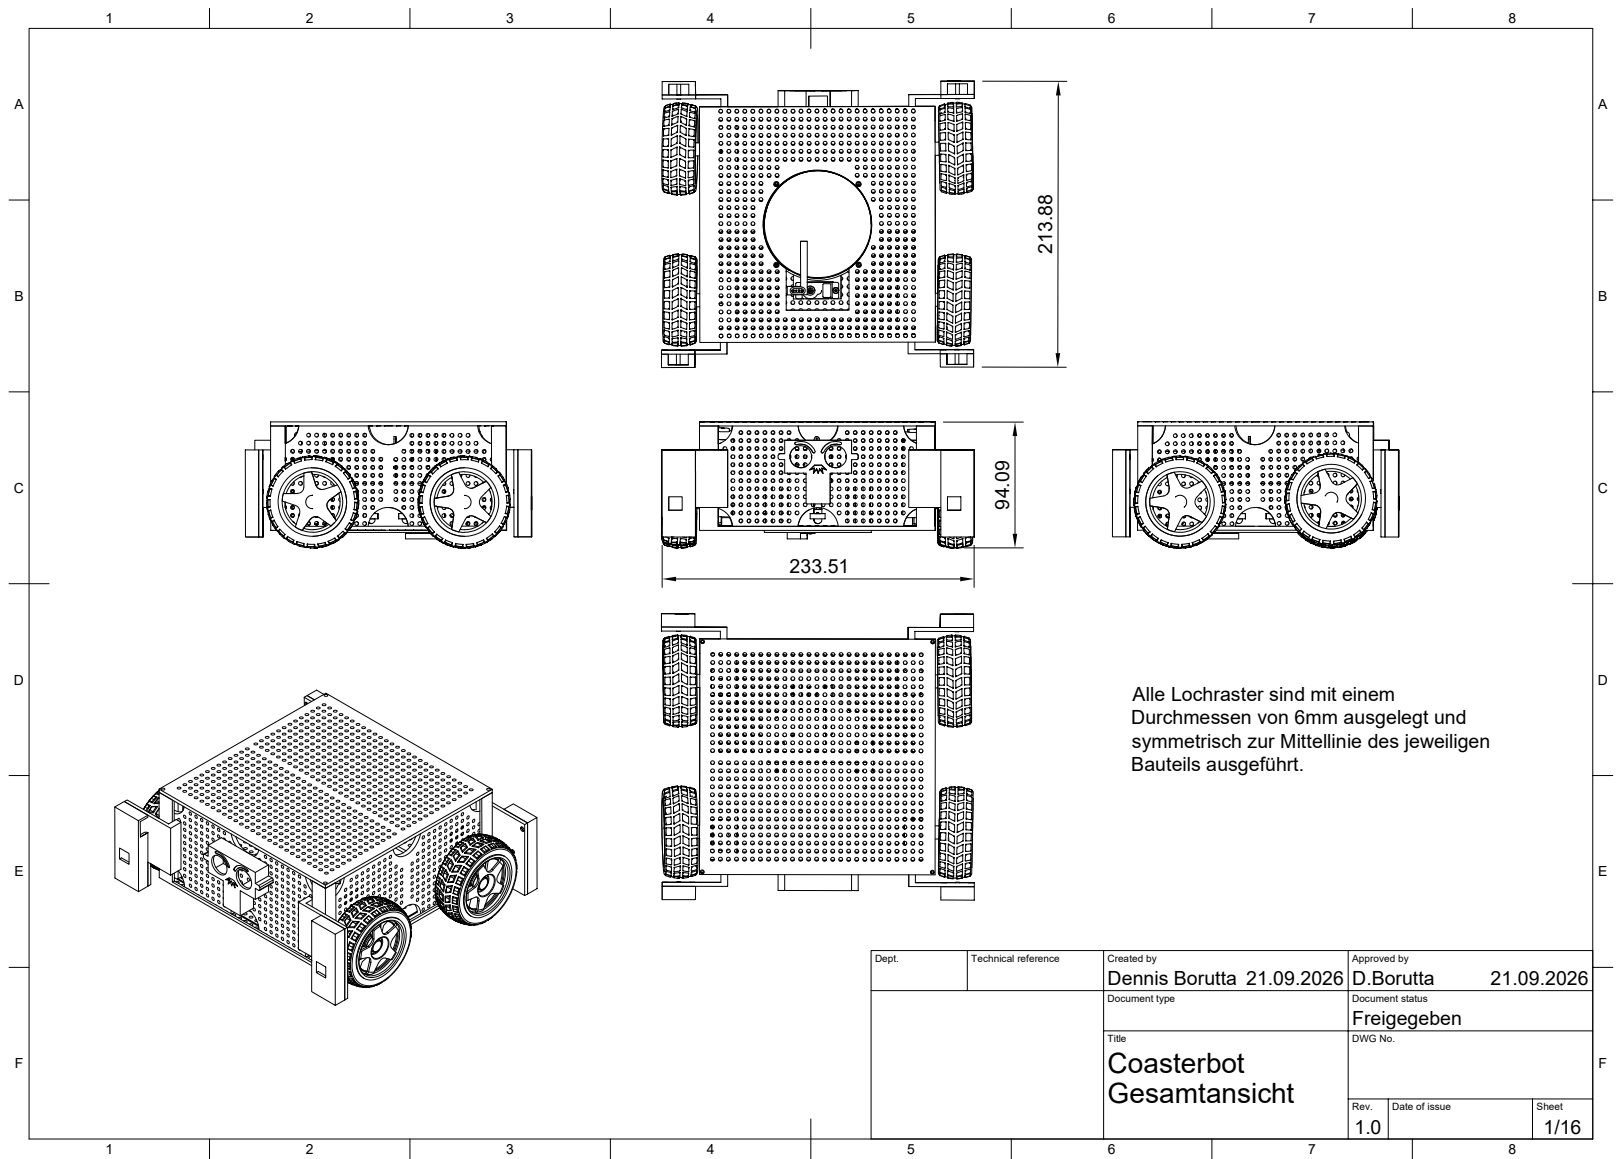
[picture p226: page 10]
Dept.; Technical reference; Created by; Approved by; Document type; Document status; Title; DWG No.; Rev.; Date of issue; Sheet; Freigegeben; Gesamtansicht; Coasterbot; Dennis Borutta; D.Borutta

Alle Lochraster sind mit einem
Durchmessen von 6mm ausgelegt und
symmetrisch zur Mittellinie des jeweiligen
Bauteils ausgeführt.

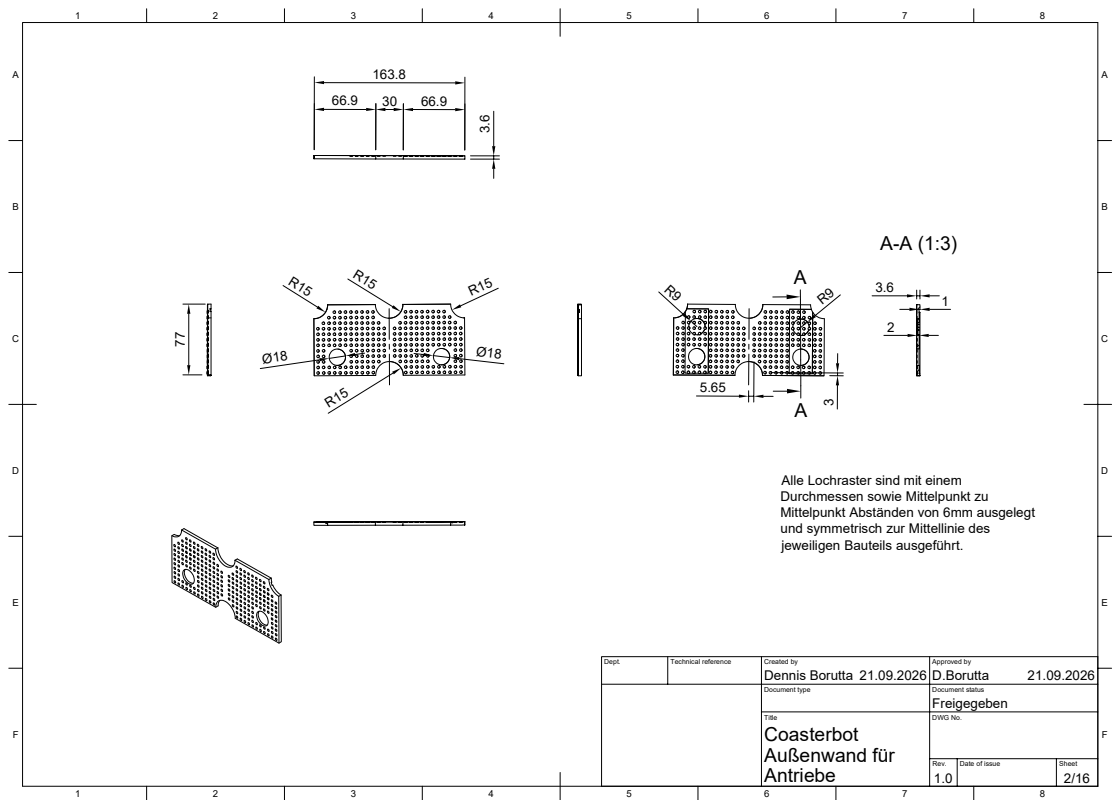
[picture p227: page 11]
Dept.; Technical reference; Created by; Approved by; Document type; Document status; Title; DWG No.; Antriebe; Freigegeben; Außenwand für; Coasterbot; Dennis Borutta; D.Borutta

Alle Lochraster sind mit einem
Durchmessen sowie Mittelpunkt zu
Mittelpunkt Abständen von 6mm ausgelegt
und symmetrisch zur Mittellinie des
jeweiligen Bauteils ausgeführt.

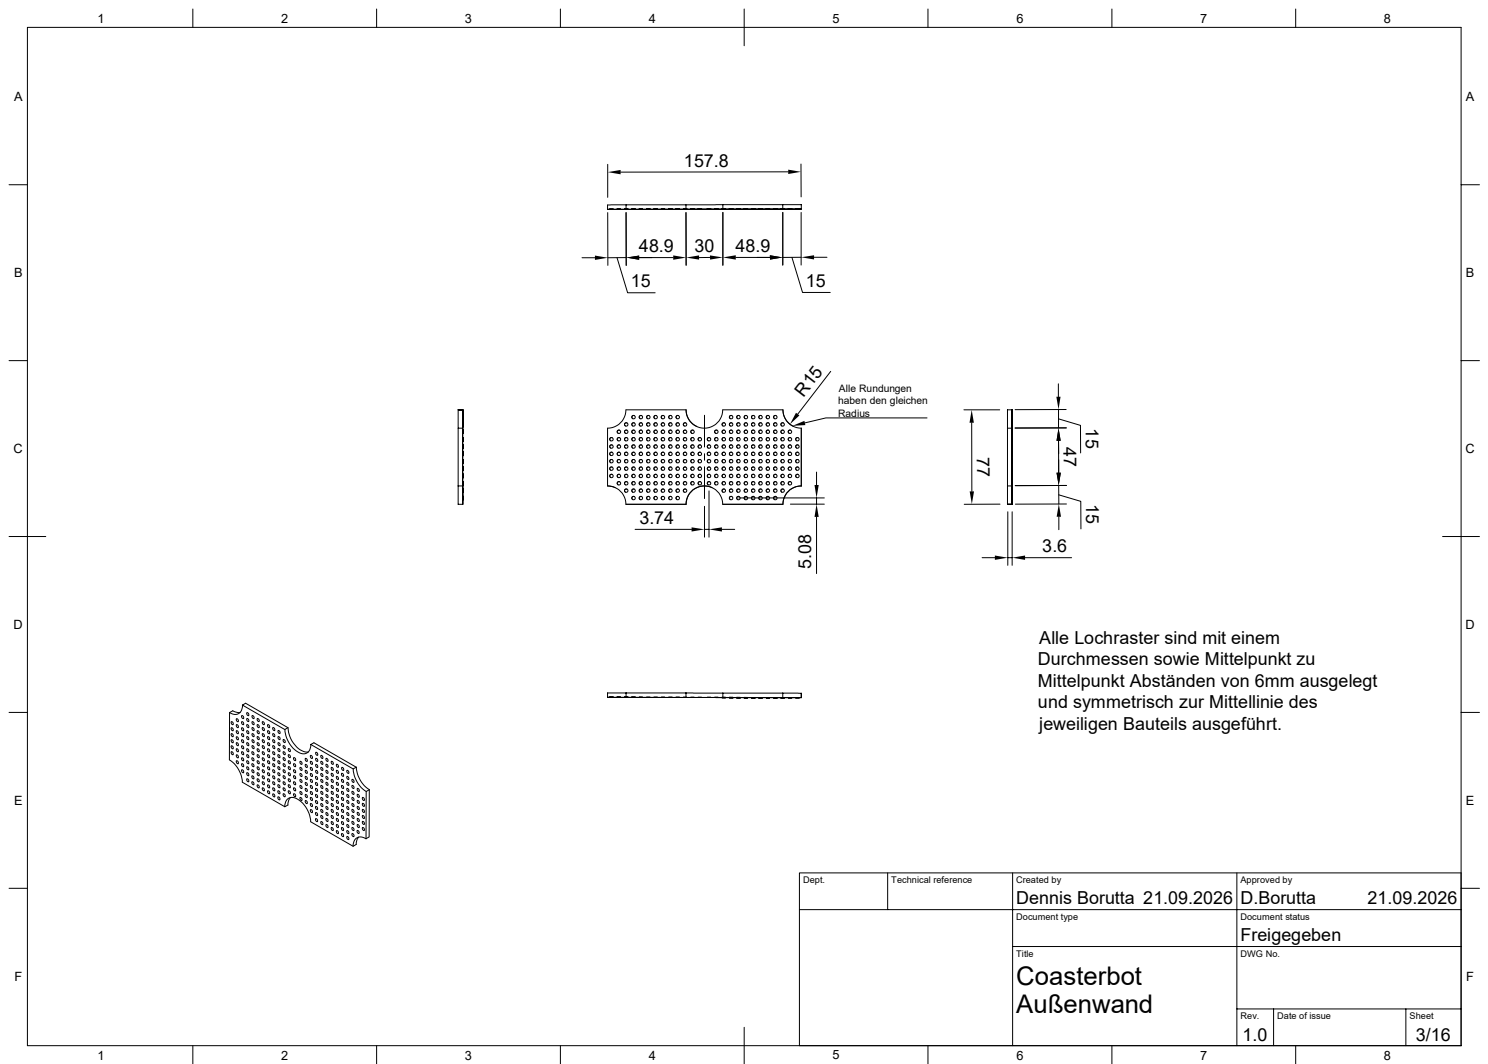
[picture p228: page 12]
Dept.; Technical reference; Created by; Approved by; Document type; Document status; Title; DWG No.; Freigegeben; Außenwand; Coasterbot; Dennis Borutta; D.Borutta; R15Alle Rundungen; Radius

haben den gleichen

Alle Lochraster sind mit einem
Durchmessen sowie Mittelpunkt zu
Mittelpunkt Abständen von 6mm ausgelegt
und symmetrisch zur Mittellinie des
jeweiligen Bauteils ausgeführt.

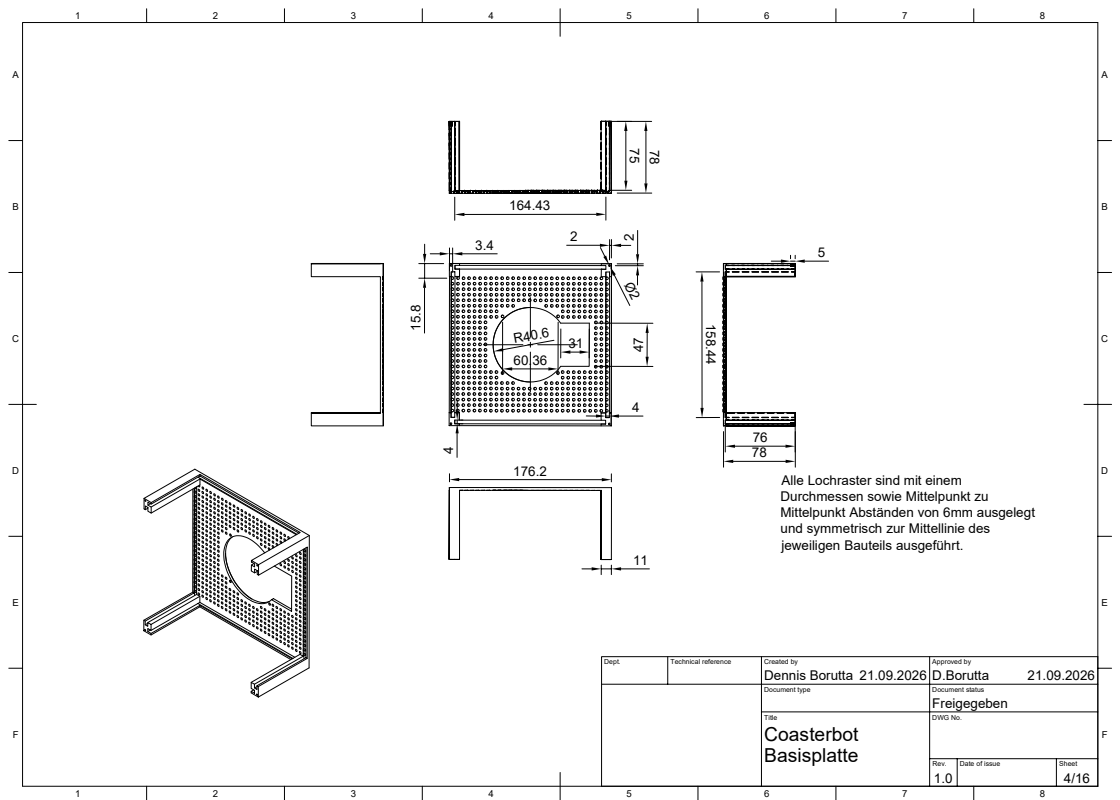
[picture p229: page 13]
Dept.; Technical reference; Created by; Approved by; Document type; Document status; Title; DWG No.; Freigegeben; Basisplatte; Coasterbot; Dennis Borutta; D.Borutta; 78 ¹⁵⁸.44

jeweiligen Bauteils ausgeführt. ¹⁵.8

Alle Lochraster sind mit einem
Durchmessen sowie Mittelpunkt zu
Mittelpunkt Abständen von 6mm ausgelegt
und symmetrisch zur Mittellinie des

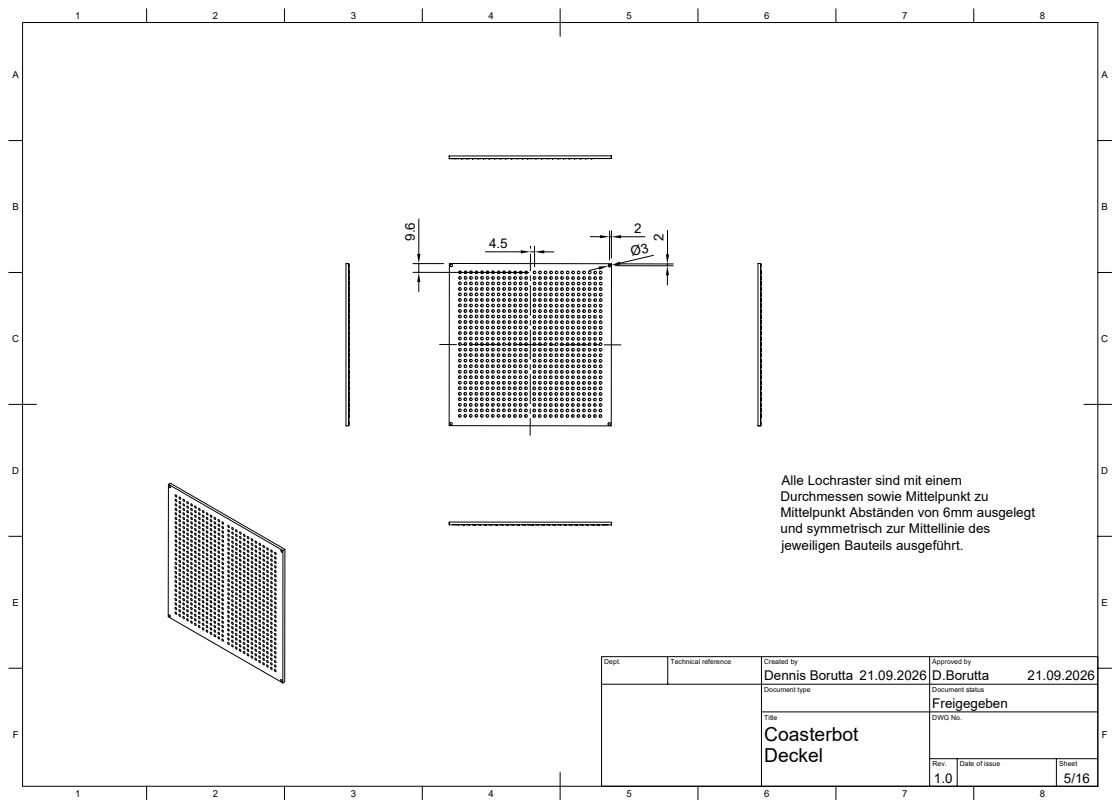
[picture p230: page 14]
Dept.; Technical reference; Created by; Approved by; Document type; Document status; Title; DWG No.; Freigegeben; Deckel; Coasterbot; Dennis Borutta; D.Borutta

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

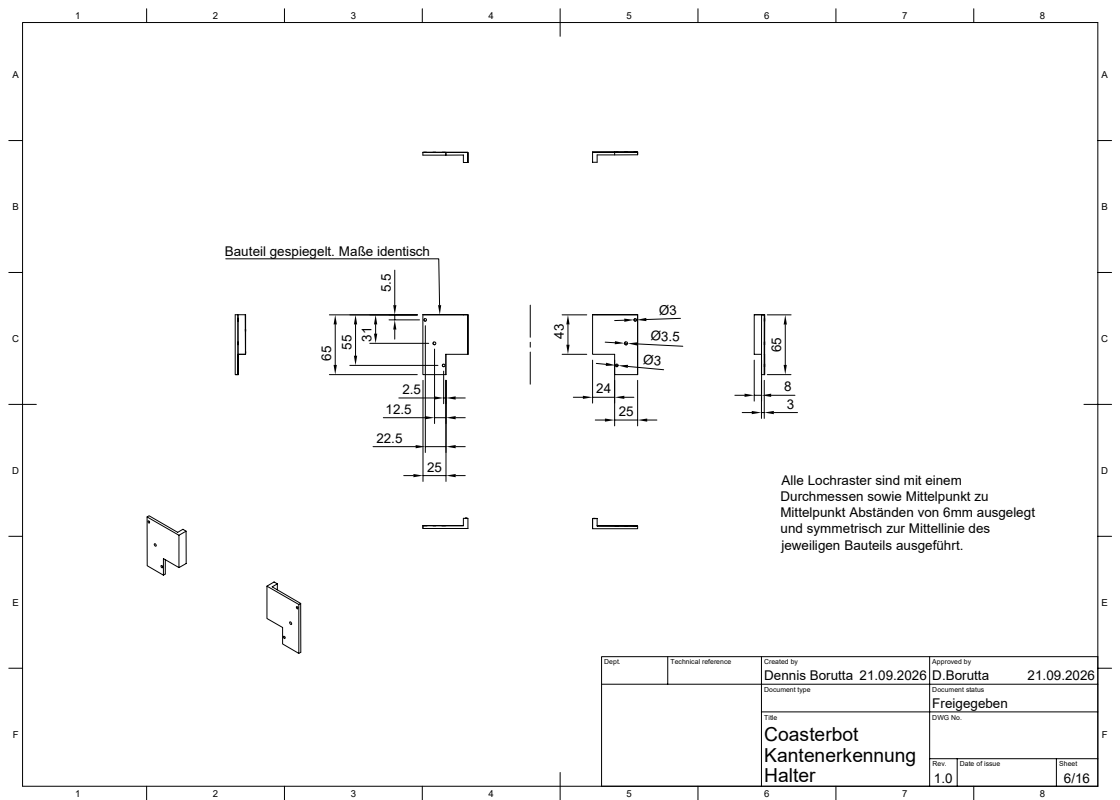
[picture p231: page 15]
Dept.; Technical reference; Created by; Approved by; Document type; Document status; Title; DWG No.; Halter; Freigegeben; Kantenerkennung; Coasterbot; Dennis Borutta; D.Borutta

Bauteil gespiegelt. Maße identisch

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

22.5 10

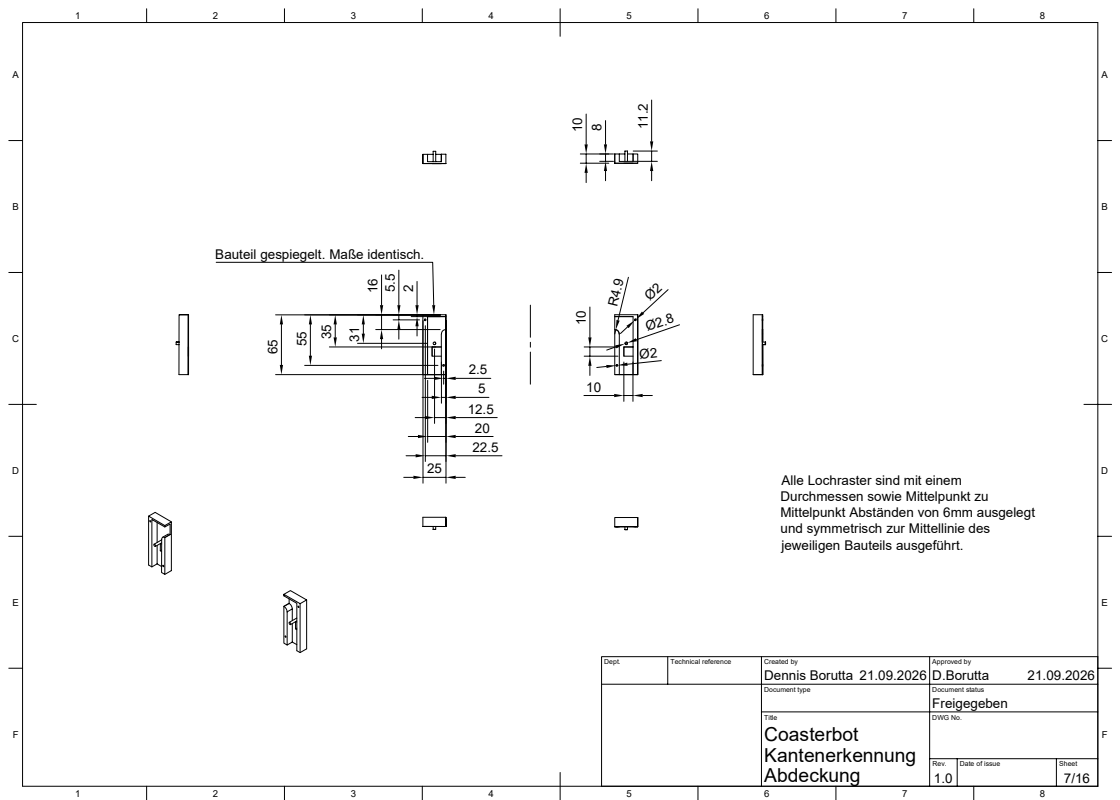
[picture p232: page 16]
Dept.; Technical reference; Created by; Approved by; Document type; Document status; Title; DWG No.; Abdeckung; Freigegeben; Kantenerkennung; Coasterbot; Dennis Borutta; D.Borutta

Bauteil gespiegelt. Maße identisch.
25 ¹⁶⁵.5

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

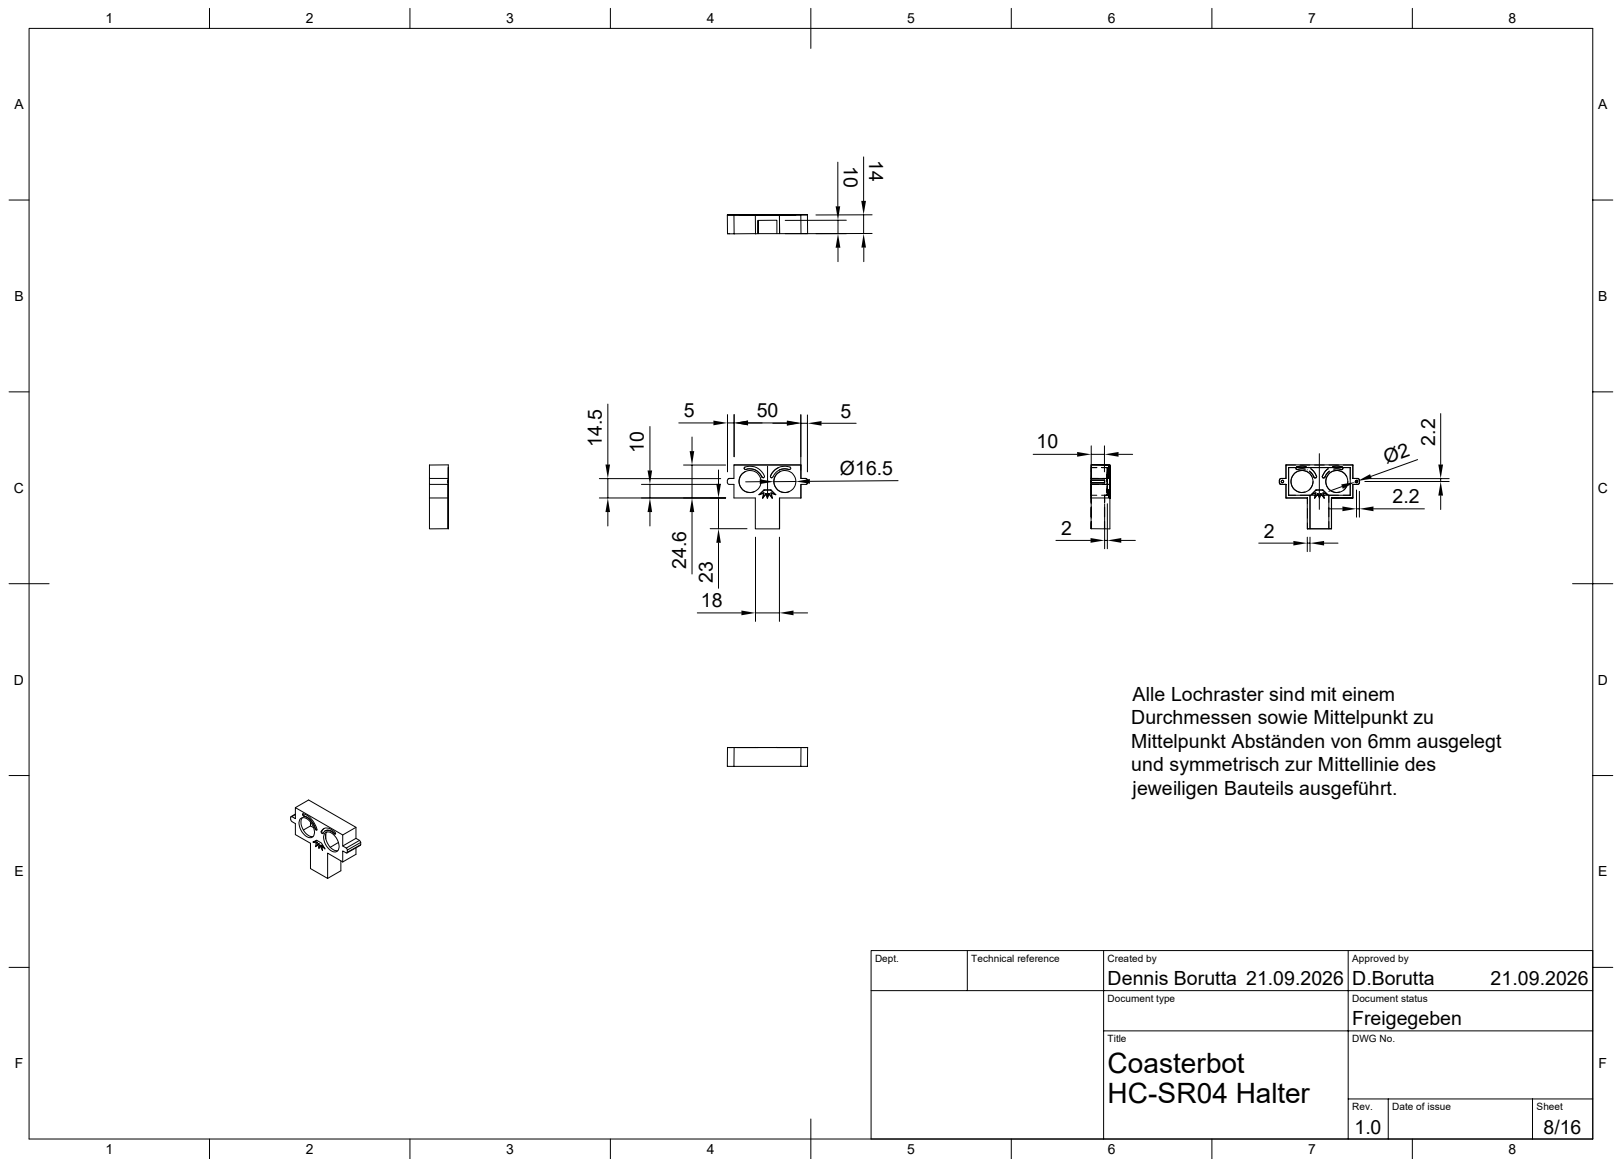
[picture p233: page 17]
Dept.; Technical reference; Created by; Approved by; Document type; Document status; Title; DWG No.; Freigegeben; HC-SR04 Halter; Coasterbot; Dennis Borutta; D.Borutta; 2 ¹⁰¹⁴.5

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

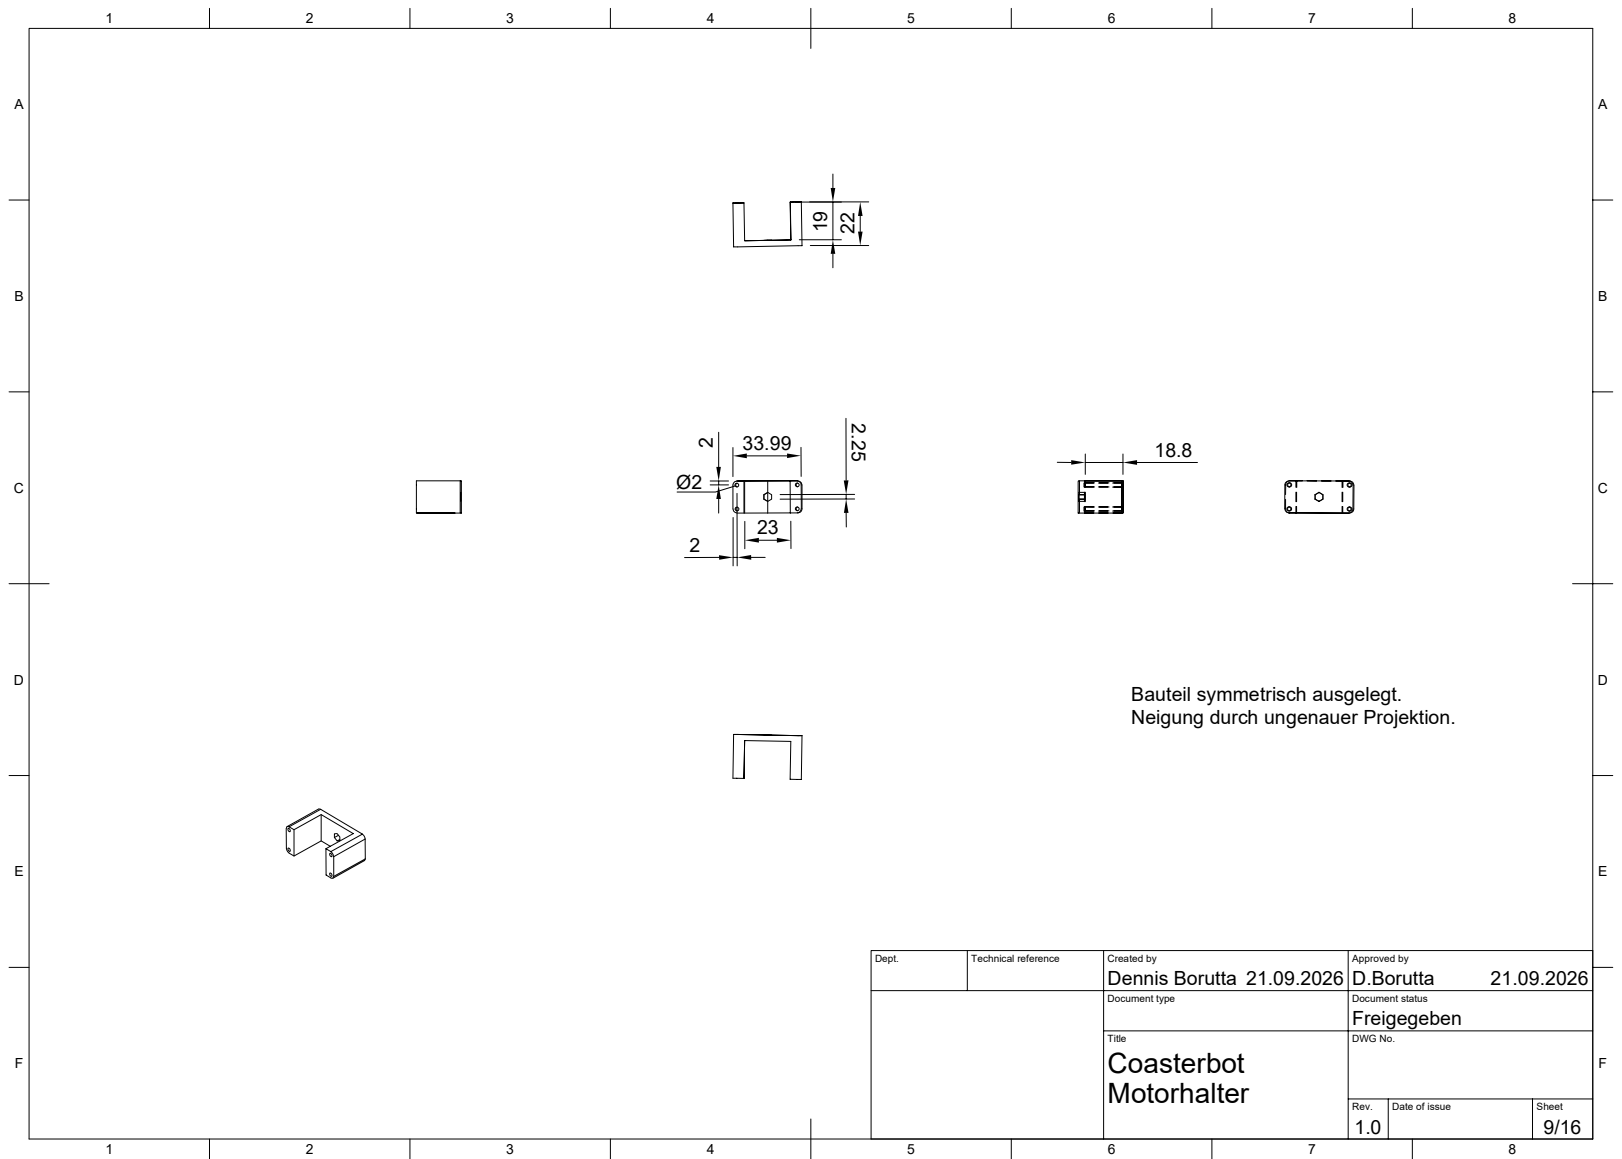
[picture p234: page 18]
Dept.; Technical reference; Created by; Approved by; Document type; Document status; Title; DWG No.; Freigegeben; Motorhalter; Coasterbot; Dennis Borutta; D.Borutta

Bauteil symmetrisch ausgelegt.
Neigung durch ungenauer Projektion.

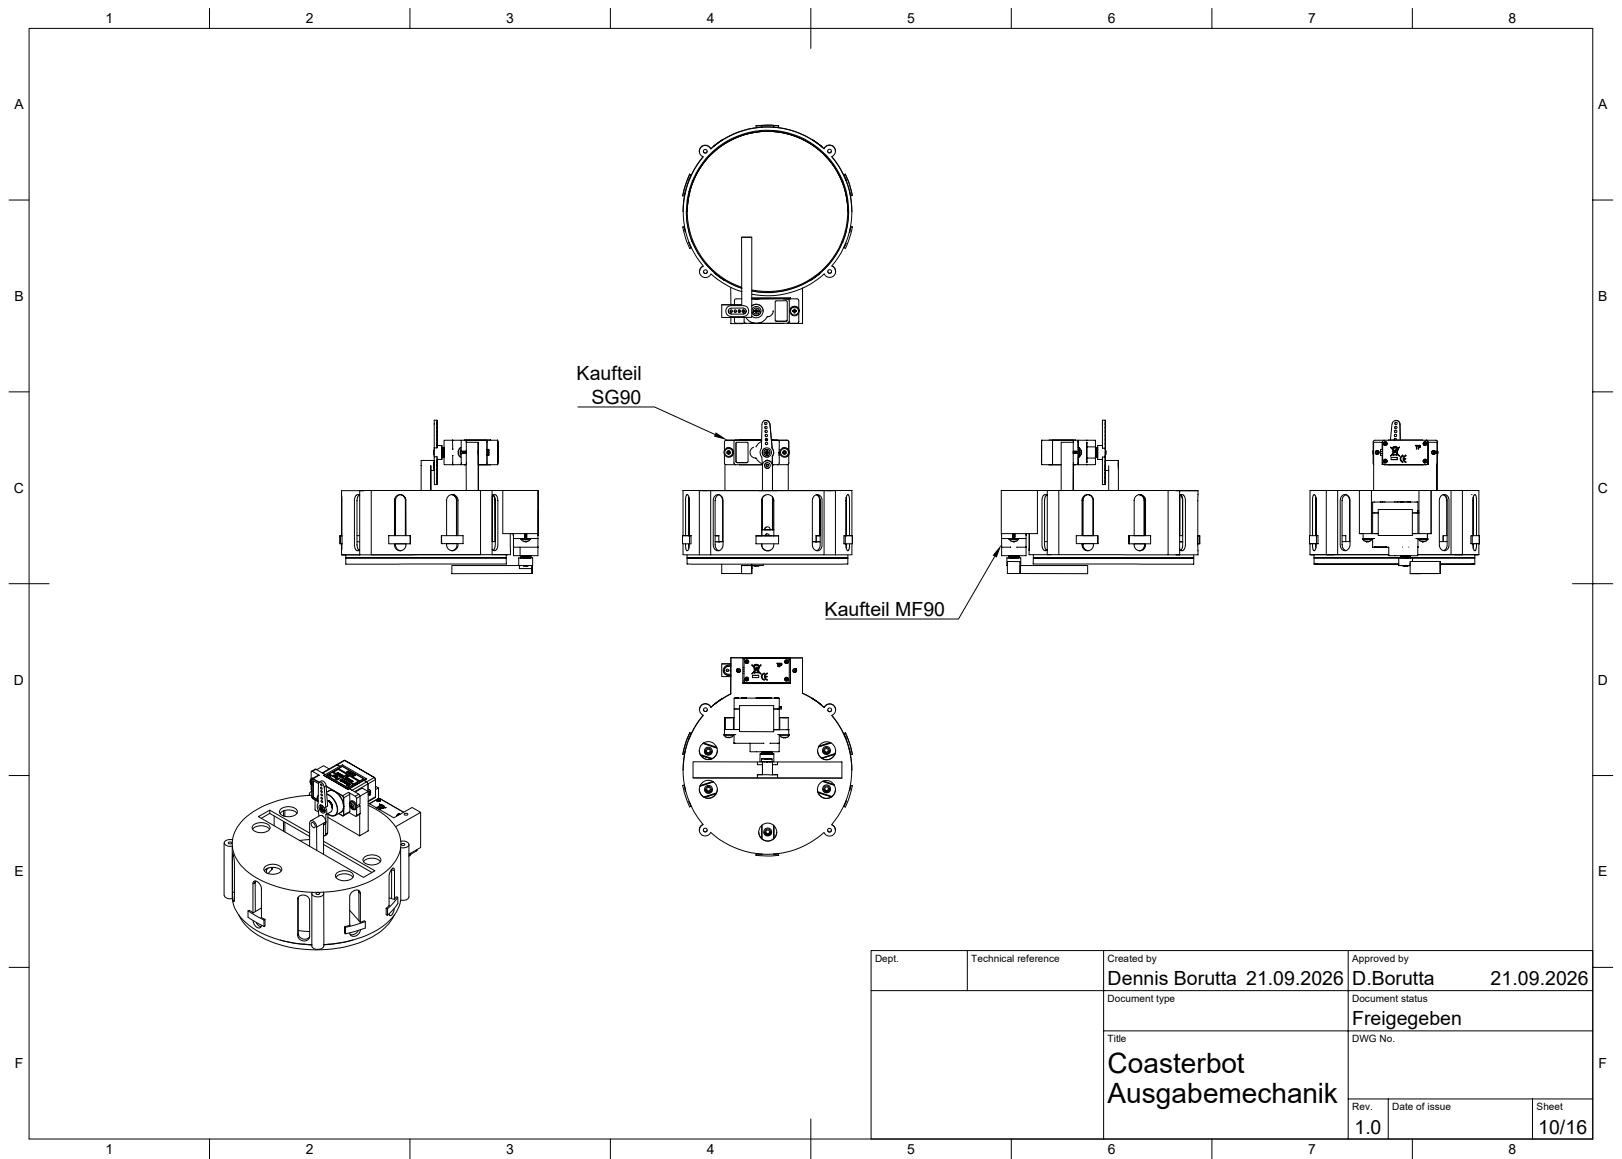
[picture p235: page 19]
Dept.; Technical reference; Created by; Approved by; Document type; Document status; Title; DWG No.; Freigegeben; Ausgabemechanik; Coasterbot; Dennis Borutta; D.Borutta; Kaufteil SG90; Kaufteil MF90

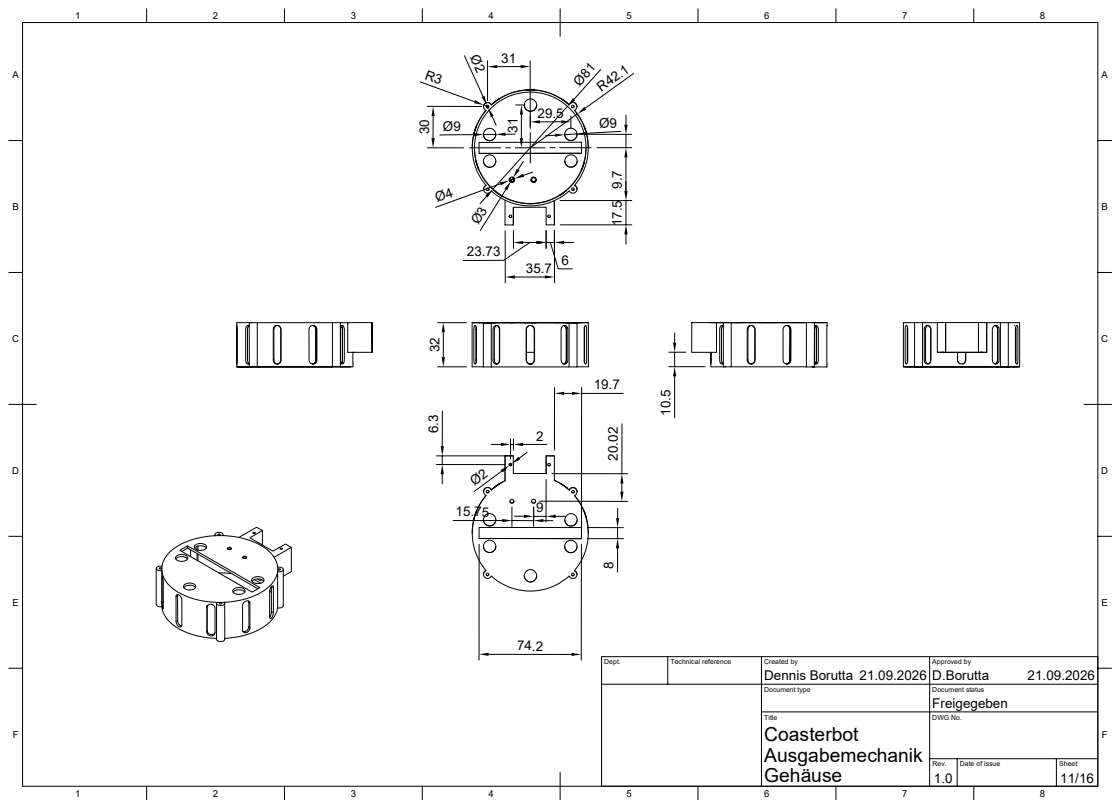
[picture p236: page 20]
Dept.; Technical reference; Created by; Approved by; Document type; Document status; Title; DWG No.; Gehäuse; Freigegeben; Ausgabemechanik; Coasterbot; Dennis Borutta; D.Borutta

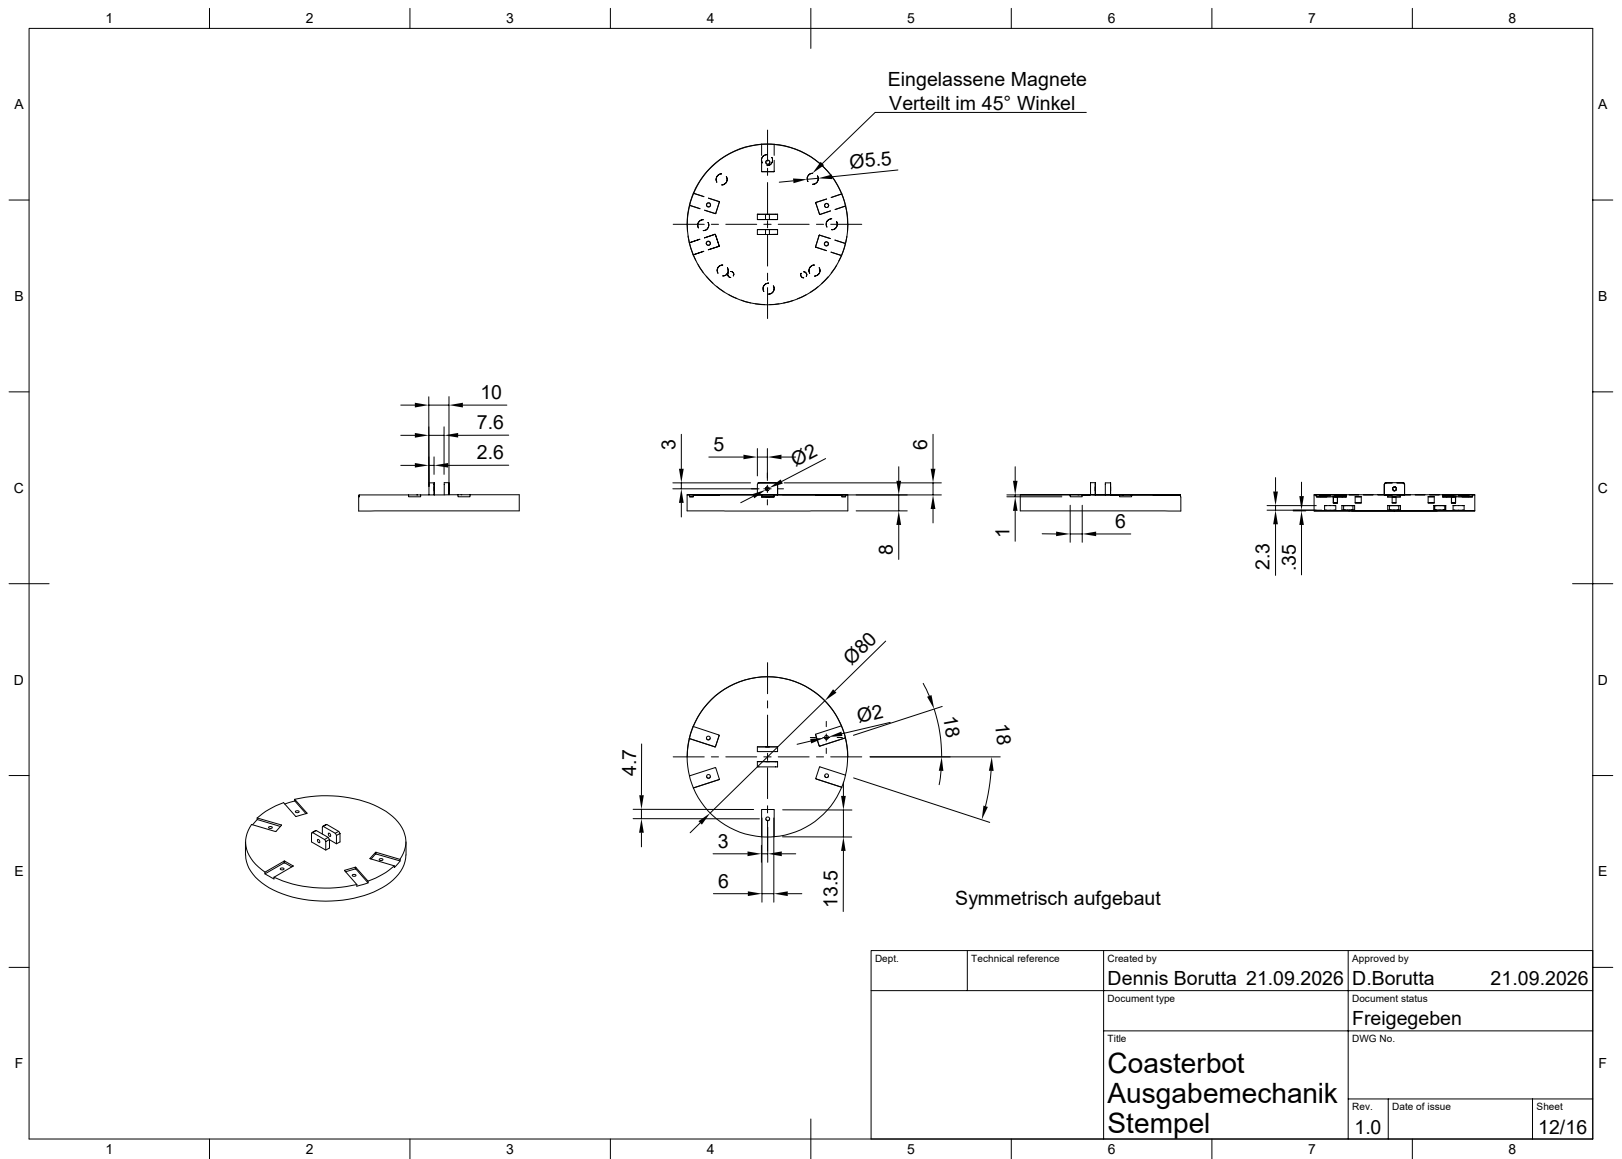
[picture p237: page 21]
Dept.; Technical reference; Created by; Approved by; Document type; Document status; Title; DWG No.; Stempel; Freigegeben; Ausgabemechanik; Coasterbot; Dennis Borutta; D.Borutta; Symmetrisch aufgebaut

Eingelassene Magnete
Verteilt im 45° Winkel

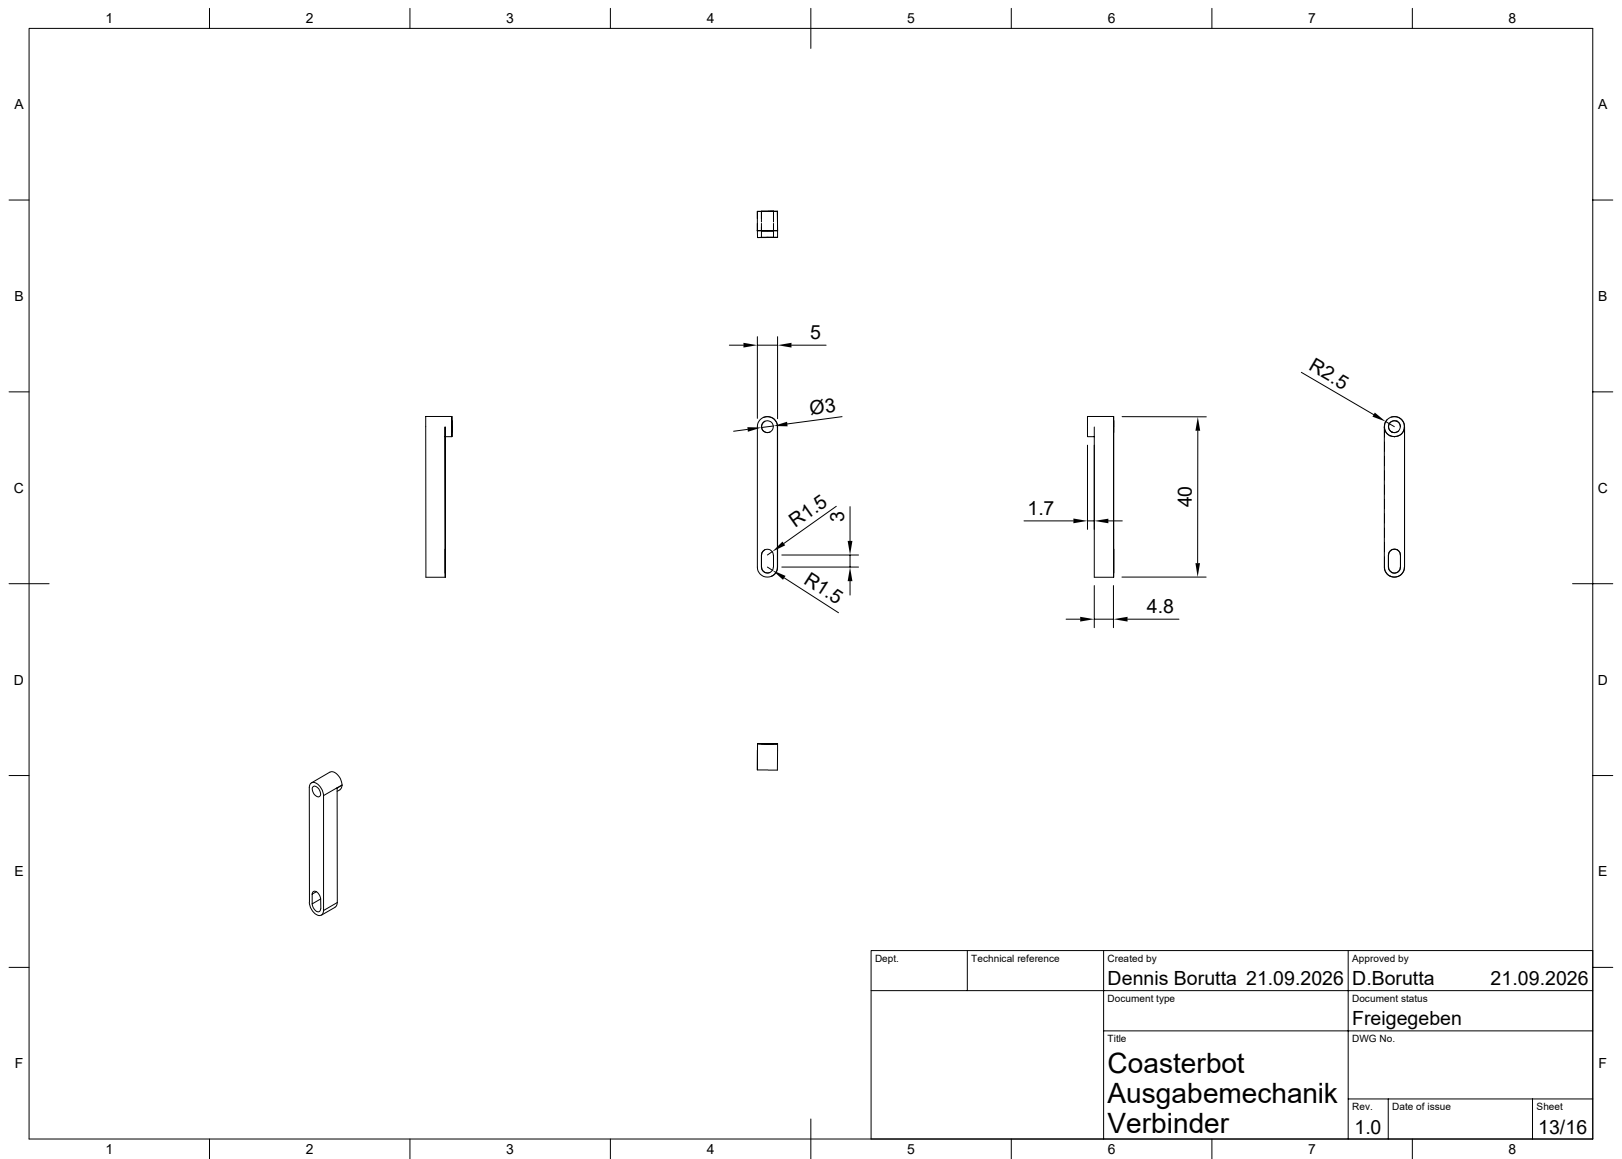
[picture p238: page 22]
Dept.; Technical reference; Created by; Approved by; Document type; Document status; Title; DWG No.; Verbinder; Freigegeben; Ausgabemechanik; Coasterbot; Dennis Borutta; D.Borutta

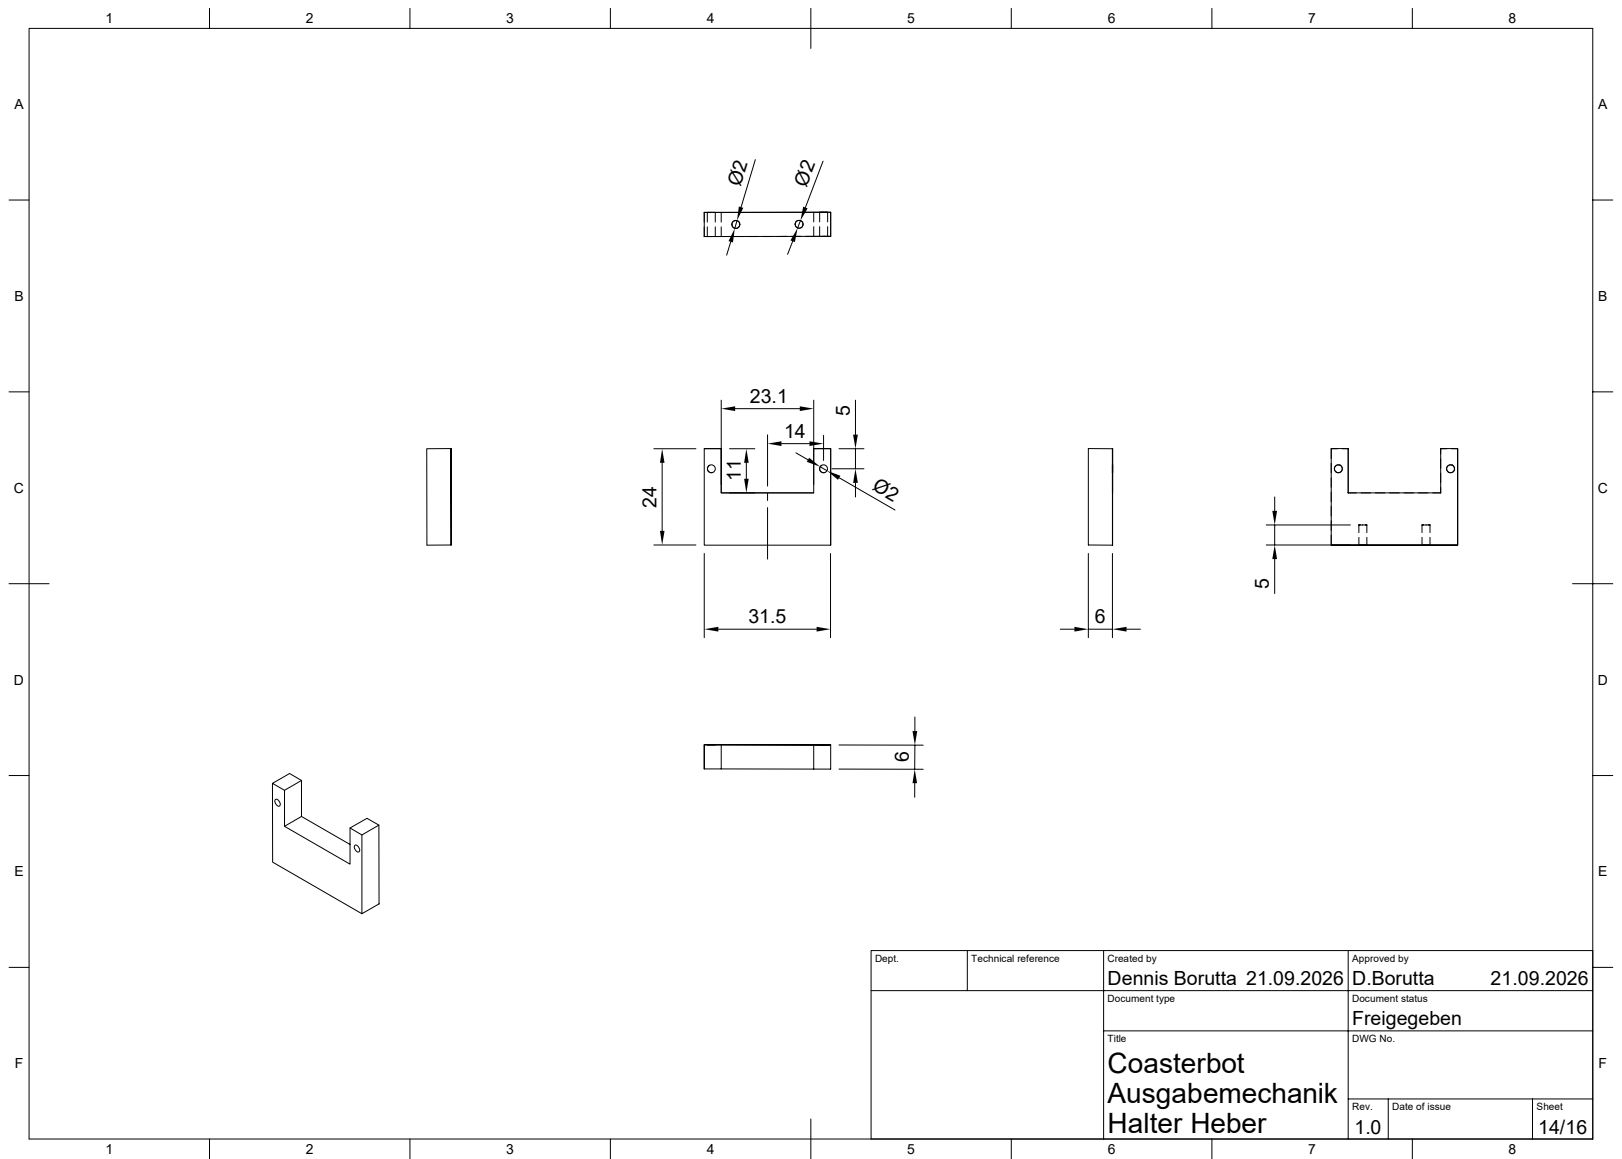
[picture p239: page 23]
Dept.; Technical reference; Created by; Approved by; Document type; Document status; Title; DWG No.; Halter Heber; Freigegeben; Ausgabemechanik; Coasterbot; Dennis Borutta; D.Borutta

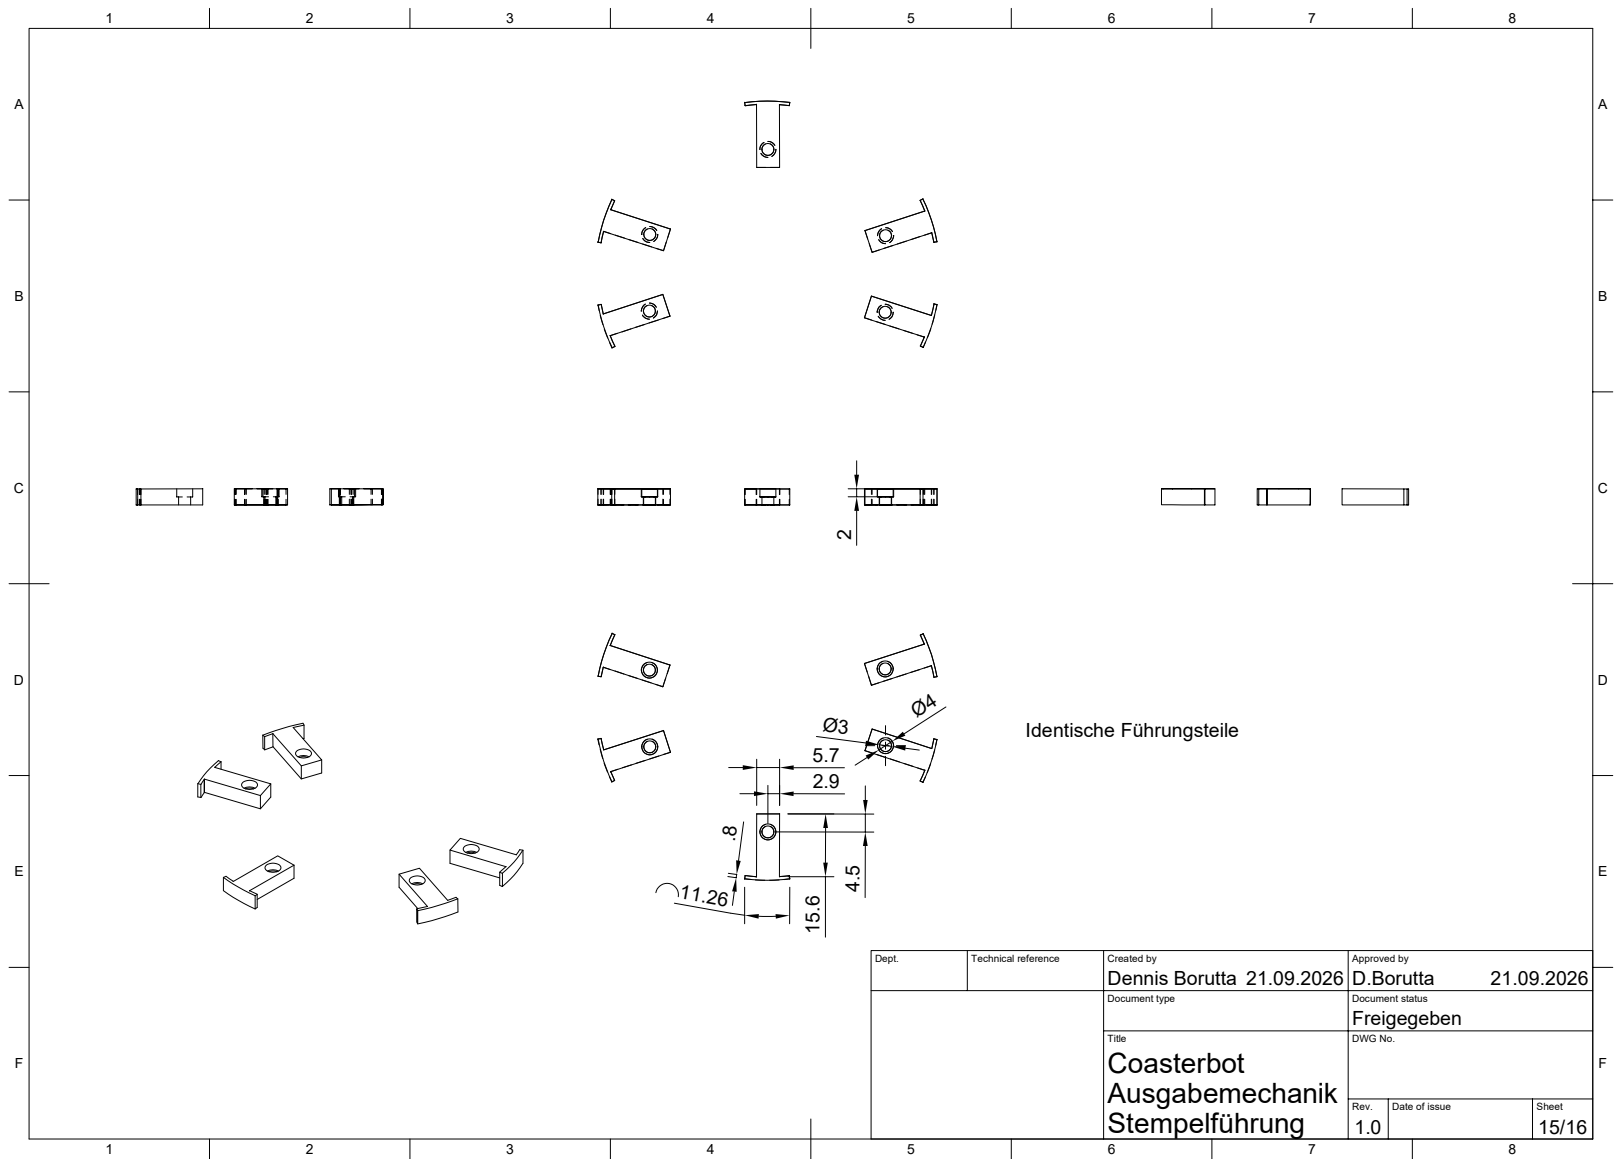
[picture p240: page 24]
Dept.; Technical reference; Created by; Approved by; Document type; Document status; Title; DWG No.; Stempelführung; Freigegeben; Ausgabemechanik; Coasterbot; Dennis Borutta; D.Borutta; Identische Führungsteile

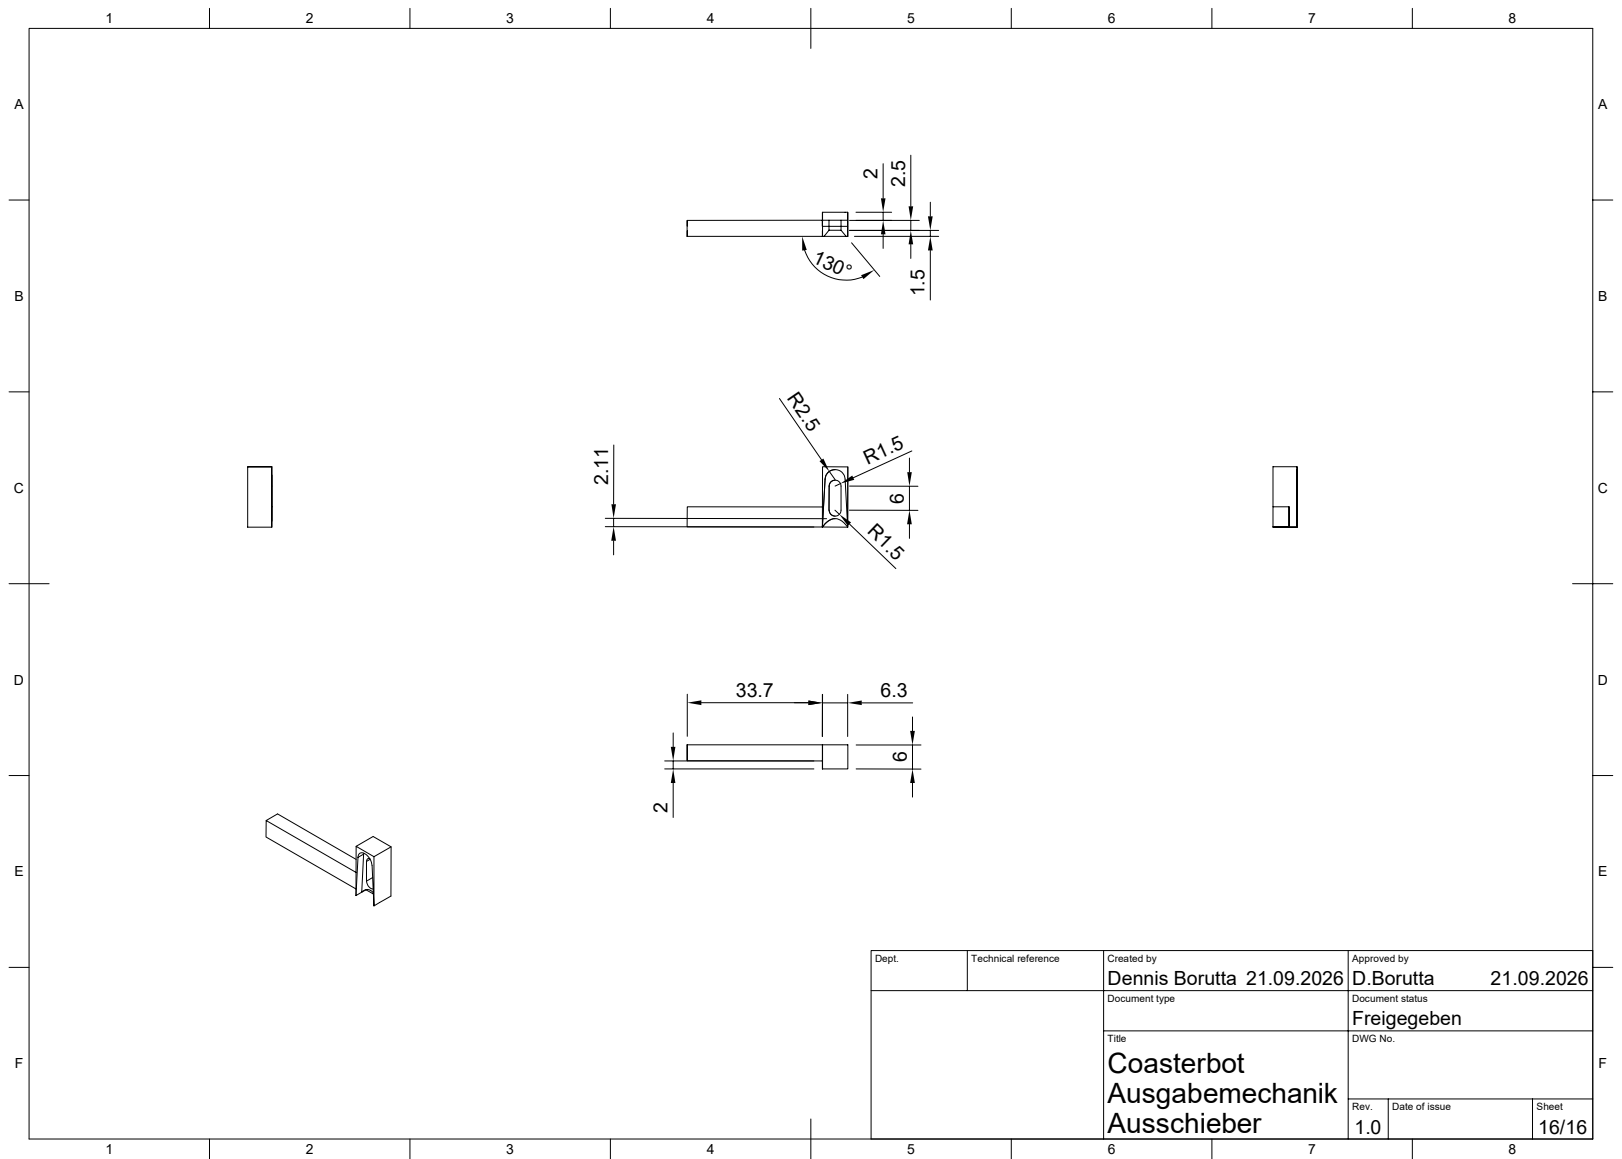
[picture p241: page 25]
Dept.; Technical reference; Created by; Approved by; Document type; Document status; Title; DWG No.; Ausschieber; Freigegeben; Ausgabemechanik; Coasterbot; Dennis Borutta; D.Borutta

### 2.2 Zeichnung Untersetzer

26

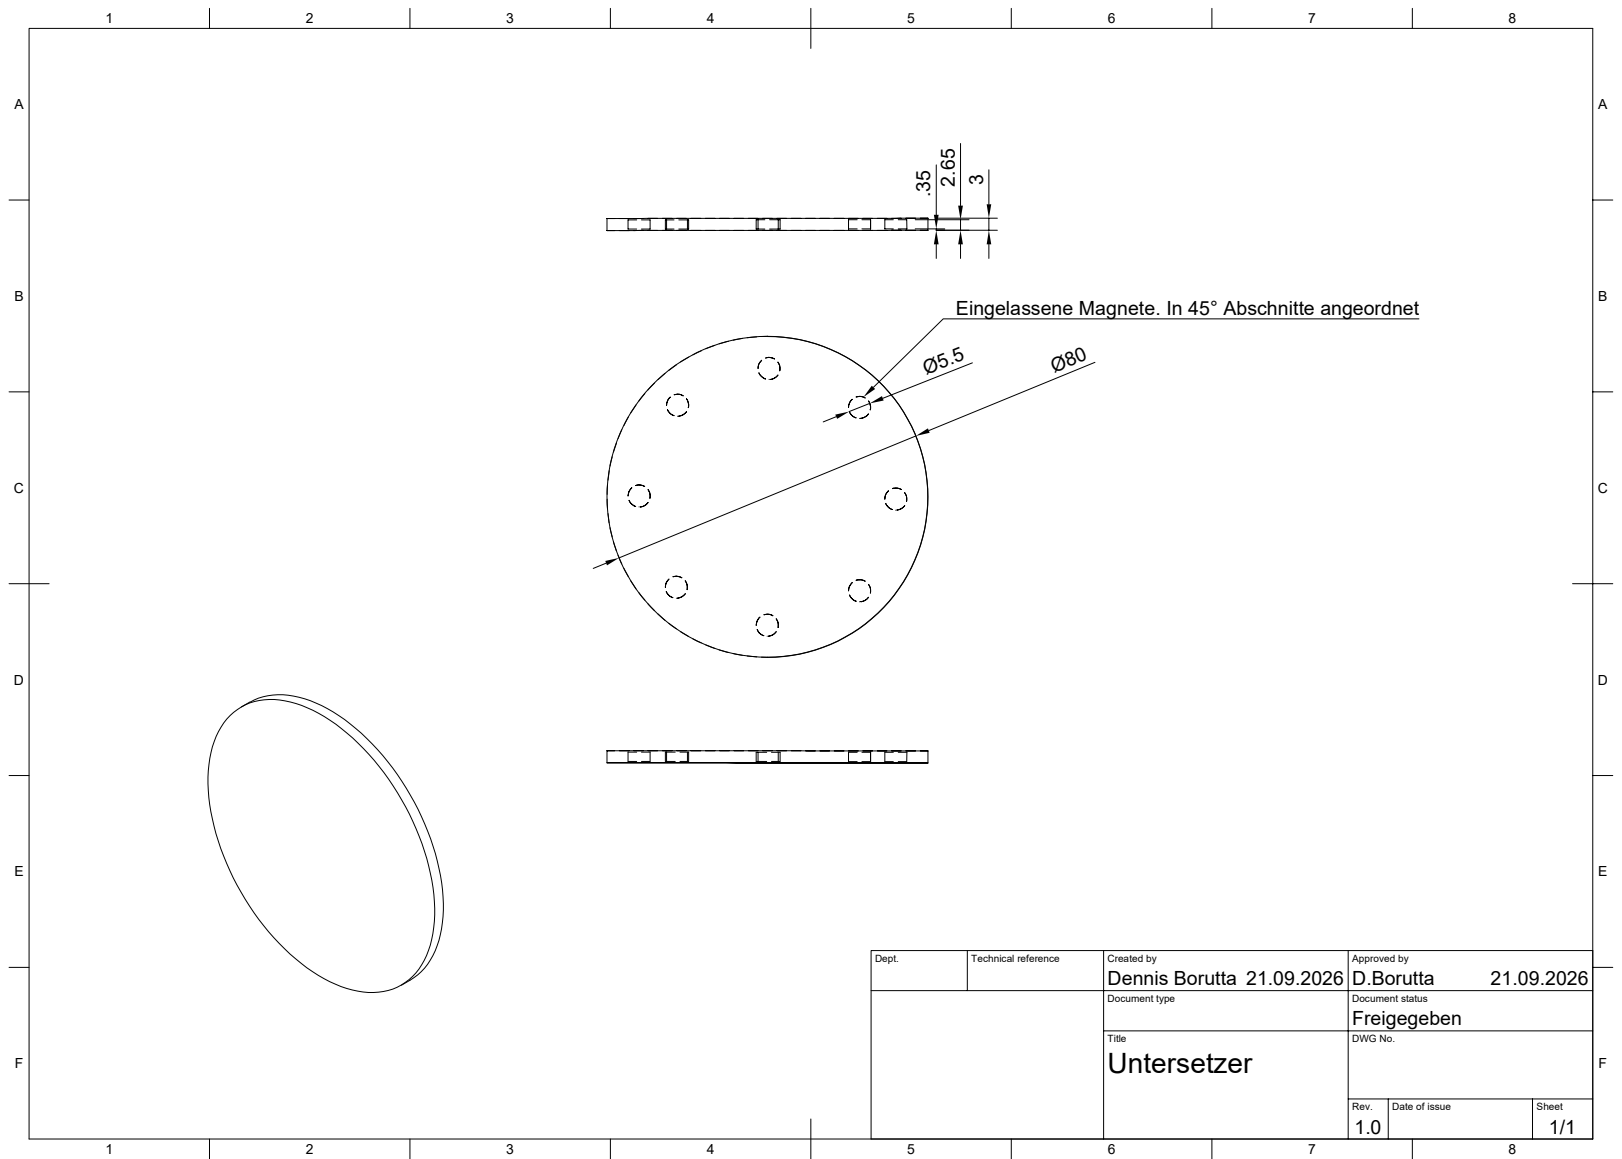
[picture p242: page 27]
Dept.; Technical reference; Created by; Approved by; Document type; Document status; Title; DWG No.; Freigegeben; Untersetzer; Dennis Borutta; D.Borutta

Eingelassene Magnete. In 45° Abschnitte angeordnet

### 2.3 Zeichnung Nacharbeit

28

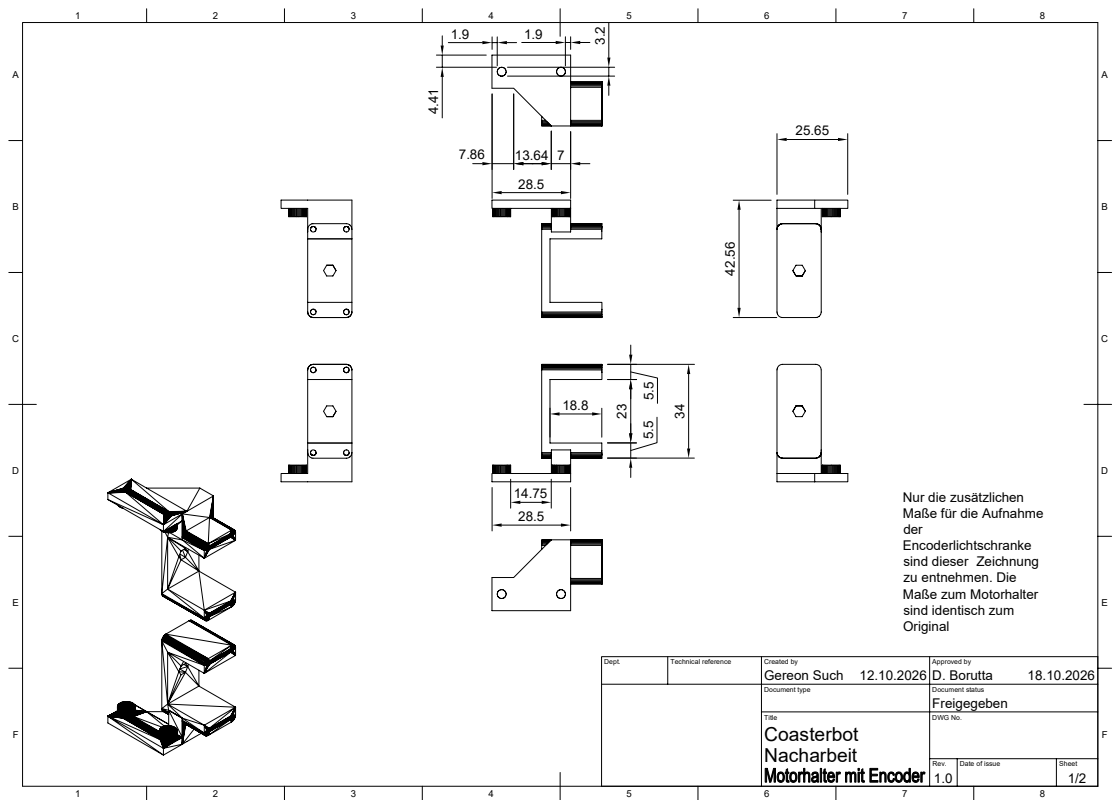
[picture p243: page 29]
Dept.; Technical reference; Created by; Approved by; Document type; Document status; Title; DWG No.; Freigegeben; Nacharbeit; Coasterbot; Gereon Such; D. Borutta ⁴².56

Nur die zusätzlichen
Maße für die Aufnahme
der
Encoderlichtschranke
sind dieser Zeichnung
zu entnehmen. Die
Maße zum Motorhalter
sind identisch zum
Original

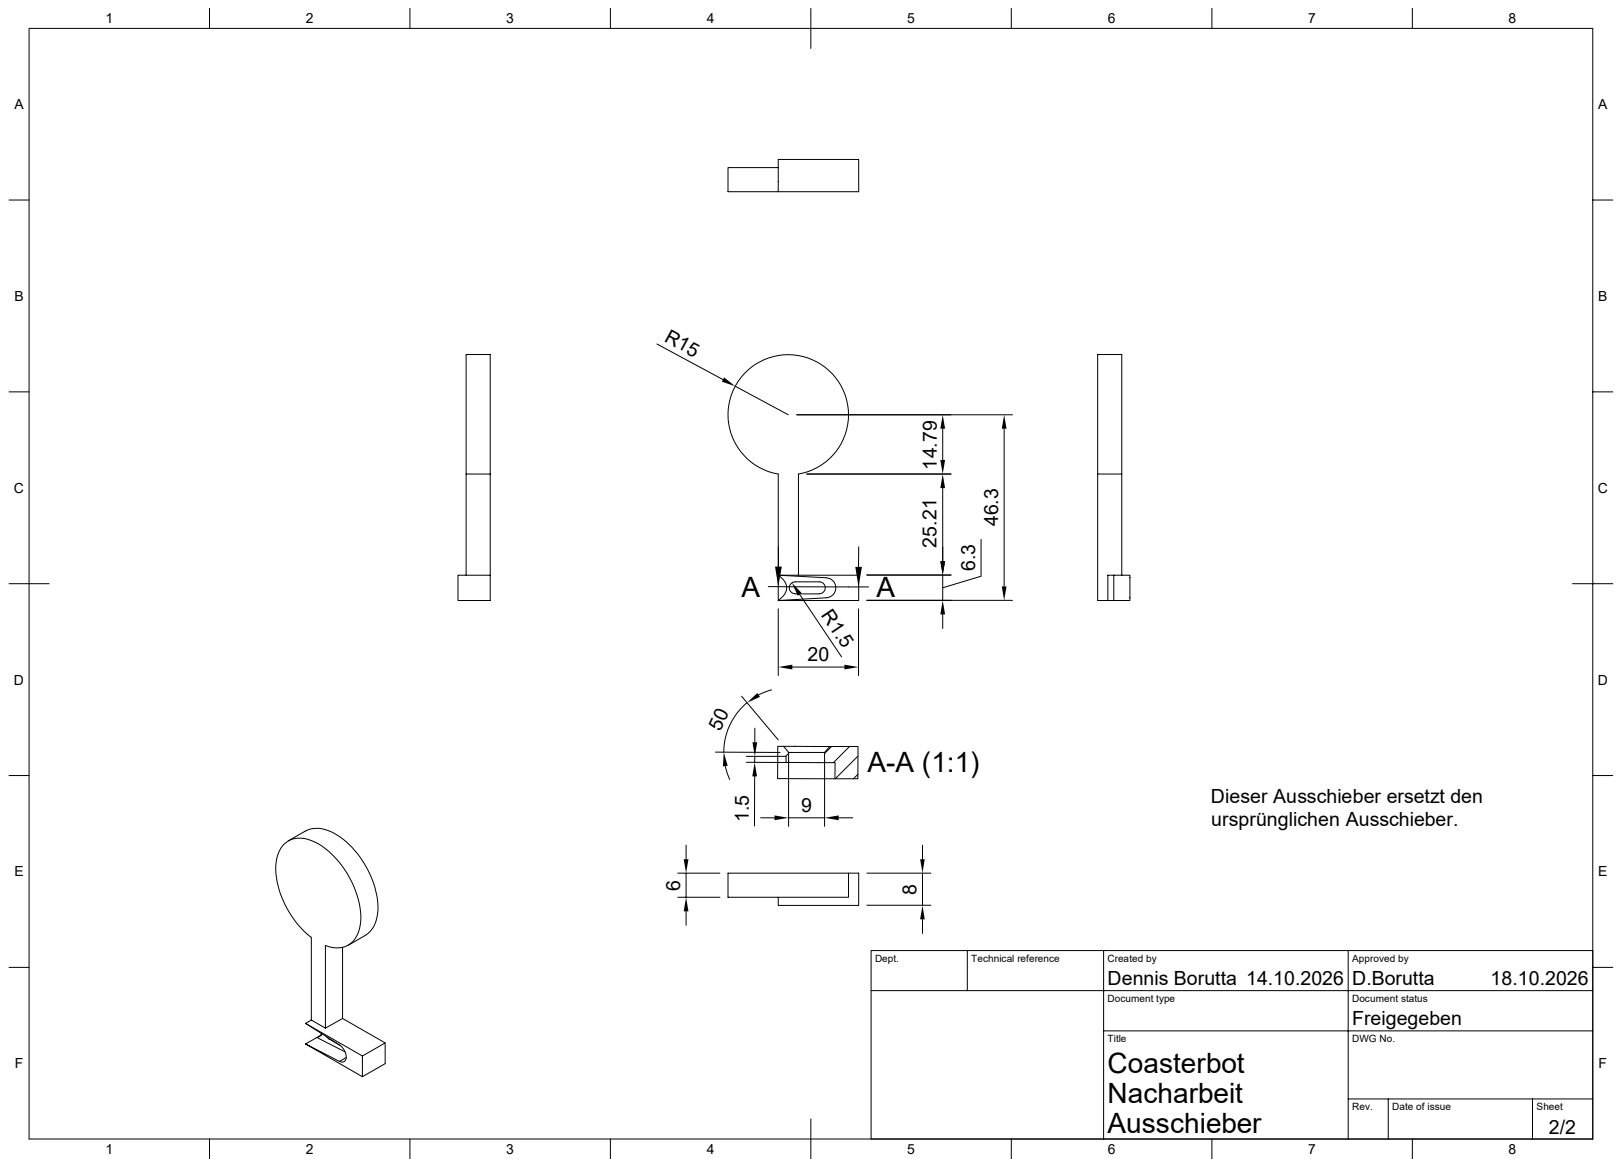
[picture p244: page 30]
Dept.; Technical reference; Created by; Approved by; Document type; Document status; Title; DWG No.; Ausschieber; Freigegeben; Nacharbeit; Coasterbot; Dennis Borutta; D.Borutta ⁴⁶.3 6.325.21 14.79; ursprünglichen Ausschieber.

9 Dieser Ausschieber ersetzt den
