Project-CoasterBot/coasterbot/M4_Test-und-Validierung/Softwaredokumentation/Softwaredokumentation.tex

%\documentclass[manuscript]{acmart}
%\documentclass[acmsmall]{acmart}
%\settopmatter{printacmref=false}

\documentclass[
  a4paper,
  12pt,
  DIV=12,        % höherer Wert = schmalere Ränder, weniger Whitespacmi
  parskip=half,  % Absätze mit halbem Abstand statt Einzug
  headings=small % kleinere Überschriften, weniger vertikaler Abstand
]{scrartcl}

%\documentclass[a4paper,11pt]{scrartcl}
%\documentclass[a4paper,11pt]{report}
%\documentclass[a4paper,12pt]{book}
\usepackage[utf8]{inputenc}
\usepackage[german]{babel}
\usepackage[T1]{fontenc}
\usepackage{lmodern}
\usepackage[inkscapelatex=false]{svg}
% Texte im SVG von Inkscape setzen lassen, nicht durch die Dokumentschrift ersetzen
\svgsetup{inkscapelatex=false}
\usepackage{amsmath}
\usepackage{caption}
\usepackage{gensymb}
\usepackage{microtype}
\usepackage{longtable}
\usepackage{tabularx}   % Spalten, die die restliche Zeilenbreite auffüllen (X-Spalte)
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

\usepackage{framed}

%\usepackage{fancyhdr}
%\pagestyle{fancy}
%\lhead{\leftmark}
%\chead{}
%\rhead{}
%\lfoot{}
%\cfoot{\thepage}
%\rfoot{}
%\renewcommand{\headrulewidth}{0.2pt}
%\renewcommand{\footrulewidth}{0.2pt}

\newcommand{\Z}{\mathbb{Z}}
\newcommand{\R}{\mathbb{R}}
\newcommand{\C}{\mathbb{C}}
\newcommand{\N}{\mathbb{N}}
\newcommand{\SqrtNy}{$\sqrt{\textsc{Ny}}$}
\newcommand{\conj}{\overline}
\newcommand{\Kset}{\textswab{K}}
\newcommand{\Qset}{\textswab{Q}}
\newcommand{\ceil}[1]{\left\lceil #1 \right\rceil}
\newcommand{\floor}[1]{\left\lfloor #1 \right\rfloor}
\newcommand{\sorted}[1]{\textsc{sort}\left\lbrace #1 \right\rbrace}
\newcommand{\SNRgain}{a_{SNR}}
\newcommand{\EQgain}{a_{EQ}}
\newcommand{\SIRgain}{a_{SIR}}
\newcommand{\SNIRgain}{a_{SINR}}
\newcommand{\SNR}{\textsc{SNR}}
\newcommand{\CIRgain}{a_{CIR}}
\newcommand{\CINRgain}{a_{CINR}}
\newcommand{\CNR}{\textsc{CNR}}
\newcommand{\CINR}{\textsc{CINR}}
\newcommand{\HPAModel}{ Hughes 1177H TWTA }
\newcommand{\bigO}{\mathcal{O}}
\newcommand{\CopWinCompl}{2.375377}
\newcommand{\IBO}{\textsc{IBO}}
\newcommand{\OBO}{\textsc{OBO}}
\newcommand{\spacepage}{\newpage\null\thispagestyle{empty}\newpage}
\newcommand{\satcom}{ SatCom }
\newcommand{\db}{~\text{dB}}

\definecolor{mGreen}{rgb}{0,0.6,0}
\definecolor{mGray}{rgb}{0.5,0.5,0.5}
\definecolor{mPurple}{rgb}{0.58,0,0.82}
\definecolor{backgroundColour}{rgb}{0.95,0.95,0.92}

\lstdefinestyle{CStyle}{
    backgroundcolor=\color{backgroundColour},
    commentstyle=\color{mGreen},
    keywordstyle=\color{magenta},
    numberstyle=\tiny\color{mGray},
    stringstyle=\color{mPurple},
    basicstyle=\footnotesize,
    breakatwhitespace=false,
    breaklines=true,
    captionpos=b,
    keepspaces=true,
    numbers=left,
    numbersep=5pt,
    showspaces=false,
    showstringspaces=false,
    showtabs=false,
    tabsize=2,
    language=C
}

\lstdefinelanguage{VHDL}{
  morekeywords=[1]{library,use,all,entity,is,port,in,out,end,architecture,of,begin,process,if,then,else,elsif,when,others,signal,variable,wait,for,loop},
  morecomment=[l]--,
  morestring=[b]",
  sensitive=true
}

\lstset{
  language=VHDL,
  basicstyle=\ttfamily\small,
  keywordstyle=\color{blue},
  commentstyle=\color{gray},
  stringstyle=\color{red},
  numbers=left,
  numberstyle=\tiny,
  stepnumber=1,
  numbersep=8pt,
  frame=single,
  breaklines=true,
  captionpos=b
}

\lstset{numbers=none}

%\newcounter{example}
%\renewcommand{\theexample}{\thesection.\arabic{example}}

% Default fixed font does not support bold face
\DeclareFixedFont{\ttb}{T1}{txtt}{bx}{n}{12} % for bold
\DeclareFixedFont{\ttm}{T1}{txtt}{m}{n}{12}  % for normal

% Custom colors
\usepackage{color}
\definecolor{deepblue}{rgb}{0,0,0.5}
\definecolor{deepred}{rgb}{0.6,0,0}
\definecolor{deepgreen}{rgb}{0,0.5,0}

\usepackage{listings}

% Python style for highlighting
\newcommand\pythonstyle{\lstset{
language=Python,
basicstyle=\ttm,
morekeywords={self},              % Add keywords here
keywordstyle=\ttb\color{deepblue},
emph={MyClass,__init__},          % Custom highlighting
emphstyle=\ttb\color{deepred},    % Custom highlighting style
stringstyle=\color{deepgreen},
frame=tb,                         % Any extra options here
showstringspaces=false
}}

% Python environment
\lstnewenvironment{python}[1][]
{
\pythonstyle
\lstset{#1}
}
{}

% Python for external files
\newcommand\pythonexternal[2][]{{
\pythonstyle
\lstinputlisting[#1]{#2}}}

% Python for inline
\newcommand\pythoninline[1]{{\pythonstyle\lstinline!#1!}}

% ---------------------------------------------------------------------
% Stil fuer C++-Listings dieser Dokumentation
% ---------------------------------------------------------------------
\lstdefinestyle{cpp}{
  language=C++,
  basicstyle=\ttfamily\footnotesize,
  keywordstyle=\color{deepblue},
  commentstyle=\color{mGreen},
  stringstyle=\color{mPurple},
  numbers=none,
  breaklines=true,
  showstringspaces=false,
  frame=single,
  columns=fullflexible,
  captionpos=b
}

%\nocite{*}

\begin{document}
%\pagenumbering{roman}

\title{Coasterbot}
\subtitle{Softwaredokumentation}
\author{Stefan Etringer}
%\email{gereonsuch@suchdsp.com}
%\affiliation{
%  \institution{Wilhelm Büchner University of Applied Sciences}
%  \department{Computer Engineering}
%  \city{Hof}
%  \country{Germany}
%}

\begin{titlepage}
  \begin{center}
    {\large Wilhelm Büchner University of Applied Sciences} \\[0.3em]

    {\normalsize Projektseminar Master}
\vspace{5em}

    {\LARGE\bfseries Coasterbot} \\[0.5em]

    {\large Softwaredokumentation} \\[1em]

    {} \\[1em]

\vspace{4em}

    {\normalsize
\begin{tabular}{ll}
Dennis Borutta, B. Eng & dennis.borutta@outlook.com\\
Stefan Etringer, B. Eng & mail@stefan.works\\
Gereon Such, M. Sc. & gereonsuch@gmail.com\\
\end{tabular}
    }
  \end{center}

\end{titlepage}

% einleitung preambel etc.

% Versionshistorie des Dokuments: eigene Seite direkt nach dem Titelblatt
\section*{Versionshistorie}

% longtable statt tabularx: die Tabelle ist inzwischen fast eine volle Seite
% lang. tabularx ist ein einziger unteilbarer Block - passte sie zusammen mit
% der Ueberschrift nicht mehr auf die (bereits durch \end{titlepage} neu
% begonnene) Seite, schob LaTeX beides als Ganzes auf die naechste Seite und
% liess die davor komplett leer. longtable bricht die Tabelle stattdessen
% ganz normal um.
\begin{longtable}{@{}clp{2.6cm}p{0.52\textwidth}@{}}
\toprule
\textbf{Version} & \textbf{Datum} & \textbf{Bearbeiter} & \textbf{Änderungen}\\
\midrule
\endhead
\bottomrule
\endfoot
1 & 08.09.2026 & Etringer & Erstfassung der Softwaredokumentation\\
2 & 08.09.2026 & Etringer & Lokalisierung um Prinzip und Grenzen ergänzt\\
3 & 13.09.2026 & Etringer & Offene Punkte aus Hardware-Rückmeldung zu \texttt{RobotHAL} ergänzt\\
4 & 13.09.2026 & Etringer & Kantensensoren liefern jetzt \texttt{bool} statt \texttt{float}, Kalibrierung in \texttt{WebotsHAL} gekapselt\\
5 & 13.09.2026 & Etringer & \texttt{enum WheelId} auf \texttt{WHEEL\_LEFT}/\texttt{WHEEL\_RIGHT} reduziert (ein Encoder je Seite)\\
6 & 14.09.2026 & Etringer & Geglättete Kartenanpassung und digitales Kantensignal umgesetzt; Ausblick Tischerkundung ergänzt\\
7 & 14.09.2026 & Etringer & Ausblick Tischerkundung zu Stufenplan (Stufe 0 bis 7) ausgearbeitet\\
8 & 16.09.2026 & Etringer & Gyro-Schnittstelle um Hardware-Hinweise ergänzt (Kalibrierung, Skid-Steer)\\
9 & 20.09.2026 & Etringer & Inertialsensor (GY-521/MPU6050) in \texttt{WebotsHAL::getGyroZ()} simuliert (Abschnitt~\ref{gyro-simulation}); \texttt{randomSeed} fest gesetzt\\
10 & 21.09.2026 & Etringer & Open-/Closed-Loop-Motorregelung implementiert und verglichen (\texttt{MODE\_MOTOR\_CONTROL\_TEST}, Abschnitt~\ref{motor-control-vergleich})\\
11 & 28.09.2026 & Such & Besonderheiten der Hardware Implementierung hinzugefügt\\
12 & 28.09.2026 & Ertringer, Borutta & Statemachine ergänzt \\
13 & 19.10.2026 & Etringer & Codeblock in \enquote{Non-blocking Implementierung} angepasst. Kapitel~\ref{grenzen} aktualisiert (realer Encoder, Untersetzerhandling in \texttt{coasterbot\_V\_01\_00})\\
14 & 20.10.2026 & Borutta & Kleinere Erweiterung im Missionsablauf\\
\end{longtable}

\newpage

\tableofcontents

\newpage

% Etwas mehr Toleranz beim Umbruch: viele \texttt{}-Bezeichner sind nicht
% trennbar und wuerden sonst knapp ueber den Satzspiegel ragen.
\setlength{\emergencystretch}{3em}

% =====================================================================
\section{Einleitung}\label{einleitung}
% =====================================================================

\subsection{Zweck des Dokuments}\label{zweck-des-dokuments}

Dieses Dokument beschreibt die \textbf{Software der Simulation des
Coasterbots} sowie deren Funktionen. Dokumentiert wird sowohl die
Softwarearchitektur, als auch die einzelnen Softwarekomponenten, ihre
Schnittstellen und das Laufzeitverhalten in der Simulationsumgebung.

Grundlage der Dokumentation sind die im Projekt erstellten
Anforderungs- und Testdokumente:

\begin{itemize}
\tightlist
\item
  \textbf{Lastenheft}: funktionale und nichtfunktionale Anforderungen
  des Auftraggebers (Kennungen \texttt{NAV-*}, \texttt{SAF-*},
  \texttt{MON-*}, \texttt{NFA-*}, \texttt{SIM-*}).
\item
  \textbf{Pflichtenheft}: die geplante technische Umsetzung,
  die geschichtete System- und Softwarearchitektur (Hardwaretreiber,
  Hardwareabstraktion, Systemdienste, Funktionskomponenten,
  Anwendungsebene, Simulationsebene).
\item
  \textbf{Testkonzept}: Teststrategie und Simulationstestfälle
  (\texttt{ST-SIM-001} bis \texttt{ST-SIM-008}).
\item
  \textbf{Alternativenbeschreibung}: Auswahl der Navigations- und
  Lokalisierungsalgorithmen (A*, D* Lite, DWA, Sensorfusion).
\item
  \textbf{Stückliste (BOM)}: die für die reale Hardware festgelegten
  Bauteile, u.a.\ der Inertialsensor (Position 11: \enquote{ICQUANZX
  GY-521 MPU6050}), den die Simulation in Abschnitt~\ref{gyro-simulation}
  nachbildet.
\end{itemize}

Die Software wurde anhand der im Pflichtenheft beschriebenen
Abstraktion umgesetzt: Die Systemlogik ist vollständig von
der Hardware entkoppelt und kommuniziert über
eine Hardwareabstraktionsschicht. Dadurch sind die Funktionen im Quellcode sowohl
in der Simulation (Webots) als auch auf der Zielhardware (Mikrocontroller)
lauffähig.

\subsection{Gegenstand und Abgrenzung}\label{gegenstand-und-abgrenzung}

Gegenstand dieser Dokumentation ist die Software des
Webots-Controllers \texttt{coasterbot} (C++), die den simulierten
Roboter steuert. Dokumentiert werden:

\begin{itemize}
\tightlist
\item
  die Hardwareabstraktion (\texttt{RobotHAL} / \texttt{WebotsHAL}),
\item
  die Lokalisierung (\texttt{PoseEstimator}),
\item
  das Umgebungsmodell (\texttt{OccupancyGrid}),
\item
  die globale Pfadplanung (\texttt{astarPlan}, A*),
\item
  die dynamische Neuplanung (\texttt{DStarLite}, D* Lite),
\item
  die lokale Kollisionsvermeidung und Bewegungssteuerung
  (\texttt{DwaPlanner}),
\item
  die Sicherheitskomponente (\texttt{SafetyMonitor}),
\item
  die Fehlerüberwachung (\texttt{FaultMonitor}),
\item
  die reaktive Verhaltenslogik (\texttt{RobotLogic}),
\item
  die Ablaufsteuerung und Betriebsarten (\texttt{main.cpp}),
\item
  das Simulationsmodell (Webots-Welten und \texttt{Coasterbot}-PROTO).
\end{itemize}

\textbf{Nicht} Bestandteil dieser Dokumentation bzw.\ der aktuellen
Umsetzung sind:

\begin{itemize}
\tightlist
\item
  das Untersetzerhandling (Aufnahme/Ablage von Getränkeuntersetzern,
  \texttt{CST-*}) inkl.\ der Manipulationsplanung (IK + RRT*),
\item
  die missionsbezogene Ablaufsteuerung \texttt{IDLE} $\to$
  \texttt{SEARCH\_COASTER} $\to$ \texttt{PICK\_UP} $\to$ \texttt{TRANSPORT}
  $\to$ \texttt{PLACE} $\to$ \texttt{VERIFY} $\to$ \texttt{DONE},
\item
  eine probabilistische Sensorfusion (EKF/UKF), es wird ein
  Komplementärfilter verwendet (siehe Abschnitt~\ref{lokalisierung}).
\end{itemize}

Der Umsetzungsstand bezieht sich auf den \textbf{Maturity Level~1}
(Prototyp): autonome Navigation, Lokalisierung, sichere Bewegung und
Tischkantenerkennung.

\subsection{Begriffe und Abkürzungen}\label{begriffe-und-abkuerzungen}

\begin{longtable}[]{@{}p{0.22\textwidth}p{0.72\textwidth}@{}}
\toprule
\textbf{Begriff} & \textbf{Bedeutung}\\
\midrule
\endhead
HAL & Hardware Abstraction Layer, Hardwareabstraktionsschicht\\
PROTO & Webots-Modellbeschreibung eines Roboters oder Objekts\\
Pose & Lage des Roboters in der Ebene: $(x, y, \theta)$\\
Belegungskarte & Rasterkarte der Fläche, Zellen frei oder belegt (occupancy grid)\\
A* & heuristischer Graphsuch-Algorithmus für die globale Pfadplanung\\
D* Lite & inkrementeller Neuplaner (Koenig \& Likhachev, 2002)\\
DWA & Dynamic Window Approach, lokale Bewegungsplanung im Geschwindigkeitsraum\\
Carrot-Punkt & vorausliegender Zielpunkt auf dem Pfad (Pure Pursuit)\\
Skid-Steer & Panzerlenkung: Lenkung über Drehzahldifferenz linker/rechter Räder\\
Regelzyklus & ein Simulationsschritt (\texttt{basicTimeStep}), typ.\ \SI{32}{\milli\second}\\
\bottomrule
\end{longtable}

% =====================================================================
\section{Softwarearchitektur}\label{softwarearchitektur}
% =====================================================================

\subsection{Architekturprinzip}\label{architekturprinzip}

Die Software folgt dem im Pflichtenheft (Kapitel \enquote{Softwarekonzept})
beschriebenen \textbf{geschichteten, komponentenbasierten}
Architekturmodell. Jede Schicht hat eine abgegrenzte
Verantwortlichkeit und kommuniziert über
Schnittstellen mit den benachbarten Schichten. Höhere Schichten kennen
keine Hardware- oder Simulationsdetails.

Die zentrale Abstraktion ist die Hardwareabstraktionsschicht
\texttt{RobotHAL}. Diese ist ein abstraktes C++ Interface, das lose gekoppelt
\emph{weder} Webots \emph{noch} eine konkrete Mikrocontroller-Bibliothek
kennt. Alle Funktionskomponenten (Lokalisierung, Planung, Sicherheit)
sind gegen dieses Interface programmiert. Dadurch werden
die Anforderungen \texttt{NFA-ARC-005}, \texttt{NFA-MAI-001/002} und
\texttt{NFA-SIM-004} erfüllt.

\begin{figure}[H]
\centering
\begin{tikzpicture}[font=\footnotesize,
  layer/.style={draw, rounded corners=1pt, minimum width=11.8cm,
                minimum height=0.9cm, align=center, fill=blue!4},
  sim/.style={draw, rounded corners=1pt, minimum width=11.8cm,
              minimum height=0.9cm, align=center, fill=green!5}]
\node[layer] (app) {\textbf{Anwendungs-/Ablaufsteuerung} \\
  \texttt{main.cpp}: Betriebsart (\texttt{MODE}), Szenario, Hauptschleife};
\node[layer, below=2mm of app] (fun) {\textbf{Funktionskomponenten} \\
  \texttt{PoseEstimator}, \texttt{astarPlan}, \texttt{DStarLite}, \texttt{DwaPlanner}, \\
  \texttt{SafetyMonitor}, \texttt{RobotLogic}};
\node[layer, below=2mm of fun] (svc) {\textbf{Systemdienste / Modelle} \\
  \texttt{OccupancyGrid} (Umgebungsmodell, Distanzfeld)};
\node[layer, below=2mm of svc] (hal) {\textbf{Hardwareabstraktion} \\
  \texttt{RobotHAL}: rein abstraktes Interface (Sensoren, Aktoren, Zeit)};
\node[layer, below=2mm of hal] (drv) {\textbf{Hardwaretreiberebene} \\
  \texttt{WebotsHAL} (Webots-C++-API) \quad$|$\quad künftig \texttt{ArduinoHAL}};
\node[sim, below=2mm of drv] (webots) {\textbf{Simulationsebene} \\
  Webots R2025b + \texttt{Coasterbot.proto} (Sensor-/Aktormodelle, Welt)};
\draw[<->] (app) -- (fun);
\draw[<->] (fun) -- (svc);
\draw[<->] (fun.west) to[out=180,in=180] (hal.west);
\draw[<->] (hal) -- (drv);
\draw[<->] (drv) -- (webots);
\end{tikzpicture}
\caption{Schichtenmodell der Simulationssoftware. Die Funktionskomponenten
greifen über \texttt{RobotHAL} auf Sensoren und Aktoren zu.}
\label{fig:schichten}
\end{figure}

\subsection{Abbildung auf die Pflichtenheft-Architektur}\label{abbildung-pflichtenheft}

Tabelle~\ref{tab:mapping-arch} ordnet die
Architekturebenen und Funktionskomponenten aus dem Pflichtenheft den
Quelldateien des Simulationscontrollers zu.

\begin{longtable}[]{@{}
  >{\raggedright\arraybackslash}p{0.30\textwidth}
  >{\raggedright\arraybackslash}p{0.38\textwidth}
  >{\raggedright\arraybackslash}p{0.22\textwidth}@{}}
\caption{Zuordnung Pflichtenheft-Architektur $\rightarrow$ Umsetzung.}
\label{tab:mapping-arch}\\
\toprule
\textbf{Pflichtenheft} & \textbf{Umsetzung (Datei / Klasse)} & \textbf{Anforderung}\\
\midrule
\endfirsthead
\toprule
\textbf{Pflichtenheft} & \textbf{Umsetzung (Datei / Klasse)} & \textbf{Anforderung}\\
\midrule
\endhead
\bottomrule
\endfoot
Hardware\-treiber\-ebene & \texttt{webots\_hal.cpp} (Geräte-Handles) & keine\\
Hardware\-abstraktions\-ebene & \texttt{robot\_hal.h} (\texttt{RobotHAL}), \texttt{webots\_hal} (\texttt{WebotsHAL}) & NFA-ARC-005\\
Systemdienste / Umgebungs\-modell & \texttt{occupancy\_grid} (\texttt{OccupancyGrid}) & SIM-004\\
Navigations\-komponente & \texttt{astar} (A*), \texttt{dstar\_lite} (D* Lite) & NAV-005/008/009\\
Lokalisierungs\-komponente & \texttt{pose\_estimator} (\texttt{PoseEstimator}) & NAV-006, NAV-007\\
Bewegungs\-steuerung & \texttt{dwa\_planner} (\texttt{DwaPlanner::driveVW}), \texttt{robot\_hal.h} & HW-ACT-002/003, SAF-004\\
Sicherheits\-komponente / Sicherheits\-logik & \texttt{safety\_monitor} (\texttt{SafetyMonitor}) & NAV-003/004, SAF-001..005\\
Systemüberwachung & Konsolenprotokoll je Betriebsart in \texttt{main.cpp} & MON-001..005\\
Anwendungsebene & \texttt{main.cpp} (\texttt{MODE}, Szenarien, Hauptschleifen) & keine\\
Simulationsebene & \texttt{worlds/*.wbt}, \texttt{Coasterbot.proto} & NFA-SIM-001..005\\
Reaktive Verhaltenslogik (Bring-up) & \texttt{robot\_logic} (\texttt{RobotLogic}) & NAV-001/002, SAF-003\\
\end{longtable}

\subsection{Datenfluss im kombinierten Betrieb}\label{datenfluss}

Abbildung~\ref{fig:datenfluss} zeigt den Datenfluss der Betriebsart
\texttt{MODE\_SIM\_TEST}, in der die Komponenten
zusammenwirken (Grundlage der Testfälle \texttt{ST-SIM-001} bis
\texttt{ST-SIM-004}).

\begin{figure}[H]
\centering
\resizebox{\textwidth}{!}{%
\begin{tikzpicture}[font=\footnotesize, >=latex, x=1cm, y=1cm,
  box/.style={draw, rounded corners=1pt, align=center, minimum height=9mm,
              inner sep=3pt, fill=blue!4},
  sens/.style={draw, rounded corners=1pt, align=center, minimum height=9mm,
               inner sep=3pt, fill=black!4},
  safe/.style={draw, rounded corners=1pt, align=center, minimum height=9mm,
               inner sep=3pt, fill=red!6}]

% obere Zeile: Lokalisierung
\node[sens] (enc)  at (0,0)   {Encoder\\+ Gyro};
\node[box]  (pose) at (6.6,0) {\texttt{PoseEstimator} $(x,y,\theta)$};

% Mittelzeile: Planungs-Pipeline
\node[sens] (us)    at (0,-1.8)    {Ultraschall};
\node[box]  (grid)  at (2.7,-1.8)  {\texttt{OccupancyGrid}\\+ Distanzfeld};
\node[box]  (dstar) at (6.2,-1.8)  {\texttt{DStarLite}};
\node[box]  (smooth)at (9.3,-1.8)  {\texttt{smoothPath}\\\texttt{centerPath}};
\node[box]  (dwa)   at (12.6,-1.8) {\texttt{DwaPlanner}\\$(v,\omega)$};

% untere Zeile: Sicherheit + Aktorik
\node[sens] (edge)   at (0,-3.6)   {Kantensensoren};
\node[safe] (safety) at (2.9,-3.6) {\texttt{SafetyMonitor}};
\node[box]  (mot)    at (12.6,-3.6){\texttt{RobotHAL} $\rightarrow$ Aktorik};

\draw[->] (enc)   -- (pose);
\draw[->] (us)    -- (grid);
\draw[->] (grid)  -- (dstar);
\draw[->] (dstar) -- (smooth);
\draw[->] (smooth)-- (dwa);
\draw[->] (pose.south) to[out=-90,in=90] (dstar.north);
\draw[->] (pose.north) to[out=90,in=90] (dwa.north);
\draw[->] (dwa)   -- (mot);
\draw[->] (edge)  -- (safety);
\draw[->] (safety.east) |- node[pos=0.75,below]{Vorrang} (mot);
\end{tikzpicture}}
\caption{Datenfluss in \texttt{MODE\_SIM\_TEST}. Die Sicherheitskomponente
wird in jedem Regelzyklus \emph{vor} der Navigation ausgewertet und
übernimmt bei einem Kantenereignis die Aktorik.}
\label{fig:datenfluss}
\end{figure}

Ablauf eines Regelzyklus:

\begin{enumerate}
\tightlist
\item
  \texttt{hal.step()}: Simulationsschritt, neue Sensorwerte.
\item
  \texttt{pose.update()}: Pose aus Radwinkeln und Gyro fortschreiben.
\item
  \texttt{safety.update()}: Kantensensoren prüfen. Beinhaltet die
  Sicherheitskomponente der Aktorik, letzte Funktion im Regelzyklus.
\item
  Kartenpflege: Ein per Sensor erkanntes, unkartiertes Hindernis
  bzw.\ eine erkannte Kante wird in die Belegungskarte eingetragen und
  \texttt{der DStarLite} Algorithmus erneuert.
\item
  \texttt{planner.setStart()} / \texttt{computeShortestPath()}: Pfad
  inkrementell aktualisieren.
\item
  \texttt{smoothPath()} + \texttt{centerPath()}: Pfad glätten und die
  Korridor erneuern.
\item
  \texttt{dwa.update()}: kollisionsfreies Geschwindigkeitspaar wählen
  und als Radgeschwindigkeiten ausgeben.
\end{enumerate}

% =====================================================================
\section{Laufzeitumgebung und Projektstruktur}\label{laufzeitumgebung}
% =====================================================================

\subsection{Werkzeuge}\label{werkzeuge}

\begin{longtable}[]{@{}p{0.28\textwidth}p{0.66\textwidth}@{}}
\toprule
\textbf{Element} & \textbf{Beschreibung}\\
\midrule
\endhead
Simulator & Webots R2025b (Nightly-Build, Commit \texttt{033dbaea\ldots})\\
Sprache & C++ (objektorientiert, eine Klasse je Komponente)\\
Build & Webots-\texttt{Makefile.include}, je Controller ein \texttt{Makefile}\\
Robotermodell & \texttt{protos/coasterbot/Coasterbot.proto} (aus CAD abgeleitet)\\
Controller & \texttt{controllers/coasterbot/} (Quellcode)\\
\bottomrule
\end{longtable}

Übersetzen und Ausführen:

\begin{lstlisting}[style=cpp, language=bash]
export WEBOTS_HOME=~/Documents/webots/webots

# nur den Controller bauen
cd controllers/coasterbot && make

# eine Welt starten (GUI)
$\$WEBOTS_HOME/webots worlds/coasterbot-simtest.wbt

# headless start
$WEBOTS_HOME/webots --mode=fast --no-rendering --stdout --stderr \
    worlds/coasterbot-simtest.wbt
\end{lstlisting}

\subsection{Quelldateien}\label{quelldateien}

\begin{longtable}[]{@{}
  >{\raggedright\arraybackslash}p{0.30\textwidth}
  >{\raggedright\arraybackslash}p{0.62\textwidth}@{}}
\caption{Dateien des Controllers \texttt{coasterbot}.}\label{tab:dateien}\\
\toprule
\textbf{Datei} & \textbf{Inhalt}\\
\midrule
\endfirsthead
\toprule
\textbf{Datei} & \textbf{Inhalt}\\
\midrule
\endhead
\bottomrule
\endfoot
\texttt{robot\_hal.h} & abstraktes Interface \texttt{RobotHAL}, \texttt{enum WheelId}\\
\texttt{webots\_hal.\{h,cpp\}} & \texttt{WebotsHAL : RobotHAL}, einzige von Webots-abhängige Datei\\
\texttt{pose\_estimator.\{h,cpp\}} & \texttt{PoseEstimator}, Odometrie- und Gyro-Fusion\\
\texttt{occupancy\_grid.\{h,cpp\}} & \texttt{OccupancyGrid}, Rasterkarte mit Distanzfeld\\
\texttt{astar.\{h,cpp\}} & \texttt{astarPlan}, \texttt{smoothPath}, \texttt{centerPath}\\
\texttt{dstar\_lite.\{h,cpp\}} & \texttt{DStarLite}, inkrementeller Neuplaner\\
\texttt{dwa\_planner.\{h,cpp\}} & \texttt{DwaPlanner}, lokale Planung und Bewegungssteuerung\\
\texttt{safety\_monitor.\{h,cpp\}} & \texttt{SafetyMonitor}, Sicherheitskomponente\\
\texttt{robot\_logic.\{h,cpp\}} & \texttt{RobotLogic}, reaktiver Zustandsautomat\\
\texttt{main.cpp} & Betriebsarten, Szenarien, Hauptschleifen\\
\texttt{Makefile} & Liste der zu übersetzenden Quelldateien\\
\bottomrule
\end{longtable}

% =====================================================================
\section{Hardwareabstraktion}\label{hardwareabstraktion}
% =====================================================================

\subsection{Interface \texttt{RobotHAL}}\label{robothal}

\texttt{RobotHAL} (Datei \texttt{robot\_hal.h}) ist eine abstrakte
Klasse. Diese beschreibt  \emph{welche} Fähigkeiten der
Roboter besitzt, jedoch nicht wie sie technisch realisiert werden. Die Klasse
erfüllt \texttt{NFA-ARC-004} (eindeutig definierte Schnittstellen) und
\texttt{NFA-ARC-005} (Hardwareabstraktion).

\begin{longtable}[]{@{}p{0.40\textwidth}p{0.54\textwidth}@{}}
\caption{Methoden von \texttt{RobotHAL}.}\label{tab:hal}\\
\toprule
\textbf{Methode} & \textbf{Bedeutung / Einheit}\\
\midrule
\endfirsthead
\toprule
\textbf{Methode} & \textbf{Bedeutung / Einheit}\\
\midrule
\endhead
\bottomrule
\endfoot
\texttt{bool step()} & ein Regelzyklus; \texttt{false} = Simulation beendet\\
\texttt{void setLeftSpeed(float)} & Sollgeschwindigkeit linke Seite [rad/s], positiv = vorwärts\\
\texttt{void setRightSpeed(float)} & Sollgeschwindigkeit rechte Seite [rad/s]\\
\texttt{float getUltrasonicDistance()} & Abstand nach vorn [m], kleiner = näher\\
\texttt{bool getEdgeFrontLeft()} \ldots & vier Kantensensoren; \texttt{true} = \enquote{kein Boden} (Kante), bereits kalibriert\\
\texttt{float getYaw()} & Gierwinkel um die Hochachse [rad]\\
\texttt{float getGyroZ()} & Giergeschwindigkeit um die Hochachse [rad/s]\\
\texttt{float getWheelAngle(WheelId)} & akkumulierter Radwinkel EINER SEITE [rad], positiv = vorwärts\\
\texttt{float getTime()} & Laufzeit seit Programmstart [s]\\
\bottomrule
\end{longtable}

\paragraph{Konventionen.}
\begin{itemize}
\tightlist
\item
  \textbf{Voraussetzung:} \texttt{setLeftSpeed}/\texttt{setRightSpeed}
  positiv $\Rightarrow$ Vorwärtsfahrt. Lenkung über die Drehzahl\-differenz
  (Skid-Steer).
\item
  \textbf{Radpaarung:} Die beiden Räder einer Seite sind mechanisch
  gekoppelt und laufen stets gemeinsam (wie der reale Coasterbot: zwei
  Getriebemotoren je Seite, gemeinsam angesteuert). Es gibt daher
  \emph{keinen} Einzelrad-Befehl, \texttt{enum WheelId} hat deshalb
  nur die beiden Werte \texttt{WHEEL\_LEFT}/\texttt{WHEEL\_RIGHT}.
  Die reale Elektronik besitzt ebenfalls nur einen Encoder je Seite, nicht
  einen je Rad.
\item
  \textbf{Kantensensoren:} \texttt{RobotHAL} gibt bereits ein kalibriertes
  \texttt{bool} zurück (\texttt{true} = Tischkante erreicht). Die Umrechnung des
  Rohwerts (in der Simulation $\approx 0$ auf einer Fläche, $\approx 1000$
  über einer Kante; Schwelle \num{500}) ist Aufgabe der jeweiligen
  HAL-Implementierung und bleibt in dieser gekapselt.
\end{itemize}

\subsection{Implementierung \texttt{WebotsHAL}}\label{webotshal}

\texttt{WebotsHAL} (Datei \texttt{webots\_hal.cpp}) ist die
Datei, welche die C++ API von Webots einbindet. Bei einer Portierung auf die
Zielhardware kann diese Datei durch einen \texttt{ArduinoHAL} mit
identischer Aufbau ersetzt werden, wobei die übrigen Komponenten
unverändert bleiben.

Aufgaben de HAL:

\begin{itemize}
\tightlist
\item
  Beschaffung der Geräte-Handles über die im PROTO vergebenen Namen: die
  gekoppelten Motoren \texttt{wheel\_left::front} und
  \texttt{wheel\_right::front}, die vier PositionSensor
  \texttt{wheel\_*\_sensor} (je zwei pro Seite, siehe unten), der
  Ultraschall \texttt{ultrasonic}, die vier Kantensensoren \texttt{edge\_*},
  sowie \texttt{inertial\_unit} und \texttt{gyro}. Die Namensstrings sind
  der Kopplung zwischen PROTO und Software.
\item
  Betrieb der Antriebsmotoren über die Funktion
  (\texttt{setPosition(\ensuremath{\infty})}).
\item
  \textbf{Vorzeichenkorrektur:} Das Radmodell des PROTO rollt den
  Roboter bei positiver Motordrehzahl nach $+Z$ (Rückseite). Da die
  die Vorderseite bei $-Z$ liegt, negiert \texttt{WebotsHAL} die Motor- und
  Encoder-Werte.
\item
  \textbf{Gierrate:} Das Y-up-PROTO wird in der Z-up-Welt mit
  \texttt{rotation 1 0 0 1.5708} aufgestellt. Die Welt-Hochachse fällt
  daher mit der lokalen $+Y$-Achse des Gyros zusammen. Die Funktion
    \texttt{getGyroZ()} liefert die $Y$-Komponente des Gyrovektors.
\item
  \textbf{Encoder-Aggregation:} Die reale Elektronik besitzt nur einen
  Encoder je Seite (\texttt{RobotHAL::WheelId} kennt deshalb nur
  \texttt{WHEEL\_LEFT}/\texttt{WHEEL\_RIGHT}). Das PROTO stellt in der
  Simulation trotzdem vier unabhängige \texttt{PositionSensor} bereit (je
  Rad). Die Funktion \texttt{getWheelAngle()} mittelt Front- und Heckrad je
  Seite, um nach außen dieselbe Information wie der einzelne reale Encoder zu
  liefern.
\item
  \textbf{Digitales Kantensignal:} Die \texttt{lookupTable} der vier
  Kantensensoren im PROTO liefert ein digitales Signal (\num{0}
  oder \num{1}, keinen analogen Rohwert, siehe
  Abschnitt~\ref{proto}). Die Funktion  \texttt{digitalEdge()} liest den Zustand und
  bildet ihn über die Konstante \texttt{EDGE\_ACTIVE\_HIGH} auf
  den  \texttt{bool} Wert ab. An dieser Stelle muss im Code
  bekannt sein, ob die \enquote{Kante} am Sensor ein elektronisches  HIGH
  oder LOW bedeutet. Die Funktion in \texttt{ArduinoHAL}, welche
  \texttt{digitalRead()} an einem Pin aufruft, passt bei einem
  aktiv-low-Sensormodul nur diese eine Konstante an.
\item
  \textbf{Gyro-Simulation (GY-521/MPU-6050):} \texttt{getGyroZ()} stellt
  den idealen, physikalisch simulierten Wert Bias und das Rauschen des auf
  der Stückliste genannten Inertialsensors auf und kalibriert diesen
  Bias beim Start heraus. Details in Abschnitt~\ref{gyro-simulation}.
\item
  \textbf{Motorregelung Open-Loop/Closed-Loop:} \texttt{setLeftSpeed()}/
  \texttt{setRightSpeed()} setzen lediglich den Zustand.
  \texttt{updateMotorControl()} steuert die Motoren davon abhängig entweder
  direkt (Open-Loop) oder per Encoder-Rückkopplung geregelt (Closed-Loop,
  Standardeinstellung) an. Details und Vergleich in
  Abschnitt~\ref{motor-control-vergleich}.
\end{itemize}

Die gekoppelten Motoren (coupled motors) von Webots setzen einen Befehl an
\texttt{wheel\_left::front}  auch auf
\texttt{wheel\_left::rear} um (Faktor \texttt{multiplier} $= 1$), sodass
die Software je Seite nur ein Handle benötigt.

\subsection{Gyro-Simulation: GY-521/MPU-6050}\label{gyro-simulation}

Die Stückliste (BOM) des Projekts führt unter Position 11 einen
Inertialsensor: \enquote{ICQUANZX GY-521 MPU6050; Navigationssensor}
(1~Stk., U12), ein GY-521-Breakout-Board mit dem
InvenSense-MPU-6050-Chip (6-DOF Gyroskop und Beschleunigungssensor). Diese
Festlegung gilt als gegeben für die reale Hardware. Deshalb bildet die Simulation
diesen Chip nach, statt einen idealen, fehlerfreien Sensor anzunehmen.

\paragraph{Warum nicht über die PROTO-\texttt{lookupTable}.}
Für die vier Kantensensoren und den Ultraschall genügt Webots eingebauter
\texttt{lookupTable}-Mechanismus (Abschnitt~\ref{proto}). Für den Gyro
wurde dieser Weg geprüft und verworfen: Der dortige Rauschanteil skaliert
mit dem Momentanwert der Messung und ist bei Stillstand (Messwert $= 0$)
daher immer exakt null, ein realer Gyro rauscht aber auch im Stillstand
messbar (Datenblattgröße \enquote{Total RMS Noise}). Dieses Verhalten
wurde am simulierten Sensor überprüft (Roboter stationär: Rauschen exakt
\num{0}; Roboter drehend: Rauschen proportional zum Momentanwert), bevor
die Simulation stattdessen software-seitig in \texttt{WebotsHAL} realisiert
wurde. Die PROTO-\texttt{lookupTable} des Gyros bildet deshalb nur noch
Messbereich und Auflösung ab (siehe Abschnitt~\ref{proto}); Bias und
Rauschen kommen aus \texttt{WebotsHAL::getGyroZ()}.

\paragraph{Simulierte Fehlerquellen.} Alle Werte sind über das
MPU-6050-Datenblatt begründet (Werksdefault \texttt{FS\_SEL} $=0$, also
$\pm\SI{250}{\degree\per\second}$ Messbereich, 16-Bit-ADC):

\begin{itemize}
\tightlist
\item
  \textbf{Nullpunktfehler (Zero-Rate Output):} Das Datenblatt nennt bis zu
  $\pm\SI{20}{\degree\per\second}$ Werkstoleranz ohne Kalibrierung. Da kein
  vermessenes reales Exemplar vorliegt, wird ein moderater, fest
  angenommener Demonstrationswert von \SI{3}{\degree\per\second}
  ($\approx\SI{0.0524}{\radian\per\second}$) simuliert. Dieser Wert ist
  eine Annahme und kein Messergebnis.
\item
  \textbf{Rauschen:} Datenblattwert \enquote{Total RMS Noise}
  $= \SI{0.05}{\degree\per\second\text{-}rms}$
  ($\approx\SI{0.000873}{\radian\per\second}$), als Standardabweichung
  eines Gauß-Rauschens mit festem statt zeitbasiertem Seed
  (\texttt{std::mt19937}, Seed~12345), damit
  \texttt{ST-SIM-004} reproduzierbar bleibt (siehe unten).
\item
  \textbf{Messbereich und Auflösung:} in der PROTO-\texttt{lookupTable}
  (Abschnitt~\ref{proto}): $\pm\SI{4.363323}{\radian\per\second}$
  ($=\pm\SI{250}{\degree\per\second}$), Auflösung
  \SI{0.00013316}{\radian\per\second} (16-Bit-ADC-Schrittweite).
\end{itemize}

\paragraph{Start-Kalibrierung.} Ein reales MPU-6050-Modul wird üblicherweise
beim Einschalten kalibriert, während das Gerät stillsteht. \texttt{WebotsHAL}
bildet das nach:
\texttt{calibrateGyro()} läuft im Konstruktor, \emph{bevor} ein
Fahrbefehl gegeben werden kann (die Motoren stehen zu diesem Zeitpunkt
bereits auf \texttt{setVelocity(0.0)}), mittelt \texttt{GYRO\_CAL\_SAMPLES}
$= 32$ Messwerte (bei \SI{16}{\milli\second} Regelzyklus $\approx
\SI{0.5}{\second}$) und zieht diesen Schätzwert von jeder folgenden
Messung ab.

Diese Reihenfolge ist notwendig: Ein früherer
Entwurf kalibrierte laufend während der ersten
\texttt{getGyroZ()}-Aufrufe im laufenden Betrieb. In
\texttt{MODE\_SIM\_TEST} beginnt die Navigation jedoch bereits im ersten
Regelzyklus zu drehen. Die echte, sich ändernde Drehung floss dabei
fälschlich in den Bias-Schätzwert ein und verfälschte ihn dauerhaft.
Dies führte dazu, dass der Roboter in einer falschen Pose hängen blieb
und keinen Testfall bestand. Die Kalibrierung \emph{vor} dem ersten
möglichen Fahrbefehl behebt diesen Fehler. Sie entspricht zugleich eher dem
realen Vorbild (Kalibrierung beim Einschalten, nicht während der Fahrt).

\paragraph{Folge für die Lokalisierung.} Weil nur \texttt{GYRO\_CAL\_SAMPLES}
$= 32$ Messwerte gemittelt werden, bleibt ein Restfehler im
Bias-Schätzwert zurück (Größenordnung
$\sigma_\mathrm{Rauschen} / \sqrt{32} \approx \SI{1.5e-4}{\radian\per\second}$).
Da dieser Restfehler danach fest bleibt statt weiter nachgeführt zu
werden, integriert \texttt{PoseEstimator} ihn über die Zeit zu einem
langsamen Kursdrift auf, auch wenn der Roboter steht: gemessen
$\approx \SI{-0.012}{\degree\per\second}$ (Stillstandstest über
\SI{220}{\second}, \texttt{MODE\_ODOMETRY\_TEST}). Für die kurzen
Testläufe dieses Projekts (\SI{15}{} bis \SI{25}{\second}) ist das
vernachlässigbar (siehe Abschnitt~\ref{lokalisierung-grenzen}).

\paragraph{Verifikation.} Nach dieser Änderung erneut gegen
ST-SIM-001 bis ST-SIM-004 sowie \texttt{MODE\_NAVIGATE\_DSTAR} geprüft:
weiterhin BESTANDEN bzw.\ korrektes Reroute, byte-identisch über zwei
Läufe, Ziel- und Zeitwerte nur im Rahmen weniger Zehntelsekunden bzw.\
Millimeter verschoben. Bias und Rauschen bleiben also klein genug, um das
bestehende Verhalten nicht zu verändern, machen die Simulation aber
realitätsnäher.

\subsection{Motorregelung: Open-Loop vs.\ Closed-Loop im
Vergleich}\label{motor-control-vergleich}

Dieser Abschnitt setzt den in Abschnitt~\ref{webotshal} bereits
angekündigten Vergleich um: Beide Umsetzungen der Motoransteuerung (Open-Loop,
Closed-Loop) wurden implementiert und im selben Simulationslauf gegenübergestellt.

\paragraph{Warum ein reiner Vergleich in der Simulation nicht trivial ist.}
Das Motormodell im Geschwindigkeitsmodus (\texttt{Motor::setVelocity()})
wird in Webots \emph{ideal simuliert}: Ein Kommando wird ohne Regelfehler exakt erreicht.
Ohne eine zusätzliche, eingebaute
Störgröße liefern Open-Loop und Closed-Loop deshalb in der Simulation exakt
dasselbe Ergebnis und der Vergleich ist hinfällig.
\texttt{WebotsHAL} prägt deshalb dem Kommando eine feste, \emph{der
Regelung unbekannte} Fertigungsstreuung zwischen den beiden Seiten auf
(\texttt{MOTOR\_GAIN\_LEFT\_TRUE} $= 0{,}95$, \texttt{MOTOR\_GAIN\_RIGHT\_TRUE}
$= 1{,}05$, also $\mp\SI{5}{\percent}$): Ein Kommando von
\SI{4}{\radian\per\second} führt an der realen (simulierten) Achse nicht zu
exakt \SI{4}{\radian\per\second}, sondern zu $4 \cdot \text{Gain}$. Diese
Werte sind eine Annahme (realistische Größenordnung für
Getriebemotor-Toleranzen), kein Messwert eines realen Coasterbot-Exemplares.

\paragraph{Umsetzung in \texttt{WebotsHAL}.} \texttt{setLeftSpeed()}/
\texttt{setRightSpeed()} setzen deshalb lediglich das \emph{Kommando}
(\texttt{commandedLeft\_}/\texttt{commandedRight\_}), wobei die eigentliche
Aktuierung von \texttt{updateMotorControl()} übernommen wird. Dies geschieht einmal mit
dem zuletzt gemessenen Encoderwert pro \texttt{step()}:

\begin{itemize}
\tightlist
\item
  \textbf{Gemessene Geschwindigkeit:} \texttt{measuredLeft\_}/
  \texttt{measuredRight\_} aus der Änderung des jeweiligen
  Encoderwinkels (\texttt{RobotHAL::getWheelAngle}) seit dem letzten
  Regelzyklus, geteilt durch $\Delta t$. Über
  \texttt{measuredLeftSpeed()}/\texttt{measuredRightSpeed()} ist sie auch von
  außen abrufbar (nur für diesen Vergleich und kein Bestandeil der
  \texttt{RobotHAL}-Schnittstelle).
\item
  \textbf{OPEN\_LOOP:} \texttt{appliedLeft\_}/\texttt{appliedRight\_}
  (der tatsächlich an \texttt{Motor::setVelocity()} übergebene Wert)
  entsprechen unverändert dem Kommando. Der Gain-Fehler bleibt bestehen.
\item
  \textbf{CLOSED\_LOOP (Standardeinstellung):} \texttt{appliedLeft\_}/
  \texttt{appliedRight\_} werden jeden Regelzyklus per Integralregler
  nachgeführt,
  \[
  \text{applied} \mathrel{+}= K_I \cdot (\text{commanded} - \text{measured}) \cdot \Delta t,
  \qquad K_I = 25,
  \]
  begrenzt auf $\pm\SI{20}{\radian\per\second}$ (Anti-Windup, entspricht
  der PROTO-\texttt{maxVelocity}). Die Regelung kennt den Gain-Fehler
  nicht, gleicht ihn aber allein über die Rückkopplung aus.
\end{itemize}

\texttt{CLOSED\_LOOP} ist die \textbf{Standardeinstellung}, damit
die anderen Betriebsarten (\texttt{MODE\_SIM\_TEST},
\texttt{MODE\_NAVIGATE\_DSTAR}, \ldots) ihr bereits verifiziertes Verhalten
beibehalten. Nur die neue Betriebsart \texttt{MODE\_MOTOR\_CONTROL\_TEST}
schaltet bewusst auf \texttt{OPEN\_LOOP} um, um den Unterschied zu zeigen.

\paragraph{Vergleichstest \texttt{MODE\_MOTOR\_CONTROL\_TEST}.} Auf der
offenen Fläche \linebreak (\texttt{coasterbot-testfield.wbt}) kommandiert der Test
beiden Seiten denselben Geradeausbefehl ($\SI{4}{\radian\per\second}$),
zunächst \SI{8}{\second} lang Open-Loop, danach \SI{8}{\second} lang
Closed-Loop (derselbe Lauf, kein Zurücksetzen der Position nötig: Kursdrift
und Geschwindigkeitsfehler werden je Phase relativ zum Phasenanfang
gemessen). Bei identischem Kommando auf beiden Seiten sollte der Roboter
nicht abdriften.

Verifiziertes Ergebnis eines simulierten Testlaufs:

\begin{longtable}[]{@{}p{0.30\textwidth}p{0.30\textwidth}p{0.30\textwidth}@{}}
\toprule
\textbf{Messgröße} & \textbf{Open-Loop} & \textbf{Closed-Loop}\\
\midrule
\endhead
\bottomrule
\endfoot
Kursdrift über \SI{8}{\second} & \SI{24.9}{\degree} & \SI{0.05}{\degree}\\
Geschwindigkeitsfehler links (Phasenende) & \SI{0.20}{\radian\per\second} & $<\SI{0.001}{\radian\per\second}$\\
Geschwindigkeitsfehler rechts (Phasenende) & \SI{-0.20}{\radian\per\second} & $\approx \SI{0}{}$\\
\end{longtable}

Der gemessene Geschwindigkeitsfehler im Open-Loop-Fall
($\approx \pm\SI{5}{\percent}$ von \SI{4}{\radian\per\second}) entspricht
exakt dem eingeprägten Gain-Fehler. Die Closed-Loop-Regelung
konvergiert innerhalb weniger Regelzyklen (deutlich unter \SI{1}{\second})
auf den Sollwert und hält den Kursdrift auf einer Größenordnung, welcher auch
ohne jeden Gain-Fehler allein durch das Restrauschen des simulierten Gyros
(Abschnitt~\ref{gyro-simulation}) zu erwarten ist.

\paragraph{Verifikation der Rückwärtskompatibilität.} Da
\texttt{CLOSED\_LOOP} nun in \emph{allen} Betriebsarten aktiv ist (vorher
war die Motoransteuerung effektiv ideal), wurde die bestehende Testreihe
erneut geprüft: \texttt{MODE\_SIM\_TEST} bleibt ST-SIM-001 bis ST-SIM-004
BESTANDEN, \texttt{MODE\_NAVIGATE\_DSTAR} reroutet weiterhin korrekt, in
beiden Fällen nur geringfügig andere Zeit-/Wegpunkte als in
Abschnitt~\ref{gyro-simulation} (der Integralregler führt eine kurze,
aber echte Regeldynamik ein, wo zuvor eine ideale Momentanantwort stand).
Alle Erfolgskriterien bleiben unverändert erfüllt.

% =====================================================================
\section{Lokalisierungskomponente}\label{lokalisierung}
% =====================================================================

Die Lokalisierung (\texttt{PoseEstimator}, Dateien:
\texttt{pose\_estimator.\{h,cpp\}}) bestimmt fortlaufend die Pose des
Roboters in der Tischebene und erfüllt \texttt{NAV-006}
(Positionsbestimmung) und \texttt{NAV-007} (Orientierungsbestimmung).

\subsection{Prinzip}\label{lokalisierung-prinzip}

Der Coasterbot \emph{misst} seine Position nicht, sondern \textbf{führt
sie durch Koppelnavigation (Dead Reckoning) fort}. Es gibt keine externe
Referenz: kein GPS, Bake, oder kamerabasierte Lokalisierung.
Die Pose entsteht in vier Schritten:

\begin{enumerate}
\tightlist
\item
  \textbf{Bekannte Startpose.} \texttt{main.cpp} setzt den Schätzer über
  \texttt{pose.reset(x,\,y,\,\ensuremath{\theta})} auf die im
  Szenario/in der Welt definierte Startposition. Alles Weitere ist
  relativ zu diesem Punkt.
\item
  \textbf{Radodometrie.} In jedem Regelzyklus wird über
  \texttt{RobotHAL::getWheelAngle} je ein Encoderwert pro Seite gelesen
  (\texttt{WHEEL\_LEFT}/\texttt{WHEEL\_RIGHT}, die reale Elektronik hat
  nur einen Encoder je Seite) und mit dem Radradius in eine gefahrene
  Strecke umgerechnet.
\item
  \textbf{Kursfusion.} Die Kursänderung wird aus der Radodometrie
  \emph{und} der integrierten Gyro-Giergeschwindigkeit über einen
  Komplementärfilter bestimmt. Der Gyro wird dabei vorrangig behandelt.
\item
  \textbf{Integration.} Strecke und Kurs werden zur neuen Pose
  $(x, y, \theta)$ aufsummiert.
\end{enumerate}

\subsection{Verfahren}\label{lokalisierung-verfahren}

Verwendet wird eine \textbf{Skid-Steer-Odometrie} aus den zwei
seitenweisen Radwinkeln, deren Kurs mit der integrierten
Gyro-Giergeschwindigkeit über einen \textbf{Komplementärfilter}
fusioniert wird. Die
Alternativenbeschreibung nennt hierfür grundsätzlich EKF/UKF\@. Für den
Prototyp, der auf einer Tischfläche steht und mit nur zwei Sensorquellen ausgestattet
ist, genügt ein wesentlich einfacherer Komplementärfilter. Dieser kommt ohne
Kovarianzschätzung und ist deterministisch (wichtig für
\texttt{ST-SIM-004}).

Aus dem jeweiligen Encoderwert folgt die gefahrene Strecke einer Seite
(in der Simulation mittelt \texttt{WebotsHAL} dafür intern die zwei
PositionSensor von Front- und Heckrad derselben Seite, um dieselbe
Information wie der einzelne reale Encoder je Seite nachzubilden):
\[
\Delta s_L = \big(\varphi_L - \varphi_{L,\mathrm{prev}}\big)\,r,
\qquad
\Delta s_R = \big(\varphi_R - \varphi_{R,\mathrm{prev}}\big)\,r
\]
mit Radradius $r = \SI{0.035}{\meter}$. Daraus folgen der
Vorschub des Zentrums und die odometrische Kursänderung:
\[
\Delta s = \tfrac{1}{2}\big(\Delta s_L + \Delta s_R\big),
\qquad
\Delta\theta_\mathrm{odo} = \frac{\Delta s_R - \Delta s_L}{b},
\qquad b = \SI{0.202}{\meter}\ \text{(Spurweite)}.
\]
Die fusionierte Kursänderung gewichtet Odometrie und Gyro:
\[
\Delta\theta = w\,\Delta\theta_\mathrm{odo}
             + (1-w)\,\dot\psi_\mathrm{gyro}\,\Delta t,
\qquad w = 0{,}05 .
\]
Da Skid-Steer beim Drehen stark schlupft, wird überwiegend dem Gyro
vertraut ($w = 0{,}05$). \texttt{getGyroZ()} liefert dabei die
$Y$-Komponente des Gyrovektors: Das Y-up-PROTO wird in der Z-up-Welt mit
\texttt{rotation 1 0 0 1.5708} aufgestellt, wodurch die lokale
$+Y$-Achse mit der Welt-Hochachse der Simulation identisch ist.

Die Integration erfolgt über den mittleren Kurs des Schritts
(Runge-Kutta 2.\,Ordnung):
\[
x \mathrel{+}= \Delta s\,\cos\!\big(\theta + \tfrac{1}{2}\Delta\theta\big),
\quad
y \mathrel{+}= \Delta s\,\sin\!\big(\theta + \tfrac{1}{2}\Delta\theta\big),
\quad
\theta \mathrel{+}= \Delta\theta .
\]

\subsection{Schnittstelle}\label{lokalisierung-schnittstelle}

\begin{longtable}[]{@{}p{0.38\textwidth}p{0.56\textwidth}@{}}
\toprule
\textbf{Methode} & \textbf{Bedeutung}\\
\midrule
\endhead
\texttt{void update()} & einmal pro Regelzyklus nach \texttt{hal.step()}\\
\texttt{float getX() / getY()} & Position [m]\\
\texttt{float getTheta()} & Kurs [rad], $(-\pi,\pi]$\\
\texttt{float getOdometer()} & gesamte gefahrene Strecke [m]\\
\texttt{void reset(x,y,\ensuremath{\theta})} & Pose auf bekannten Startwert der Welt setzen\\
\bottomrule
\end{longtable}

Koordinatenkonvention: $x$ nach vorn (Startausrichtung), $y$ nach links,
$\theta$ positiv gegen den Uhrzeigersinn. Der absolute Gierwinkel der
InertialUnit (\texttt{getYaw()}) wird im Schätzer bewusst \emph{nicht}
verwendet, da die $90\degree$-Aufstellrotation die IMU nahe den
Gimbal-Lock in der Nickachse bringt.

\subsection{Grenzen der Lokalisierung}\label{lokalisierung-grenzen}

\begin{itemize}
\tightlist
\item
  \textbf{Driftakkumulation.} Reine Koppelnavigation summiert
  Messfehler auf. Ohne absolute Korrektur oder Schleifenschluss (loop
  closure) wächst der Positionsfehler mit der gefahrenen Strecke. Für
  die kleine Tischfläche und die kurzen Fahrten der Simulationstests ist
  das ausreichend.
\item
  \textbf{Manuelles Umsetzen.} Wird der Roboter physisch angehoben und
  versetzt, ist die Schätzung falsch, bis \texttt{reset()}
  erneut eine bekannte Pose vorgibt, entsprechend der Einschränkung in
  \texttt{NAV-006} (\enquote{solange er nicht manuell umgesetzt wurde}).
\item
  \textbf{Verifikation.} \texttt{MODE\_ODOMETRY\_TEST} auf
  \texttt{coasterbot-testfield.wbt}: Geradeausfahrt \SI{0.699}{\meter}
  gegenüber \SI{0.70}{\meter} Soll, kein seitlicher Versatz,
  Drehung auf der Stelle wird vom Gyro sauber verfolgt. Im Stillstand
  bleibt die Pose nahezu stabil, mit dem seit Abschnitt~\ref{gyro-simulation}
  simulierten Gyro-Restfehler driftet der Kurs im Stillstand um
  $\approx \SI{0.012}{\degree\per\second}$. Dies ist für die kurzen Testläufe
  dieses Projekts vernachlässigbar.
\end{itemize}

% =====================================================================
\section{Umgebungsmodell}\label{umgebungsmodell}
% =====================================================================

\texttt{OccupancyGrid} (Dateien \texttt{occupancy\_grid.\{h,cpp\}})
entspricht der im Pflichtenheft genannten \enquote{bekannten Tischkarte}
und ist die gemeinsame Eingabe für A*, D* Lite und DWA\@. Es setzt
\texttt{SIM-004} um (Hindernisse in der Simulation berücksichtigen).

\subsection{Aufbau}\label{grid-aufbau}

\begin{itemize}
\tightlist
\item
  Achsenparalleles Rechteck in \textbf{Weltkoordinaten} (X-Y-Ebene der
  Webots-Welt, $Z$ = oben) mit fester Auflösung (Standard
  \SI{0.05}{\meter}). Es liegt in derselben Ebene wie die Pose.
\item
  In den Simulationsszenarien ist das Gitter auf die Tischfläche
  begrenzt, damit geplante Wege die Tischkante nicht überschreiten können.
\item
  Zellen sind \emph{frei} oder \emph{belegt}. Zellen außerhalb der Karte
  gelten als belegt.
\end{itemize}

\subsection{Funktionen}\label{grid-funktionen}

\begin{longtable}[]{@{}p{0.42\textwidth}p{0.52\textwidth}@{}}
\toprule
\textbf{Funktion} & \textbf{Wirkung}\\
\midrule
\endhead
\texttt{addObstacleRect(\ldots,\,infl)} & Rechteck-Hindernis, um \texttt{infl} Meter einzutragen (Roboter-Halbbreite $\Rightarrow$ Punktroboter-Planung, erfüllt \texttt{NAV-010})\\
\texttt{setOccupied(Cell,bool)} & einzelne Zelle mit (hartem) Wert setzen. Rückgabe \texttt{true} bei Änderung (für inkrementelle Neuplanung)\\
\texttt{reportOccupied(Cell,\allowbreak smoothingFactor)} & einzelne Zelle GEGLÄTTET melden (Abschnitt~\ref{grid-glaettung})\\
\texttt{buildDistanceField()} & Chamfer-Distanzfeld über zwei Rasterdurchläufe berechnen\\
\texttt{clearance(Vec2)} & Abstand eines Weltpunkts zum nächsten Hindernis [m]\\
\texttt{worldToCell / cellToWorld} & Umrechnung Welt $\leftrightarrow$ Zelle\\
\bottomrule
\end{longtable}

Das Distanzfeld wird nach jeder Hindernisänderung als veraltet markiert
und muss vor der nächsten \texttt{clearance()}-Abfrage neu gebaut
werden. In \texttt{MODE\_SIM\_TEST} und \texttt{MODE\_NAVIGATE\_DSTAR}
werden \emph{zwei} Gitter geführt: ein großzügiges aufgespanntes
Planer-Gitter (hält den Pfad von Ecken fern) und ein nur um den
Roboterradius aufgespanntes DWA-Gitter (Kollisionsbewertung). Beide
werden bei Sensortreffern gemeinsam aktualisiert.

\subsection{Geglättete Live-Hindernismeldung}\label{grid-glaettung}

\texttt{addObstacleRect()} trägt a priori bekannte Hindernisse fest und
sofort ein (z.\,B. die bekannte Bierflasche im Simulationstest). Dies ist
machbar, weil diese Eingabe nicht verrauscht ist. Ein \emph{live} erkanntes per
Kantensensor gemessenes Hindernis, während der Fahrt,
kann durch Rauschen oder eine kurze Fehlmessung verfälscht werden. Bis Version~5 dieses
Dokuments hätte bereits ein einzelner solcher Treffer die Karte sofort
verändert (\texttt{setOccupied(c, true)}) und damit eine D*-Lite-Umplanung
ausgelöst.

\texttt{reportOccupied(Cell, smoothingFactor)} glättet das: statt die
Zelle sofort zu belegen, wird eine Belegungs-\emph{Konfidenz}
$\mathrm{conf} \in [0,1]$ je Zelle exponentiell nachgeführt,
\[
\mathrm{conf} \mathrel{+}= \text{smoothingFactor} \cdot (1 - \mathrm{conf}),
\]
und die Zelle erst dann tatsächlich belegt (wie \texttt{setOccupied}),
wenn $\mathrm{conf} \ge \texttt{OCC\_COMMIT\_THRESHOLD}$ (Anhang~B). Mit
dem Standardwert \texttt{smoothingFactor} $= 0{,}5$ genügen bereits drei
aufeinanderfolgende Treffer an derselben Zelle (bei \SI{32}{\milli\second}
Regelzyklus also $\approx \SI{100}{\milli\second}$), ein einzelner
Ausreißer reicht dagegen nicht aus. Die Datei  \texttt{main.cpp} verwendet
\texttt{reportOccupied()} inzwischen dort, wo bisher
\texttt{setOccupied()} für Live-Sensortreffer aufgerufen wurde
(\texttt{dstar\_scenario::markRect}, \texttt{sim\_scenario::markRect}).

Die Reflexbewegung bleibt davon unberührt: \texttt{DwaPlanner}
bewertet die Kollisionsfreiheit eines Kurses weiterhin in \emph{jeden}
Zyklus direkt aus dem rohen ungeglätteten Messwert als virtuellem
Hindernispunkt (Abschnitt~\ref{dwa-hindernisse}). Geglättet wird
ausschließlich die Entscheidung, ob D* Lite die
globale Karte dauerhaft ändert und umplant. Die sofortige Ausweich\-reaktion
bei akuter Kollisionsgefahr bleibt so unverzögert.

Verifiziert: \texttt{MODE\_SIM\_TEST} und die Hinderniserkennung in
\texttt{MODE\_NAVIGATE\_DSTAR} liefern nach der Umstellung die
Ergebnisse wie zuvor (ST-SIM-001..004 weiterhin BESTANDEN,
byte-identisch über zwei Läufe, D*-Lite-Umplanung in
\texttt{coasterbot-dstar.wbt} weiterhin bei $t \approx \SI{3.8}{\second}$,
Ziel nach \SI{24}{\second} mit \SI{1.5}{\centi\meter} Restfehler). Die
zusätzliche Latenz durch die Glättung liegt unterhalb der Auflösung dieser
Szenarien.

% =====================================================================
\section{Globale Pfadplanung mit A*}\label{astar}
% =====================================================================

\texttt{astarPlan(grid, start, goal)} (Dateien \texttt{astar.\{h,cpp\}})
berechnet einen globalen Fahrweg auf der bekannten Karte. Umgesetzte
Anforderungen: \texttt{NAV-008} (Zielpunkt erreichen), \texttt{NAV-009}
(autonome Bewegung), \texttt{NAV-010} (Sicherheitsabstand).

\subsection{Algorithmus}\label{astar-algorithmus}

\begin{itemize}
\tightlist
\item
  8-fach verbundenes Gitter, euklidische Heuristik, Prioritäts\-warte\-schlange.
\item
  Kein \enquote{corner cutting}: eine Diagonale ist nur befahrbar, wenn
  auch die beiden orthogonalen Nachbarzellen frei sind.
\item
  Liegen Start oder Ziel in einer aufgebauten Hinderniszone, wird per
  Ringsuche die nächste freie Zelle verwendet.
\item
  \textbf{Glättung (\enquote{string pulling}):} \texttt{smoothPath()}
  behält von jedem Anker den entferntesten noch per Sichtlinie
  erreichbaren Wegpunkt. Das vermeidet die $45\degree$-Treppen des
  Rohpfades.
\item
  \textbf{Zentrierung:} \texttt{centerPath()} verschiebt innere
  Wegpunkte senkrecht zur Fahrtrichtung in Richtung eines größeren
  Hindernisabstands (max.\ \SI{0.20}{\meter}), damit der Pfad in engen
  Korridoren mittig verläuft. Ohne diesen Schritt bleibt der DWA-Planer
  an eckennahen Pfaden hängen.
\end{itemize}

Rückgabe: Wegpunkte in Weltkoordinaten von Start bis Ziel. Ein leerer
Vektor bedeutet \enquote{kein Pfad}.

\subsection{Auswahlbegründung}\label{astar-auswahl}

Gemäß Alternativenbeschreibung standen Dijkstra und BFS als Alternativen
zur Wahl. A* wurde wegen der zielgerichteten Heuristik gewählt: Bei
gleichem optimalem Zustand (zulässige Heuristik) expandiert A* deutlich
weniger Knoten als Dijkstra. Für die kleine Tischkarte
($\sim 32 \times 40$ Zellen) ist die Erstplanung damit in weniger als
einer Millisekunde abgeschlossen.

% =====================================================================
\section{Dynamische Neuplanung mit D* Lite}\label{dstar}
% =====================================================================

\texttt{DStarLite} (Dateien \texttt{dstar\_lite.\{h,cpp\}}) repariert den
Pfad inkrementell, wenn während der Fahrt ein Hindernis auftaucht oder
verschwindet. Umgesetzte Anforderung: \texttt{NAV-005} (Fahrtroute
während der Bewegung anpassen).

\subsection{Verfahren}\label{dstar-verfahren}

Implementiert ist D* Lite nach Koenig \& Likhachev (2002):

\begin{itemize}
\tightlist
\item
  Rückwärtssuche vom Ziel. Je Zelle ein $g$-Wert (bekannte Kosten) und
  ein $rhs$-Wert (\enquote{one-step lookahead}). Eine Zelle ist
  konsistent, wenn $g = rhs$.
\item
  \texttt{std::set}-basierte Prioritätswarteschlange über
  Schlüssel $(k_1, k_2)$; der Modifikator $k_m$ akkumuliert die
  Heuristik\-verschiebung, während der Roboter fährt, sodass die
  Warteschlange ohne vollständige Neusortierung gültig bleibt.
\item
  \texttt{plan(start, goal)} führt eine \emph{vollständige}
  Erstexpansion der erreichbaren Karte durch (\texttt{expandAll}). Ein
  vollständiges $g$-Feld sorgt dafür, dass eine spätere lokale Änderung
  auch dann repariert wird, wenn der Ausweichweg zuvor nicht \enquote{auf
  dem Weg} lag.
\item
  \texttt{setStart(cell)} bei jedem Zellwechsel des Roboters.
  \texttt{cellChanged(cell)} bei jeder Belegungsänderung stellt die
  betroffenen Knoten neu in die Warteschlange. Die Funktion
  \texttt{computeShortestPath()} repariert dann nur den betroffenen
  Bereich.
\item
  \texttt{extractPath()} folgt vom Start greedy den kleinsten
  $g$-Werten zum Ziel. \texttt{pathExists()} und
  \texttt{finiteGCount()} dienen der Diagnose.
\item
  Ist der gesamte geplante Korridor durchtrennt (inkrementelle Reparatur
  liefert keinen Pfad), setzt \texttt{main.cpp} D* Lite aus der aktuellen
  Pose vollständig neu auf, was günstiger ist als eine
  Neuplanung in jedem Zyklus.
\end{itemize}

Alternative laut Alternativenbeschreibung war LPA*. D* Lite ist die auf
bewegliche Startpositionen zugeschnittene Variante von LPA* und daher
für einen fahrenden Roboter die passende Wahl.

% =====================================================================
\section{Lokale Kollisionsvermeidung und Bewegungssteuerung mit DWA}\label{dwa}
% =====================================================================

\texttt{DwaPlanner} (Dateien \texttt{dwa\_planner.\{h,cpp\}}) folgt dem
globalen Pfad und wählt in jedem Regelzyklus ein sicheres
Geschwindigkeitspaar $(v, \omega)$. Er vereint die
Pflichtenheft-Komponenten \enquote{lokale Kollisionsvermeidung} und
\enquote{Bewegungssteuerung} und setzt \texttt{NAV-001}, \texttt{NAV-002},
\texttt{SAF-003} und \texttt{SAF-004} um.

\subsection{Dynamic Window Approach}\label{dwa-verfahren}

\begin{enumerate}
\tightlist
\item
  \textbf{Dynamisches Fenster:} Aus der aktuellen Geschwindigkeit und den
  Beschleunigungsgrenzen ($a_v = \SI{0.5}{\meter\per\second\squared}$,
  $a_\omega = \SI{6}{\radian\per\second\squared}$) wird der in einem
  Zeitschritt erreichbare $(v, \omega)$-Bereich bestimmt und in
  $6 \times 25$ Kandidaten abgetastet. Grenzen:
  $v \in [0,\ \SI{0.18}{\meter\per\second}]$,
  $|\omega| \le \SI{2.6}{\radian\per\second}$.
\item
  \textbf{Vorwärtssimulation:} Jeder Kandidat wird über
  $T_\mathrm{sim} = \SI{1.5}{\second}$ (Schritt \SI{0.1}{\second})
  kinematisch simuliert.
\item
  \textbf{Verwerfen:} Kurse mit Kollision oder solche, aus denen
  der Roboter nicht mehr bremsen kann
  ($v > \sqrt{2\,a_v\,\text{clearance}}$), werden verworfen. Damit ist
  \texttt{SAF-004} (keine schädigende Anfahrgeschwindigkeit) erfüllt.
\item
  \textbf{Bewertung:} Die verbleibenden Kandidaten werden gewichtet
  bewertet:
  \[
  S = w_h\,S_\mathrm{Kurs} + w_p\,S_\mathrm{Fortschritt}
    + w_c\,S_\mathrm{Abstand} + w_v\,S_\mathrm{Tempo}
  \]
  mit $w_h = 1{,}0$, $w_p = 2{,}0$, $w_c = 1{,}5$, $w_v = 0{,}3$.
  $S_\mathrm{Kurs}$ bewertet die Ausrichtung zum Carrot-Punkt,
  $S_\mathrm{Fortschritt}$ die Annäherung an ihn, $S_\mathrm{Abstand}$
  den Hindernisabstand entlang der Trajektorie, $S_\mathrm{Tempo}$ die
  Fahrgeschwindigkeit.
\item
  \textbf{Sackgasse:} Ist kein Kandidat zulässig, dreht der Roboter
  langsam auf der Stelle, bis wieder Optionen entstehen.
\end{enumerate}

\subsection{Pfadverfolgung (Pure Pursuit)}\label{dwa-carrot}

Der \textbf{Carrot-Punkt} ist der Punkt \SI{0.30}{\meter} entlang des
Polygonzugs vor der Projektion der Roboterposition auf den Pfad. Da er
stets auf dem kollisionsfrei geglätteten Pfad liegt, bleibt die globale
Hindernisumfahrung erhalten, während DWA die lokale, dynamikkonforme
Ausführung übernimmt.

\subsection{Hindernisse}\label{dwa-hindernisse}

DWA bezieht Hindernisse aus \emph{zwei} Quellen:

\begin{itemize}
\tightlist
\item
  dem \textbf{Distanzfeld} der (bereits ausgelegten) Belegungskarte:
  hier wird nur ein kleiner Restpuffer \texttt{GRID\_MARGIN}
  $= \SI{0.03}{\meter}$ abgezogen.
\item
  dem \textbf{aktuellen Messwert} als virtuellem Hindernispunkt
  vor dem Roboter: ein roher Punkt, von dem der volle Roboterradius
  $\SI{0.14}{\meter}$ abgezogen wird. Damit werden unkartierte bzw.\
  dynamische Hindernisse abgedeckt (\texttt{NAV-001}).
\end{itemize}

Über \texttt{setUltrasonicRange(r)} lässt sich der Ultraschalleinfluss
begrenzen: Trägt eine übergeordnete Ebene Hindernisse selbst in die
Karte ein, wirkt DWA nur noch als Nahbereichs-Sicherung
(\texttt{MODE\_SIM\_TEST}: $r = \SI{0.45}{\meter}$).

\subsection{Bewegungssteuerung}\label{dwa-bewegungssteuerung}

\texttt{driveVW(v, \ensuremath{\omega})} rechnet das gewählte
Geschwindigkeitspaar in Radgeschwindigkeiten um
\[
\omega_L = \frac{v - \omega\,b/2}{r},
\qquad
\omega_R = \frac{v + \omega\,b/2}{r}
\]
($r = \SI{0.035}{\meter}$, $b = \SI{0.202}{\meter}$) und gibt sie über
\texttt{RobotHAL::setLeftSpeed} / \texttt{setRightSpeed} aus. Die
Geschwindigkeitsbegrenzung ($\text{MAX\_V}$), das kontrollierte Anhalten
am Ziel (\texttt{GOAL\_TOL} $= \SI{0.05}{\meter}$) und der sofortige
Stopp bei fehlendem Pfad decken die im Pflichtenheft geforderten
Eigenschaften der Bewegungssteuerung ab.

Alternative laut Alternativenbeschreibung waren Potentialfelder. Diese
wurden wegen der möglichen lokalen Minima nicht gewählt. DWA umgeht das
Problem durch die explizite Trajektorienbewertung und die Kopplung an
den globalen Pfad.

% =====================================================================
\section{Sicherheitskomponente}\label{sicherheitskomponente}
% =====================================================================

\texttt{SafetyMonitor} (Dateien \texttt{safety\_monitor.\{h,cpp\}}) ist
die im Lasten- und Pflichtenheft geforderte \textbf{Sicherheitskomponente
/ Sicherheitslogik} mit übergeordneter Priorität. Umgesetzte
Anforderungen: \texttt{NAV-003}, \texttt{NAV-004}, \texttt{SAF-001},
\texttt{SAF-002} (Struktur), \texttt{SAF-003}, \texttt{SAF-005}.

\subsection{Funktion}\label{safety-funktion}

In jedem Regelzyklus (\emph{vor} der Navigation) wertet der Monitor
die vier Kantensensoren aus. Erkennt ein Sensor die Tischkante, hält er
sofort an, übernimmt die Aktorik und führt eine Ausweichbewegung aus:

\begin{longtable}[]{@{}p{0.30\textwidth}p{0.62\textwidth}@{}}
\toprule
\textbf{Situation} & \textbf{Reaktion}\\
\midrule
\endhead
Kante vorne & Rückwärtsfahrt (\texttt{EVADE\_RADS} $= \SI{3}{\radian\per\second}$, \texttt{EVADE\_TIME} $= \SI{0.7}{\second}$)\\
Kante hinten & Vorwärtsfahrt\\
Kante vorne \emph{und} hinten & Stillstand (Zustand: \texttt{PINNED})\\
\bottomrule
\end{longtable}

Zustandsautomat: \texttt{CLEAR} $\to$ \texttt{EVADE} $\to$ \texttt{PAUSE}
($\SI{0.3}{\second}$) $\to$ \texttt{CLEAR}, bei beidseitiger Kante
\texttt{PINNED}. Solange die Funktion \texttt{overriding()} true ist, darf die
Navigation \emph{keine} eigenen Fahrbefehle geben. Dies wird in
\texttt{main.cpp} sichergestellt, indem der Regelzyklus nach einem
haltenden \texttt{safety.update()} vorzeitig endet.

\subsection{Schnittstelle}\label{safety-schnittstelle}

\begin{longtable}[]{@{}p{0.36\textwidth}p{0.58\textwidth}@{}}
\toprule
\textbf{Methode} & \textbf{Bedeutung}\\
\midrule
\endhead
\texttt{bool update()} & \texttt{true}, solange die Komponente die Aktorik hält\\
\texttt{bool overriding()} & Zustand $\neq$ \texttt{CLEAR}\\
\texttt{bool edgeEventThisTick()} & steigende Flanke einer Kantenerkennung\\
\texttt{bool frontEdge() / rearEdge()} & betroffene Seite\\
\texttt{const char* stateName()} & aktueller Zustand (Systemüberwachung, \texttt{MON-003})\\
\texttt{int eventCount()} & Zähler aller Kantenereignisse\\
\bottomrule
\end{longtable}

\paragraph{Not-Aus (\texttt{SAF-005}).} Der Software-seitige Anker ist die
sofortige Aktorübernahme mit \texttt{drive(0)}. Der physische
Not-Aus-Taster (\texttt{HW-BTN-003}) wird über dieselbe
Abstraktions-Schnittstelle als Ereignis eingespeist, ist jedoch in der
Simulation nicht modelliert.

\paragraph{Sensorausfall (\texttt{SAF-002}).} Die Zustandsstruktur für den
Wechsel in einen sicheren Zustand ist vorhanden; die gezielte
Fehlerinjektion (\texttt{ST-SIM-005}) übernimmt \texttt{FaultMonitor},
siehe Abschnitt~\ref{faultmonitor}.

\subsection{Fehlerüberwachung (\texttt{FaultMonitor})}\label{faultmonitor}

\texttt{FaultMonitor} (Dateien \texttt{fault\_monitor.\{h,cpp\}}) deckt die
Fehlerinjektionstests \texttt{ST-SIM-005} (Sensorausfall) und
\texttt{ST-SIM-006} (Aktorfehler) ab. Wie \texttt{SafetyMonitor} kennt er
nur \texttt{RobotHAL} und ist damit Arduino-portabel; anders als
\texttt{SafetyMonitor} ist sein sicherer Zustand \textbf{verriegelt}: ein
Sensor-/Aktorausfall behebt sich nicht von selbst, es gibt also keine
automatische Rückkehr nach \texttt{NORMAL}.

\begin{longtable}[]{@{}p{0.28\textwidth}p{0.64\textwidth}@{}}
\toprule
\textbf{Prüfung} & \textbf{Kriterium}\\
\midrule
\endhead
\bottomrule
\endfoot
Ultraschall (\texttt{SENSOR\_FAULT}) & Messwert außerhalb $[0,
\texttt{ULTRASONIC\_MAX\_VALID}]$. Die Schwelle liegt bei \SI{4.5}{\meter},
mit deutlicher Marge zum vom PROTO simulierten Sensorrauschen (die
\texttt{lookupTable} trägt am oberen Ende \SI{2}{\percent} Rauschen auf
\SI{4}{\meter}, einzelne Messungen liegen daher legitim leicht über
\SI{4}{\meter} - beobachtet bis \SI{4.04}{\meter}). Eine zu enge Schwelle
hätte hier ganz normales Sensorrauschen fälschlich als Ausfall gemeldet\\
Antrieb (\texttt{ACTUATOR\_FAULT}) & kommandierte vs.\ aus
\texttt{getWheelAngle()} gemessene Radgeschwindigkeit einer Seite weicht um
mehr als \texttt{SPEED\_DEVIATION\_RADS} ($\SI{1}{\radian\per\second}$) ab,
bei einem Kommando über \texttt{MIN\_COMMANDED\_RADS}
($\SI{0.5}{\radian\per\second}$), anhaltend über
\texttt{FAULT\_DEBOUNCE\_TIME} ($\SI{0.3}{\second}$) - die Debounce-Zeit
verhindert Fehlalarm durch die normale Beschleunigungsrampe\\
\end{longtable}

Bestätigt sich ein Fehler, übernimmt \texttt{FaultMonitor} sofort die
Aktorik mit \texttt{drive(0)} und hält sie, genau wie
\texttt{SafetyMonitor}: \texttt{bool update(commandedLeft, commandedRight)}
liefert \texttt{true}, solange die Komponente die Aktorik hält, der
Aufrufer darf dann keine eigenen Fahrbefehle mehr geben.

Die Fehler selbst werden simulationsseitig in \texttt{WebotsHAL} erzeugt
(\texttt{injectUltrasonicFault()} / \texttt{injectLeftMotorFault()}) - wie
\texttt{MotorControlMode} (Abschnitt~\ref{motor-control-vergleich}) sind
das reine Simulationsschalter, \emph{nicht} Teil von \texttt{RobotHAL}: ein
realer Ausfall entsteht durch Hardware, nicht durch einen
Laufzeit-Schalter. \texttt{FaultMonitor} sieht nur das Symptom über die
normale \texttt{RobotHAL}-Schnittstelle - einen Ultraschallwert außerhalb
des Kontrakts bzw.\ ein linkes Rad, das trotz Kommando nicht dreht - und
kann den simulierten Fehler daher nicht von einem echten unterscheiden.

\subsection{Ablauf \texttt{MODE\_FAULT\_INJECTION}}\label{ablauf-fault-injection}

Zwei Phasen auf offener Fläche (\texttt{coasterbot-testfield.wbt}, keine
Kanten/Hindernisse, damit ausschließlich der injizierte Fehler das
Ergebnis bestimmt), je mit einem frisch instanzierten
\texttt{FaultMonitor}: Geradeausbefehl für \SI{3}{\second}, danach den
jeweiligen Fehler über \texttt{WebotsHAL} auslösen und messen, ob/wann der
Monitor reagiert.

\begin{enumerate}
\tightlist
\item
  \textbf{Phase 1 (\texttt{ST-SIM-005}):} Ultraschall auf "nicht
  verfügbar" schalten. Verifiziert (kopfloser Lauf,
  \texttt{coasterbot-testfield.wbt}): Erkennung binnen eines Regelzyklus
  ($<\SI{0.02}{\second}$), Aktorik danach nachweislich im Stillstand
  (gemessene Radgeschwindigkeit $\approx \SI{0}{\radian\per\second}$).
\item
  \textbf{Phase 2 (\texttt{ST-SIM-006}):} linker Motor fällt aus (reagiert
  nicht mehr auf Kommandos). Verifiziert: Erkennung nach
  \SI{0.34}{\second} (knapp über der Debounce-Zeit, wie vorgesehen),
  Aktorik danach im Stillstand.
\item
  Bewertung je Testfall (\texttt{BESTANDEN}, wenn Fehler erkannt \emph{und}
  die Aktorik anschließend nachweislich gestoppt bleibt). Zwei kopflose
  Läufe lieferten identische Erkennungszeiten und Verdikte
  (\texttt{ST-SIM-004}-Prinzip).
\end{enumerate}

% =====================================================================
\section{Reaktive Verhaltenslogik}\label{robotlogic}
% =====================================================================

\texttt{RobotLogic} (Dateien \texttt{robot\_logic.\{h,cpp\}}) ist ein
reaktiver Zustandsautomat zur Hindernis- und
Kantenvermeidung. Er dient der Inbetriebnahme der HAL und ist die
Grundlage der Betriebsart \texttt{MODE\_AUTONOMOUS}. Für die
zielgerichtete Navigation wird er durch den Navigationsstapel (A* / D*
Lite / DWA) ersetzt.

\begin{longtable}[]{@{}p{0.24\textwidth}p{0.68\textwidth}@{}}
\toprule
\textbf{Zustand} & \textbf{Verhalten}\\
\midrule
\endhead
\texttt{FORWARD} & geradeaus mit \texttt{CRUISE\_SPEED} $= \SI{6}{\radian\per\second}$; bei Kante $\to$ \texttt{REVERSE}, bei Hindernis ($< \SI{0.22}{\meter}$) $\to$ \texttt{AVOID\_OBSTACLE}\\
\texttt{REVERSE} & \SI{0.6}{\second} zurücksetzen, dann \texttt{TURN}\\
\texttt{TURN} & auf der Stelle drehen (zufällige Richtung), bis frei\\
\texttt{AVOID\_OBSTACLE} & drehen, bis der Sensor frei ist\\
\bottomrule
\end{longtable}

Zusätzlich stellt \texttt{RobotLogic} die expliziten Bewegungsprimitive
\texttt{forward}, \texttt{backward}, \texttt{turnLeft}, \texttt{turnRight}
und \texttt{stop} bereit, die in den Test-Betriebsarten direkt aufgerufen
werden.

% =====================================================================
\section{Ablaufsteuerung und Betriebsarten}\label{ablaufsteuerung}
% =====================================================================

Die Anwendungsebene (\texttt{main.cpp}) instanziiert \texttt{WebotsHAL},
\texttt{RobotLogic} und \texttt{PoseEstimator} und wählt über den
Kompilierschalter \texttt{static const Mode MODE} eine Betriebsart. So
ist nachvollziehbar, welche Bewegung warum ausgeführt wird
(\texttt{NFA-TST-*}: gezielt erzeugbare, reproduzierbare Abläufe).

\begin{longtable}[]{@{}
  >{\raggedright\arraybackslash}p{0.30\textwidth}
  >{\raggedright\arraybackslash}p{0.34\textwidth}
  >{\raggedright\arraybackslash}p{0.30\textwidth}@{}}
\caption{Betriebsarten des Controllers.}\label{tab:modes}\\
\toprule
\textbf{MODE} & \textbf{Zweck} & \textbf{Welt}\\
\midrule
\endfirsthead
\toprule
\textbf{MODE} & \textbf{Zweck} & \textbf{Welt}\\
\midrule
\endhead
\bottomrule
\endfoot
\texttt{MODE\_WHEEL\_TEST} & je Seite \SI{2}{\second} die Räder drehen, Encoder ausgeben & \small beliebig\\
\texttt{MODE\_MANUAL} & feste Befehlsfolge über die Bewegungsprimitive & \small beliebig\\
\texttt{MODE\_AUTONOMOUS} & reaktiver Zustandsautomat \texttt{RobotLogic} & \small\texttt{coasterbot.wbt}\\
\texttt{MODE\_ODOMETRY\_TEST} & definierte Fahrt, Pose ausgeben (Odometrieprüfung) & \small\texttt{coasterbot-testfield.wbt}\\
\texttt{MODE\_NAVIGATE} & A*-Pfad planen und mit DWA abfahren & \small\texttt{coasterbot-astar.wbt}\\
\texttt{MODE\_NAVIGATE\_DSTAR} & D* Lite + per Ultraschall entdecktes Hindernis $\to$ Umplanung & \small\texttt{coasterbot-dstar.wbt}\\
\texttt{MODE\_SIM\_TEST} & kombinierter Simulationstest, Bewertung \texttt{ST-SIM-001..004} & \small\texttt{coasterbot-simtest.wbt}\\
\texttt{MODE\_MOTOR\_CONTROL\_TEST} & Vergleich Open-Loop/Closed-Loop-Motorregelung (Abschnitt~\ref{motor-control-vergleich}) & \small\texttt{coasterbot-testfield.wbt}\\
\texttt{MODE\_FAULT\_INJECTION} & Fehlerinjektionstest, Bewertung \texttt{ST-SIM-005/006} (Abschnitt~\ref{ablauf-fault-injection}) & \small\texttt{coasterbot-testfield.wbt}\\
\bottomrule
\end{longtable}

\subsection{Ablauf \texttt{MODE\_SIM\_TEST}}\label{ablauf-simtest}

\begin{enumerate}
\tightlist
\item
  Pose auf die Startpose der simulierten Welt setzen. Planer- und DWA-Gitter
  aus dem Szenario \texttt{sim\_scenario} aufbauen (Tischrand als Absturzkante,
  bekannte Bierflasche auf der Route, Deko in den Ecken).
\item
  D* Lite Erstplanung, Pfad glätten und zentrieren.
\item
  \textbf{Phase 1 (Navigation, \texttt{ST-SIM-001/002}):}
  Sicherheitskomponente $\to$ Kartenpflege $\to$ D* Lite $\to$ DWA, bis
  das Ziel innerhalb der Toleranz erreicht ist. Kleinster
  Hindernisabstand und Anzahl der Umplanungen werden protokolliert.
\item
  \textbf{Phase 2 (Tischkante, \texttt{ST-SIM-003}):} Roboter richtet
  sich auf $+Y$ aus und fährt langsam Richtung Tischkante. Danach darf nur die
  Sicherheitskomponente eingreifen. Es wird gezählt, wie oft
  sie die Kante erkennt und ob der Roboter auf dem Tisch bleibt.
\item
  Bewertung ausgeben (\texttt{BESTANDEN} / \texttt{FEHLGESCHLAGEN} je
  Testfall). \texttt{ST-SIM-004} wird durch zweimaligen Lauf und
  Vergleich der Ausgabe geprüft (byte-identisch, da alle Komponenten
  deterministisch sind).
\end{enumerate}

\subsection{Missionsablaufsteuerung}\label{missionsablaufsteuerung}

Die Variable \texttt{MODE} wählt eine \emph{Testbetriebsart}
für die Simulation. Sie ist kein Ersatz für die im Pflichtenheft
geforderte \emph{Missionsablaufsteuerung} des realen Prototyps
(\texttt{IDLE\,$\to\,\ldots\,\to$\,DONE}, siehe
\texttt{Pflichtenheft/Zustandsautomaten.svg}). Abbildung~\ref{fig:missions-statemachine} zeigt einen
dafür ausgearbeiteten \textbf{Aufbau}, der die
abstrakten Zustände aus dem Pflichtenheft durch die konkreten Betriebszustände
des Prototyps ersetzt.

\begin{figure}[htbp]
\centering

\caption{Ablauf für die Missionsablaufsteuerung des
Coasterbot-Prototyps: sechs Zustände (\emph{Coasterbot setup},
\emph{Coasterbot wartend}, \emph{Tisch einlernen}, \emph{Untersetzer
ausgeben}, \emph{Untersetzer einsammeln}, \emph{Not-Halt aktivieren}) mit
Entry-/Exit-Aktionen (LED-Farbe, \texttt{bot.LearnTable()},
\texttt{bot.setCoaster()}, \texttt{bot.getCoaster()}, \texttt{bot.stop()})
und Wächterbedingungen auf den Flags \texttt{bTableLearned},
\texttt{bCoasterOut}, \texttt{btnPushed} sowie den Fehlersignalen
\texttt{bEdgedetected}/\texttt{bNoPath}.}
\label{fig:missions-statemachine}
\end{figure}

Nach dem Einschalten (\emph{Coasterbot setup}, beide Flags auf
\texttt{False}) verharrt der Bot im zentralen Wartezustand \emph{Coasterbot
wartend} (LED aus), bis der Taster gedrückt wird. Welcher Folgezustand
dann angesteuert wird, hängt von beiden Flags ab: ist der Tisch
noch nicht eingelernt, folgt \emph{Tisch einlernen}. Falls er eingelernt und
kein Untersetzer ausgegeben wird, folgt \emph{Untersetzer ausgeben}. Ist bereits
einer ausgegeben, folgt stattdessen \emph{Untersetzer einsammeln}. Jeder
dieser drei Zustände kehrt nach Abschluss seiner Aktion automatisch in den
Wartezustand zurück. Erkennt die Sicherheitskomponente währenddessen eine
Tischkante oder scheitert die Pfadplanung (\texttt{bEdgedetected} bzw.\
\texttt{bNoPath}), wird sofort in \emph{Not-Halt aktivieren} gewechselt
(Bot stoppt, LED rot, Tischeinlernung verworfen). Ein erneuter
Druck auf den Taster führt zurück in den Wartezustand. \texttt{Tisch
einlernen} und \texttt{Untersetzer ausgeben}/\texttt{einsammeln}
entsprechen bereits den Methoden der Simulation \texttt{runLearnTable()} /
\texttt{isTableLearned()} bzw.\ \texttt{runSpendCoaster()} /
\texttt{runGetCoaster()} der neuen Klasse \texttt{CoasterbotFunctions}
(\texttt{coasterbot\_functions.\{h,cpp\}}). Die übrigen Zustände dieses
Aufbaus (insbesondere \emph{Not-Halt aktivieren}) sind in einem separaten controller
Softwarestand mit dem Namen \texttt{coasterbot\_V\_01\_00} abgebildet.
Dieser Softwarestand wurde genutzt, um den Funktionsumfang des Missionsablauf parallel zur Testdurchführung 
auszuarbeiten. Das Schichtenmodell, der Datenfluss und die enthalten Klassen werden dabei übernommen. 
Es wurden hauptsächlich Anpassungen in \texttt{coasterbot\_functions.\{h,cpp\}} und der \texttt{main.cpp} durchgeführt. 
Der Stand von \texttt{coasterbot\_V\_01\_00} wird auf die Hardware gespielt.

% =====================================================================
\section{Simulationsmodell}\label{simulationsmodell}
% =====================================================================

Das Simulationsmodell erfüllt \texttt{NFA-SIM-001..005} und
\texttt{SIM-001..007}: Die Robotersoftware läuft unverändert, die
hardwarenahe Schicht wird durch Webots-Modelle ersetzt
(\texttt{NFA-SIM-004}).

\subsection{Robotermodell (PROTO)}\label{proto}

\texttt{protos/coasterbot/Coasterbot.proto} ist aus der
CAD-Baugruppe abgeleitet.

\begin{itemize}
\tightlist
\item
  \textbf{Koordinaten:} PROTO ist Y-up (lokal $+X$ rechts, $+Y$ oben,
  $-Z$ vorne). Die Welten sind Z-up (ENU). Instanzen stehen mit
  \texttt{rotation 1 0 0 1.5708} aufrecht.
\item
  \textbf{Antrieb:} vier mal \texttt{RotationalMotor}, je Seite als coupled
  motors gekoppelt (\texttt{wheel\_left::front} mit
  \texttt{wheel\_left::rear}, analog rechts).
\item
  \textbf{Sensoren:} vier mal \texttt{PositionSensor} an den Radgelenken
  (Encoder), \texttt{ultrasonic} (\texttt{DistanceSensor}, sonar,
  \texttt{lookupTable} in Metern, \textbf{analoges} Distanzsignal), vier
  \texttt{edge\_*} (\texttt{DistanceSensor}, infrarot, nach unten,
  \textbf{digitales} Signal: \texttt{lookupTable}
  $0\,0\ /\ 0{,}098\,0\ /\ 0{,}10\,1\ /\ 4\,1$, eine reine \num{0}/\num{1}-Stufe
  mit \SI{2}{\milli\meter} numerischer Übergangszone statt einer analogen
  Rampe, siehe Abschnitt~\ref{webotshal}), \texttt{inertial\_unit},
  \texttt{gyro} und \texttt{accelerometer} (beide modellieren den
  laut Stückliste verbauten MPU-6050-Chip: \texttt{lookupTable}
  begrenzt auf dessen Werksdefault-Messbereich, \texttt{resolution}
  auf dessen 16-Bit-ADC-Schrittweite. Bias und Rauschen des Gyros
  kommen zusätzlich aus \texttt{WebotsHAL}, siehe
  Abschnitt~\ref{gyro-simulation}).
\item
  \textbf{Kollisionskörper:} zwei gestapelte Boxen (schmaler
  unterer Teil zwischen den Rädern) gegen Jittern.
\end{itemize}

Die \texttt{lookupTable}s der Distanzsensoren wurden so kalibriert, dass
die Software mit demselben Signaltyp wie auf der Zielhardware arbeitet:
Ultraschall liefert weiterhin ein analoges Distanzsignal in Metern
(Vergleich mit \texttt{OBSTACLE\_THRESHOLD\_M}). Die Kantensensoren
liefern ein digitales \num{0}/\num{1}-Signal, das \texttt{WebotsHAL} nur
noch auf seine Polarität hin abfragt (\texttt{EDGE\_ACTIVE\_HIGH}, siehe
Abschnitt~\ref{webotshal}). Ein analoger Schwellenwert befindet sich nicht
mehr im Code.

\subsection{Welten}\label{welten}

\begin{longtable}[]{@{}p{0.30\textwidth}p{0.64\textwidth}@{}}
\caption{Simulationswelten mit Bezug zur Software.}\label{tab:welten}\\
\toprule
\textbf{Welt} & \textbf{Inhalt / zugehörige Betriebsart}\\
\midrule
\endfirsthead
\toprule
\textbf{Welt} & \textbf{Inhalt / zugehörige Betriebsart}\\
\midrule
\endhead
\bottomrule
\endfoot
\small \texttt{coasterbot.wbt} & Tisch mit Flaschen, \texttt{MODE\_AUTONOMOUS}\\
\small \texttt{coasterbot-testfield.wbt} & offene $4\times4$-Fläche, \texttt{MODE\_ODOMETRY\_TEST}, \texttt{MODE\_MOTOR\_CONTROL\_TEST}, \texttt{MODE\_FAULT\_INJECTION}\\
\small \texttt{coasterbot-astar.wbt} & zwei versetzte Wände (Slalom), Zielmarker, \texttt{MODE\_NAVIGATE}\\
\small \texttt{coasterbot-dstar.wbt} & Wand mit zwei Lücken, unkartierte Box, \texttt{MODE\_NAVIGATE\_DSTAR}\\
\small \texttt{coasterbot-simtest.wbt} & \texttt{Table} $1{,}6\times2{,}0$, \texttt{FlowerPot} + \texttt{BeerBottle}s, \texttt{MODE\_SIM\_TEST}\\
\bottomrule
\end{longtable}

Die Konstanten des Szenarios in \texttt{main.cpp} (Namensräume
\texttt{nav\_scenario}, \texttt{dstar\_scenario}, \texttt{sim\_scenario})
müssen mit der jeweiligen Welt übereinstimmen (Start, Ziel,
Hindernispositionen, Tischgrenzen).

\subsection{Reproduzierbarkeit}\label{reproduzierbarkeit}

\texttt{SIM-001} / \texttt{ST-SIM-004} werden erfüllt, weil die
Komponenten deterministisch sind: fester Zeitschritt, sortierte
Prioritätswarteschlangen mit eindeutigem Schlüssel, und Zufallszahlen nur
an zwei klar abgegrenzten Stellen: \texttt{RobotLogic} nutzt
\texttt{std::rand} (an der Navigation nicht beteiligt), und die simulierte
Gyro-Kalibrierung in \texttt{WebotsHAL} nutzt einen
\texttt{std::mt19937}-Generator mit \textbf{festem} statt zeitbasiertem
Seed (Abschnitt~\ref{gyro-simulation}). Damit erzeugt jeder Lauf
dieselbe Rauschfolge. \texttt{WorldInfo.randomSeed} wird in allen
Coasterbot-Welten ebenfalls fest gesetzt statt auf dem Default~0
(\enquote{aktuelle Zeit als Seed}) belassen, da Webots selbst ansonsten
keine deterministische physikalische Simulation garantiert. Zwei
Läufe von \texttt{MODE\_SIM\_TEST} liefern weiterhin byte-identische
Protokolle.

% =====================================================================
\section{Systemüberwachung}\label{systemueberwachung}
% =====================================================================

Die Systemüberwachung (\texttt{MON-001..005}) ist in der Simulation als
strukturiertes Konsolenprotokoll umgesetzt. Jede Betriebsart gibt aus:

\begin{itemize}
\tightlist
\item
  \textbf{Betriebszustand} (\texttt{MON-003}): Zustandswechsel von
  \texttt{RobotLogic} (\texttt{[AUTONOMOUS] \ldots Zustand: \ldots}) und
  \texttt{SafetyMonitor} (\texttt{stateName()}), Pose alle
  \SI{2}{\second} bis \SI{3}{\second}.
\item
  \textbf{Ereignisse}: Kantenerkennung, Erkennung eines unkartierten
  Hindernisses, Umplanung, Zielerreichung.
\item
  \textbf{Fehlererkennung} (\texttt{MON-001}): \enquote{KEIN PFAD},
  Zeitüberschreitung der Navigation, Guardabbruch (\texttt{guard hit})
  in \texttt{DStarLite::computeShortestPath}.
\item
  \textbf{Aufgabenergebnis} (\texttt{MON-004/005}): in
  \texttt{MODE\_SIM\_TEST} pro Testfall \texttt{BESTANDEN} bzw.\
  \texttt{FEHLGESCHLAGEN} mit Kennzahlen (Restfehler zum Ziel, minimaler
  Hindernisabstand, Kantenereignisse, \enquote{Tisch verlassen}).
\end{itemize}

Nicht umgesetzt sind eine persistente Protokolldatei mit Zeitstempeln
und die im Pflichtenheft skizzierte zentrale Ereignisverwaltung, das
Konsolenprotokoll deckt den Prototyp-Bedarf ab.

% =====================================================================
\section{Abbildung auf Anforderungen und Testfälle}\label{traceability}
% =====================================================================

\begin{longtable}[]{@{}
  >{\raggedright\arraybackslash}p{0.17\textwidth}
  >{\raggedright\arraybackslash}p{0.44\textwidth}
  >{\raggedright\arraybackslash}p{0.31\textwidth}@{}}
\caption{Rückverfolgbarkeit Anforderung $\rightarrow$ Softwarekomponente $\rightarrow$ Test.}
\label{tab:trace}\\
\toprule
\textbf{ID} & \textbf{Umsetzung} & \textbf{Nachweis}\\
\midrule
\endfirsthead
\toprule
\textbf{ID} & \textbf{Umsetzung} & \textbf{Nachweis}\\
\midrule
\endhead
\bottomrule
\endfoot
NAV-001 & \texttt{DwaPlanner} (Ultraschall als virtuelles Hindernis), \texttt{OccupancyGrid} & ST-SIM-002\\
NAV-002 & \texttt{DwaPlanner}, \texttt{DStarLite} & ST-SIM-002\\
NAV-003 & \texttt{SafetyMonitor} (Kantensensoren) & ST-SIM-003\\
NAV-004 & \texttt{SafetyMonitor}; Gitter auf Tischfläche begrenzt & ST-SIM-003\\
NAV-005 & \texttt{DStarLite} + Kartenpflege in \texttt{main.cpp} & ST-SIM-002\\
NAV-006 & \texttt{PoseEstimator} (Odometrie) & ST-SIM-001\\
NAV-007 & \texttt{PoseEstimator} (Gyro-Fusion) & ST-SIM-001\\
NAV-008 & \texttt{astarPlan} / \texttt{DStarLite} + \texttt{DwaPlanner} & ST-SIM-001\\
NAV-009 & gesamter Navigationsstapel & ST-SIM-001/002\\
NAV-010 & \texttt{OccupancyGrid}-Inflation, DWA-\texttt{clearance}, \texttt{SafetyMonitor} & ST-SIM-002 (min.\ Abstand)\\
NAV-011 & \emph{nicht umgesetzt} (keine Getränkeerkennung) & keine\\
SAF-001 & \texttt{SafetyMonitor} (sofortiger \texttt{drive(0)}) & ST-SIM-003\\
SAF-002 & \texttt{FaultMonitor} (Ultraschall-Plausibilitätsprüfung) & ST-SIM-005\\
SAF-003 & \texttt{DwaPlanner} (Kollisions-/Bremsprüfung), \texttt{SafetyMonitor} & ST-SIM-002/003\\
SAF-004 & \texttt{DwaPlanner}: \texttt{MAX\_V} + Bremsbedingung & ST-SIM-002\\
SAF-005 & \texttt{SafetyMonitor}-Übernahme; Taster über HAL-Ereignis & keine\\
MON-001 & Konsolenprotokoll, \enquote{KEIN PFAD}, Wächter, Zeitüberschreitung & ST-SIM-*\\
MON-002 & \texttt{stdout}-Protokoll (keine Datei) & ST-SIM-*\\
MON-003 & \texttt{getStateName()} / \texttt{stateName()}, Pose-Ausgabe & ST-SIM-*\\
MON-004 & \texttt{DwaPlanner::reachedGoal()}, Verdikt \texttt{p1} & ST-SIM-001\\
MON-005 & \texttt{FEHLGESCHLAGEN}-Ausgabe, Zeitüberschreitung & ST-SIM-*\\
NFA-ARC-001/002 & je Komponente eine Klasse/Datei, klare Trennung & Inspektion\\
NFA-ARC-003 & HAL + entkoppelte Planer; neue Komponenten ohne Kernänderung & Inspektion\\
NFA-ARC-004 & \texttt{RobotHAL}, \texttt{setPath}, \texttt{update}, \texttt{clearance} & Inspektion\\
NFA-ARC-005 & \texttt{RobotHAL} / \texttt{WebotsHAL} & Inspektion\\
NFA-MAI-001/002 & nur \texttt{webots\_hal.cpp} ist hardwareabhängig & Inspektion\\
NFA-MAI-004 & Komponenten nehmen nur \texttt{RobotHAL} / \texttt{OccupancyGrid} & Inspektion\\
NFA-SIM-001..005 & Webots-Modell, \texttt{WebotsHAL}, identische Schnittstellen & ST-SIM-*\\
SIM-001 & deterministische Komponenten & ST-SIM-004\\
SIM-004 & \texttt{OccupancyGrid} + Welt-Hindernisse & ST-SIM-002\\
SIM-005 & \texttt{WebotsHAL} (\texttt{injectUltrasonicFault}/\texttt{injectLeftMotorFault}) & ST-SIM-005/006\\
\end{longtable}

\subsection{Status der Simulationstestfälle}\label{status-tests}

\begin{longtable}[]{@{}p{0.16\textwidth}p{0.42\textwidth}p{0.34\textwidth}@{}}
\toprule
\textbf{Testfall} & \textbf{Gegenstand} & \textbf{Status}\\
\midrule
\endhead
ST-SIM-001 & Navigation zu einem Zielpunkt & umgesetzt, \texttt{MODE\_SIM\_TEST} Phase 1\\
ST-SIM-002 & Dynamische Hindernisvermeidung & umgesetzt (bekannte + unkartierte Hindernisse)\\
ST-SIM-003 & Verhindern des Tischverlassens & umgesetzt, \texttt{MODE\_SIM\_TEST} Phase 2\\
ST-SIM-004 & Wiederholbarkeit & umgesetzt (zwei Läufe, byte-identisch)\\
ST-SIM-005 & Sensorausfall & umgesetzt, \texttt{MODE\_FAULT\_INJECTION} Phase 1 (erkannt $<\SI{0.02}{\second}$)\\
ST-SIM-006 & Aktorfehler & umgesetzt, \texttt{MODE\_FAULT\_INJECTION} Phase 2 (erkannt nach \SI{0.34}{\second})\\
ST-SIM-007 & Untersetzerhandling & außerhalb des Umfangs (keine Manipulation)\\
ST-SIM-008 & Validierung Simulation vs.\ Prototyp & offen (Prototyp erforderlich)\\
\bottomrule
\end{longtable}

% =====================================================================
\section{Grenzen und offene Punkte}\label{grenzen}
% =====================================================================

Einige Anforderungen sind bisher nicht Teil der in diesem Dokument
beschriebenen Simulationssoftware (\texttt{controllers/coasterbot/}). Die
missionsbezogene Ablaufsteuerung
\texttt{IDLE\,$\to\,\ldots\,\to$\,DONE} ist darin noch nicht vollständig
implementiert. Der Ablauf ist in Abschnitt~\ref{missionsablaufsteuerung}
dargestellt. Das Untersetzerhandling (Aufnahme/Ablage,
\texttt{CST-*}) ist in einem eigenen Stand in der Simulation
(\texttt{coasterbot\_V\_01\_00}, Klasse \texttt{CoasterbotFunctions}) über
einen Zustandsautomaten für Ausgabe und Aufnahme umgesetzt. Eine
Manipulationsplanung über IK~+~RRT* ist dafür nicht erforderlich, da die
konstruierte Mechanik (Hubscheibe mit Ausschieber) nur einen
einzigen, servogesteuerten Freiheitsgrad besitzt. Die Lokalisierung nutzt
statt EKF/UKF einen Komplementärfilter, der für die ebene Tischfläche
ausreicht, jedoch keine Schätzung der Unsicherheit liefert. Der reale Aufbau des
Roboters verfügt inzwischen, anders als zum Auslegungszeitpunkt des
Simulationsmodells angenommen, über einen Encoder je Seite (siehe
Abschnitt~\ref{webotshal}). Eine Gegenüberstellung der damit erreichten
realen Odometriegenauigkeit mit dem Simulationsmodell steht noch aus. Der
Ultraschall an der Front findet kleine, außeraxiale Tischobjekte nicht
zuverlässig. Deshalb sind im
Simulationstest Blumentopf und Flaschen als bekannte Hindernisse in der
Karte hinterlegt, während die reine Sensor-Entdeckung separat mit einem
großen Hindernis in \texttt{MODE\_NAVIGATE\_DSTAR} gezeigt wird. Die zwei
getrennten Gitter für Planung und DWA samt \texttt{centerPath} könnten
verbessert werden. Eine gradientenbasierte Kostenkarte würde beide
zu einer Einzigen zusammenführen. \texttt{FaultMonitor}
(Abschnitt~\ref{faultmonitor}) deckt den in \texttt{ST-SIM-005/006}
geforderten Fall ab (Ultraschall- bzw.\ Ausfall des linken Motors).
Offen bleiben außerdem die Validierung gegen den realen
Prototyp (\texttt{ST-SIM-008}) sowie die Eignung von \texttt{getGyroZ()}
für eine reale IMU, deren Dater lediglich aus dem Datenblatt entnommen wurden
und  bislang nicht abschließend beurteilt wurde.

% =====================================================================
\section{Implementierung auf Hardware}\label{hardwareimplementierung}
% =====================================================================

Beim Umsetzen des Hardware-Abstraktions-Layers(HAL) der Simulation auf der realen Raspberry Pi Pico 2 Microcontroller Architektur sind einige Besonderheiten implementiert, die hier beschrieben werden sollen.

\subsection{Non-blocking Implementierung}

Viele Funktionalitäten sind übertragen auf eine Programmiersprache ein einfacher Befehl, der eine Absicht darstellt, was mit dem System passieren soll. Ein Beispiel soll dazu der Befehl „Anhalten“ für die Motorsteuerung sein. Ein solcher Befehl muss selbstverständlich auf die Hardware umgelegt werden, er beeinhaltet aber auch ein zeit- sowie zustandsvariantes Verhalten der Komponenten:

\begin{itemize}
	\item Wenn sich das System derzeit nicht bewegt, muss nichts weiter unternommen werden
	\item Wenn sich das System derzeit vorwärts bewegt müssen die Motoren zunächst auf Bremsen gesetzt werden, dieser Zustand muss für eine gewisse Zeit gehalten werden, möglicherweise abhängig von der vorherigen Geschwindigkeit, anschließend kann die Motorsteuerung in einen Idle Zustand gesetzt werden.
\end{itemize}

Dieses Verhalten kann selbstverständlich sequentiell mit einer Wartezeit implementiert werden, im Arduino Befehlssatz wäre dies ein \texttt{delay(unsigned milliseconds);} Befehl. Ein solches Delay hat aber den Nachteil, dass alle weiteren Aufgaben während dieser Wartezeit ebenfalls unterbrochen werden und die Ansteuerung nicht responsiv ist.

Eine Lösung für dieses Verhalten, die im vorliegenden Projekt so implementiert wurde, ist eine State-Machine mit automatischen und zeitabhängigen Zustandswechseln. In der Hauptroutine wird nach dem Auswerten aller Sensordaten für die Motorsteuerung lediglich die Absicht gesetzt, z.B. \texttt{motor\_control.stop();}. Die Methode Stop setzt dann wiederum nur einen internen Zustandsautomaten auf einen \texttt{Stop} Zustand. Unabhängig von der gesetzten Absicht wird mit jeder Iteration der Hauptroutine eine \texttt{motor\_control.update();} Methode aus der Hauptroutine aufgerufen, in der die eigentlichen Änderungen vorgenommen werden. Hier wird dem Zustand entsprechend weiter vorgegangen:

\begin{itemize}
	\item Wenn \texttt{Zustand == Stop}, dann setze Motoren auf Bremsen, speichere den aktuellen Zeitstempel in \texttt{\_stop\_begin} und setze Zustand auf \texttt{Stopping}.
	\item Wenn \texttt{Zustand == Stopping}, dann prüfe ob aktueller Zeitstempel größer als \texttt{\_stop\_begin + \_stop\_duration} ist. Falls nein return. Falls ja, dann setze Motoren auf Idle und setze Zustand auf \texttt{Idle}.
\end{itemize}

Durch eine solche interne Logik bedarf es keiner Delays, alle Komponenten bleiben responsiv und es wird dennoch nur wirklich mit der Hardware interagiert, wenn es notwendig ist. In der Praxis wird dies etwas komplexer durch die folgenden gespeicherten Zustände implementiert:
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
