Project-CoasterBot/coasterbot/M4_Test-und-Validierung/Mechanikkonzept/Technische Zeichnungen/Nacharbeit.pdf

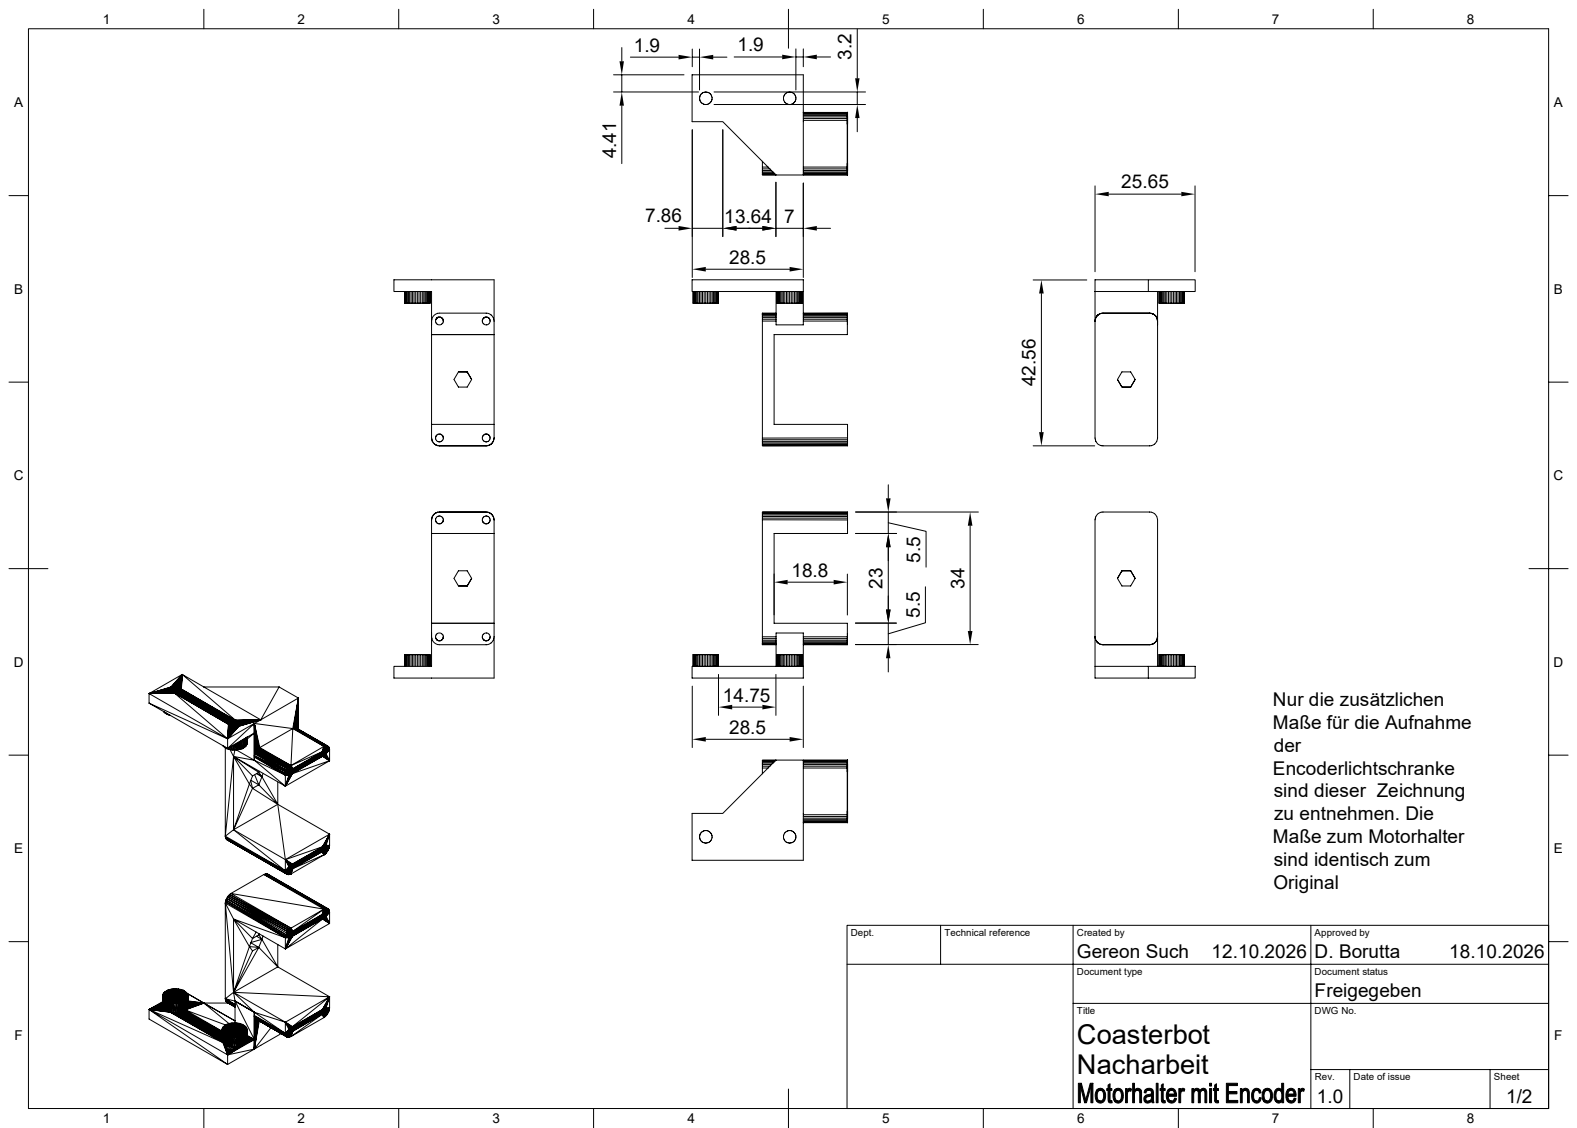
[picture p245: page 1]
8 BCDEF; ABCDEF Dept.; Technical reference; Created by; Approved by Document type; Document status Title; DWG No. Rev.; Date of issue; Sheet 1.0 Freigegeben 12.10.2026; 18.10.2026 1/2 Nacharbeit Coasterbot Gereon Such; D. Borutta

4.41 Nur die zusätzlichen Maße für die Aufnahme der Encoderlichtschranke sind dieser Zeichnung zu entnehmen. Die Maße zum Motorhalter sind identisch zum Original

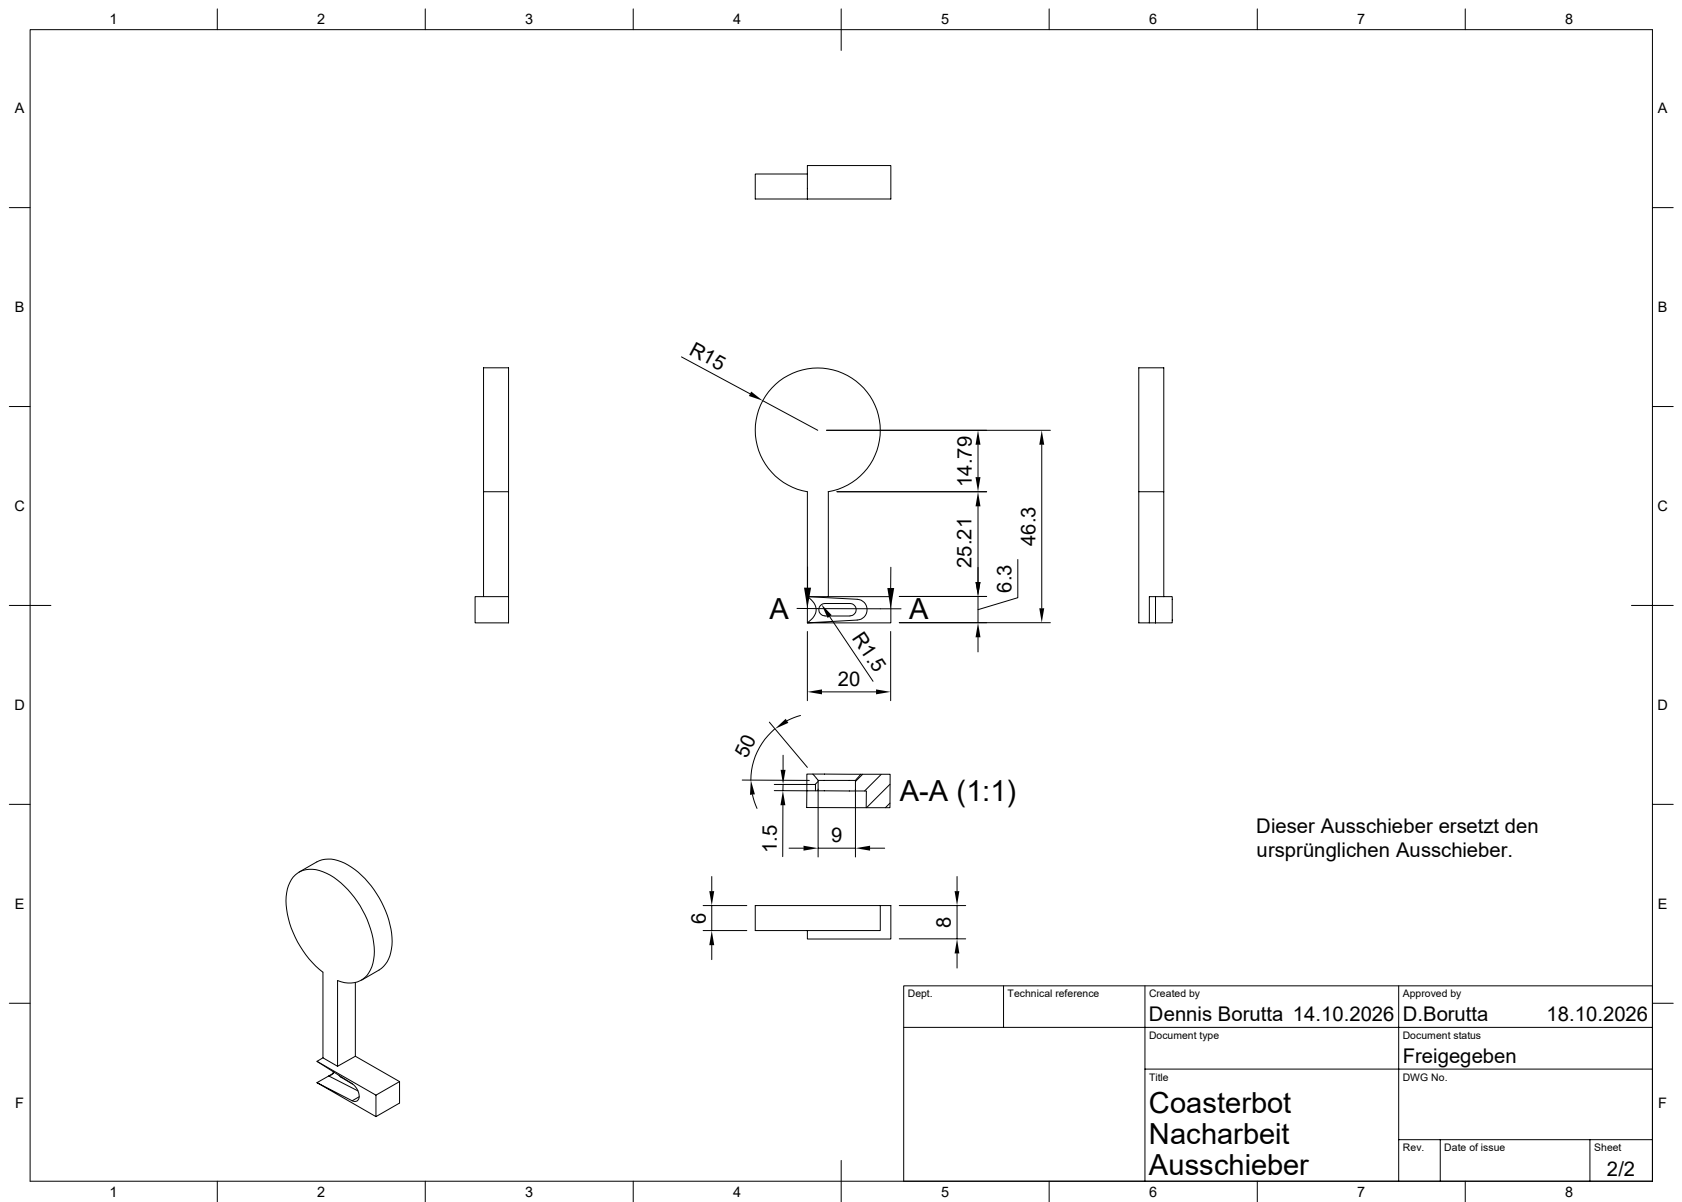
[picture p246: page 2]
8 BCDEF; ABCDEF Dept.; Technical reference; Created by; Approved by Document type; Document status Title; DWG No. Rev.; Date of issue; Sheet Ausschieber; Freigegeben 14.10.2026; 18.10.2026 2/2 Nacharbeit Coasterbot Dennis Borutta; D.Borutta

1.59 Dieser Ausschieber ersetzt den ursprünglichen Ausschieber.
