Project-CoasterBot/coasterbot/M4_Test-und-Validierung/Mechanikkonzept/Technische Zeichnungen/Untersetzer.pdf

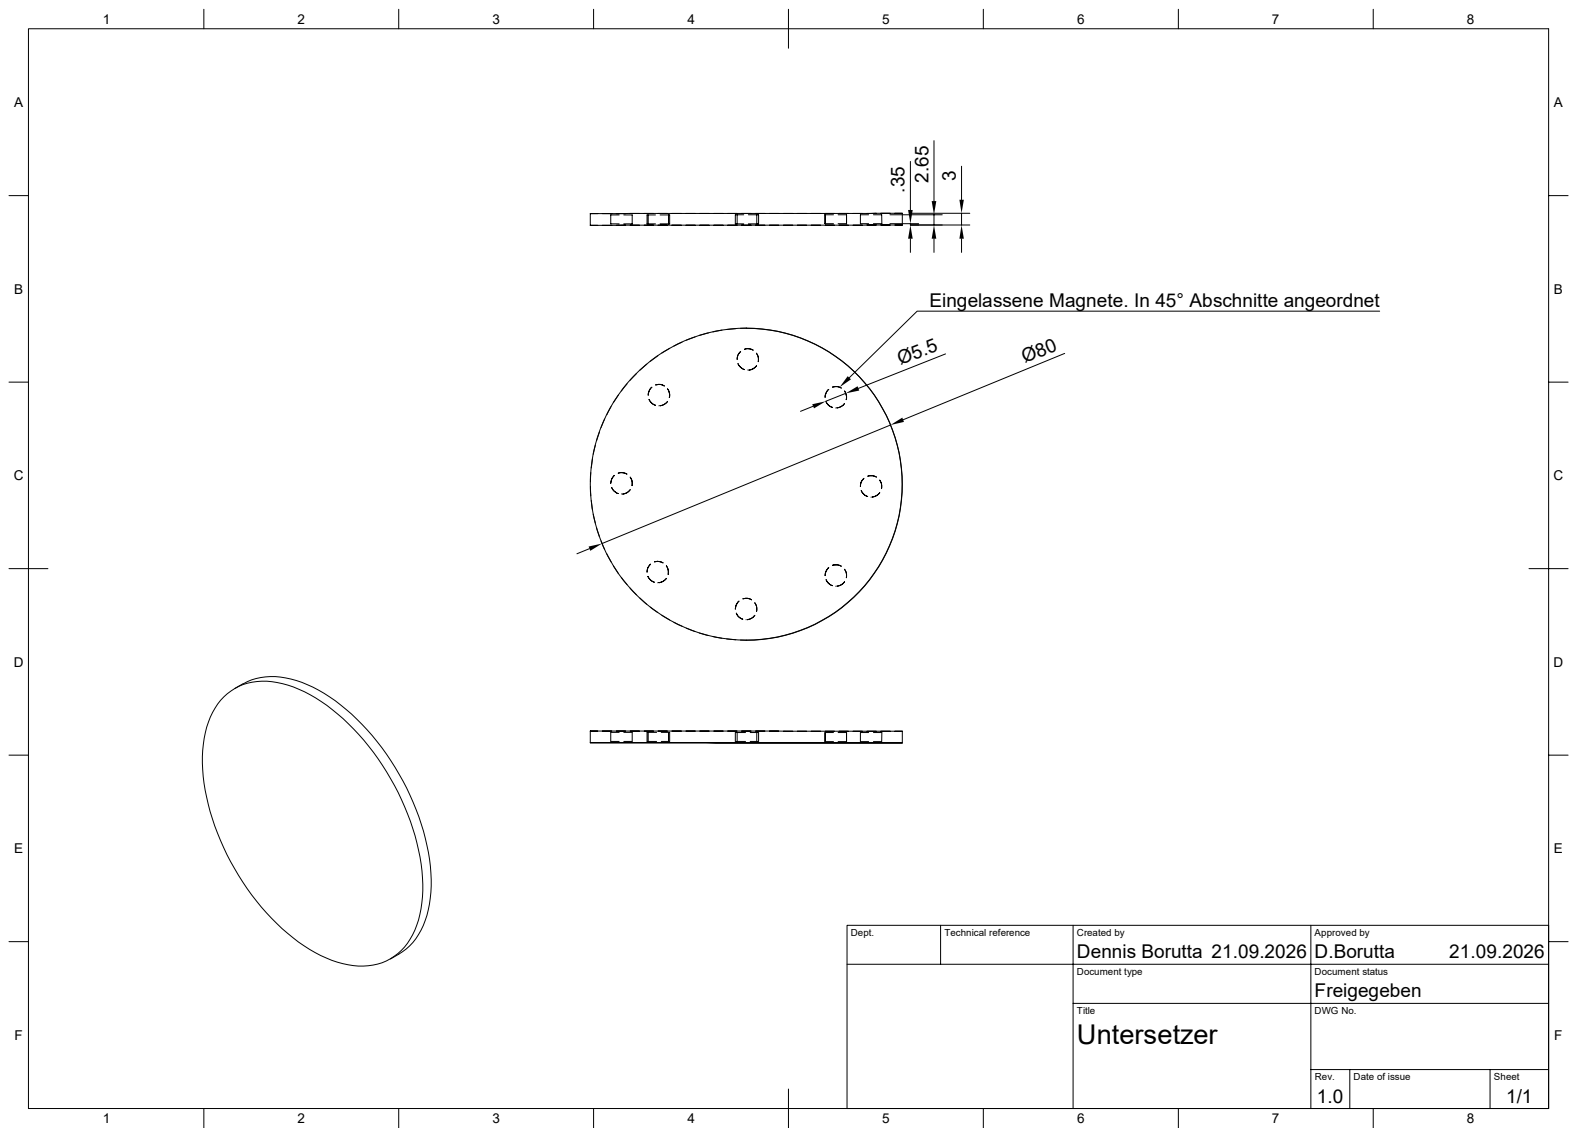
[picture p247: page 1]
8 BCDEF; ABCDEF Dept.; Technical reference; Created by; Approved by Document type; Document status Title; DWG No. Rev.; Date of issue; Sheet 1.0 Freigegeben 21.09.2026; 21.09.2026 1/1 Untersetzer Dennis Borutta; D.Borutta Ø80 Ø5.5 ³

2.65 Eingelassene Magnete. In 45° Abschnitte angeordnet
