Project-CoasterBot/coasterbot/M4_Test-und-Validierung/Mechanikkonzept/Technische Zeichnungen/Einzelzeichnungen/01_Nacharbeit_Encoderaufnahme.pdf

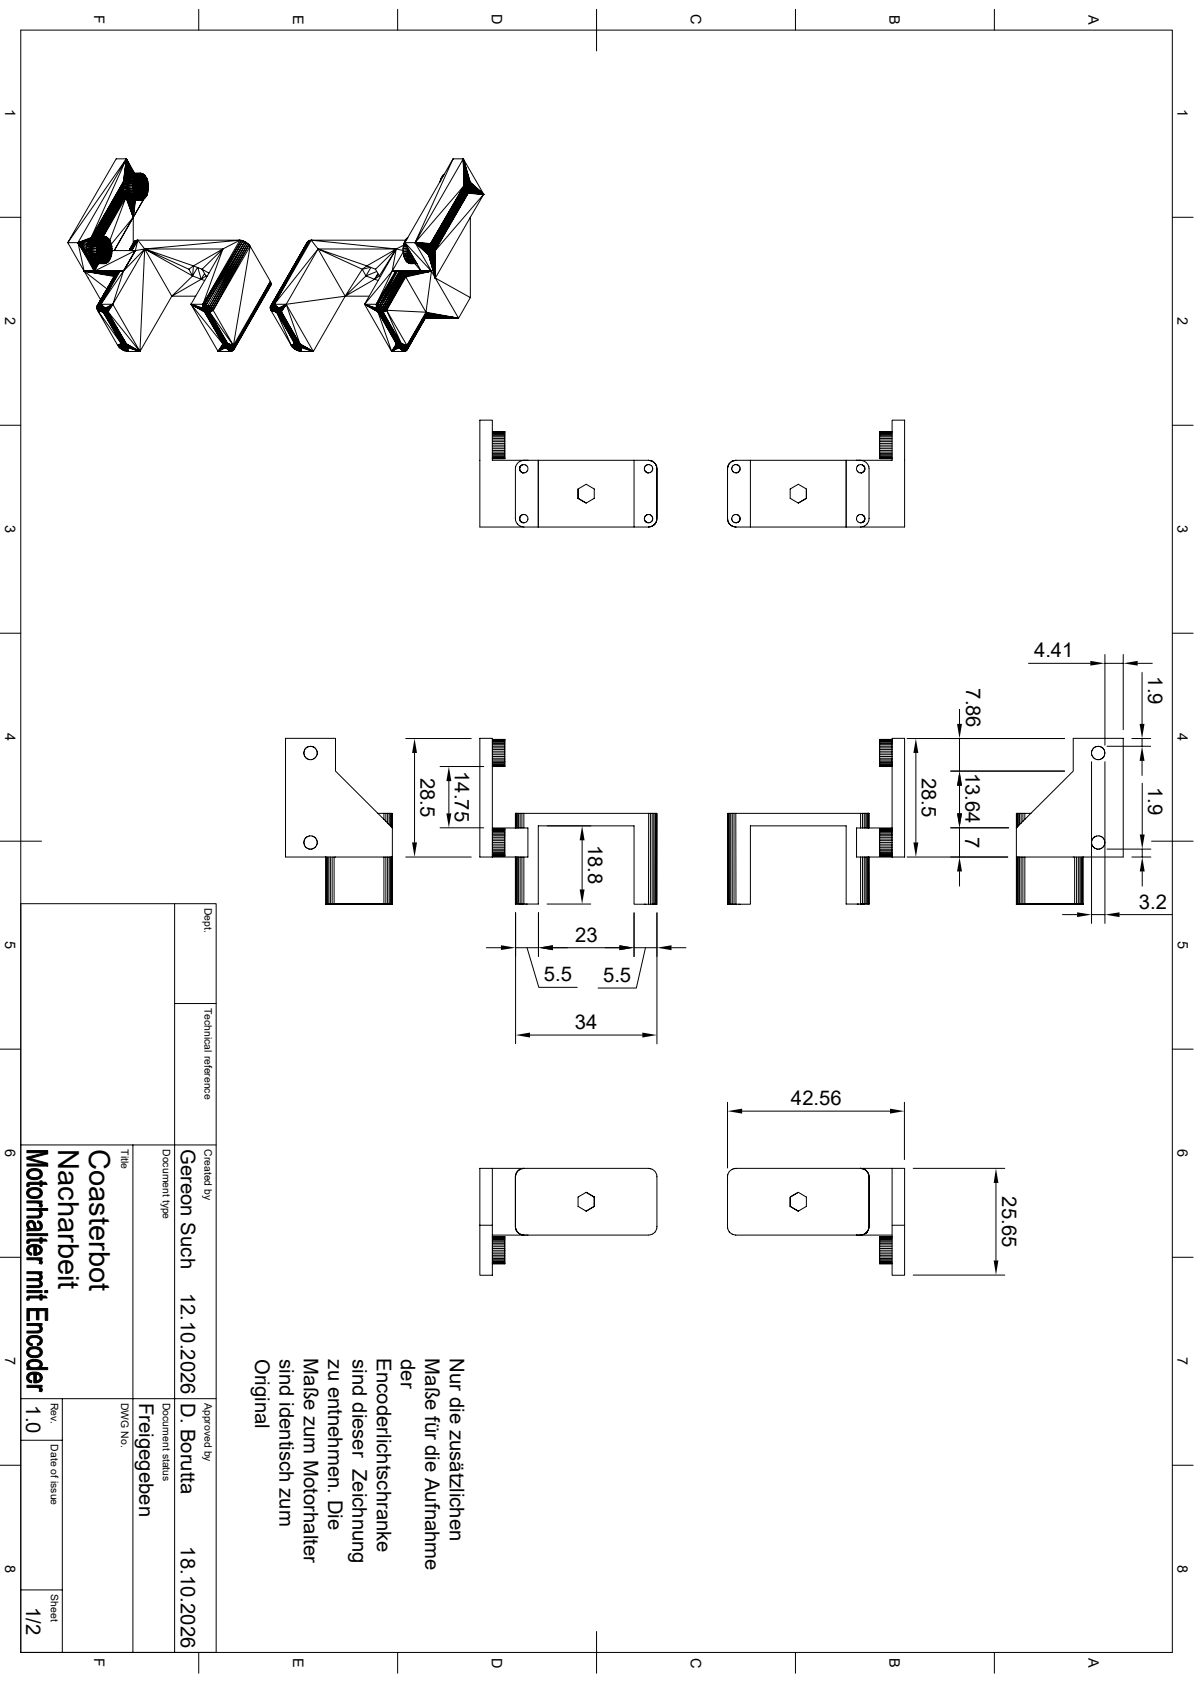
[picture p248: page 1]

1 A 2 3 4 5 6 7 8 1 2 3 4 5 6 7 8 FEDCB FEDCBA Dept. Technical reference Created by Approved by Title DWG No. Document type Document status 1.0 Rev. Date of issue Sheet Freigegeben 18.10.2026 12.10.2026 1/2 Nacharbeit Coasterbot D. Borutta Gereon Such

4.41 Original sind identisch zum Maße zum Motorhalter zu entnehmen. Die sind dieser Zeichnung Encoderlichtschranke der Maße für die Aufnahme Nur die zusätzlichen
