Project-CoasterBot/coasterbot/M4_Test-und-Validierung/Mechanikkonzept/Technische Zeichnungen/Einzelzeichnungen/09_Coasterbot_Motorhalter.pdf

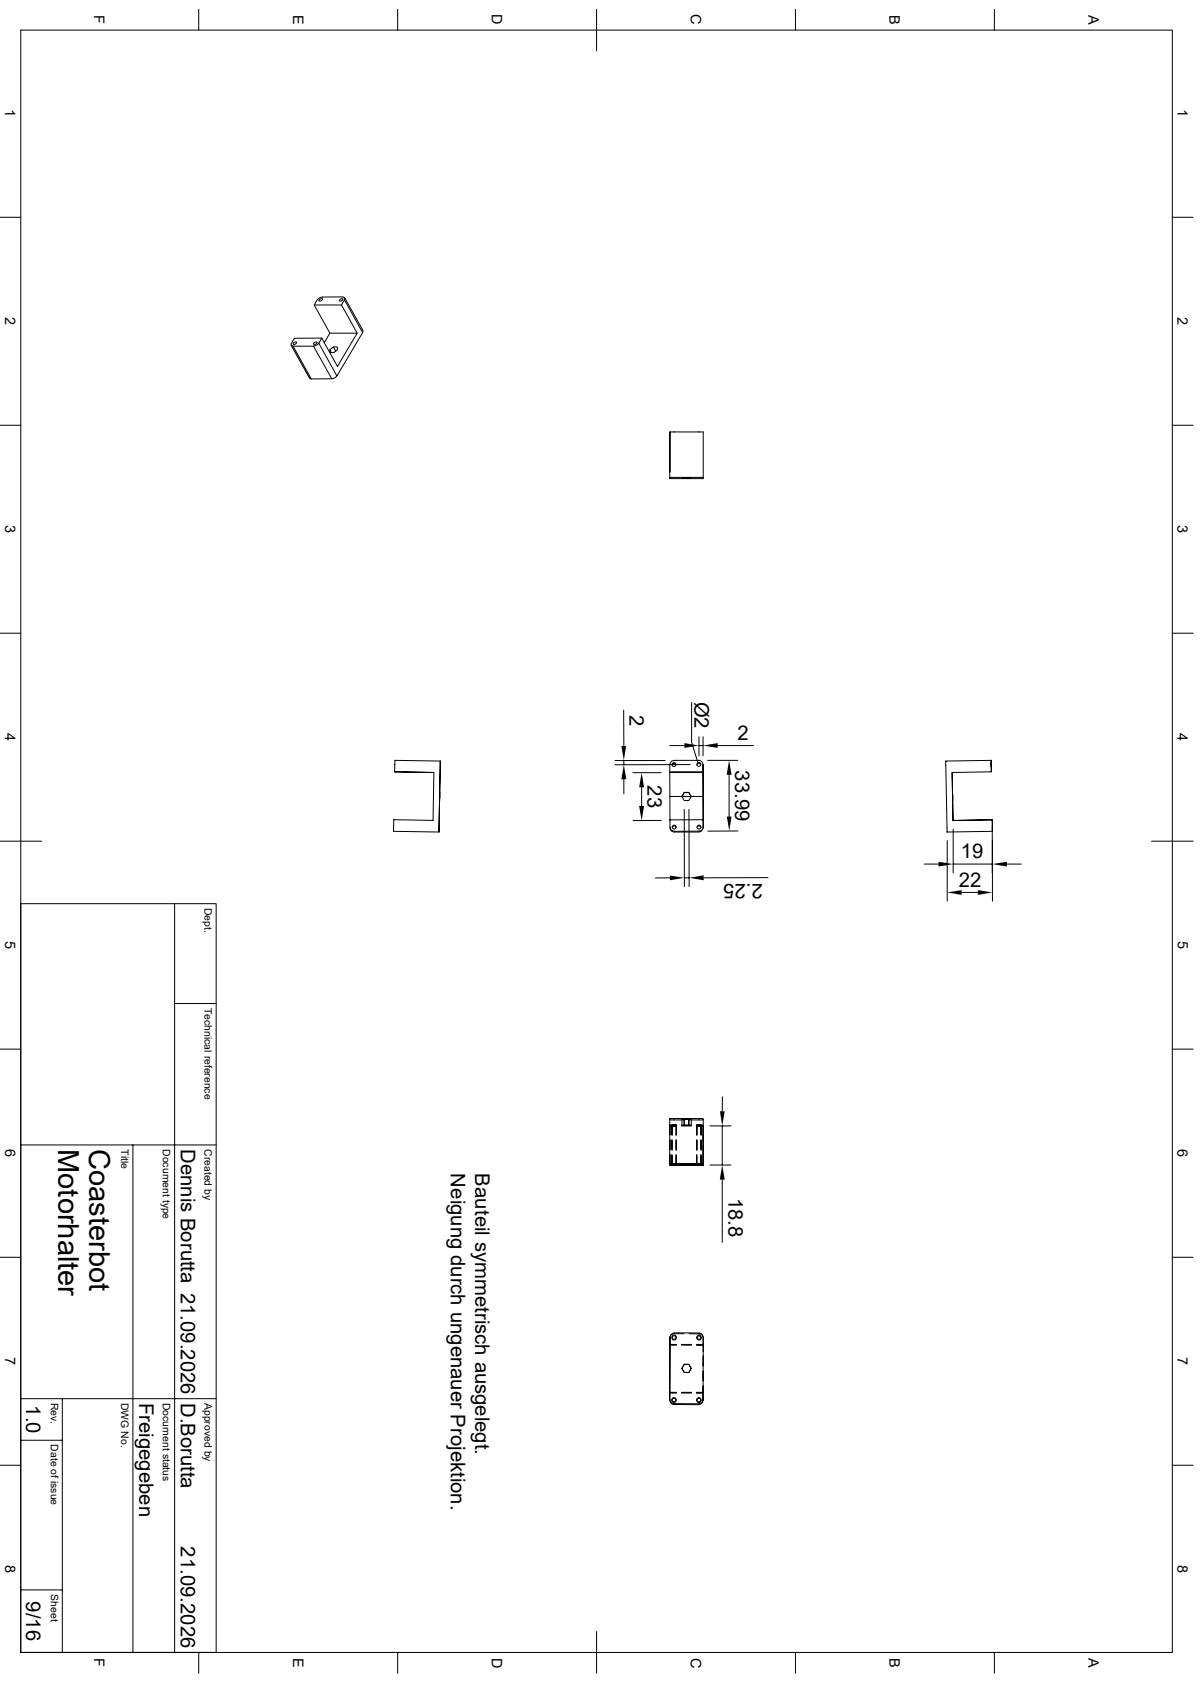
[picture p249: page 1]

1 A 2 3 4 5 6 7 8 1 2 3 4 5 6 7 8 FEDCB FEDCBA Dept. Technical reference Created by Approved by Title DWG No. Document type Document status 1.0 Rev. Date of issue Sheet Freigegeben 21.09.2026 21.09.2026 9/16 Motorhalter Coasterbot D.Borutta Dennis Borutta Neigung durch ungenauer Projektion. Bauteil symmetrisch ausgelegt. 33.99 23
