Project-CoasterBot/coasterbot/M4_Test-und-Validierung/Mechanikkonzept/Technische Zeichnungen/Einzelzeichnungen/12_Coasterbot_Ausgabemechanik_Stempel.pdf

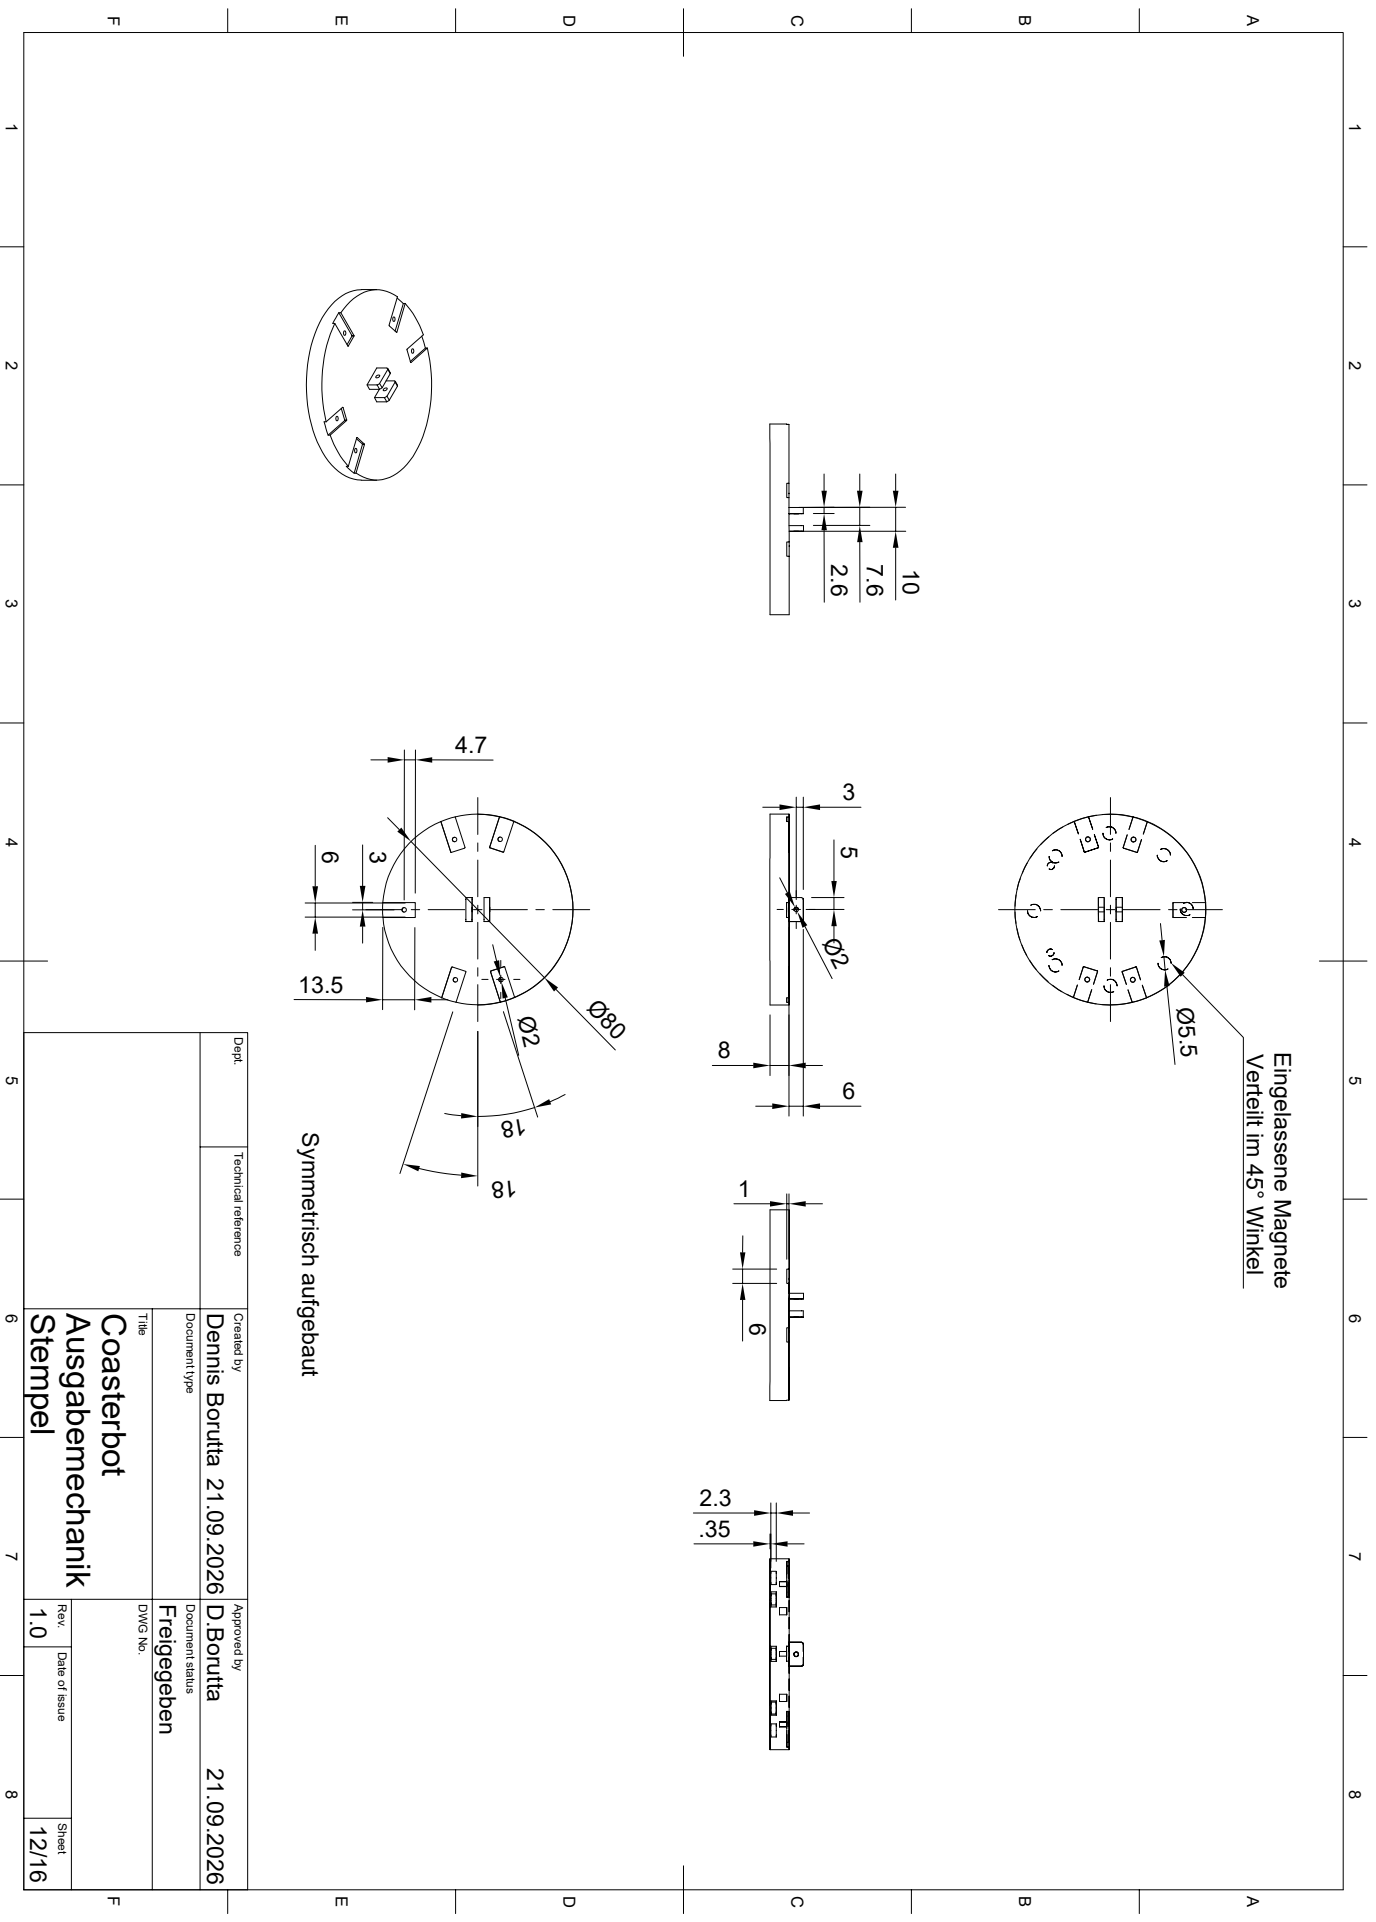
[picture p250: page 1]
Verteilt im 45° Winkel Eingelassene Magnete 16 Ø2; 4.7 3 Symmetrisch aufgebaut

1 A 2 3 4 5 6 7 8 1 2 3 4 5 6 7 8 FEDCB FEDCBA Dept. Technical reference Created by Approved by Title DWG No. Document type Document status 1.0 Rev. Date of issue Sheet Stempel Freigegeben 21.09.2026 21.09.2026 12/16 Ausgabemechanik Coasterbot D.Borutta Dennis Borutta Ø5.5
