Project-CoasterBot/coasterbot/M4_Test-und-Validierung/Mechanikkonzept/Technische Zeichnungen/Einzelzeichnungen/02_Nacharbeit_Ausschieber.pdf

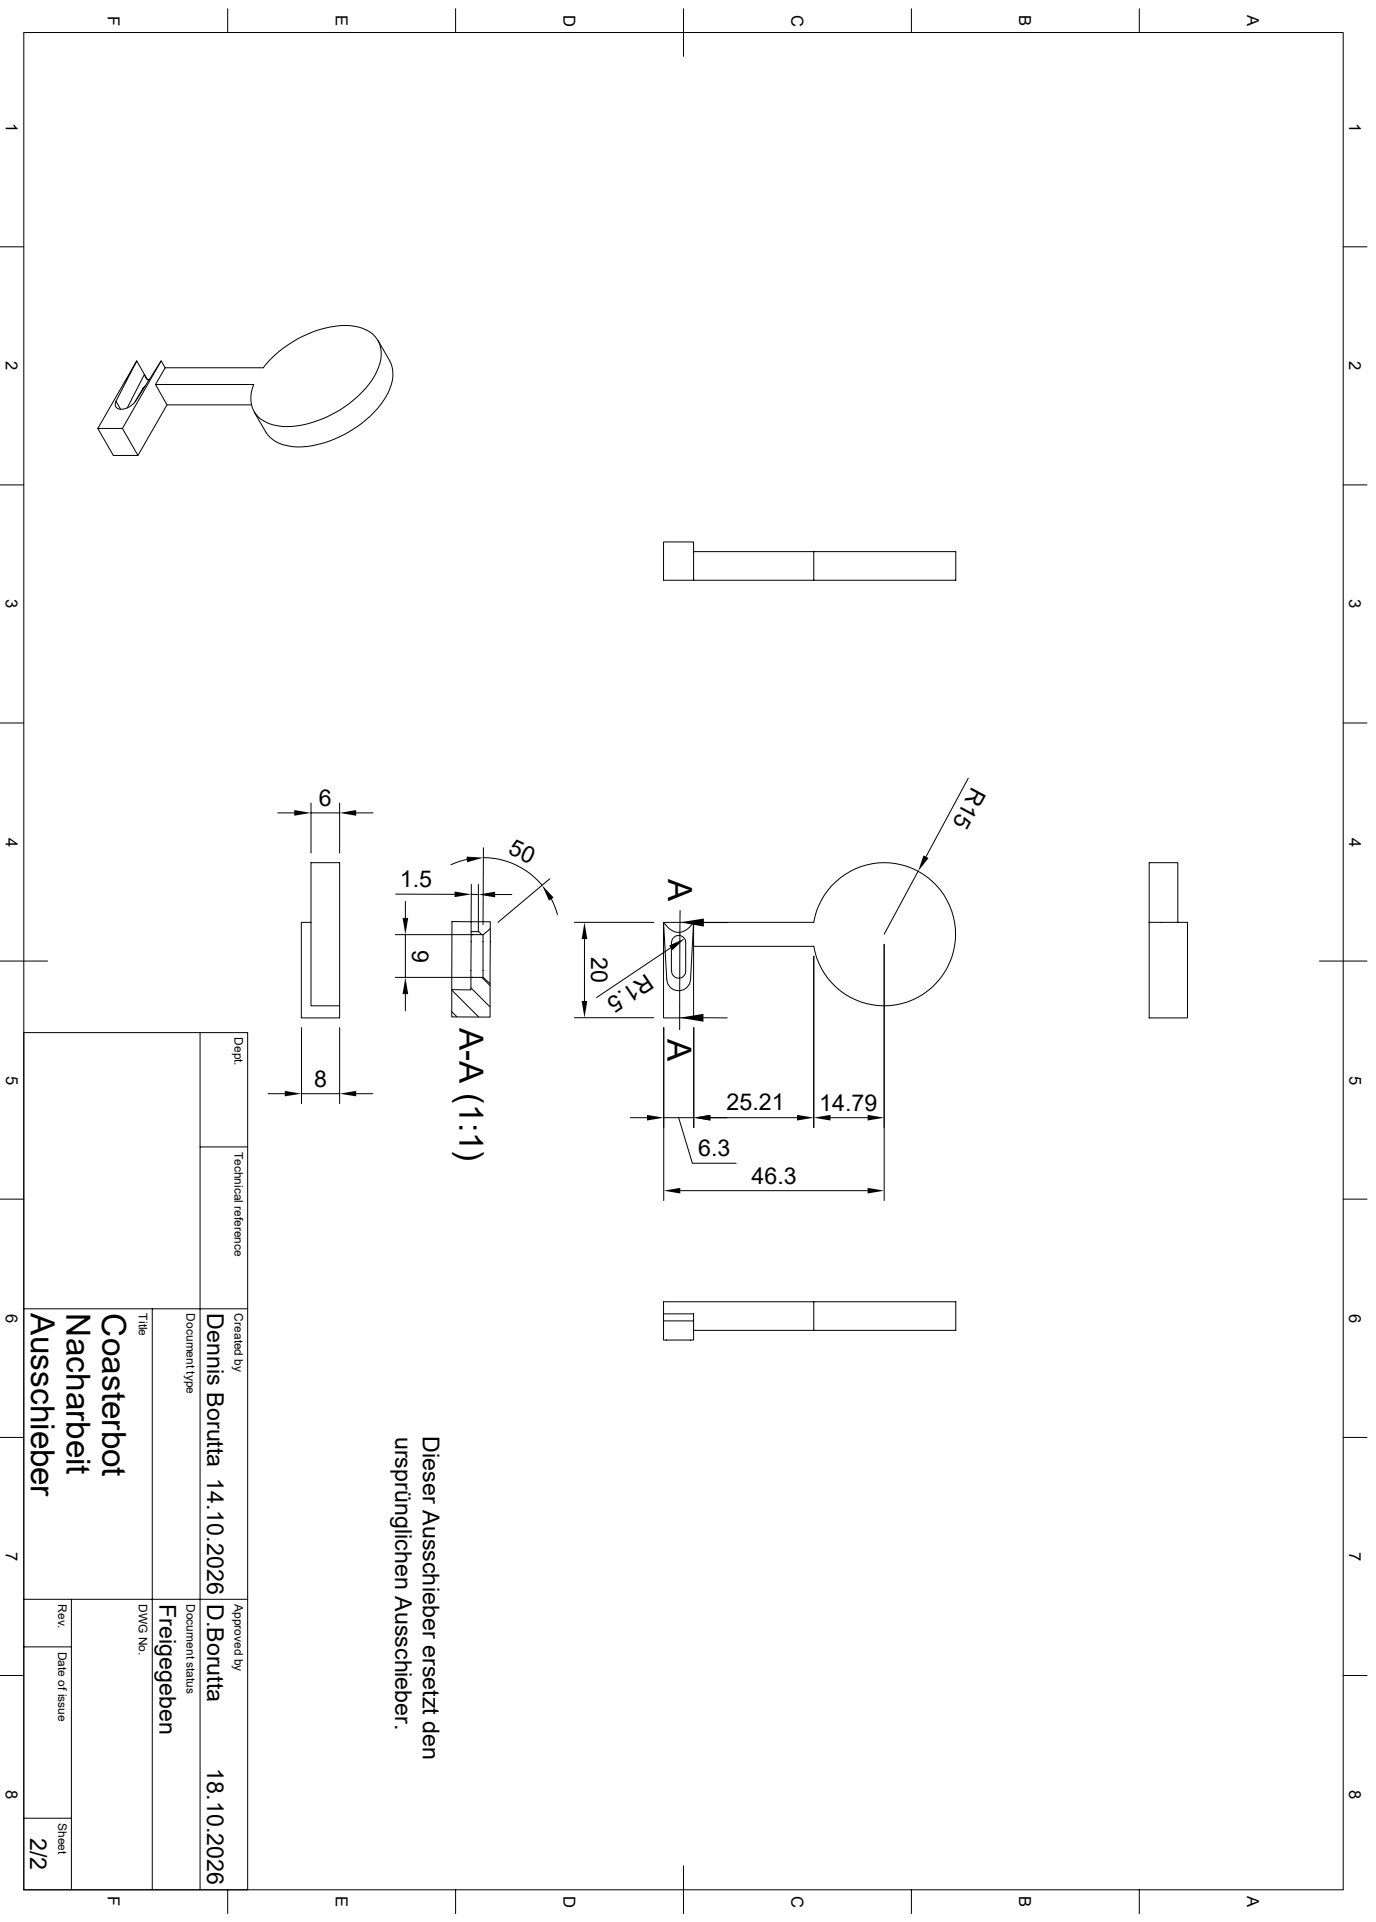
[picture p251: page 1]

1 A 2 3 4 5 6 7 8 1 2 3 4 5 6 7 8 FEDCB FEDCBA Dept. Technical reference Created by Approved by Title DWG No. Document type Document status Rev. Date of issue Sheet Ausschieber Freigegeben 18.10.2026 14.10.2026 2/2 Nacharbeit Coasterbot D.Borutta Dennis Borutta

1.59 ursprünglichen Ausschieber. Dieser Ausschieber ersetzt den
