Project-CoasterBot/coasterbot/M4_Test-und-Validierung/Mechanikkonzept/Technische Zeichnungen/Einzelzeichnungen/01_Coasterbot_Gesamtansicht.pdf

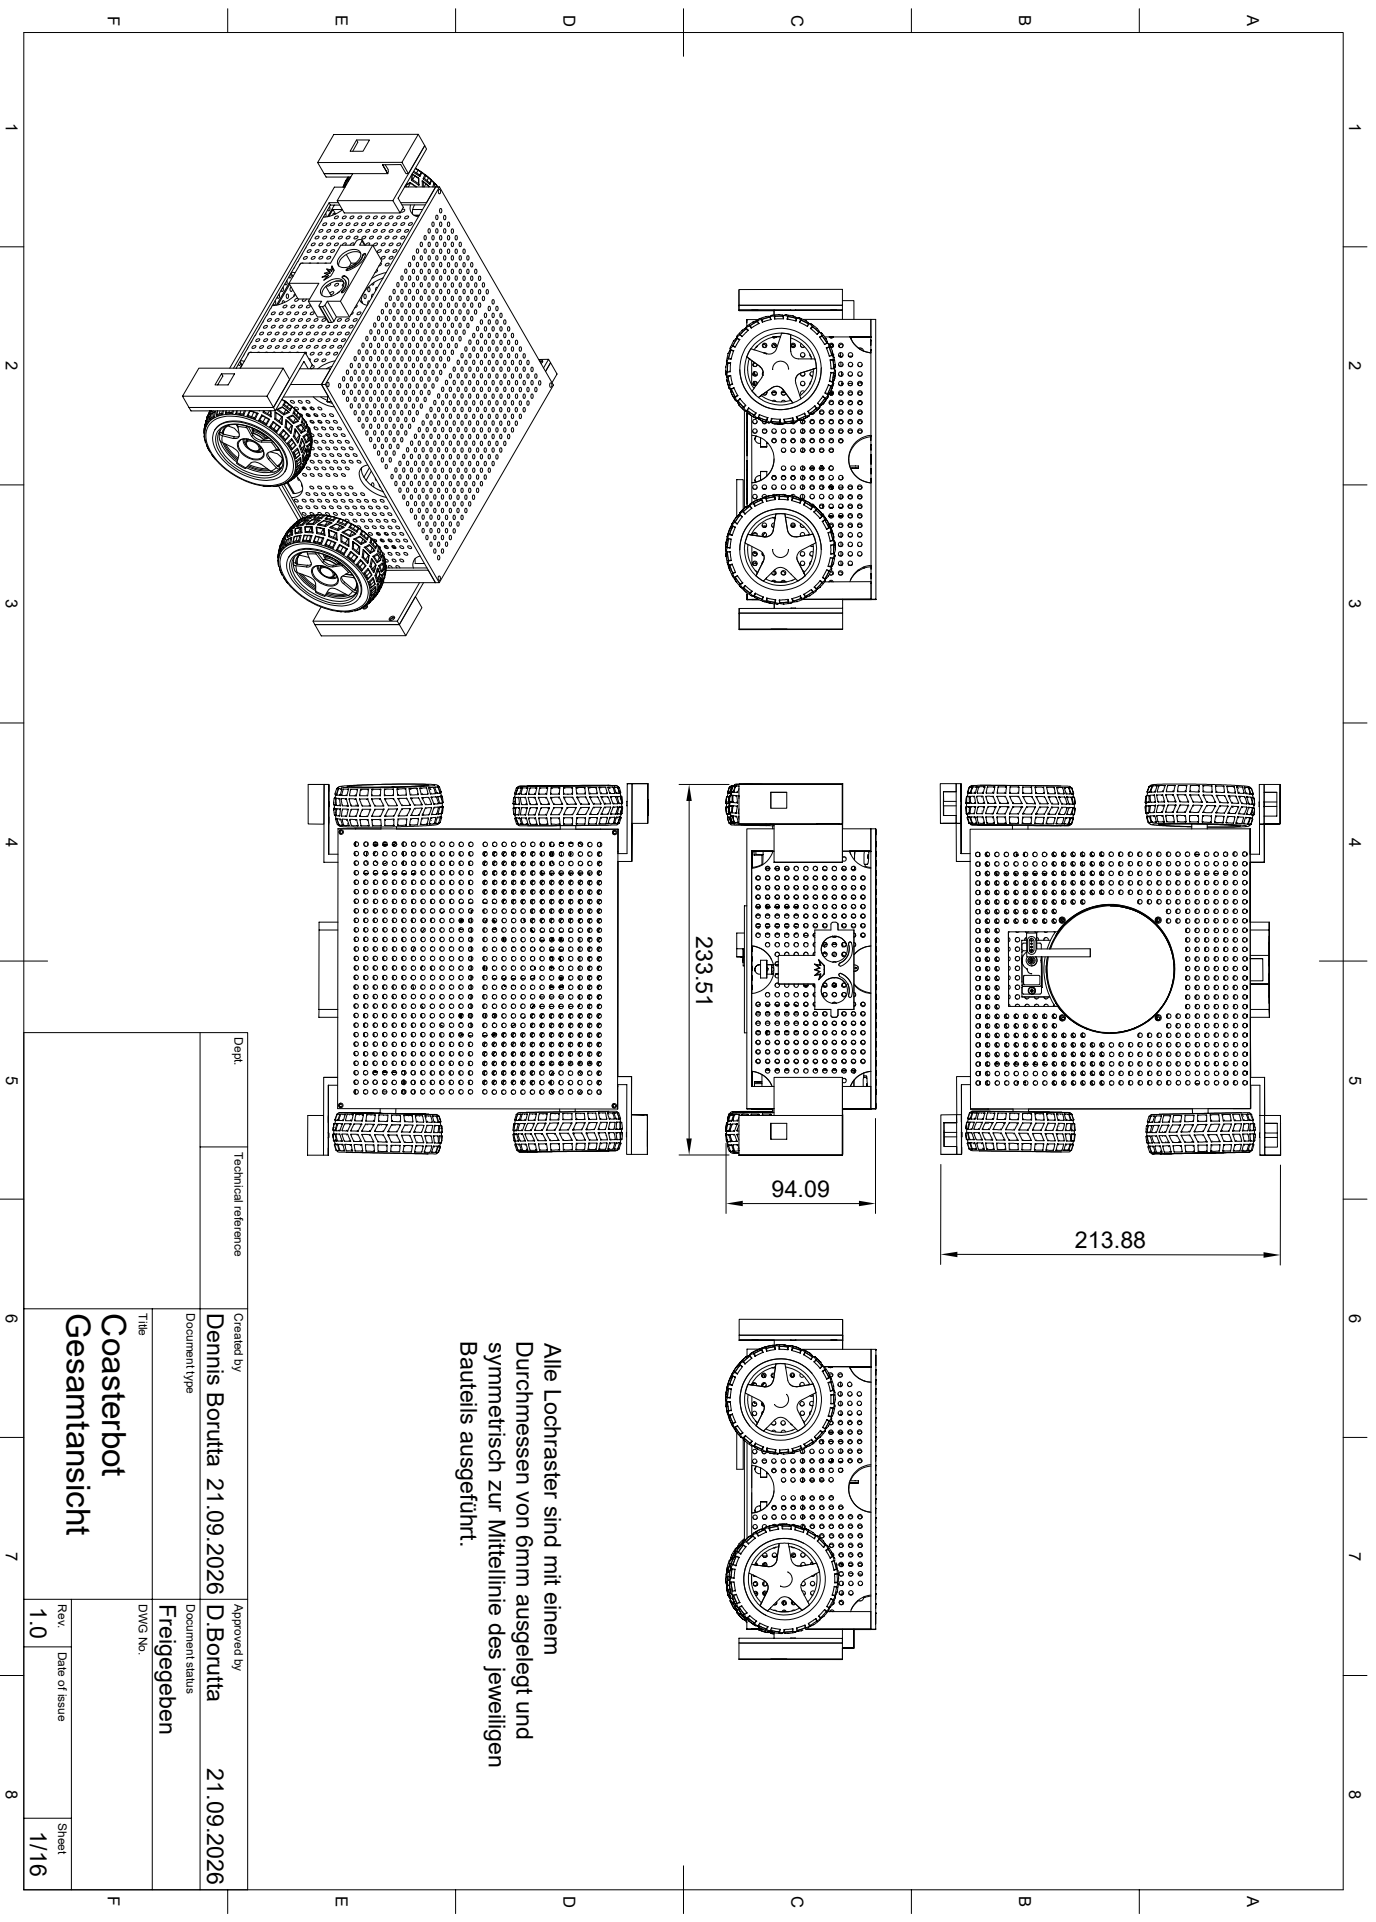
[picture p252: page 1]

1 A 2 3 4 5 6 7 8 1 2 3 4 5 6 7 8 FEDCB FEDCBA Dept. Technical reference Created by Approved by Title DWG No. Document type Document status 1.0 Rev. Date of issue Sheet Freigegeben 21.09.2026 21.09.2026 1/16 Gesamtansicht Coasterbot D.Borutta Dennis Borutta 233.51

213.88 Bauteils ausgeführt. symmetrisch zur Mittellinie des jeweiligen Durchmessen von 6mm ausgelegt und Alle Lochraster sind mit einem
