Project-CoasterBot/coasterbot/M4_Test-und-Validierung/Mechanikkonzept/Technische Zeichnungen/Einzelzeichnungen/02_Coasterbot_Außenwand_Motor.pdf

77 | R9 R9 A | A A-A (1:3) 3.6 1 2

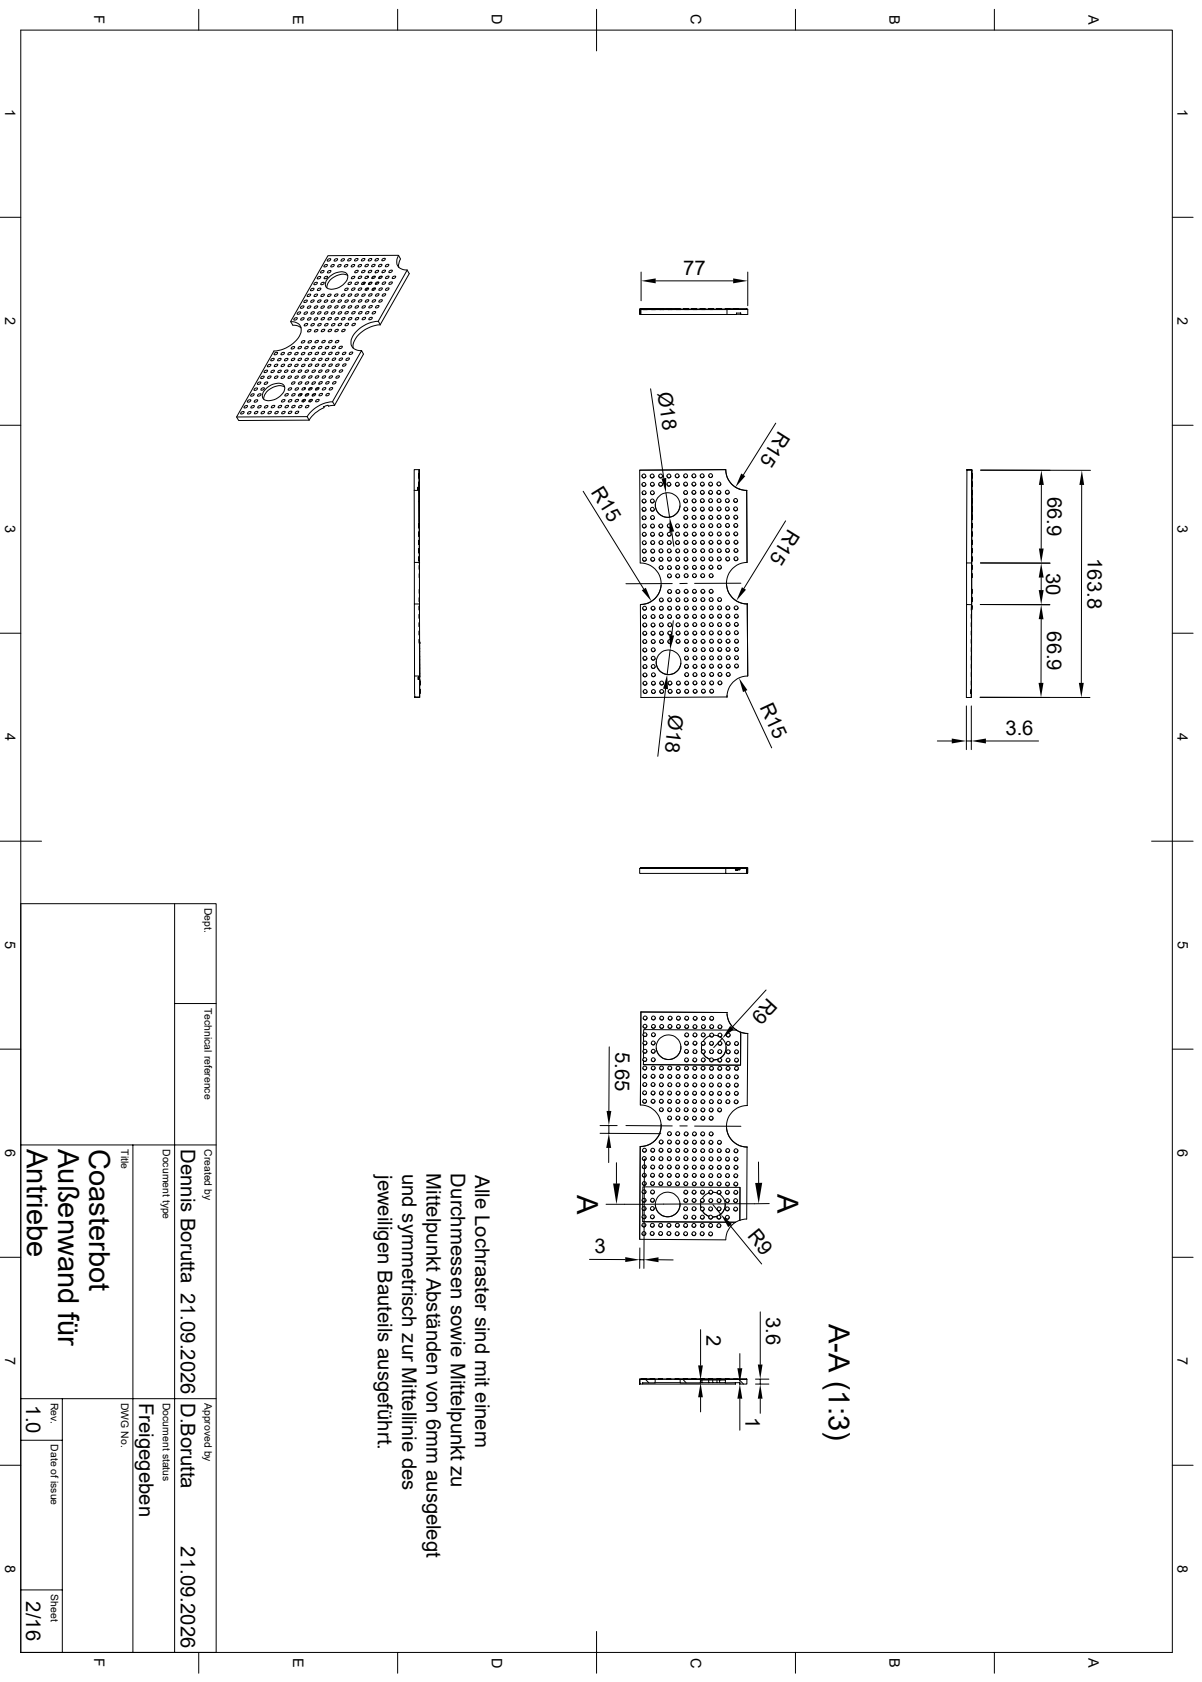
[picture p253: page 1]

1 A 2 3 4 5 6 7 8 1 2 3 4 5 6 7 8 FEDCB FEDCBA Dept. Technical reference Created by Approved by Title DWG No. Document type Document status 1.0 Rev. Date of issue Sheet Antriebe Freigegeben 21.09.2026 21.09.2026 2/16 Außenwand für Coasterbot D.Borutta Dennis Borutta jeweiligen Bauteils ausgeführt. und symmetrisch zur Mittellinie des Mittelpunkt Abständen von 6mm ausgelegt Durchmessen sowie Mittelpunkt zu Alle Lochraster sind mit einem Ø18 R15 R15 Ø18 R15 R15
