Project-CoasterBot/coasterbot/M4_Test-und-Validierung/Mechanikkonzept/Technische Zeichnungen/Einzelzeichnungen/06_Coasterbot_Halter_Kantenerkennung.pdf

# 65 3 Bauteil gespiegelt. Maße identisch25

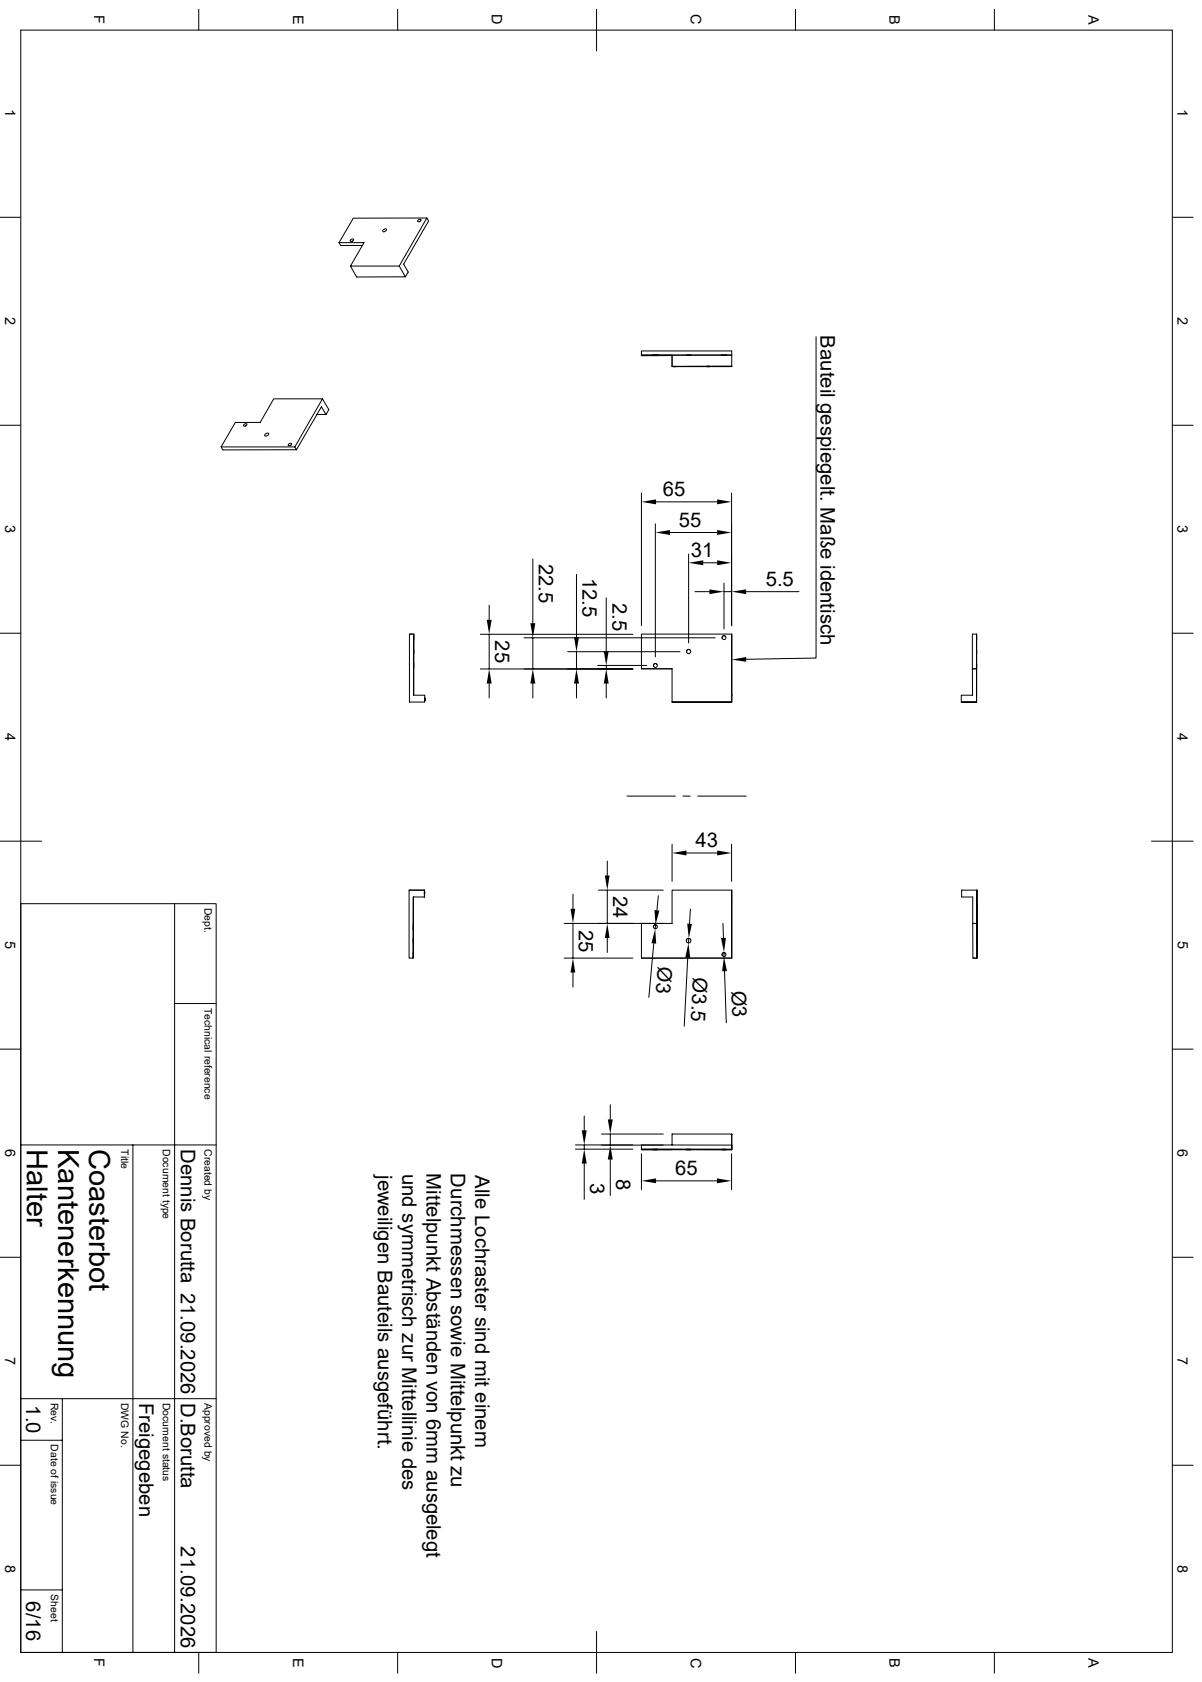
[picture p254: page 1]

1 A 2 3 4 5 6 7 8 1 2 3 4 5 6 7 8 FEDCB FEDCBA Dept. Technical reference Created by Approved by Title DWG No. Document type Document status 1.0 Rev. Date of issue Sheet Halter Freigegeben 21.09.2026 21.09.2026 6/16 Kantenerkennung Coasterbot D.Borutta Dennis Borutta jeweiligen Bauteils ausgeführt. und symmetrisch zur Mittellinie des Mittelpunkt Abständen von 6mm ausgelegt Durchmessen sowie Mittelpunkt zu Alle Lochraster sind mit einem Ø3.5 Ø3 Ø3 24 25
