Project-CoasterBot/coasterbot/M4_Test-und-Validierung/Mechanikkonzept/Technische Zeichnungen/Einzelzeichnungen/07_Coasterbot_Abdeckung_Kantenerkennung.pdf

65 25 | 2

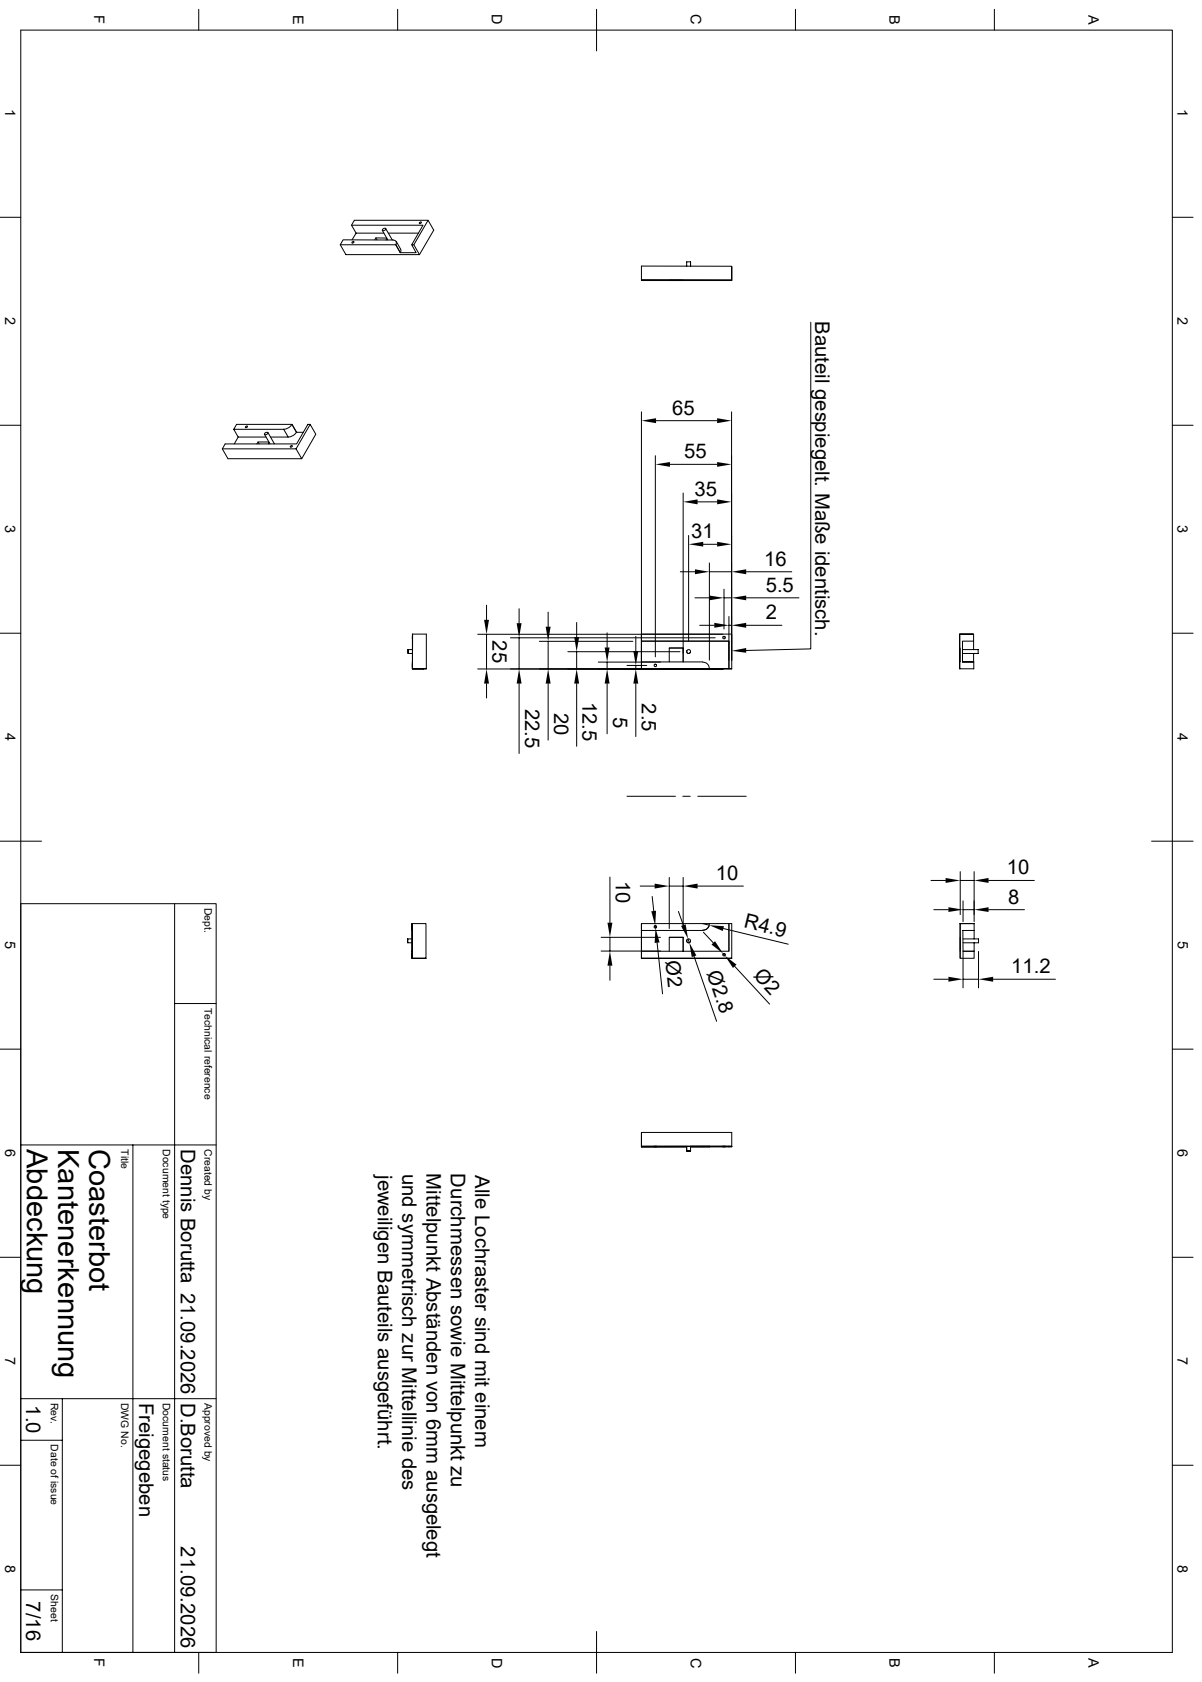
[picture p255: page 1]

1 A 2 3 4 5 6 7 8 1 2 3 4 5 6 7 8 FEDCB FEDCBA Dept. Technical reference Created by Approved by Title DWG No. Document type Document status 1.0 Rev. Date of issue Sheet Abdeckung Freigegeben 21.09.2026 21.09.2026 7/16 Kantenerkennung Coasterbot D.Borutta Dennis Borutta jeweiligen Bauteils ausgeführt. und symmetrisch zur Mittellinie des Mittelpunkt Abständen von 6mm ausgelegt Durchmessen sowie Mittelpunkt zu Alle Lochraster sind mit einem Bauteil gespiegelt. Maße identisch. Ø2.8Ø2 Ø2 10
