Project-CoasterBot/coasterbot/M4_Test-und-Validierung/Mechanikkonzept/Technische Zeichnungen/Einzelzeichnungen/11_Coasterbot_Ausgabemechanik_Gehause.pdf

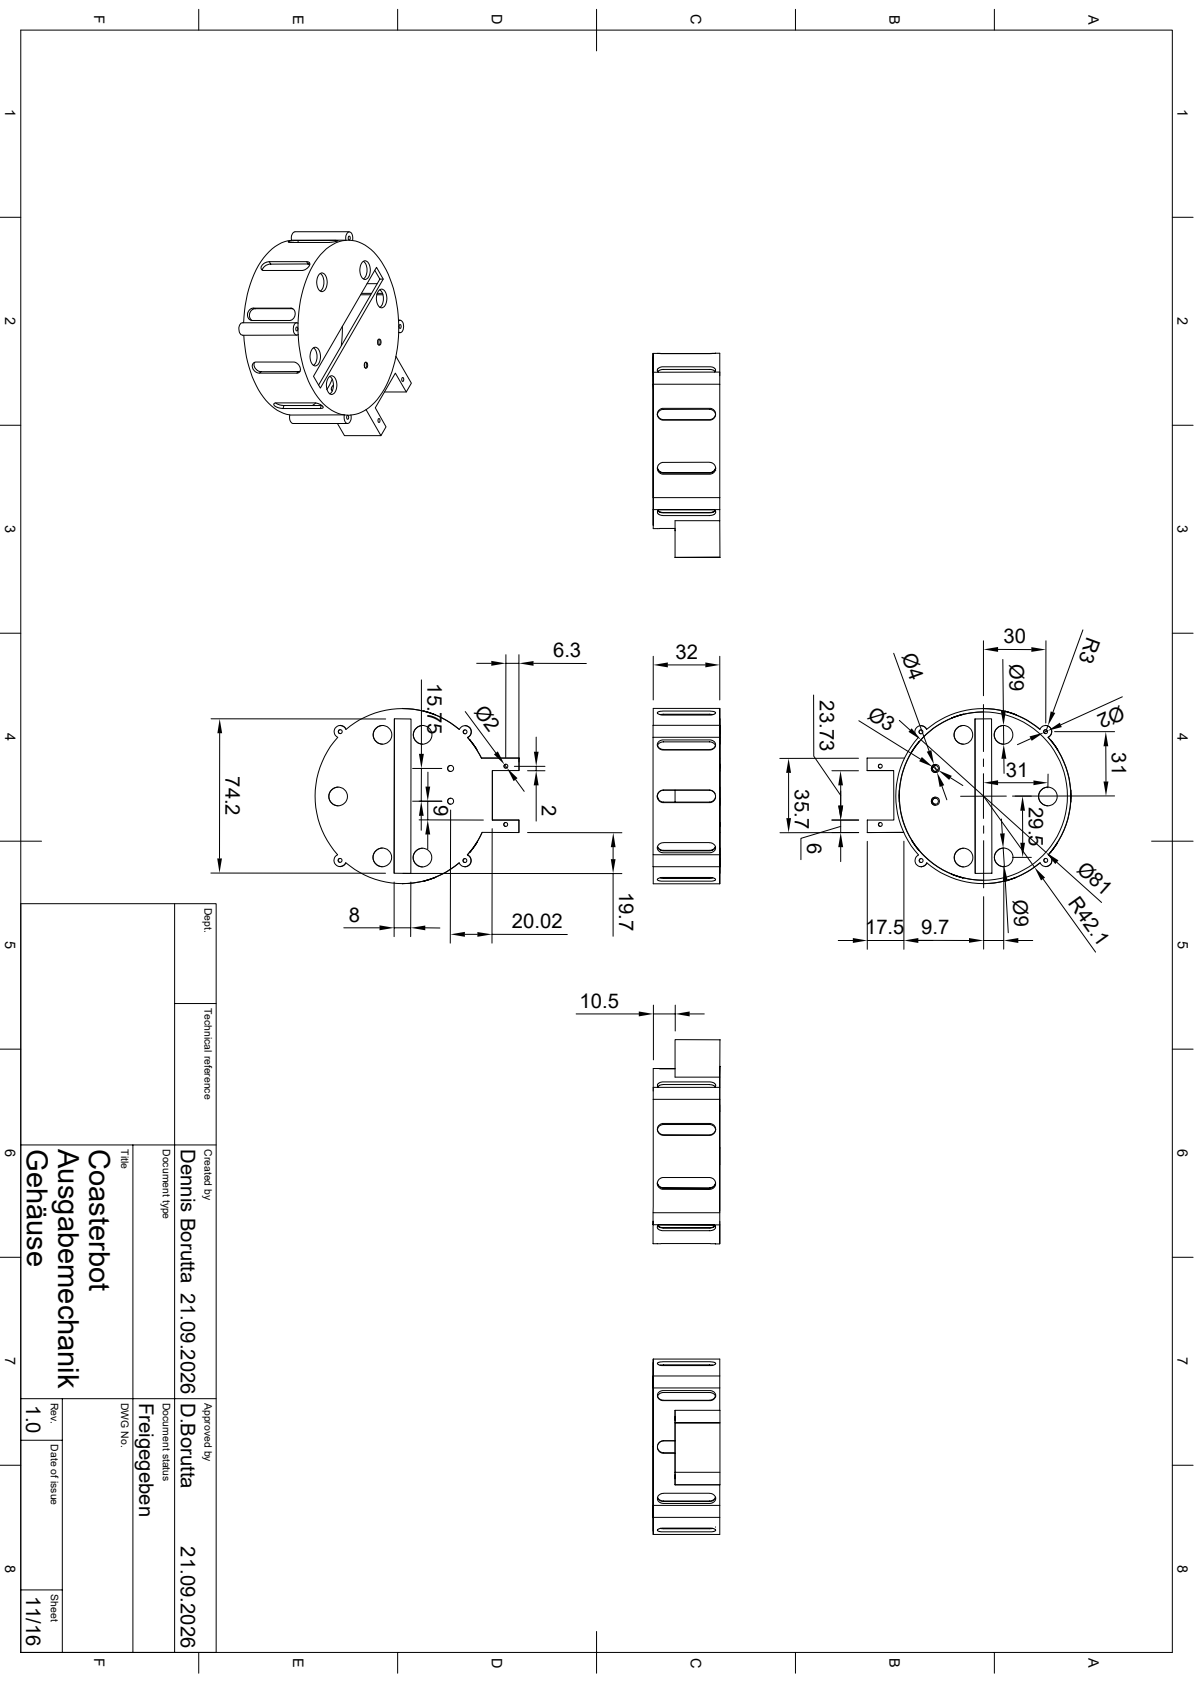
[picture p256: page 1]

1 A 2 3 4 5 6 7 8 1 2 3 4 5 6 7 8 FEDCB FEDCBA Dept. Technical reference Created by Approved by Title DWG No. Document type Document status 1.0 Rev. Date of issue Sheet Gehäuse Freigegeben 21.09.2026 21.09.2026 11/16 Ausgabemechanik Coasterbot D.Borutta Dennis Borutta Ø81R42.1 R3 Ø2 Ø3 Ø4 Ø9 Ø9
