Project-CoasterBot/coasterbot/M4_Test-und-Validierung/Mechanikkonzept/Technische Zeichnungen/Einzelzeichnungen/13_Coasterbot_Ausgabemechanik_Verbinder.pdf

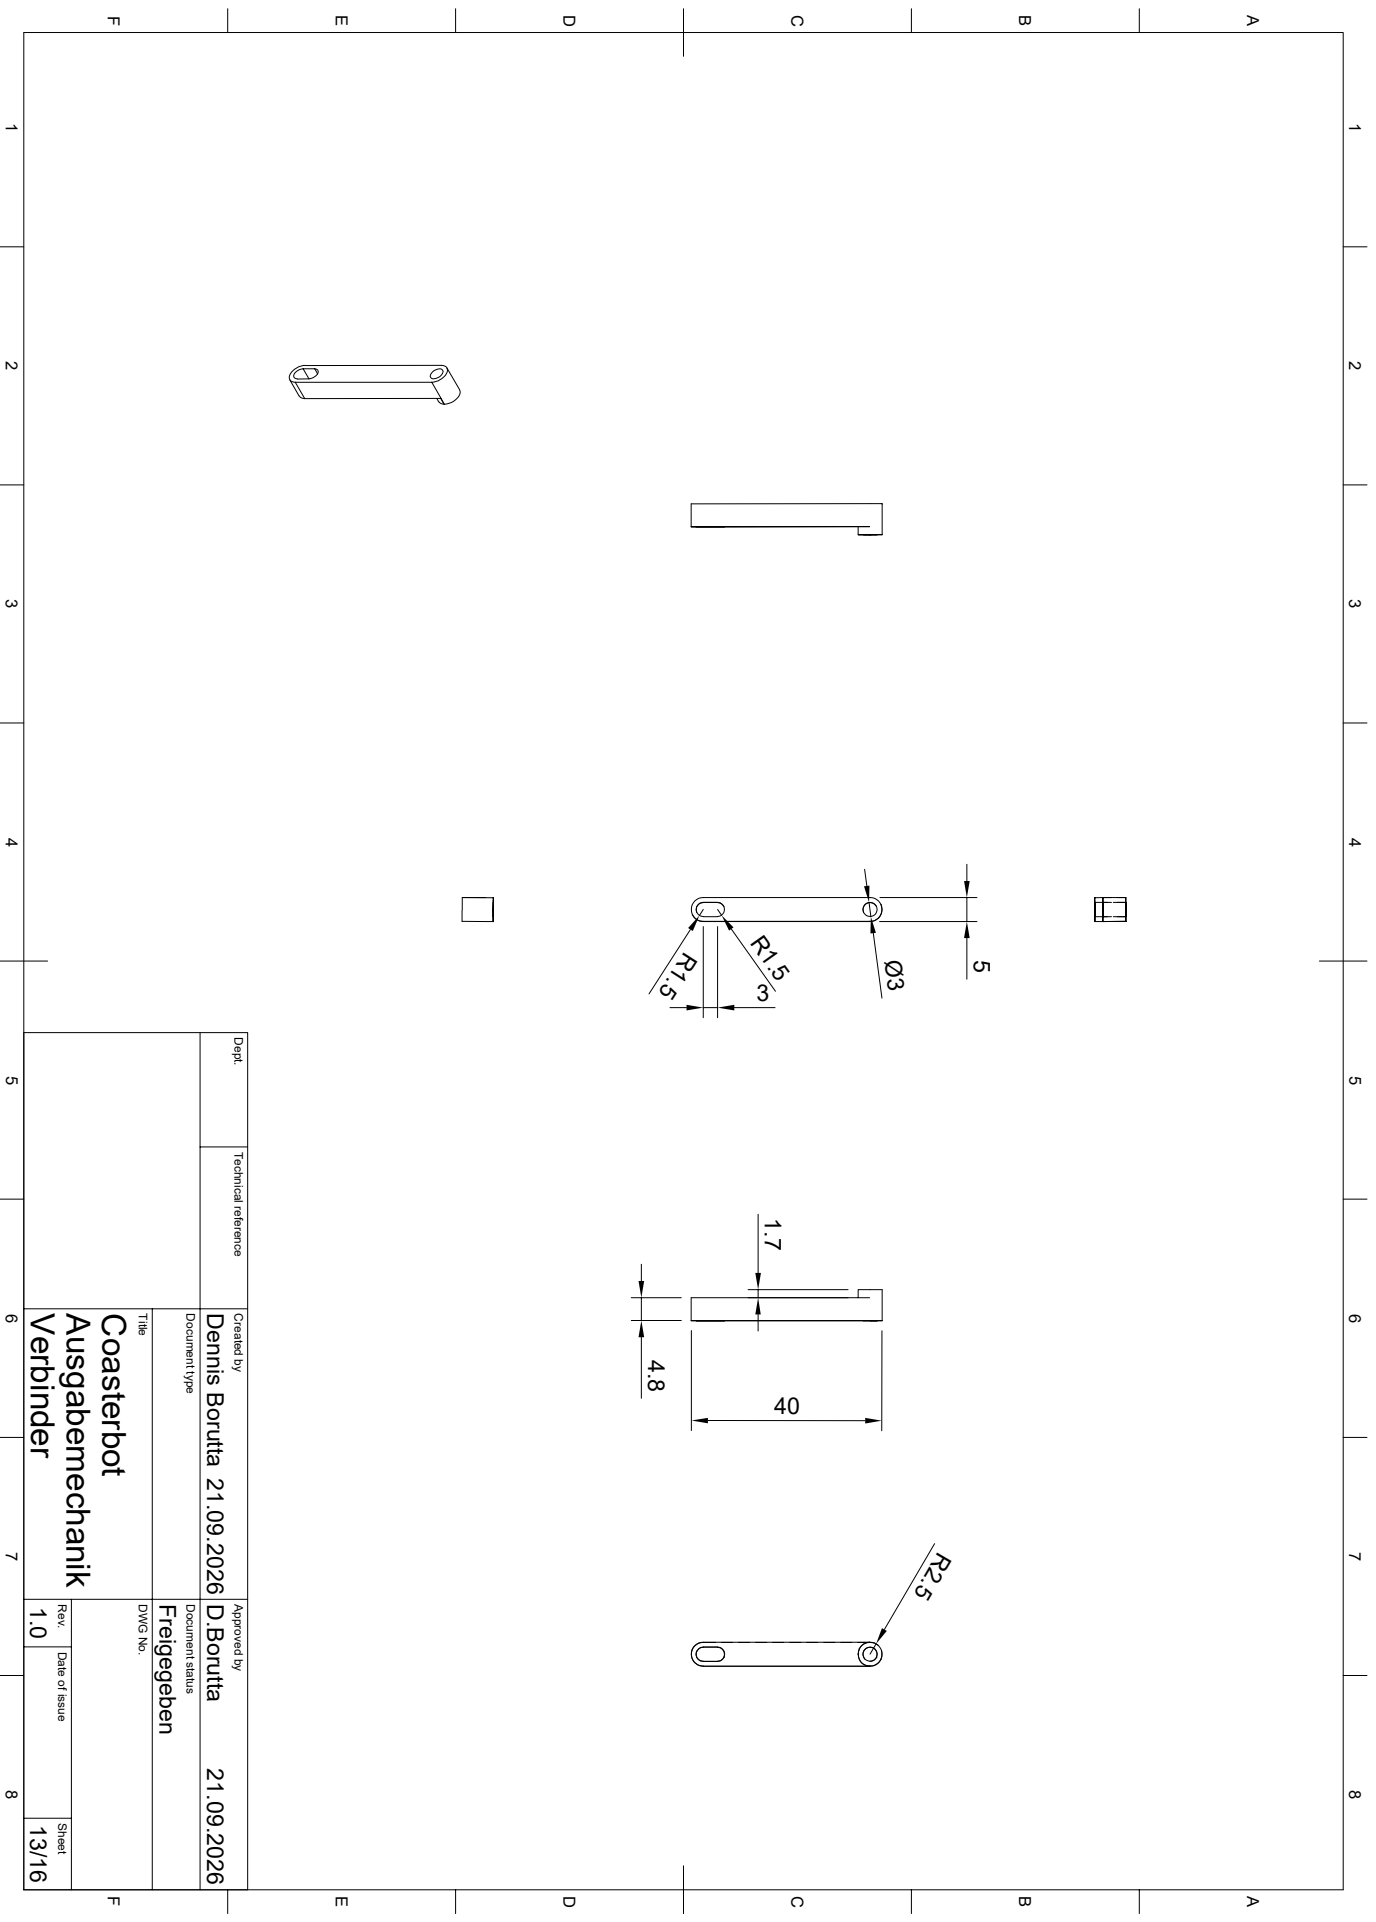
[picture p257: page 1]

1 A 2 3 4 5 6 7 8 1 2 3 4 5 6 7 8 FEDCB FEDCBA Dept. Technical reference Created by Approved by Title DWG No. Document type Document status 1.0 Rev. Date of issue Sheet Verbinder Freigegeben 21.09.2026 21.09.2026 13/16 Ausgabemechanik Coasterbot D.Borutta Dennis Borutta Ø3 R1.5 R1.5 3
