Project-CoasterBot/coasterbot/M4_Test-und-Validierung/Mechanikkonzept/Technische Zeichnungen/Einzelzeichnungen/14_Coasterbot_Ausgabemechanik_Halter_Heber.pdf

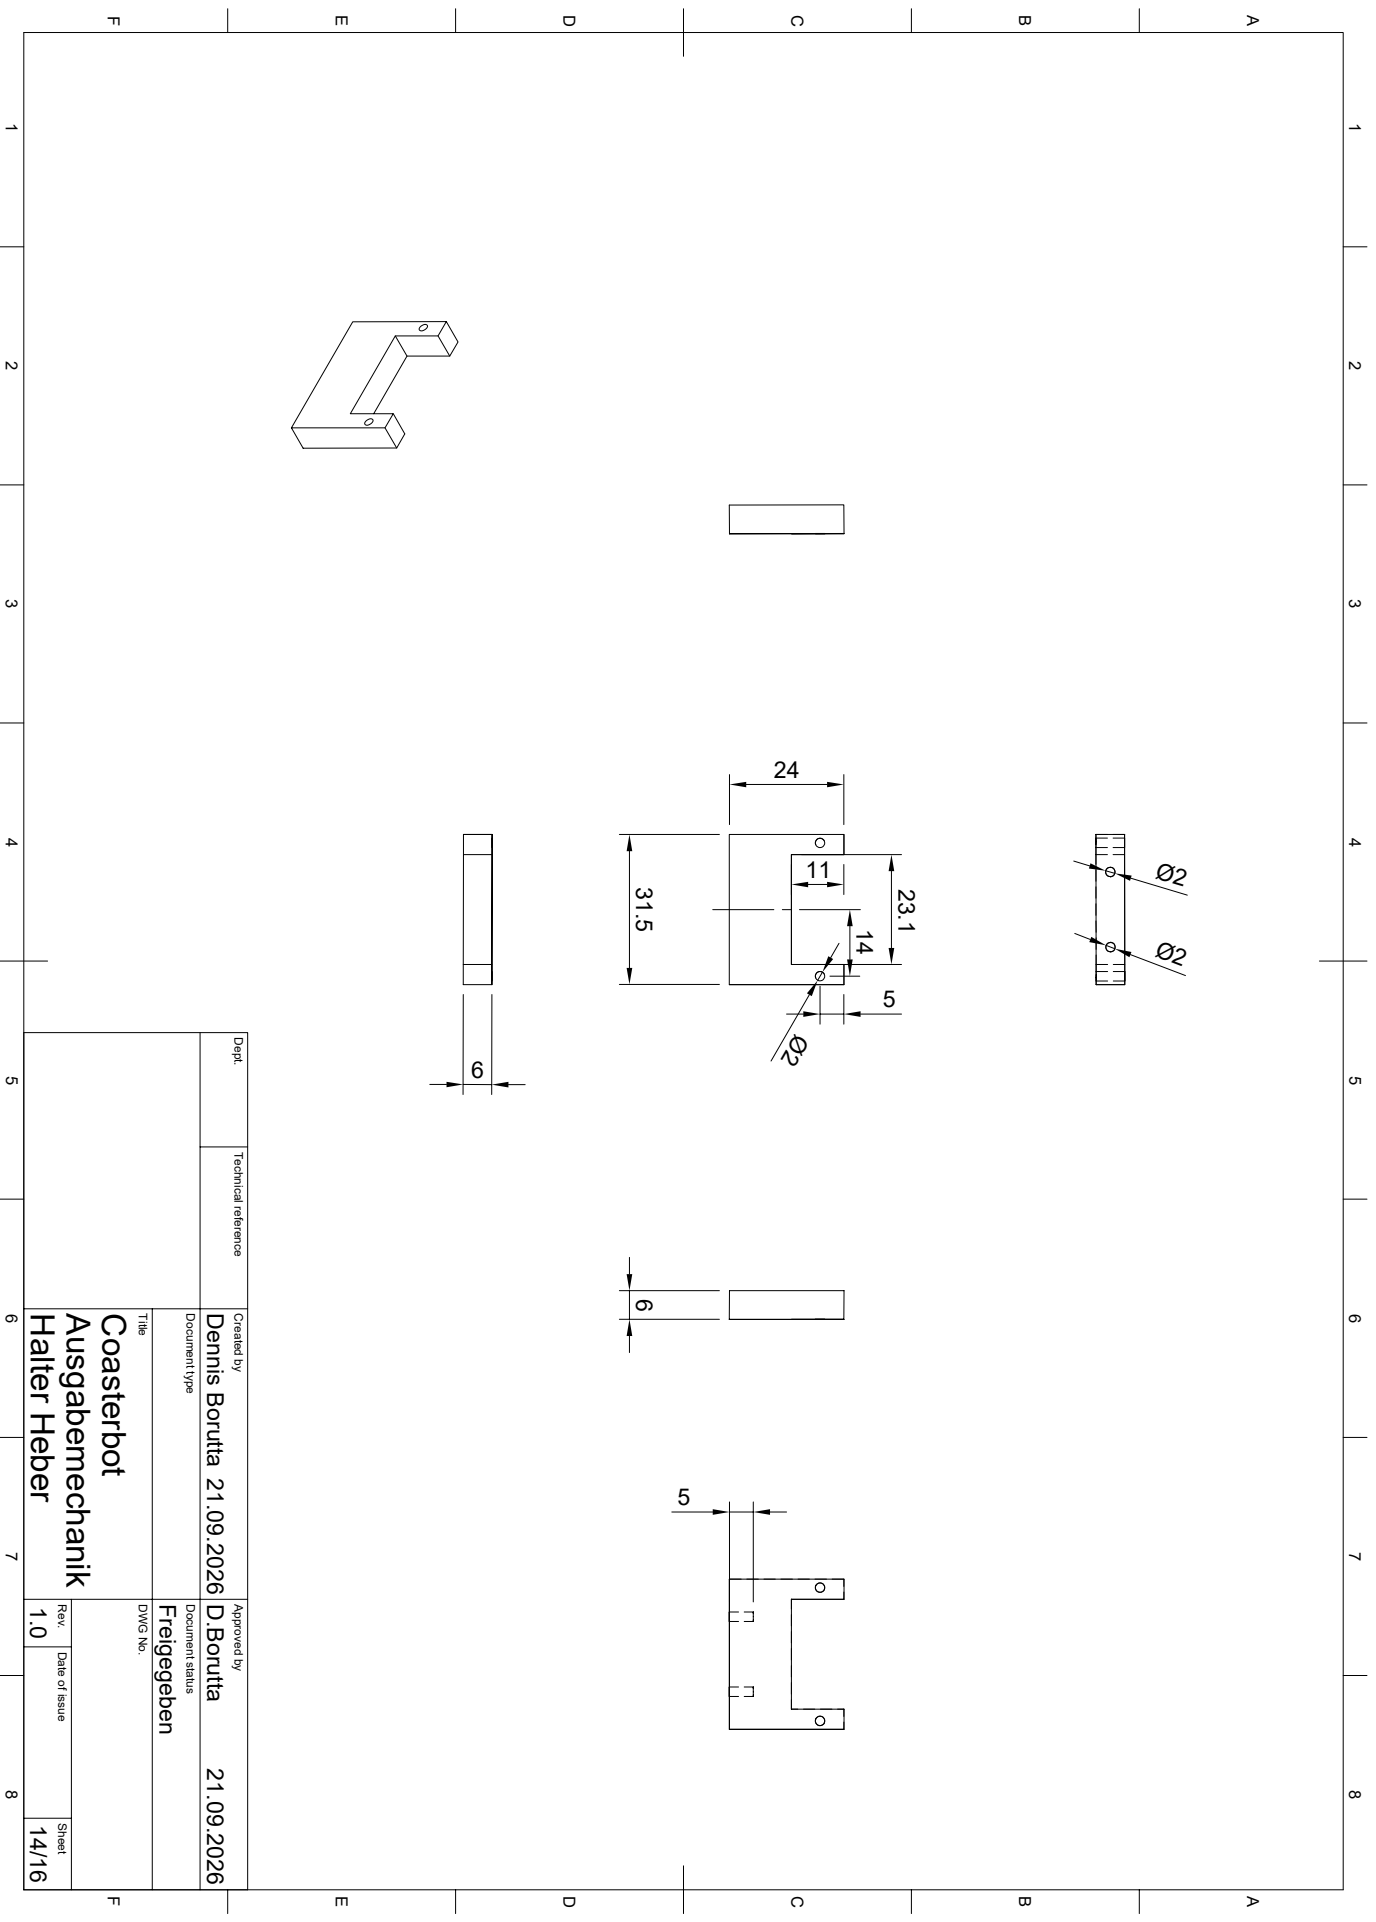
[picture p258: page 1]

1 A 2 3 4 5 6 7 8 1 2 3 4 5 6 7 8 FEDCB FEDCBA Dept. Technical reference Created by Approved by Title DWG No. Document type Document status 1.0 Rev. Date of issue Sheet Halter Heber Freigegeben 21.09.2026 21.09.2026 14/16 Ausgabemechanik Coasterbot D.Borutta Dennis Borutta 31.5 23.1 Ø2 14 5
