Project-CoasterBot/coasterbot/M4_Test-und-Validierung/Mechanikkonzept/Technische Zeichnungen/Einzelzeichnungen/15_Coasterbot_Ausgabemechanik_Stempelführung.pdf

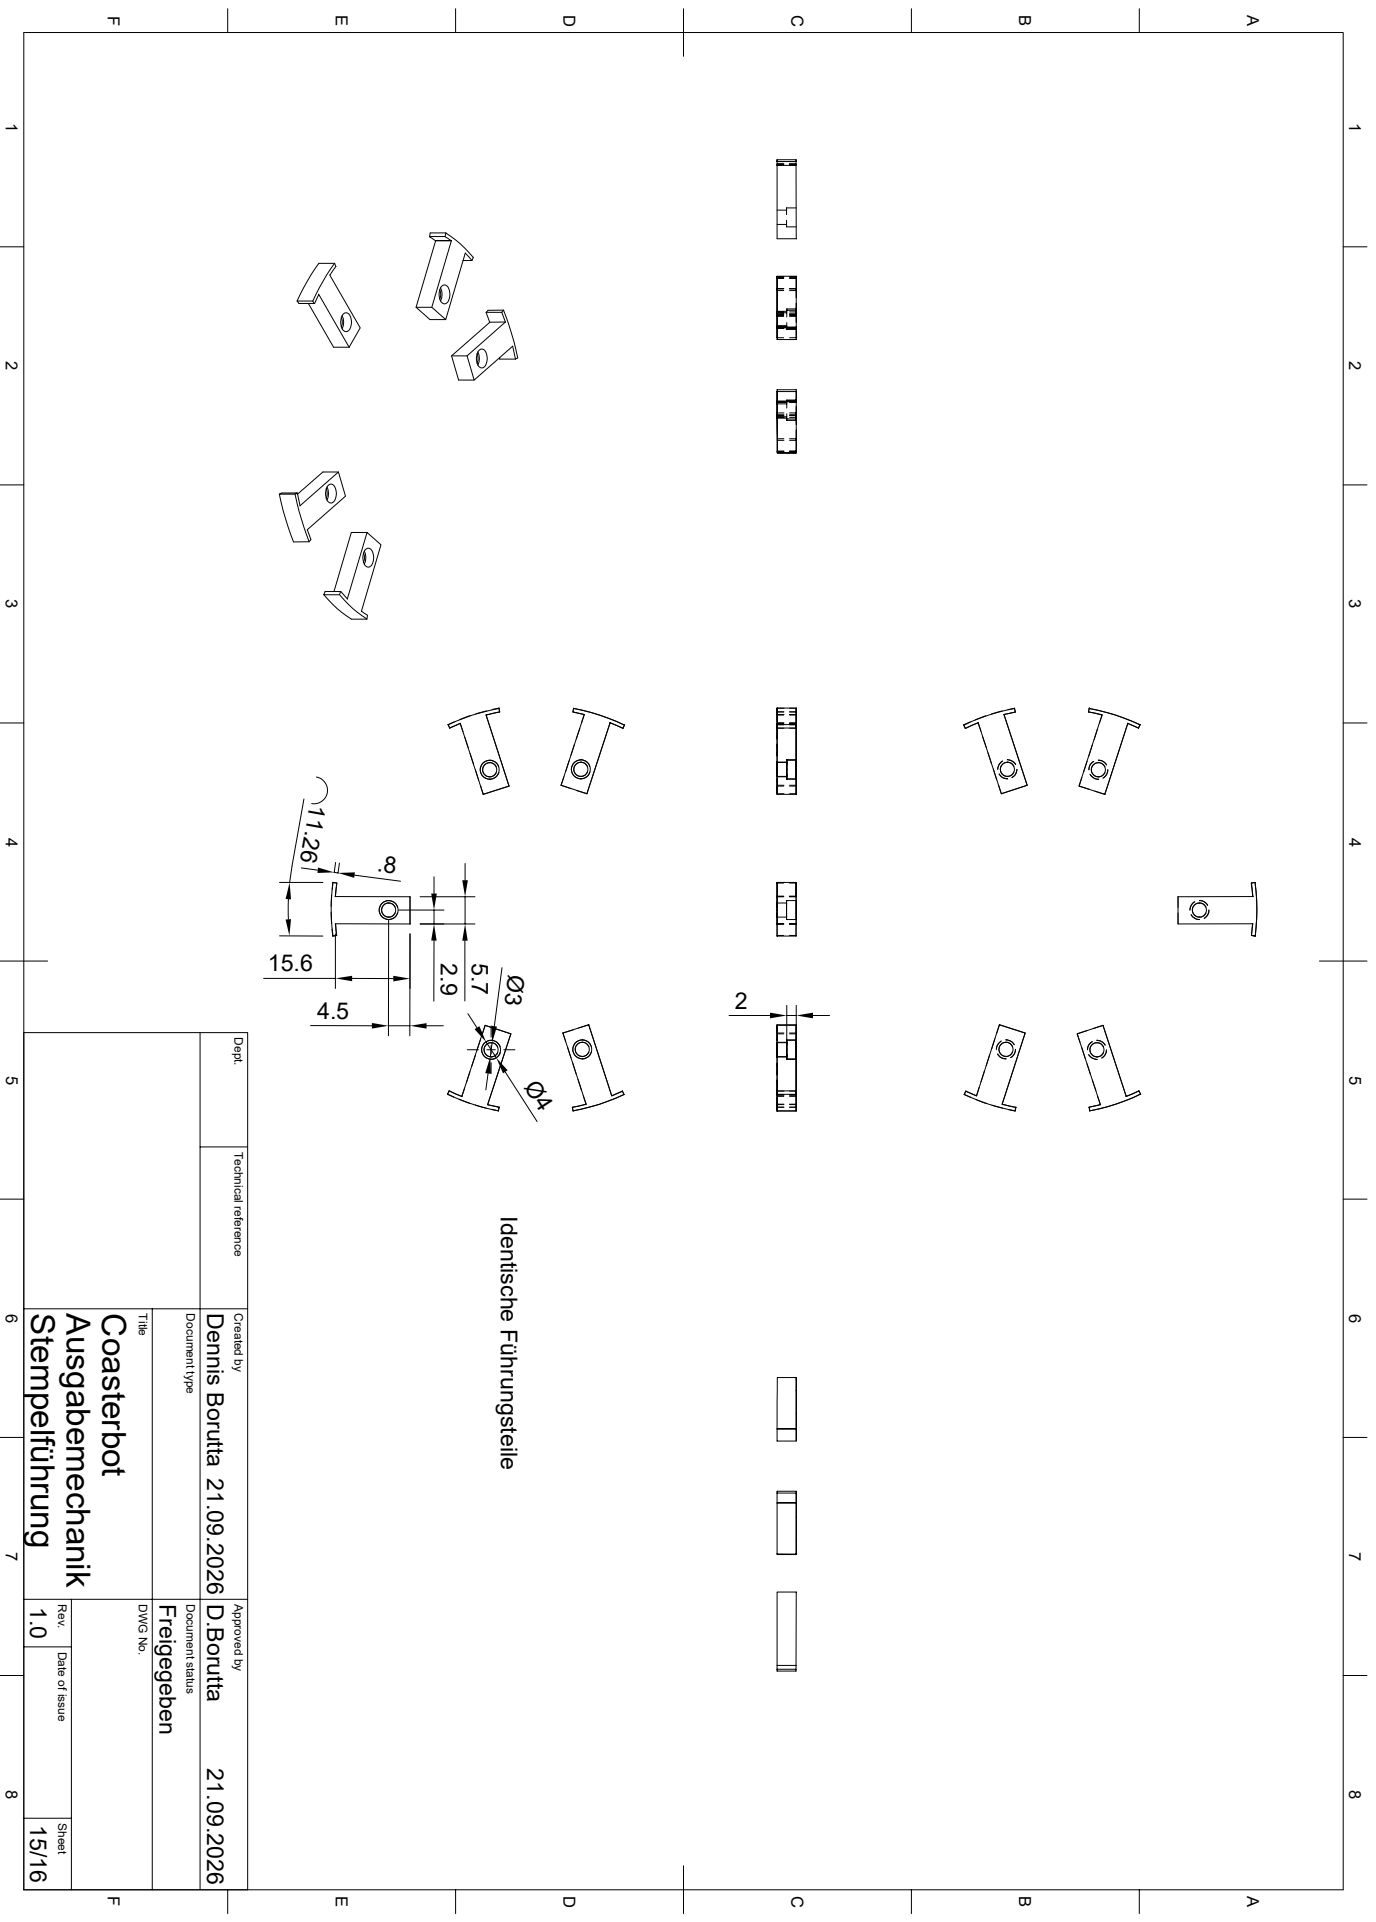
[picture p259: page 1]

1 A 2 3 4 5 6 7 8 1 2 3 4 5 6 7 8 FEDCB FEDCBA Dept. Technical reference Created by Approved by Title DWG No. Document type Document status 1.0 Rev. Date of issue Sheet Stempelführung Freigegeben 21.09.2026 21.09.2026 15/16 Ausgabemechanik Coasterbot D.Borutta Dennis Borutta Identische Führungsteile 5.715.611.26.8 Ø3 Ø4
