Project-CoasterBot/coasterbot/M4_Test-und-Validierung/Mechanikkonzept/Technische Zeichnungen/Einzelzeichnungen/16_Coasterbot_Ausgabemechanik_Ausschieber.pdf

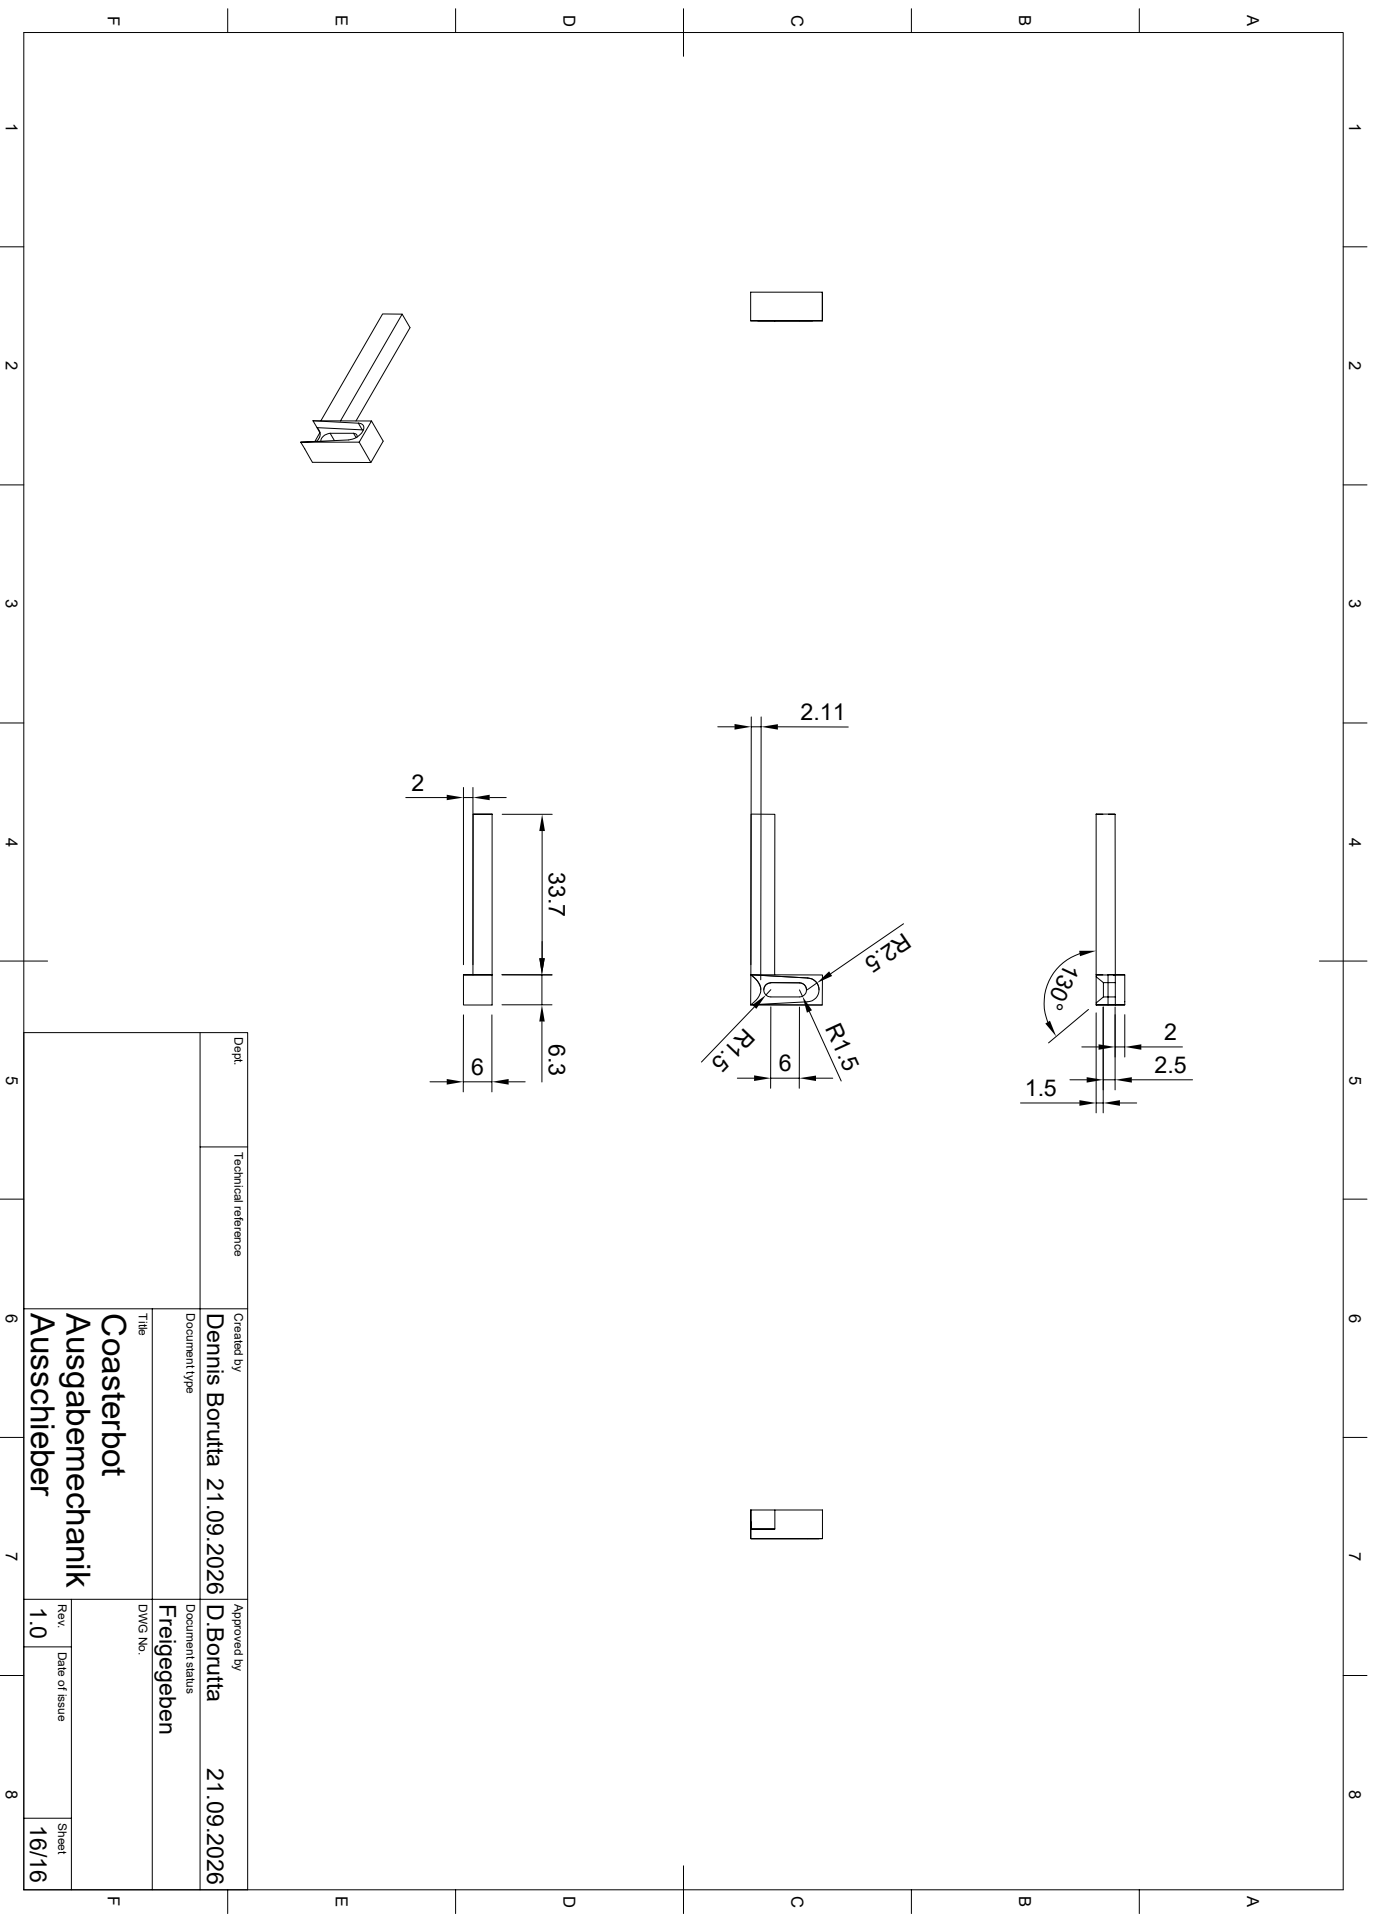
[picture p260: page 1]
1.5 ¹³⁰°

1 A 2 3 4 5 6 7 8 1 2 3 4 5 6 7 8 FEDCB FEDCBA Dept. Technical reference Created by Approved by Title DWG No. Document type Document status 1.0 Rev. Date of issue Sheet Ausschieber Freigegeben 21.09.2026 21.09.2026 16/16 Ausgabemechanik Coasterbot D.Borutta Dennis Borutta 33.7 6.3 2 R2.5 R1.56 R1.5
