Project-CoasterBot/coasterbot/M0/MindMap.pdf

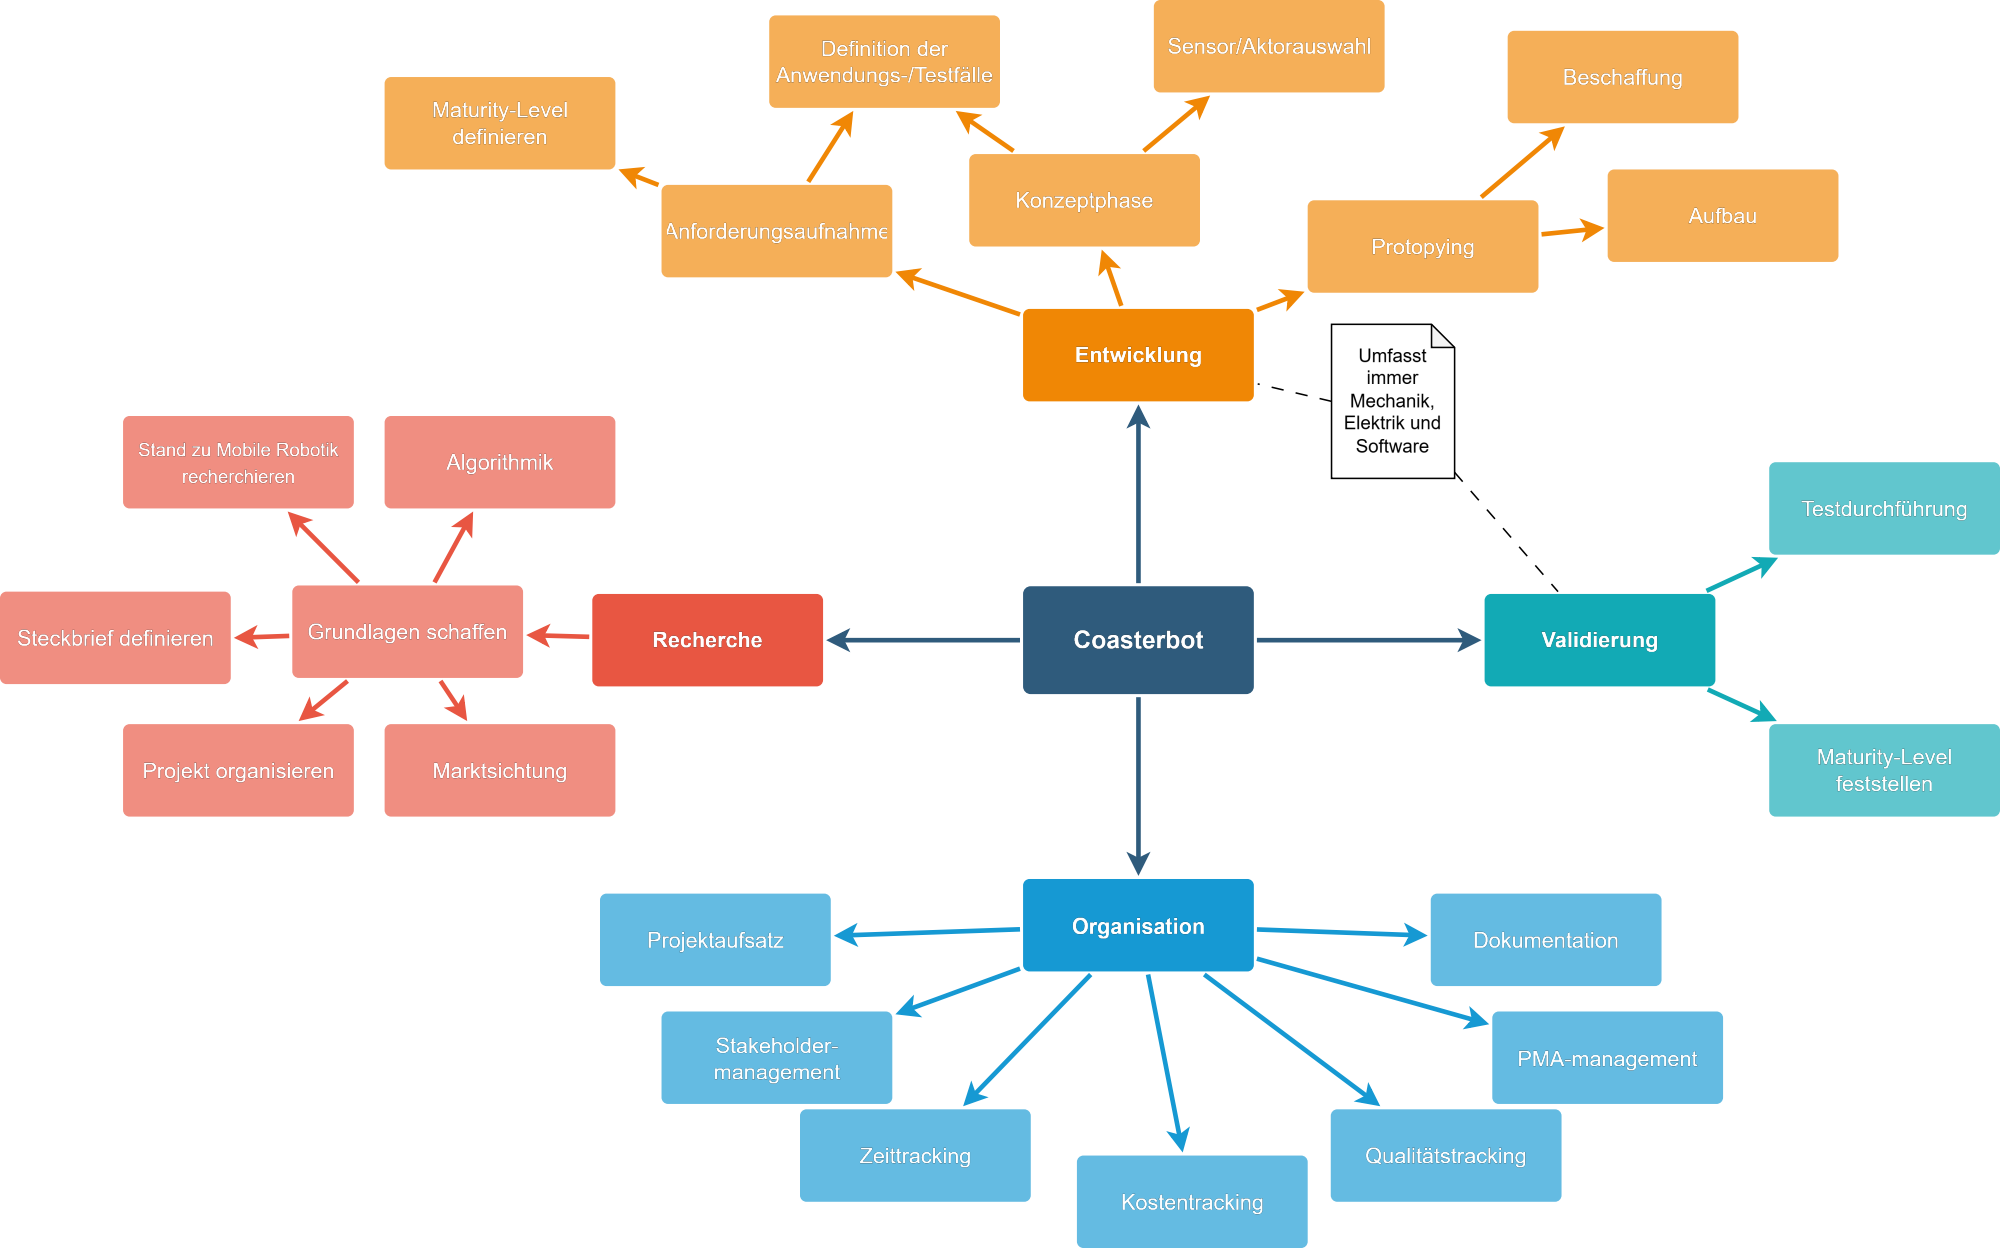
[picture p261: page 1]
