Project-CoasterBot/coasterbot/M0/svg-inkscape/Coasterbot_Netzplan_v4_svg-raw.pdf

# Netzplan Coasterbot — v4 (CPM neu berechnet)

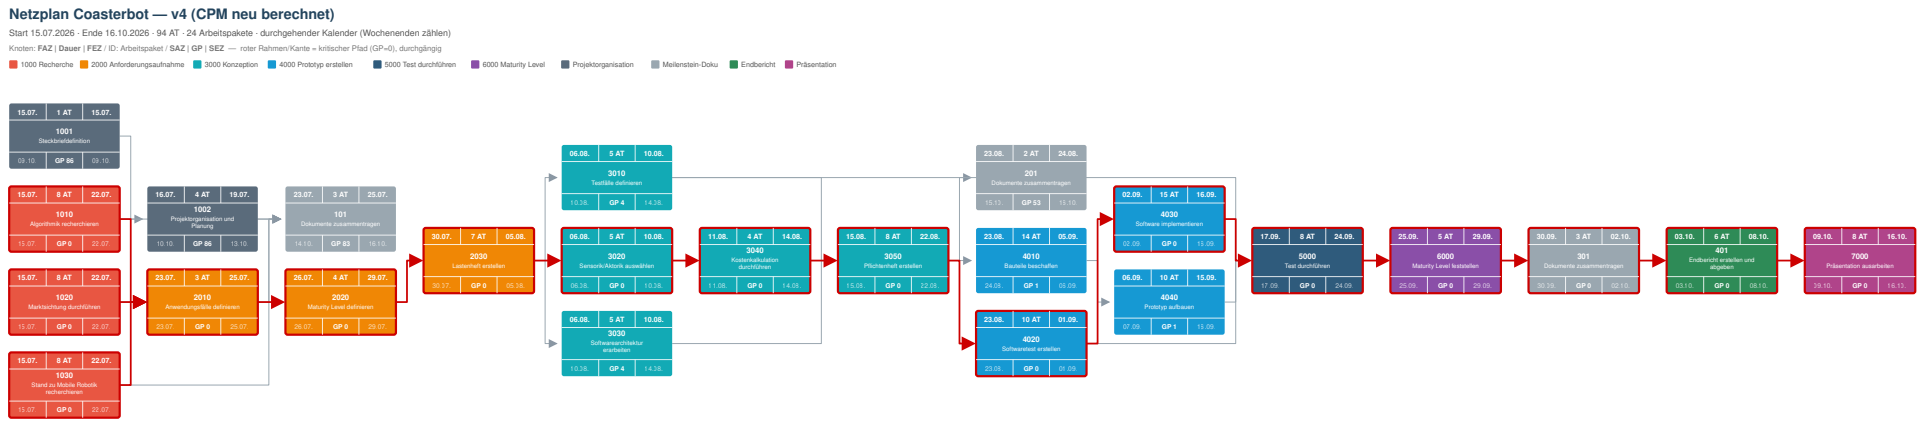
[picture p262: page 1]
1000 Recherche; 2000 Anforderungsaufnahme; 3000 Konzeption; 4000 Prototyp erstellen; 5000 Test durchführen; 6000 Maturity Level; Projektorganisation; Meilenstein-Doku; Endbericht; Präsentation; Steckbriefdefinition; Projektorganisation und Planung; Algorithmik recherchieren; Marktsichtung durchführen; Dokumente zusammentragen; Anwendungsfälle definieren; Lastenheft erstellen; Testfälle definieren; Softwarearchitektur erarbeiten; Kostenkalkulation durchführen; Pflichtenheft erstellen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

Start 15.07.2026 · Ende 16.10.2026 · 94 AT · 24 Arbeitspakete · durchgehender Kalender (Wochenenden zählen)

Knoten: FAZ | Dauer | FEZ / ID: Arbeitspaket / SAZ | GP | SEZ — roter Rahmen/Kante = kritischer Pfad (GP=0), durchgängig

Sensorik/Aktorik auswählen

Maturity Level feststellen

Endbericht erstellen und

Maturity Level definieren

Stand zu Mobile Robotik
recherchieren
