Project-CoasterBot/coasterbot/M0/svg-inkscape/MindMap_svg-raw.pdf

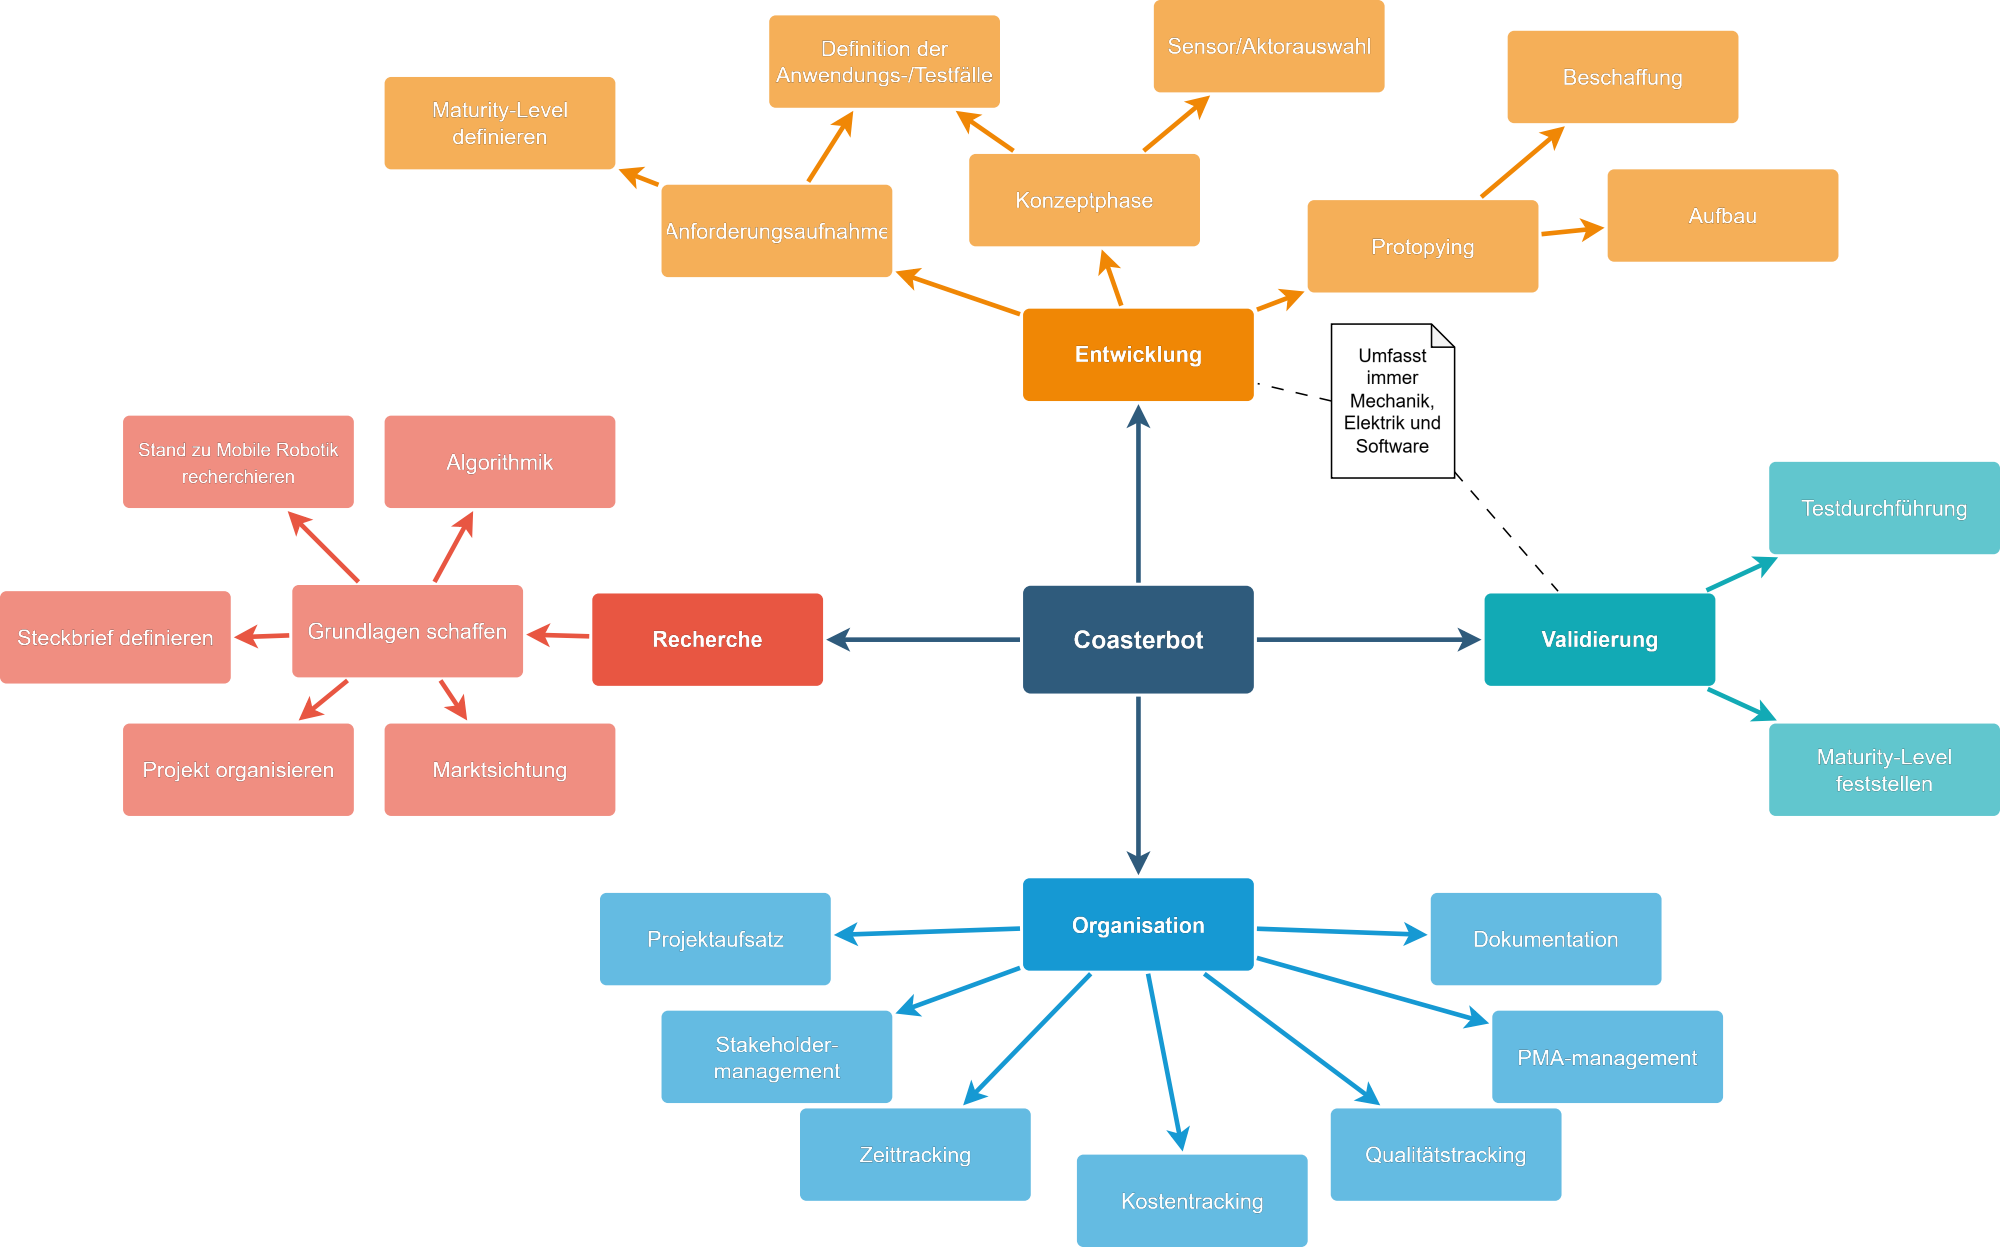
[picture p263: page 1]
