Project-CoasterBot/coasterbot/M0/svg-inkscape/Coasterbot_Netzplan_PSP_svg-raw.pdf

# Netzplan Coasterbot — Endtermin 07.11.2026 (Endbericht), verdichtet

## TM-A Systems / Anforderungen / Aufbau

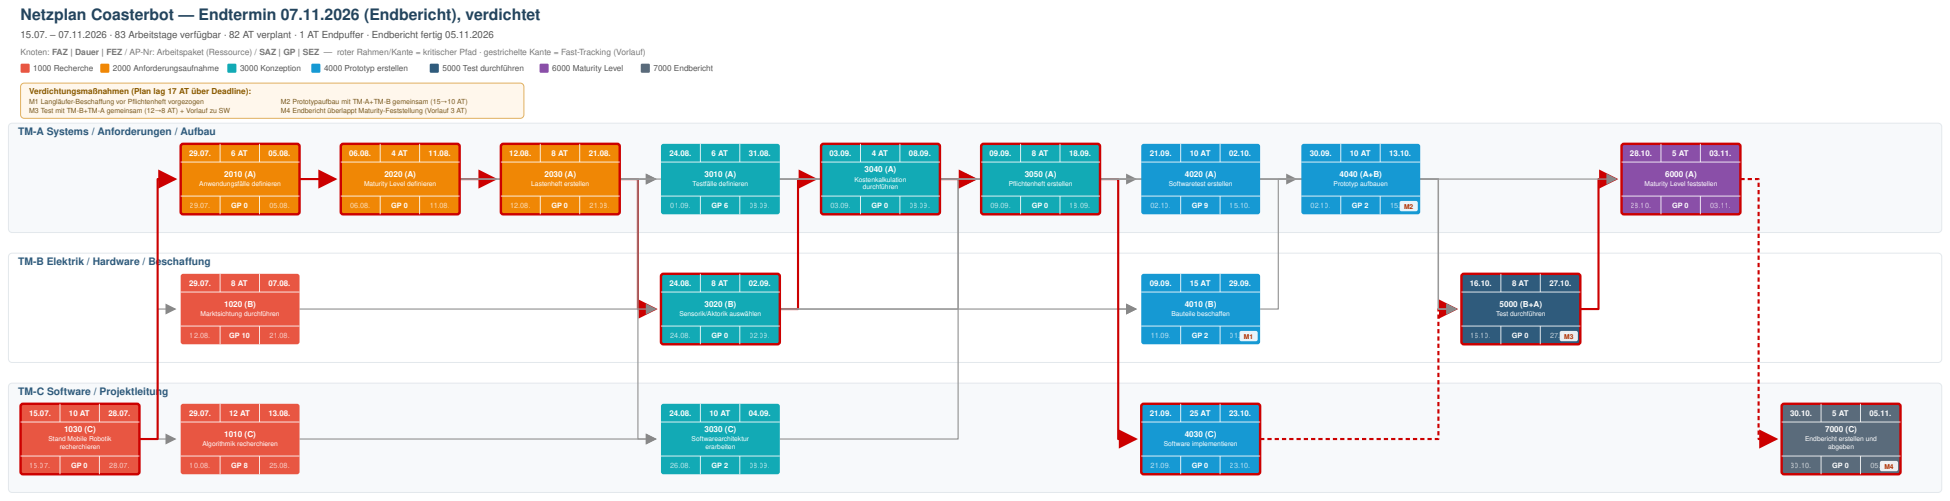
[picture p264: page 1]
1000 Recherche; 2000 Anforderungsaufnahme; 3000 Konzeption; 4000 Prototyp erstellen; 5000 Test durchführen; 6000 Maturity Level; 7000 Endbericht; M1 Langläufer-Beschaffung vor Pflichtenheft vorgezogen; M2 Prototypaufbau mit TM-A+TM-B gemeinsam (15→10 AT); M3 Test mit TM-B+TM-A gemeinsam (12→8 AT) + Vorlauf zu SW; M4 Endbericht überlappt Maturity-Feststellung (Vorlauf 3 AT); Stand Mobile Robotik recherchieren; Algorithmik recherchieren; Marktsichtung durchführen; Anwendungsfälle definieren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

15.07. – 07.11.2026 · 83 Arbeitstage verfügbar · 82 AT verplant · 1 AT Endpuffer · Endbericht fertig 05.11.2026

Knoten: FAZ | Dauer | FEZ / AP-Nr: Arbeitspaket (Ressource) / SAZ | GP | SEZ — roter Rahmen/Kante = kritischer Pfad · gestrichelte Kante = Fast-Tracking (Vorlauf)

Verdichtungsmaßnahmen (Plan lag 17 AT über Deadline):

Maturity Level definieren

Maturity Level feststellen

TM-B Elektrik / Hardware / Beschaffung

Sensorik/Aktorik auswählen

TM-C Software / Projektleitung

Endbericht erstellen und
