Project-CoasterBot/coasterbot/M0/svg-inkscape/MindMap-Seite-1.drawio_svg-raw.pdf

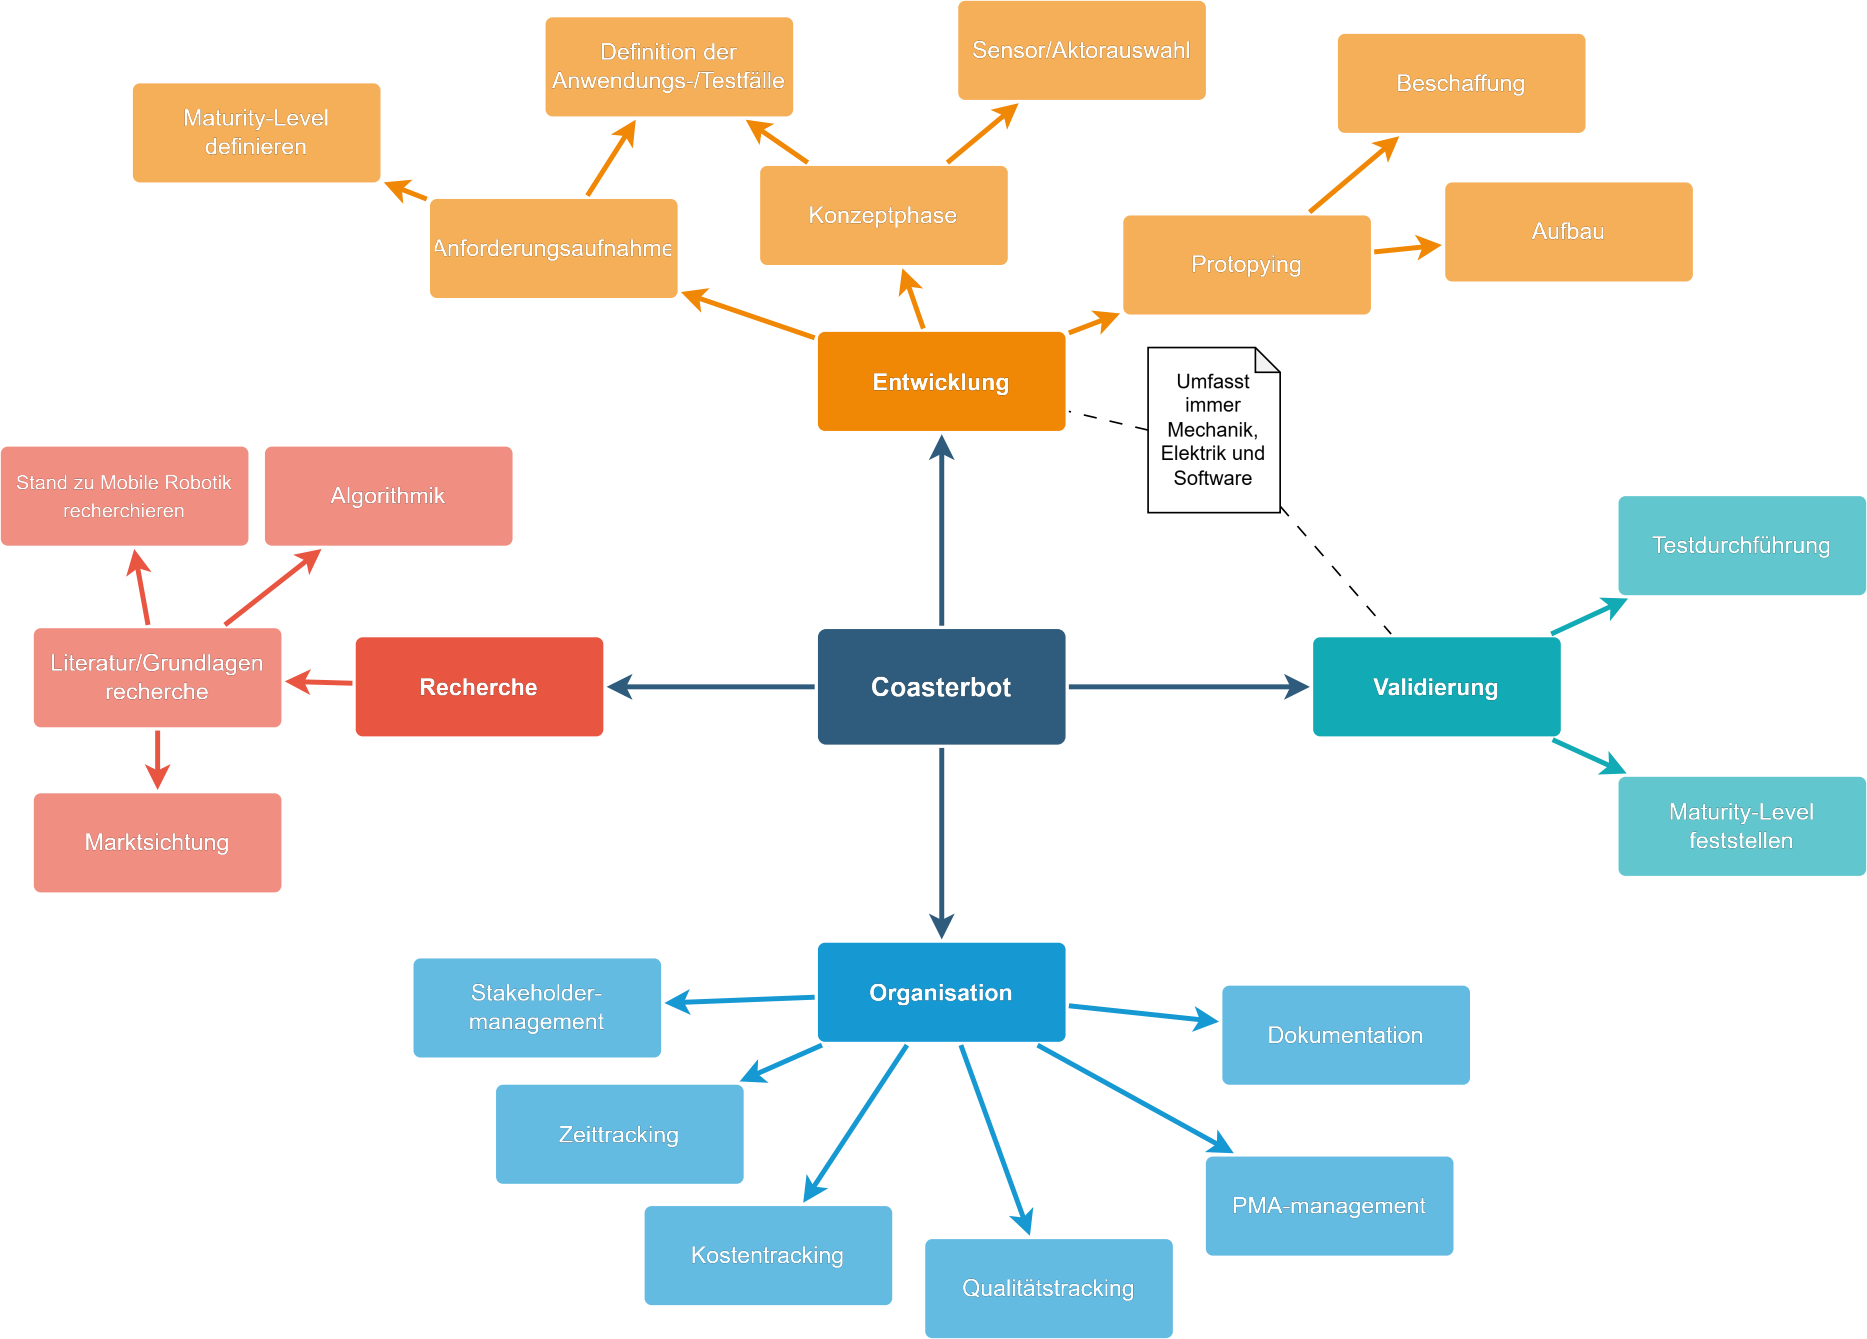
[picture p265: page 1]
