Project-CoasterBot/coasterbot/src/webots/pose_estimator.h

#ifndef POSE_ESTIMATOR_H
#define POSE_ESTIMATOR_H

#include "robot_hal.h"

// ---------------------------------------------------------------------
// Schaetzt die Pose (x, y, theta) des Roboters auf der Tischebene.
//
// X/Y werden aus den zwei seitenweisen Radwinkeln (RobotHAL::getWheelAngle,
// ein Wert je Seite) integriert. Der Kurs kombiniert Gyro- und Encoder-
// Odometrie und wird mit dem HAL-Yaw-Messwert korrigiert.
//
// Kennt NUR das RobotHAL-Interface -> unveraendert auf einen Arduino
// portierbar (dort liefern Radencoder die Winkel, ein MPU-6050 die
// Drehrate).
//
// Konvention: x nach vorne (lokale Startausrichtung), y nach links,
// theta = 0 in Startrichtung, positiv = Linksdrehung (mathematisch
// positiv, gegen den Uhrzeigersinn von oben gesehen).
// ---------------------------------------------------------------------
class PoseEstimator {
public:
    // Radgeometrie aus Coasterbot.proto.
    static constexpr float DEFAULT_WHEEL_RADIUS = 0.035f;  // [m]
    static constexpr float DEFAULT_TRACK_WIDTH = 0.202f;    // [m]

    // wheelRadius/trackWidth [m]: Standard = Coasterbot.proto (Webots),
    // die reale Hardware hat andere Raeder (siehe hw_webots_test.h).
    explicit PoseEstimator(RobotHAL& hal,
                           float wheelRadius = DEFAULT_WHEEL_RADIUS,
                           float trackWidth = DEFAULT_TRACK_WIDTH);

    // Einmal pro Regelzyklus aufrufen (nach hal.step()).
    void update();

    // Aktuelle Schaetzung.
    float getX() const { return x_; }             // [m]
    float getY() const { return y_; }             // [m]
    float getTheta() const { return theta_; }     // [rad], (-pi, pi]

    // Gesamte gefahrene Wegstrecke ("Kilometerzaehler") [m].
    float getOdometer() const { return odometer_; }
    float getWheelRadius() const { return wheelRadius_; }  // [m]
    float getTrackWidth() const { return trackWidth_; }    // [m]

    // Pose auf einen bekannten Wert setzen (z.B. Startpose aus der Welt).
    void reset(float x = 0.0f, float y = 0.0f, float theta = 0.0f);

private:
    RobotHAL& hal_;
    const float wheelRadius_;  // [m]
    const float trackWidth_;   // [m]

    // Heading filter settings.
    static constexpr float HEADING_ODO_WEIGHT = 0.05f;
    static constexpr float YAW_CORRECTION_TIME_CONSTANT = 0.06f;  // [s]
    static constexpr float _PI = 3.14159265358979323846f;
    static constexpr float STATIONARY_COMMAND_THRESHOLD = 0.01f;  // [rad/s]
    static constexpr float STATIONARY_DISTANCE_THRESHOLD = 0.00005f;  // [m/update]
    static constexpr float STATIONARY_GYRO_THRESHOLD = 0.02f;  // [rad/s]
    static constexpr float STATIONARY_DWELL_TIME = 0.25f;  // [s]

    bool  initialized_ = false;
    float prevLeft_ = 0.0f;   // [rad] gemittelte linke Radwinkel
    float prevRight_ = 0.0f;  // [rad] gemittelte rechte Radwinkel
	float prevTime_ = 0.0f;     // [s]
	float yawOffset_ = 0.0f;   // [rad] aligns HAL yaw with the reset heading
    float stationaryTime_ = 0.0f;  // [s]

    float x_ = 0.0f;
    float y_ = 0.0f;
    float theta_ = 0.0f;
    float odometer_ = 0.0f;

    static float wrapAngle(float a);
};

#endif  // POSE_ESTIMATOR_H
