Project-CoasterBot/coasterbot/M4_Test-und-Validierung/webots/controllers/coasterbot_V_01_00/webots_hal.cpp

#include "webots_hal.h"
#include <algorithm>
#include <cmath>
#include <iostream>
#include <limits>

// Device-Namen muessen exakt zu den "name"-Feldern im Coasterbot.proto passen.
WebotsHAL::WebotsHAL() {
    timeStep_ = static_cast<int>(robot_.getBasicTimeStep());

    // Ein Handle pro Seite. Im PROTO sind die zwei Motoren einer Seite
    // gekoppelt ("coupled motors", gemeinsamer Name vor "::"); ein Befehl an
    // "::front" treibt automatisch auch "::rear" derselben Seite.
    motorLeft_  = robot_.getMotor("wheel_left::front");
    motorRight_ = robot_.getMotor("wheel_right::front");

    // Position auf +unendlich -> Motor laeuft im Geschwindigkeitsmodus
    const double inf = std::numeric_limits<double>::infinity();
    motorLeft_->setPosition(inf);
    motorRight_->setPosition(inf);
    motorLeft_->setVelocity(0.0);
    motorRight_->setVelocity(0.0);

    encFL_ = robot_.getPositionSensor("wheel_front_left_sensor");
    encFR_ = robot_.getPositionSensor("wheel_front_right_sensor");
    encRL_ = robot_.getPositionSensor("wheel_rear_left_sensor");
    encRR_ = robot_.getPositionSensor("wheel_rear_right_sensor");
    encFL_->enable(timeStep_);
    encFR_->enable(timeStep_);
    encRL_->enable(timeStep_);
    encRR_->enable(timeStep_);

    ultrasonic_ = robot_.getDistanceSensor("ultrasonic");
    edgeFL_ = robot_.getDistanceSensor("edge_front_left");
    edgeFR_ = robot_.getDistanceSensor("edge_front_right");
    edgeRL_ = robot_.getDistanceSensor("edge_rear_left");
    edgeRR_ = robot_.getDistanceSensor("edge_rear_right");

    ultrasonic_->enable(timeStep_);
    edgeFL_->enable(timeStep_);
    edgeFR_->enable(timeStep_);
    edgeRL_->enable(timeStep_);
    edgeRR_->enable(timeStep_);

    imu_ = robot_.getInertialUnit("inertial_unit");
    imu_->enable(timeStep_);
    gyro_ = robot_.getGyro("gyro");
    gyro_->enable(timeStep_);
    accelerometer_ = robot_.getAccelerometer("accelerometer");
    accelerometer_->enable(timeStep_);

    pen_ = robot_.getPen("pen");
    pen_->write(true);

    // Start-Kalibrierung des simulierten GY-521/MPU-6050-Bias HIER im
    // Konstruktor, nicht erst beim ersten getGyroZ()-Aufruf: an dieser
    // Stelle wurde noch kein Fahrbefehl gegeben (Motoren stehen auf 0.0,
    // siehe oben), der Roboter steht also wirklich still - wie ein reales
    // Exemplar beim Einschalten, bevor es losfaehrt. Wuerde man stattdessen
    // erst waehrend der ersten Regelzyklen kalibrieren, in denen (z.B. in
    // MODE_SIM_TEST) bereits gefahren wird, wuerde die echte Drehung
    // faelschlich in den Bias-Schaetzwert einfliessen und ihn dauerhaft
    // verfaelschen (in der Simulation beobachtet: der Roboter blieb dann
    // an einer falschen Pose haengen).
    calibrateGyro();
}

WebotsHAL::~WebotsHAL() {}

void WebotsHAL::calibrateGyro() {
    float sum = 0.0f;
    int n = 0;
    for (; n < GYRO_CAL_SAMPLES; ++n) {
        if (robot_.step(timeStep_) == -1) break;  // Simulation endet bereits
        const double* v = gyro_->getValues();
        const float raw = static_cast<float>(v[1]);
        sum += raw + GYRO_BIAS_RAD + gyroNoise_(gyroRng_);
    }
    if (n > 0) gyroBiasEstimate_ = sum / static_cast<float>(n);
}
void WebotsHAL::updateImuErrors() {
    const float dt = timeStep_ * 0.001f;
    if (!imuErrInit_) {
        accelTurnOnBias_ = ACCEL_TURNON_BIAS_STD * unitNormal_(imuRng_);
        imuErrInit_ = true;
    }
    // Random Walk: Varianz waechst linear mit der Zeit
    const float s = std::sqrt(dt);
    accelWalk_ += ACCEL_BIAS_WALK * s * unitNormal_(imuRng_);
    gyroWalk_  += GYRO_BIAS_WALK  * s * unitNormal_(imuRng_);

    // Erwaermung nach dem Einschalten
    const float dT = WARMUP_DELTA_T * (1.0f - std::exp(-getTime() / WARMUP_TAU));

    // Vibration ~ mittlere Radgeschwindigkeit (Sollwert genuegt)
    const float vib = 0.5f * (std::fabs(appliedLeft_) + std::fabs(appliedRight_));
    const float sigma = std::sqrt(ACCEL_NOISE_STD * ACCEL_NOISE_STD
                                + (ACCEL_VIB_GAIN * vib) * (ACCEL_VIB_GAIN * vib));

    accelError_ = accelTurnOnBias_ + accelWalk_ + ACCEL_TEMP_COEF * dT
                + sigma * unitNormal_(imuRng_);
    gyroDriftError_ = gyroWalk_ + GYRO_TEMP_COEF * dT;
}

bool WebotsHAL::step() {
    const bool ok = robot_.step(timeStep_) != -1;
    if (ok) { updateMotorControl(); updateImuErrors(); updateGyroHeading(); }
    return ok;
}

float WebotsHAL::getForwardAcceleration() {
    const double* a = accelerometer_->getValues();
    return -static_cast<float>(a[2]) + accelError_;
}

void WebotsHAL::setLeftSpeed(float radPerSec) {
    // HAL-Konvention: positiv = vorwaerts (Front = -Z, die Seite mit dem
    // Ultraschallhalter). Setzt nur das Kommando; die eigentliche
    // Motoransteuerung (inkl. Vorzeichenumkehr fuer das PROTO-Radmodell)
    // uebernimmt updateMotorControl(), siehe dort und webots_hal.h.
    commandedLeft_ = radPerSec;
}

void WebotsHAL::setRightSpeed(float radPerSec) {
    commandedRight_ = radPerSec;
}

float WebotsHAL::getCommandedSpeed(WheelId wheel) {
    return wheel == WHEEL_LEFT ? commandedLeft_ : commandedRight_;
}

// Simuliert die Motorregelung einer Seite: Open-Loop reicht das Kommando
// unveraendert durch, Closed-Loop gleicht die (der Regelung unbekannte)
// Gain-Abweichung ueber die gemessene Radgeschwindigkeit per Integralregler
// aus. Ausfuehrliche Erklaerung in webots_hal.h.
void WebotsHAL::updateMotorControl() {
    const float nowLeft  = getWheelAngle(WHEEL_LEFT);
    const float nowRight = getWheelAngle(WHEEL_RIGHT);
    const float now = getTime();
    if (!motorCtrlInitialized_) {
        prevAngleLeft_  = nowLeft;
        prevAngleRight_ = nowRight;
        prevMotorCtrlTime_ = now;
        motorCtrlInitialized_ = true;
        return;  // noch keine Winkelaenderung messbar
    }
    const float dt = std::max(now - prevMotorCtrlTime_, 1e-4f);
    measuredLeft_  = (nowLeft  - prevAngleLeft_)  / dt;
    measuredRight_ = (nowRight - prevAngleRight_) / dt;
    prevAngleLeft_  = nowLeft;
    prevAngleRight_ = nowRight;
    prevMotorCtrlTime_ = now;

    if (motorMode_ == MotorControlMode::CLOSED_LOOP) {
        appliedLeft_  += MOTOR_KI * (commandedLeft_  - measuredLeft_)  * dt;
        appliedRight_ += MOTOR_KI * (commandedRight_ - measuredRight_) * dt;
        appliedLeft_  = std::max(-MOTOR_MAX_OMEGA, std::min(MOTOR_MAX_OMEGA, appliedLeft_));
        appliedRight_ = std::max(-MOTOR_MAX_OMEGA, std::min(MOTOR_MAX_OMEGA, appliedRight_));
    } else {
        appliedLeft_  = commandedLeft_;
        appliedRight_ = commandedRight_;
    }

    // Das PROTO-Radmodell rollt den Roboter bei positiver Motordrehzahl nach
    // +Z (hinten); Vorzeichen daher umkehren (siehe HAL-Konvention oben).
    // MOTOR_GAIN_*_TRUE ist die simulierte reale Fertigungsstreuung, die
    // Regelung "kennt" sie nicht, sie wirkt nur auf die tatsaechliche
    // Aktuierung.
    motorLeft_->setVelocity(-static_cast<double>(appliedLeft_ * MOTOR_GAIN_LEFT_TRUE));
    motorRight_->setVelocity(-static_cast<double>(appliedRight_ * MOTOR_GAIN_RIGHT_TRUE));
}

float WebotsHAL::getUltrasonicDistance() {
    // lookupTable im PROTO ist bereits auf Meter gemappt
    return static_cast<float>(ultrasonic_->getValue());
}

// Liest das digitale Kantensignal eines Sensors und bildet es auf das
// semantische bool ab. Die Coasterbot.proto-lookupTable liefert bereits nur
// 0 oder 1 (kein analoger Rohwert, siehe dortiger Kommentar) - die einzige
// verbleibende Aufgabe hier ist, ob HIGH oder LOW "Kante erkannt" bedeutet
// (EDGE_ACTIVE_HIGH). Diese Abbildung findet bewusst HIER statt, nicht in
// RobotLogic/SafetyMonitor: die Anwendungslogik interessiert nur "Kante
// erkannt oder nicht", nicht die Pin-Polaritaet des verbauten Sensormoduls
// (siehe robot_hal.h). Eine ArduinoHAL bildet ihren digitalRead() ebenso hier
// ab und muss dafuer nur EDGE_ACTIVE_HIGH auf ihr reales Sensormodul anpassen.
bool WebotsHAL::digitalEdge(webots::DistanceSensor* sensor) const {
    const bool high = sensor->getValue() > 0.5;
    return high == EDGE_ACTIVE_HIGH;
}

bool WebotsHAL::getEdgeFrontLeft()  { return digitalEdge(edgeFL_); }
bool WebotsHAL::getEdgeFrontRight() { return digitalEdge(edgeFR_); }
bool WebotsHAL::getEdgeRearLeft()   { return digitalEdge(edgeRL_); }
bool WebotsHAL::getEdgeRearRight()  { return digitalEdge(edgeRR_); }

void WebotsHAL::updateGyroHeading() {
    // Das PROTO ist Y-up und wird in der Z-up-Welt mit rotation "1 0 0 1.5708"
    // aufgestellt -> die Welt-Hochachse faellt mit der lokalen +Y-Achse des
    // Gyros zusammen. Die Yaw-Rate ist daher die Y-Komponente (v[1]).
    const double* v = gyro_->getValues();
    const float raw = static_cast<float>(v[1]);

    // GY-521/MPU-6050-Simulation: simulierten Bias + deterministisches
    // Rauschen aufpraegen, dann den im Konstruktor (calibrateGyro())
    // ermittelten Bias-Schaetzwert wieder abziehen (siehe Kommentar dort
    // und in webots_hal.h). Einmal pro Zyklus, damit getGyroZ() und
    // getYaw() auf derselben Messung beruhen.
    const float measured = raw + GYRO_BIAS_RAD + gyroDriftError_ + gyroNoise_(gyroRng_);
    gyroRate_ = measured - gyroBiasEstimate_;

    const float dt = timeStep_ * 0.001f;
    const bool motorsIdle = commandedLeft_ == 0.0f && commandedRight_ == 0.0f;
    gyroStillTime_ = (motorsIdle && std::fabs(gyroRate_) < GYRO_STILL_RATE_RAD)
        ? gyroStillTime_ + dt
        : 0.0f;

    if (gyroStillTime_ >= GYRO_STILL_TIME) {
        // Stillstand: Kurs halten, Bias langsam nachfuehren (wie GyroSensor)
        gyroBiasEstimate_ += (1.0f - std::exp(-dt / GYRO_BIAS_TRACK_TAU))
                           * (measured - gyroBiasEstimate_);
        return;
    }

    constexpr float pi = 3.14159265358979323846f;
    gyroHeading_ += gyroRate_ * dt;
    while (gyroHeading_ > pi)   gyroHeading_ -= 2.0f * pi;
    while (gyroHeading_ <= -pi) gyroHeading_ += 2.0f * pi;
}

// Kein InertialUnit-Yaw mehr (der waere ein idealer Absolutwert, den es
// real nicht gibt), sondern der integrierte Gyro - siehe webots_hal.h.
float WebotsHAL::getYaw() { return gyroHeading_; }

float WebotsHAL::getGyroZ() { return gyroRate_; }

float WebotsHAL::getWheelAngle(WheelId wheel) {
    // Konvention: positiv = vorwaerts. Der PositionSensor dreht mit dem
    // (invertierten) Motor mit, daher hier ebenfalls negieren.
    //
    // Die reale Elektronik hat nur EINEN Encoder je Seite (siehe RobotHAL).
    // Das PROTO liefert in der Simulation trotzdem vier unabhaengige
    // PositionSensor (einen je Rad) - das ist der Rasteraufbau des CAD-
    // Modells, kein Hinweis auf die reale Sensorbestueckung. Um dieselbe
    // Information wie die reale Elektronik nach aussen zu geben, wird hier
    // je Seite gemittelt: das naehert die Drehung der (real gekoppelten)
    // Seitenwelle an und daempft nebenbei simulationsbedingtes Radschlupf-
    // Rauschen zwischen den zwei Sensoren derselben Seite.
    switch (wheel) {
        case WHEEL_LEFT:
            return -0.5f * (static_cast<float>(encFL_->getValue())
                           + static_cast<float>(encRL_->getValue()));
        case WHEEL_RIGHT:
            return -0.5f * (static_cast<float>(encFR_->getValue())
                           + static_cast<float>(encRR_->getValue()));
    }
    return 0.0f;
}

float WebotsHAL::getTime() {
    return static_cast<float>(robot_.getTime());
}

bool WebotsHAL::simulateButtonPress(float duration) {
    const float now = getTime();
    if (_buttonState) {
        if (now - _buttonPressStartTime >= duration) {
            _buttonState = false;
            std::cout << "[HAL] simulated button released" << std::endl;
        }
    } else {
        if (now - _lastButtonReleaseTime >= 1.0f) { // 1 second cooldown
            _buttonState = true;
            _buttonPressStartTime = now;
            _lastButtonReleaseTime = now;
            std::cout << "[HAL] simulated button pressed" << std::endl;
        }
    }
    return _buttonState;
}

bool WebotsHAL::getButtonState() {
    return simulateButtonPress(0.5f);
}

void WebotsHAL::setServoPosition(int servoId, int position) {
    switch (servoId) {
        case 0: // Lifter
            activeCoaster_ = std::clamp(position / 45, 0, 3);
            if (position != lastLifterServoPosition_) {
                std::cout << "[HAL] set Lifter Servo Position: " << position << " degrees" << std::endl;
                lastLifterServoPosition_ = position;
            }
            if (pickupPending_) {
                //setCoasterVisible(activeCoaster_, false);
                pickupPending_ = false;
            }
            break;
        case 1: // Spender
            if (position != lastSpenderServoPosition_) {
                std::cout << "[HAL] set Spender Servo Position: " << position << " degrees" << std::endl;
                lastSpenderServoPosition_ = position;
            }
            if (position == 90) {
                //setCoasterVisible(activeCoaster_, true);
            } else if (position == 180) {
                pickupPending_ = true;
            }
            break;
        default:
            std::cout << "[HAL] Unknown Servo ID: " << servoId << std::endl;
            break;
    }
}

void WebotsHAL::setCoasterVisible(int coasterIndex, bool visible) {
    static constexpr double coasterPositions[4][3] = {
        {-0.574, -0.345, 0.744},
        { 0.574, -0.345, 0.744},
        { 0.574,  0.345, 0.744},
        {-0.574,  0.345, 0.744}
    };
    static constexpr double hiddenPosition[3] = {0.0, 0.0, -1.0};

    if (coasterIndex < 0 || coasterIndex >= 4) {
        return;
    }

    const std::string defName = "COASTER_" + std::to_string(coasterIndex);
    webots::Node* coaster = robot_.getFromDef(defName);
    if (!coaster) {
        std::cerr << "[HAL] missing world node: " << defName << std::endl;
        return;
    }

    webots::Field* translation = coaster->getField("translation");
    if (!translation) {
        std::cerr << "[HAL] missing translation field: " << defName << std::endl;
        return;
    }

    translation->setSFVec3f(visible ? coasterPositions[coasterIndex] : hiddenPosition);
}


void WebotsHAL::led(LED_COLORS color) {
    if (ledColorInitialized_ && color == lastLedColor_) {
        return;
    }

    lastLedColor_ = color;
    ledColorInitialized_ = true;

    // In der Simulation wird die LED-Farbe ueber das PROTO-Field "ledColor"
    // gesetzt. Das PROTO-Field ist ein enum, das exakt zu dieser LED_COLORS-
    // Definition passt. Daher kann hier direkt der enum-Wert uebergeben
    // werden.
    switch (color) {
        case LED_COLORS::OFF:    std::cout << "[HAL] set LED OFF" << std::endl; break;
        case LED_COLORS::RED:    std::cout << "[HAL] set LED RED" << std::endl; break;
        case LED_COLORS::GREEN:  std::cout << "[HAL] set LED GREEN" << std::endl; break;
        case LED_COLORS::BLUE:   std::cout << "[HAL] set LED BLUE" << std::endl; break;
        case LED_COLORS::ORANGE: std::cout << "[HAL] set LED ORANGE" << std::endl; break;
    }
}
