Project-CoasterBot/coasterbot/(commit log)

2026-07-22 grundlegende Struktur
    [Coasterbot_Vorgangsliste_PSP_0711.csv]
2026-07-23 Überarbeitung Dokumentenstruktut
    [Coasterbot_Vorgangsliste_v3.csv]
2026-07-24 neue mindmap und projektstrukturplan svgs eingepflegt
2026-07-24 netzplan update, einige anpassungen auf den zeiten in der vorgangsliste notwendig, da sonst kein eindeutiger kritischer pfad verfuegbar.
    [Coasterbot_Vorgangsliste_v3.csv, Coasterbot_Vorgangsliste_v4.csv]
2026-07-24 merged Dennis und Stefans Branch
2026-07-24 beautify flowgraph arrows, layering, arrowhead size. rebuild pdf.
2026-07-25 Version 8, Anpassungen im Anhang und Tabellen
2026-07-25 Definition der Maturity Level
2026-07-30 kostenplan generiert... eigentlich relevant sind nur die material kosten, werkzeug ist als gegeben angenommen, stunden sind zwar kalkuliert, aber ist eigentlich irrelevant.
2026-07-30 Version 10, M0 neues Kapitel zur Systematischen Literatur Recherche und deren Methode + Anhang, Anpassung er out-of-scope Tabelle
2026-07-30 ressourcen und kostenplan
2026-08-05 Pflichtenheft und Testkonzept draft
2026-08-05 layout und Anpassung der Abgrenzungen
2026-08-06 Feedback Dennis zum Lastenheft
    [Lastenheft_Feedback_Dennis.csv]
2026-08-06 Update feedback in Lastenheft_Feedback_Dennis.csv
    [Lastenheft_Feedback_Dennis.csv]
2026-08-06 Fix formatting issues in Lastenheft_Feedback_Dennis.csv
    [Lastenheft_Feedback_Dennis.csv]
2026-08-06 Update feedback in Lastenheft_Feedback_Dennis.csv
    Corrected punctuation and phrasing in feedback comments.
    [Lastenheft_Feedback_Dennis.csv]
2026-08-07 Lastenheft Version 2 nach Absprache
    [Lastenheft_Feedback_Dennis.csv]
2026-08-09 Anpassungen der Kapitelstruktur
2026-08-10 kinematisches modell mit second order parametern
2026-08-10 Schalter und 2 Taster hinzugefügt, sodass Abbruch Anforderungen erfüllbar sind.
2026-08-11 Mindmap der Algorithmen hinzugefügt
2026-08-11 Mindmap der Algorithmen hinzugefügt, mit weißem Hintergrund
2026-08-11 Elektrik komponenten als md und ein skript, um daraus eine mindmap zu erstellen.
2026-08-11 zusammenfassung von algorithmen und elektrik
2026-08-13 Anordnung und Reduktion durch Claude überarbeitet
2026-08-16 Finale Version des Coaster-Mechanismus
    [CoasterMechanism-Coaster.stl, CoasterMechanism-Führung.stl, CoasterMechanism-Gehaeuse.stl, CoasterMechanism-Schieber.stl, CoasterMechanism-Servoholder.stl, CoasterMechanism-Stempel.stl, CoasterMechanism-Verbinder.stl, CoasterMechanism_V5.3mf]
2026-08-16 assembled version added. Not useable for printing!
    [CoasterMechanism_assembled.stl, CoasterMechanism_assembled_with_servos.stl]
2026-08-17 Alternativenbeschreibung in der Erstfassung
2026-08-17 sensorik ergaenzungen.
2026-08-18 rendern der mindmap in pdfs... warum war da vorher inkscape drin?
2026-08-23 Formatierung und Kapitelstruktur
2026-08-24 Mechanisches Konzept Coasterbot
    [Alternative_Sensor_Aufnahme.stl(1).stl, Alternative_Sensor_Aufnahme.stl(2).stl, Alternative_Sensor_Aufnahme.stl(3).stl, Alternative_Sensor_Aufnahme.stl(4).stl, Alternative_Sensor_Aufnahme.stl(5).stl, Alternative_Sensor_Aufnahme.stl.stl, Ausschieber_Aufleger.stl.stl, Außenwand_fuer_Motor.stl(1).stl]
2026-08-24 Ignore large STL file
2026-08-24 v1 des coasterbot schematics
    [coasterbot_prototyp_schematic.kicad_pcb, coasterbot_prototyp_schematic.kicad_sch]
2026-08-24 Basis Bill of material
    [bom.csv]
2026-08-24 das python skript erzeugt ein latex dokument aus der csv und rendert das. danke claude!
2026-08-25 RGB LED und Taster für user mode toggle hinzugefuegt.
    [coasterbot_prototyp_schematic.kicad_sch]
2026-08-25 3V3 rail added, button pulls up from there.
    [coasterbot_prototyp_schematic.kicad_sch]
2026-08-25 Taster entprellung
    [coasterbot_prototyp_schematic.kicad_sch]
2026-08-25 taster und rgb led eingefuegt.
    [bom.csv]
2026-08-25 Korrektur Abstand Kantenerkennung zu Gehaeuse
    [Alternative Sensorhalterung(1).stl, Alternative Sensorhalterung(2).stl, Alternative Sensorhalterung(3).stl, Alternative Sensorhalterung(4).stl, Alternative Sensorhalterung(5).stl, Alternative Sensorhalterung.stl, Alternative_Sensor_Aufnahme.stl(1).stl, Alternative_Sensor_Aufnahme.stl(2).stl]
2026-08-25 Anpassung der Tabellen im Anhang
2026-08-26 fehlende Verbindung Microcontroller zu Motor Regler gefixt.
    [coasterbot_prototyp_schematic.kicad_sch]
2026-08-26 Erweiterung um Wirtschaftlichkeitsbetrachtung
2026-08-27 korrekturen im Modell
    [Alternative Sensorhalterung(1).stl, Alternative Sensorhalterung(2).stl, Alternative Sensorhalterung(3).stl, Alternative Sensorhalterung(4).stl, Alternative Sensorhalterung(5).stl, Alternative Sensorhalterung.stl, Außenwand_fuer_Motor.stl(1).stl, Coaster.stl]
2026-08-27 Mechanikkonzept in M4 verschoben
    [Alternative Sensorhalterung.stl, Ausschieber_Aufleger.stl.stl, Außenwand_fuer_Motor.stl.stl, Cap.stl.stl, Coaster.stl, Coaster_Frame.stl.stl, Coasterbot-Base.stl.stl, Coasterbot_V2_print.3mf]
2026-08-28 Lochrasterplatine schaltung. Inertialsensor und Kamera fehlen noch.
2026-08-28 schematic zur aufbauanleitung verschoben.
    [coasterbot_prototyp_schematic.kicad_pcb, coasterbot_prototyp_schematic.kicad_sch]
2026-08-28 schematic ist umgezogen.
    [coasterbot_prototyp_schematic.kicad_pcb, coasterbot_prototyp_schematic.kicad_sch]
2026-08-28 servos hinzugefügt.
2026-08-28 Schematic aus dem kicad projekt gerendert.
2026-09-07 Webots-Simulation: Navigationsstack + kombinierter Simulationstest
    Fuegt das Webots-Projekt (bisher ausserhalb des Repos) unter
    M4_Test-und-Validierung/webots/ ein.
    Coasterbot-PROTO (aus CAD) + C++-Controller mit 3-Schichten-HAL. Umgesetzt
    sind die in der Alternativenbeschreibung gewaehlten Algorithmen:
    - Pose-Schaetzung aus Radencodern + Gyro (Komplementaerfilter)
    - A* globale Pfadplanung (8-fach, string-pulling)
    - D* Lite inkrementelle Umplanung bei Kartenaenderung
    - DWA lokale Kollisionsvermeidung (dynamisches Fenster)
    - SafetyMonitor: Kantensensor-Sicherheitskomponente (Absturzschutz)
    MODE_SIM_TEST fuehrt den kombinierten Simulationstest auf dem Tisch
    (Blumentopf + Bierflaschen) aus un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
    [chassis.stl, wheel_fl.stl, wheel_fr.stl, wheel_rl.stl, wheel_rr.stl]
2026-09-08 Coasterbot: Raeder seitenweise koppeln, setWheelSpeed entfernen
    Die zwei Motoren je Seite sind jetzt ueber Webots "coupled motors"
    (gemeinsamer Name vor "::") gekoppelt: "wheel_left::front" + "wheel_left::rear"
    bzw. "wheel_right::front" + "wheel_right::rear". Ein Fahrbefehl an eine Seite
    treibt beide Raeder dieser Seite - wie beim realen Coasterbot (zwei TT-Motoren
    je Seite, gemeinsam angesteuert). Einzelne Raeder sind nicht mehr ansteuerbar.
    - Coasterbot.proto: Motoren umbenannt + gekoppelt (multiplier 1).
    - WebotsHAL: je ein Motor-Handle pro Seite statt vier.
    - RobotHAL: setWheelSpeed(WheelId, ...) entfernt - hatte keine Aufrufer mehr
    und war irrefuehrend. Antrieb nur noch ueber setLeft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
2026-09-11 Montage der Hauptplatine inklusive breadbord layout und bildern des resultats.
2026-09-11 kicad lock files ignorieren.
2026-09-12 basic LED controller.
2026-09-12 typos und Anpassungen
2026-09-12 montage der sensoren am gehaeuse und motoren verbindung
2026-09-14 Fix für die Treiber der Räder, u.a.
    [main.cpp, pose_estimator.cpp, pose_estimator.h, robot_hal.h, robot_logic.cpp, robot_logic.h, safety_monitor.cpp, safety_monitor.h]
2026-09-14 Kartenglättung und digitales Kantensignal, Softwaredokumentation aktualisiert
    - OccupancyGrid::reportOccupied(): geglättete Live-Hindernismeldung
    (exponentielle Konfidenz, Commit-Schwelle 0.8) statt sofortigem
    setOccupied() bei Ultraschall-/Kantensensor-Treffern; main.cpp nutzt
    das jetzt in dstar_scenario::markRect und sim_scenario::markRect.
    DwaPlanner-Reflexvermeidung bleibt ungeglättet.
    - Kantensensoren liefern jetzt ein digitales Signal: Coasterbot.proto
    lookupTable ist eine 0/1-Stufe statt der analogen 0..1000-Rampe;
    WebotsHAL::digitalEdge() bildet den Pegel über EDGE_ACTIVE_HIGH auf
    das semantische bool ab (einzige Stelle mit Sensor-Polarität-Wissen).
    - Softwaredokum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
2026-09-15 auswerten des user buttons. man erhaelt das event wenn button wieder losgelassen inklusive der zeit, wie lange er gedrueckt wurde.
2026-09-15 fix rainbow modus. umbenannt.
    [ledinterface.h]
2026-09-15 zweite LED rausgeschmissen, Servos hier eingefuegt.
2026-09-15 pin mapping for the actual board.
2026-09-15 setup von led, button und treiber motoren. noch keine sensorik und noch keine daraus resultierende logik implementiert.
2026-09-15 obstacle sensor mit moving average filterung
2026-09-15 servo interface als einzelne motortreiber, aber noch nicht als ansteuerung für den eigentlichen coaster mechanismus
2026-09-17 Softwaredokumentation: Gyro-Ansteuerung und Skid-Steer-Fahrverhalten ergänzt
    Abschnitt 4.3 (Offene Punkte aus der Hardware-Rückmeldung) um konkrete
    Antworten zur Rückmeldung vom 16.09.2026 erweitert:
    - Gyro-Schnittstelle: Integration der Winkelgeschwindigkeit (kein
    Mindestdrehwinkel nötig, kontinuierliches Signal), Bias-Kalibrierung
    bei MEMS-Gyros, verfügbare Arduino-Bibliotheken (Adafruit_MPU6050,
    I2Cdevlib, Bosch BNO055 als Alternative mit On-Chip-Sensorfusion).
    - Erreichbarkeit einer definierten Winkelgeschwindigkeit: tatsächliches
    Fahrverhalten (Skid-Steer, gekoppelte TT-Getriebemotoren je Seite,
    PWM über H-Brücke), Open-loop- vs. Closed-loop-Regelung, Bezug zum
    Kompl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
2026-09-18 Chassis Montage finalisiert.
2026-09-20 added 6050 from BOM to simulation
2026-09-21 Open-Loop und Closed-Loop Motorregelung implementiert und verglichen
    - WebotsHAL: setLeftSpeed()/setRightSpeed() setzen nur noch das Kommando;
    neue updateMotorControl() (einmal pro step()) uebernimmt die eigentliche
    Aktuierung. Simuliert eine feste, der Regelung unbekannte Fertigungs-
    streuung zwischen den Seiten (MOTOR_GAIN_LEFT_TRUE/RIGHT_TRUE = 0.95/1.05,
    angenommener Wert). Zwei Modi (WebotsHAL::MotorControlMode, nur Simulation,
    nicht Teil von RobotHAL):
    - OPEN_LOOP: Kommando unveraendert durchgereicht, Gain-Fehler bleibt.
    - CLOSED_LOOP (neuer Standard): Integralregler (MOTOR_KI=25) fuehrt
    appliedLeft_/appliedRight_ anhand der gemessenen Radgeschwindigkeit
    (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
2026-09-21 stefans board.
2026-09-23 Tabellen und Zeichnungen angepasst
2026-09-24 Fehlerinjektion implementiert: ST-SIM-005 (Sensorausfall) und ST-SIM-006 (Aktorfehler)
    FaultMonitor (RobotHAL-only, Arduino-portabel) erkennt einen unplausiblen
    Ultraschallwert bzw. eine anhaltende Kommandiert/Gemessen-Abweichung der
    Radgeschwindigkeit und uebernimmt verriegelt die Aktorik. WebotsHAL bekommt
    dafuer zwei simulation-only Fehlerinjektionsschalter (analog
    MotorControlMode). Neuer MODE_FAULT_INJECTION testet beide Faelle auf
    coasterbot-testfield.wbt; beide BESTANDEN, verifiziert in zwei kopflosen
    Laeufen (identische Erkennungszeiten).
    Softwaredokumentation entsprechend aktualisiert (neue FaultMonitor-Sektion,
    Betriebsarten-/Welten-/Traceability-/Statustabellen, Grenzen-Abschnitt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
2026-09-27 Kürzung des Texts und Statemachine Bild mit Text einfefügt unter 12.2
2026-09-28 gyro sensor basics. es bedarf der info, was die motoren tatsächlich gerade tun um korrekt zu normieren. insbesondere turning ist sonst schwierig zu integrieren.
2026-09-28 Leere Seite nach dem Deckblatt entfernt. Kommentare der Versionshistorie gekürzt
2026-09-29 query interface for current requested motion
2026-09-29 Neue Pose estimator strategie: Motormodel. Bot macht zwischenstop in Zentrum nach ausgabe und aufnahme von coaster.
2026-09-29 query movement prevention from outside.
    [hw_impl_hal.cpp, hw_impl_hal.h]
2026-09-30 pen line site to 5mm
2026-09-30 Zwischenstand. Navigation wieder mit encode. Genauigkeit besser, aber systematischer drift.
    [coasterbot_functions.cpp, coasterbot_functions.h, dstar_lite.cpp, dstar_lite.h, pose_estimator.cpp, pose_estimator.h, webots_hal.h]
2026-09-30 finaler stand. StateMachine und Prozedur spendCoaster collectCoaster. Genauigkeit ca. 1,5cm
2026-10-04 motion detection sensors with opto encoder and lm393.
2026-10-04 Halter fuer die Optokoppler als Ergaenzung zur urspruenglichen TT Motor Fixierung.
    [Motorhalterung_mit_sensorfixierung.scad, Motorhalterung_mit_sensorfixierung.stl]
2026-10-06 brauchen wir derzeit nicht
2026-10-06 beim reset wird nun auch pose zurückgesetzt. wenn keine motion soll bot stehen bleiben.
    [main.cpp]
2026-10-06 servos koennen langsamer fahren
2026-10-06 servos geschwindigkeit sollte kontrollierbar sein.
2026-10-06 adaption der servo geschwindigkeit.
2026-10-08 messwerte fuer odometrie
2026-10-08 motor pwm steuerung. für drehung ist mehr drehmoment auf den rädern notwendig -.-
2026-10-08 odometrie fuer dienstanz, heading aus gyro
2026-10-08 Endbericht mit elektronik und kostenplan eingepflegt.
2026-10-08 zsmarbeit eingepflegt. vielleicht ergänze ich noch was, wenn ich mit der hal integration so weit bin...
2026-10-08 ergebnis dokumentiert mit eigenen fehlern. vielleicht bin ich zu scharf, bin aber gerade genervt von dem motor geraffel :D
2026-10-08 Abstandshalter und Kaptielzuordnung
    [Abstandshalter_Motor_Rad.stl]
2026-10-09 musste die defines umbenennen, da sonst konflikt mit Arduino.h auftritt.
2026-10-10 Projektziel und Erstaufsatz Mechanikteil im Endbericht
2026-10-10 Nutzen und Ergebnis Abschnitt hinzugefügt
2026-10-11 Projekt coastermechanism zu pico portiert.
2026-10-11 Statemachine für Coasterausgabe und -aufnahme eingeführt.
2026-10-11 Initiale Winkel für Servos eingefügt. Werte gelten für Dennis Aufbau. Da ist Servo1 = Heber und Servo2 = Ausschub
2026-10-14 pose estimator wieder auf altem interface. fix des hal interfaces
2026-10-15 tests der hardware und hardwareintegration ergänzt.
2026-10-15 Beschreibung Projektziel und der Mechanik.
2026-10-17 Sicherheit und Systemüberwachung hinzugefügt
2026-10-17 Eigenlokaliserung hinzugefügt, mehr oder weniger aus Navigation herausgetrennt und weitere IDs für AFOs in der Liste hinzugefügt
2026-10-20 Layout und Ergänzungen
2026-10-20 Skript und resultierende kleinere Aufbauanleitung, da die Bilder die Anleitung unbearbeitet auf 77MB bringen
2026-10-23 Tischvermessung unabhaengig von der Startausrichtung, Kanten ohne Not-Stopp
    - Vermessung: zuerst an der ersten Kante ausrichten (Ausloesekurse vorne
    links/rechts, Mitte = Kantennormale). Breite aus den Ausloeselagen der Pose,
    Nullpunkt in deren Mitte, Kurs wird nicht mehr auf 0/90 Grad ueberschrieben
    und am Ende kein Ruecksetzen auf (0, 0).
    - HAL: Drehen bei aktivem Kantensensor erlaubt, wenn die Drehung alle aktiven
    Sensoren zurueck auf den Tisch bewegt.
    - Navigation: vor groesseren Drehungen nahe der Kante erst gerade wegfahren
    (TURN_CLEARANCE, volle Fahrgeschwindigkeit). Kantenmeldung korrigiert die Pose
    an der bekannten Kante, danach Neuplanung statt Not-Stopp.
    - Coaster 0.15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
2026-10-24 coaster kalibrierung und auswurf test. servo ansteuerung kann jetzt verschiedene modi, langsames führen für den heber und schlagen für auswurf. funktioniert alles so... lala.
2026-10-24 coaster aufnehmen und auswerfen in main
2026-10-24 coasterbot init zum setzen der anzahl an coastern im bot.
2026-10-25 fix freiruckeln wenn coaster im weg, also kein hindernis, aber dennoch motor stall.
2026-10-25 Debugging Print statements
2026-10-25 Debugging Prints
2026-10-25 Neue Spenderposition und Lifterpositionen (nur zum testen, für main.cpp müssen diese im boardconfig.h ermittelt werden)
2026-10-25 Debbung Print. Servoposition aside beim Coaster einsammeln
2026-10-30 schematic verschoben, zusammenarbeit eingefügt. hatte ich doch schon geschrieben, aber den input vergesen -.-
2026-10-30 Perspektive und Retrospektive gescrhieben, Webots Bild in 1.3 eingefügt, Referenzen auf Lasten/Pflichtenheft in Bulletpoints gepackt, Abkürzungen in 1.3 auf das Abkürzungsverzeichnis gesetzt, Satz üb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
2026-10-30 Soll-Ist Zeitplan angepasst und typos gejagt
2026-10-31 Kapitel 1.3 komplett überarbeitet und Lesefluss erhöht.
2026-11-03 Roter faden und Vorlagen
2026-11-04 setze bild so, dass es innerhalb der section dynamisch verteilt wird. float barrier, sodass es nicht später gerendert wird sondern zwingend in der subsection bleibt.
2026-11-04 fixe zeilenzahl aus vorherigem ansatz wieder entfernt, sonst wird in den nächsten absatz eingestreut.
2026-11-04 finale änderung und gebaut.
2026-11-04 ist stände für kostenplan und zeitplan eingefügt.
2026-11-04 Odometrie nachrüstung hinzugefügt.
2026-11-08 bild gecroppt und kommentare ergänzt.
2026-11-08 Stände zusammengeführt und vereinheitlicht
2026-11-08 3 videos die ich zeigen wuerde, sofern zeit ist. sind auch entsprechend beschleunigt.
